houdonghui1/Trust_Shield/First_rot_sw/cm3_soc_sw/project/fpga_syn/fpga_ku6_mcu_full_vivado/mcu_top.runs/impl_1/.init_design.begin.rst

<?xml version="1.0"?>
<ProcessHandle Version="1" Minor="0">
    <Process Command=".planAhead." Owner="houdonghui" Host="" Pid="3104318">
    </Process>
</ProcessHandle>
