houdonghui1/Trust_Shield/Third_rot_sw/三级远程证明源代码解析.md

# 三级远程证明源代码解析

## 一、三级可信根

### `attestation_smoketest.c`

#### 主流程

- **1157**：熵源初始化
- **1159～1196**：生成 EK 公私钥
- **1198～1210**：生成 EK 证书

- **1212～1268**：对 EK TBS 证书进行 ECDSA-p256 签名
  - **1242～1253**：签名分为 r、s
  - **1255～1268**：生成完整 EK 证书

- **1271**：打印 EK 证书，等同于通过 UART0 将其发送至可信第三方
- **1273～1297**：生成 AK 公私钥
- **1299**：打印 AK 公钥，等同于通过 UART0 将其发送至可信第三方
- **1301～1307**：生成 MLDSA 公私钥
- **1309**：打印 MLDSA 公钥，等同于通过 UART0 将其发送至可信第三方
- **1311～1314**：接收可信第三方生成的 AK 证书
- **1326～1328**：等待进行远程证明测试

#### 辅助函数

**二进制转十六进制打印**
- **215～219**：初始化十六进制字符映射表，计算转换后字符串长度，分配并清空内存缓冲区
- **221～226**：遍历二进制数据，逐字节转换为十六进制字符串，并添加结束符
- **229～236**：将长字符串按固定长度分段，逐段打印

**UART0 初始化与 AK 证书接收**
- **460～464**：初始化 UART0
- **468～483**：接收 AK 证书，RX FIFO 大小为 32 bits

**AK 证书解密**
- **492**：等待来自终端的输入，随便输入一个字符
- **503～519**：打印 AK 证书密文
- **521**：使用 AES 解密
- **524～540**：打印 AK 证书明文

**UART1 初始化与远程证明**
- **1026**：初始化 UART1
- **1033～1048**：接收来自验证者的 Nonce
- **1057～1060**：使用 MLDSA 对 PCR + Nonce 进行签名
- **1062**：组 Quote 包
- **1067**：通过 UART1 发送 Quote 包

**MLDSA 签名**
- **766～769**：按 PCR + Nonce 的顺序进行 SHA256 计算
- **778～784**：使用 MLDSA 对 PCR + Nonce 的 SHA256 计算结果数据进行签名
- **795～801**：进行自验证

**Quote 包组包**
- **887～889**：添加 Quote 包头
- **892～900**：AK 证书长度转 HEX 字符串
- **903～910**：AK 证书转 HEX 字符串
- **913～917**：PCR 转 HEX 字符串
- **920～924**：Nonce 转 HEX 字符串
- **927～933**：MLDSA 签名转 HEX 字符串
- **936～937**：添加 Quote 包尾

---

## 二、可信第三方

### `start.sh`

- **3**：获取并解析来自三级可信根的 EK 证书、AK 公钥、MLDSA 公钥
- **5**：创建 CA 证书
- **7**：由 CA 证书签发 AK 证书，扩展字段部署 MLDSA 公钥
- **11**：发送 AK 证书到三级可信根

### `serial_capture_ak_ek.py`

- **87～102**：检查串口并初始化
- **105～111**：持续读取串口输出的日志
- **114～121**：获取 EK 证书
- **124～131**：获取 AK 公钥
- **134～155**：获取 MLDSA 公钥
- **169**：生成 PEM 文件

### `create_ca_root.sh`

- **70**：检查是否已存在 CA
- **71**：初始化目录
- **72**：生成 CA 密钥
- **73**：生成签名请求
- **74**：自签发 CA 证书
- **75**：校验 CA 证书

### `sign_ak_cert_by_ca.sh`

- **181**：检查所有必需文件是否存在、格式是否合法
- **182**：校验 CA 密钥/证书、AK 公钥的有效性
- **183**：清理临时文件，初始化证书序列号
- **184**：生成 MLDSA 公钥扩展配置文件
- **185**：生成证书签名请求文件
- **186**：校验 EK 公钥是否在白名单内
- **187**：用 CA 证书签发 AK 证书
- **188**：验证签发的 AK 证书有效性、MLDSA 公钥一致性
- **189**：清理所有临时文件

### `serial_send_ak_cert.py`

- **180**：检查 AK 证书文件是否存在
- **181**：PEM 证书转 HEX 格式并保存
- **182**：读取 HEX 文件，使用 AES 加密后通过串口发送到三级可信根

---

## 三、验证者

### `verifier.py`

#### 主流程

- **422**：检查 CA 证书是否存在
- **425**：生成 32 字节随机数 Nonce
- **427**：串口发送 Nonce，接收三级可信根返回的 Quote 包
- **429**：解析 Quote 数据，执行验证

#### 串口通信

- **283～301**：初始化串口通信
- **303～310**：清空串口残留数据
- **312～320**：向三级可信根发送 Nonce，等待三级可信根返回 Quote 包

#### 数据接收与提取

- **328～351**：循环读取串口数据，直到检测到 `#END#` 结束标记，完整接收三级可信根返回的所有数据
- **356～358**：将二进制数据转为字符串，清除无关字符，保留纯有效数据
- **360～366**：提取 Quote 包的十六进制数据，并返回给上层函数

#### Quote 包解析与验证

- **372～378**：解析 AK 证书的长度
- **380～385**：计算完整数据所需总长度，校验数据是否完整
- **387～398**：按偏移量依次解析出 AK 证书、PCR、Nonce、MLDSA 签名
- **407**：验证 AK 证书，是否由合法 CA 证书签发
- **408**：从 AK 证书扩展字段中，提取 MLDSA 公钥
- **410～411**：验证 PCR，三级可信根状态是否被篡改
- **413**：验证 Nonce，三级可信根返回的 Nonce 与验证者发送的是否一致
- **415**：用 ML-DSA 公钥验签，证明 Quote 包数据未被篡改
