houdonghui1/Trust_Shield/First_rot_sw/cm3_soc_sw/project/fpga_syn/fpga_ku6_mcu_full_vivado/mcu_top.runs/impl_1/.vivado.begin.rst

<?xml version="1.0"?>
<ProcessHandle Version="1" Minor="0">
    <Process Command="vivado" Owner="houdonghui" Host="secure-Precision-3660" Pid="3104272" HostCore="32" HostMemory="65520816">
    </Process>
</ProcessHandle>
