houdonghui1/Trust_Shield/Third_rot/optt_doc/opentitan软件编写测试.pdf

# opentitan device软件编写测试

### 掌握运行自写测试的流程

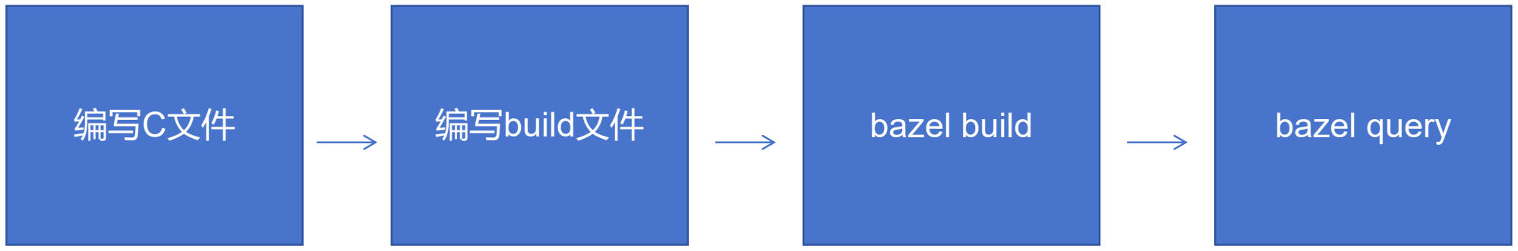
[picture p7: figure]
编写C文件; 编写build文件; bazel build; bazel query
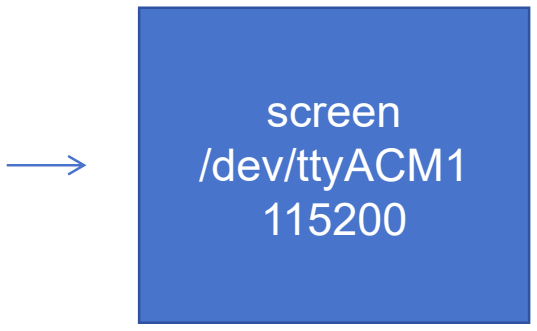
[picture p8: figure]
screen /dev/ttyACM1 115200
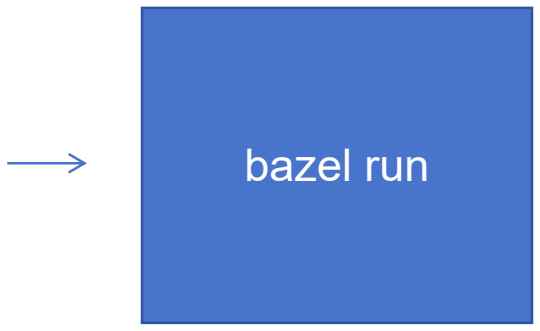
[picture p9: figure]
bazel run

测试.c的基本内容

#include "sw/device/my_tests/sm4/sm4_reg.h" #include "sw/device/lib/runtime/log.h" #include "sw/device/lib/testing/test_framework/ottf_main.h" #include "hw/top_earlgrey/sw/autogen/top_earlgrey.h" OTTF_DEFINE_TEST_CONFIG();

bool test_main(void) {
LOG_INFO(kSendData);

return true;
}

包含的.h
依赖的其他库

默认结构

BUILD文件的编写

load("//rules:opentitan.bzl", "OPENTITAN_CPU") load( "//rules:opentitan_test.bzl", "OPENTITANTOOL_OPENOCD_DATA_DEPS", "OPENTITANTOOL_OPENOCD_TEST_CMDS", "ROM_BOOT_FAILURE_MSG", "cw310_params",// "dv_params", "opentitan_functest", "verilator_params", )

load("//rules/opentitan:defs.bzl", "EARLGREY_TEST_ENVS", "opentitan_test") load("//rules:splice.bzl", "bitstream_splice")
load("//rules:otp.bzl", "STD_OTP_OVERLAYS", "otp_image", "otp_json", "otp_partition") package(default_visibility = ["//visibility:public"])
exports_files(glob([ "*.c", "*.h",

]))

在测试.c的同层写一个名为BUILD的文
件

这是通用部分

opentitan_functest(
name = "puf_smoketest", srcs = ["puf_smoketest.c"], targets =["cw310_test_rom", "verilator"], deps = [":puf_lib",

], )
cc_library(
name = "puf_lib", srcs = ["puf.c"], hdrs = ["puf.h"],

target_compatible_with = [OPENTITAN_CPU], deps = [ "//hw/top_earlgrey/sw/autogen:top_earlgrey", "//sw/device/lib/runtime:log", "//sw/device/lib/testing/test_framework:ottf_main", "//sw/device/my_tests/base:base_lib", "//sw/device/my_tests/rs_encode:rs_encode_lib", "//sw/device/my_tests/rs_decode:rs_decode_lib",

], 测试名为pu | )
f_smoketest,同名.c文件
依赖一个自己的库，下面定义自己的库，自己的库函数写
在puf.c中，.h中定义常量、宏、声明函数。需要用其他的 库函数，要先包含.h进来。xxx_smoketest.c和xxx.c中 include xxx.h bazel query 'attr(tags, cw310, tests(//sw/device/tests/...))'

查看有哪些测试可以用，目的是为了找到bin文件

bazel build //sw/device/examples/hello_world:my_hello_world

### 构建测试，编译

用verilator测试并看波形
bazel test //sw/device/my_tests/sm4:sm4_smoketest_sim_verilator \ --test_output=streamed \ --test_timeout=2000 \ --test_arg=--verilator-args=--trace=/tmp/sim.fst

gtkwave /tmp/sim.fst

在选好信号之后在file 中write save file as ，可以将波形另存为一个gtkw文件。重新仿真生成.fst后， 打开fst文件，在file中打开保存的gtkw文件，就会自动将选好的信号拉出来。

只仿真不记录波形速度会快很多

终端上打印log

若无法build，提示gcc的问题，则升级
gcc到11

将终端log打印到文本：script log.txt 将会在当前路径下生成一个txt文件记录产生的log。exit终止 可在bazel query 'filter(".*_fpga_cw310", kind(".", //sw/device/tests/...))' 的log中查找哪些可用测试文件

bazel query 'filter(".*_fpga_cw310", kind(".", //sw/device/my_tests/...))'

查看有哪些测试文件

screen /dev/ttyACM1 230400,cs8,-ixon,-ixoff 开串口
注意：波特率取决于soc根时钟

bazel run //sw/host/opentitantool bootstrap $(ci/scripts/target-location.sh //sw/device/examples/hello_world:my_hello_world_fpga_cw310_bin)

ctrl+A+D 分离screen
screen -ls 查看有哪些后台screen
screen -r 后台ID 恢复后台的screen
screen -XS ID quit 关闭后台运行的screen（多个可选） screen -X quit 关闭单个

上板测试

加载测试软件到SOC的flash

# 一些编程的tips

1、opentitan里边用abs_mmio_write32写入数据 src/sw/device/lib/base/abs_mmio.h

关于编译后总线未能按次序去读写寄存器（如何防止自动优化掉一些步骤）

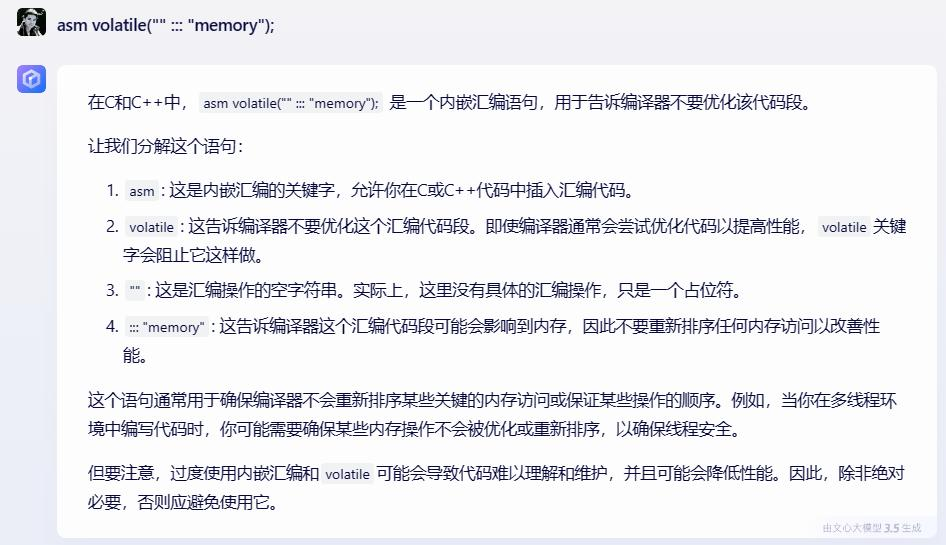
[picture p10: figure]

https://blog.csdn.net/qq_36412526/article/details/84640924

https://blog.csdn.net/sxudong2010/article/details/118616418

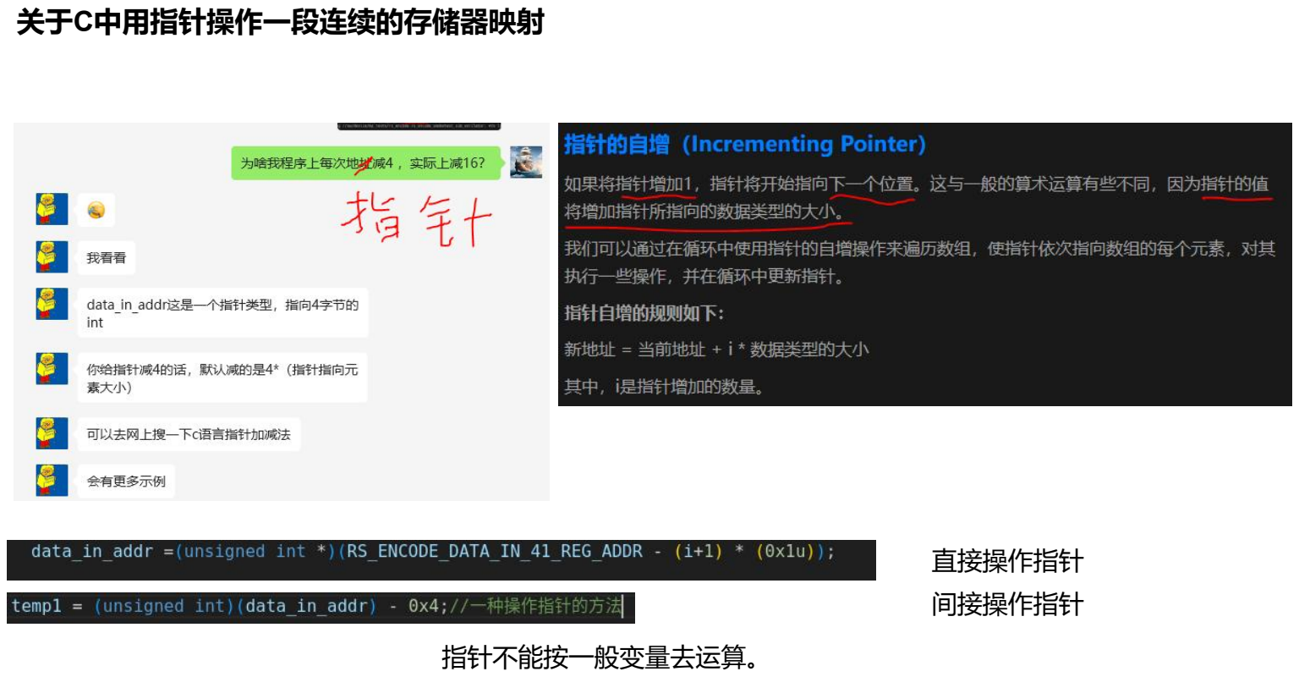
[picture p11: page 9]

指针不能按一般变量去运算。

关于C中用指针操作一段连续的存储器映射

直接操作指针
间接操作指针

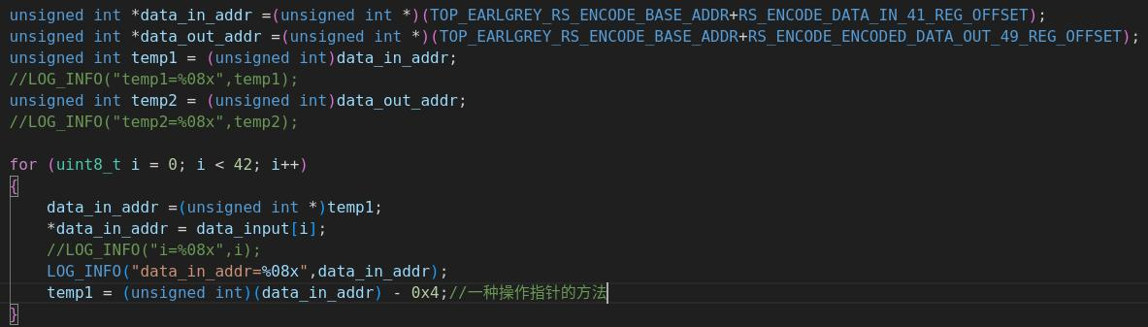
[picture p12: figure]

一种操作指针写入存储器（广义）的方法

# opentitan 安全启动

目标：
1、在opentitan device (sim or FPGA)上运行安全启动流程：ROM——ROM_EXT——BL0 2、总结opentitan脱机运行模式(上电直接安全启动、直到用户代码)的开发流程

安全启动相关资料

https://opentitan.org/book/sw/device/silicon_creator/index.html | rom和rom_ext软件介绍

https://opentitan.org/book/doc/security/specs/secure_boot/index.html 安全启动具体内容

sw/device/silicon_creator/rom_ext/data/rom_ext_e2e_testplan.hjson | ROM_EXT testplan
sw/device/silicon_creator/rom/data/rom_e2e_testplan.hjson | ROM testplan
https://lowrisc.zulipchat.com/#narrow/stream/213499-OpenTitan/topic/secure.20boot | 问题讨论
https://opentitan.org/book/rules/opentitan/index.html#execution-environments | 测试的执行环境

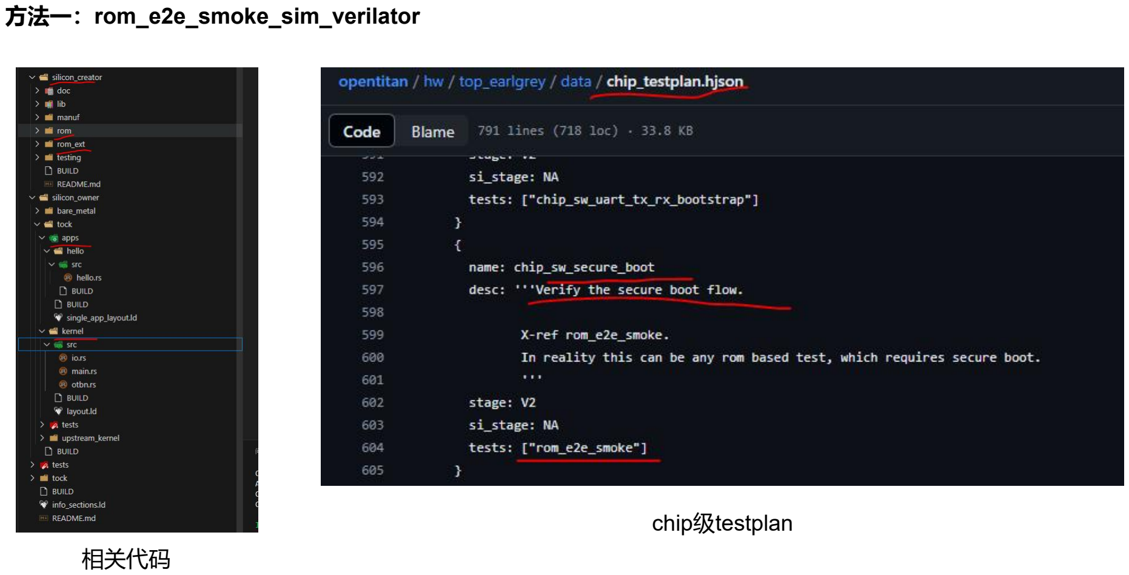
[picture p13: page 13]

相关代码

方法一：rom_e2e_smoke_sim_verilator

chip级testplan

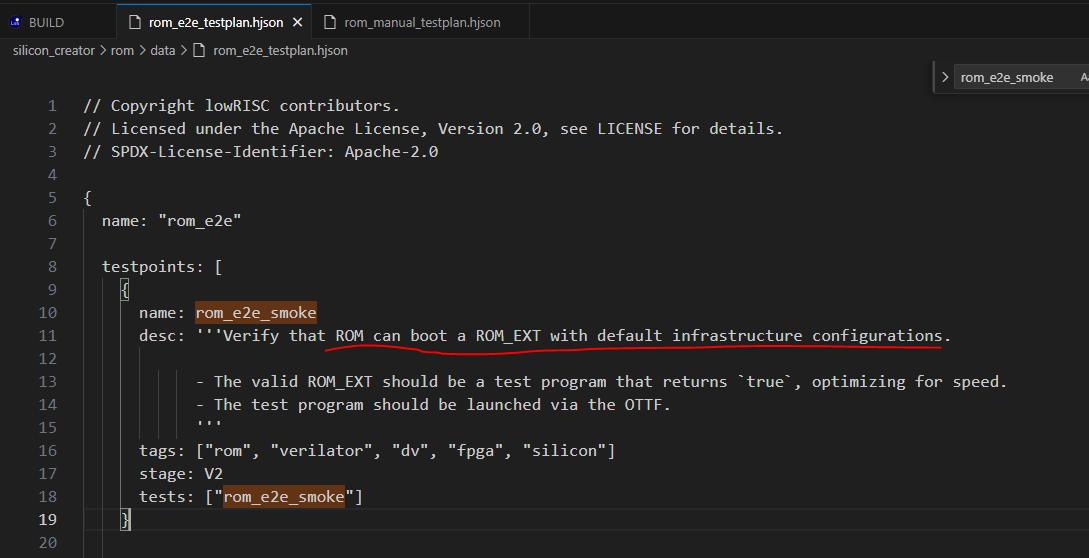
[picture p14: figure]

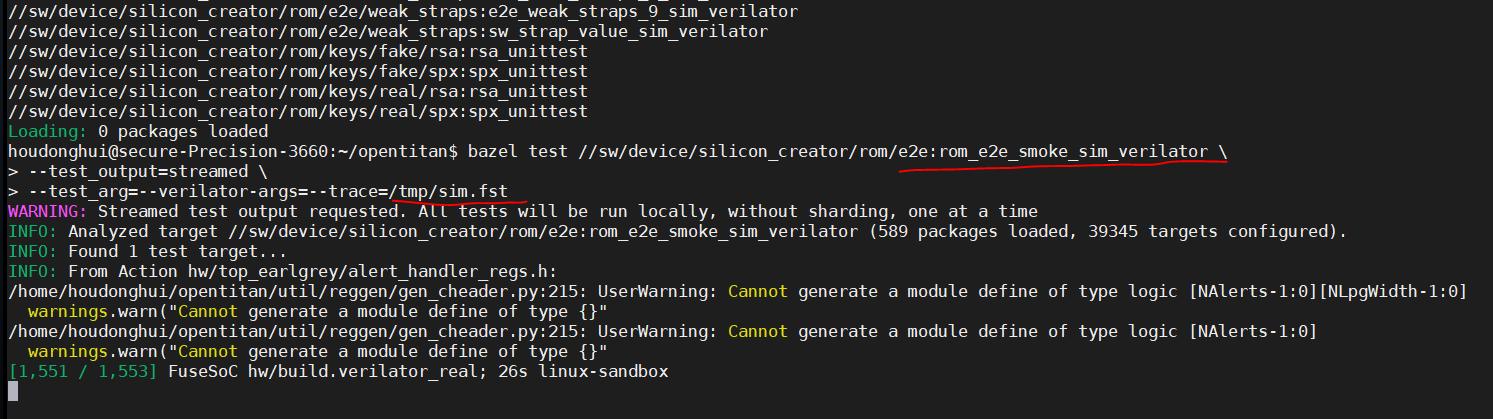
[picture p15: figure]

在verilator上执行ROM测试，时间很久.......

方法二：在ROM_EXT阶段执行某个测试【带安全启动】

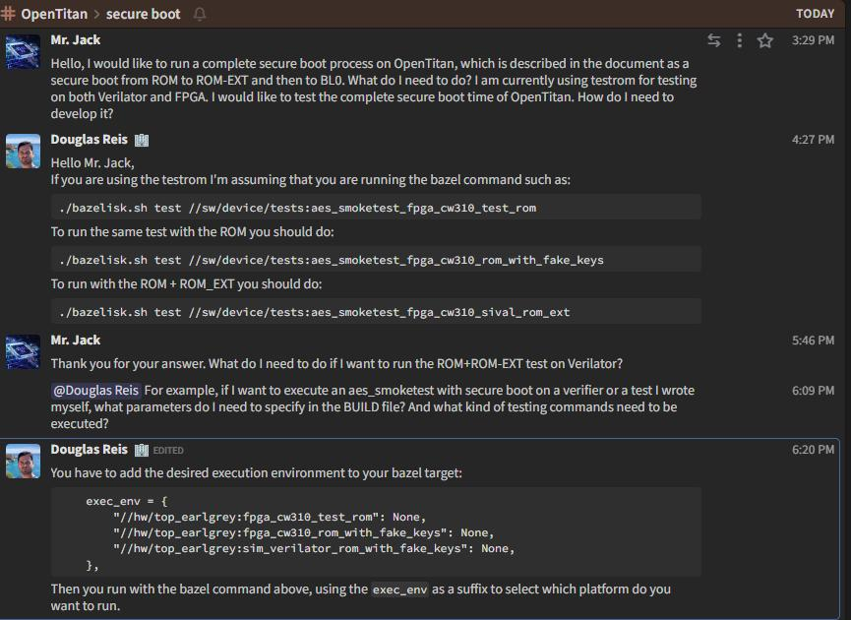
[picture p16: figure]

关于软件执行环境的概念

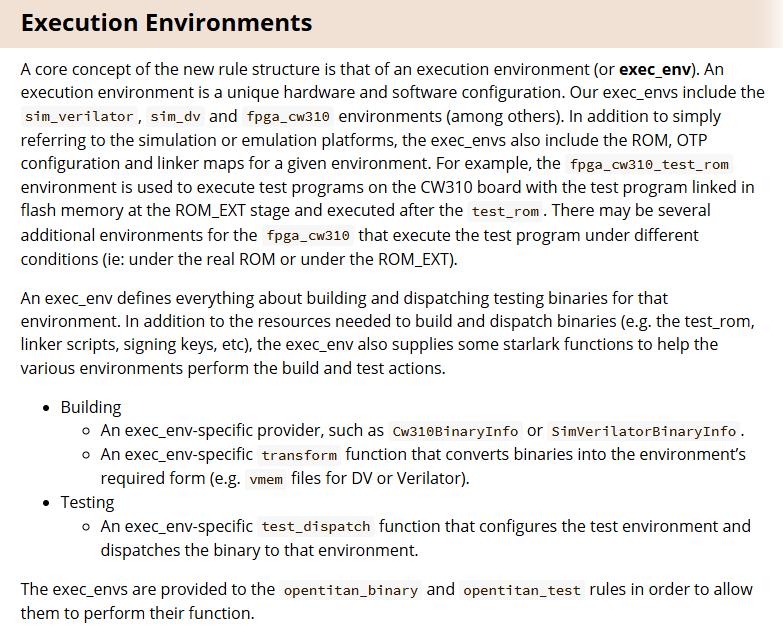
[picture p17: figure]

https://opentitan.org/book/rules/opentitan/index.htm l#execution-environments

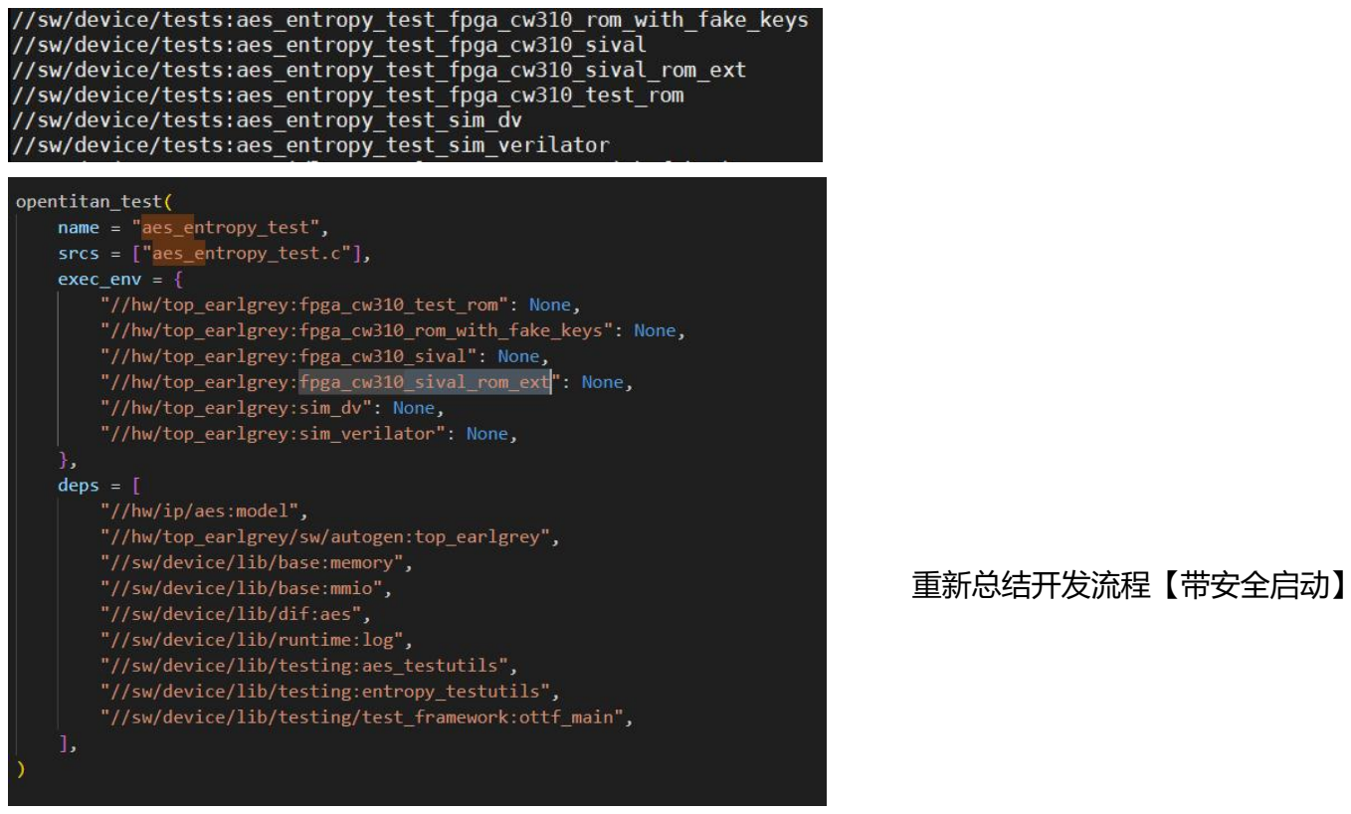
[picture p18: page 18]

重新总结开发流程【带安全启动】
