houdonghui1/Trust_Shield/First_rot/design_doc/环境配置.md

# **环境配置** #
_*Last Update: 2025/09/13*_

## **安装工具** ##

OS:
 - Build instructions assume a Linux environment

Lint:
 - Synopsys Spyglass
   - `Version S-2021.09-1`

Simulation:
 - Synopsys VCS with Verdi
   - `Version R-2020.12-SP2-7_Full64`
 - Verilator
   - `Version 5.012`
 - Mentor Graphics QVIP
   - `Version 2021.2.1` of AHB models
 - Avery AXI VIP
   - `Version 2025.1` of axixactor
 - UVM installation
   - `Version 1.1d`
 - Mentor Graphics UVM-Frameworks
   - `2022.3`

GCC:
 - RISCV Toolchain for generating memory initialization files
   - `Version 2023.04.29`
   - `riscv64-unknown-elf-gcc (g) 12.2.0`
 - G++ Used to compile Verilator objects and test firmware
   - `g++ (GCC) 11.2.0`
 - ARM Toolchain for soc memory initialization files and firmwave
   - `gcc-arm-none-eabi v10.3-2021.10`

Vivado：
 - use vivado 2021.1 to start FPGA flow 

Debug:
 - SW J_Link commander v7.92f 
 - HW J_Link debuger v12 support RISC_V and ARM
 
### **RISCV Toolchain installation** ###
There is significant configurability when installing the RISCV toolchain.
These instructions may be used to create a RISCV installation that will be compatible
with the provided Makefile for compiling test C programs.

1. Install from this repository:
    - https://github.com/riscv-collab/riscv-gnu-toolchain
    - Follow the included README in that repository for installation instructions
2. The most recently tested toolchain build that was confirmed to work was 2023-04-29
    - https://github.com/riscv-collab/riscv-gnu-toolchain/releases/tag/2023.04.29
3. A compatible tool installation requires newlib cross-compiler, multilib support, and the zicsr/zifencei extensions. Use this configure command:
    - `./configure --enable-multilib --prefix=/path/to/tools/riscv-gnu/2023.04.29 --with-multilib-generator="rv32imc-ilp32--a*zicsr*zifencei"`
4. Use `make` instead of `make linux` to install the tool (using newlib option)

### **Vivado installation** ###
Visit the AMD official website (formerly Xilinx) and download the Linux version of Vivado WebInstaller
- https://www.amd.com/en/products/software/adaptive-socs-and-fpgas/vivado.html

## **环境变量** ##
在工具配置完成后需要验证工具安装是否成功,然后进入工程目录，要运行脚本配置环境变量。

`source setenv.sh`

- `PRJ_DIR` 工程目录的绝对路径，需要替换为实际路径。
 
## **Repository Overview** ##
```
Trust_arm_soc_rot/
├── design_doc              设计文档
│   └── image               文档图片
├── doc                     设计相关记录
│   ├── arch                
│   ├── fpga
│   ├── reglist
│   ├── standard
│   └── testcase
├── library                 相关RTL库
│   ├── altera_ip           altera ip库
│   ├── altera_sim          altera 仿真库
│   ├── cm3                 cortex-m3 RTL
│   ├── cmsdk               arm-cmsdk代码
│   ├── cmsis               arm基础软件
│   ├── drivers             soc外设驱动BSP
│   ├── flm                 
│   ├── gen_apb             apb设计资料
│   ├── models              验证库
│   ├── rtl_logic           简单RTL模块
│   ├── xilinx_ip           xilinx FPGA ip
│   └── xilinx_sim          xilinx 仿真库
├── project
│   ├── firmware_sdk        软件编译结果
│   └── fpga_syn            FPGA构建文件夹
├── script                  自动化脚本库
│   └── verdiLog            
├── sim
│   ├── spyglass_prj        spyglass工程
│   └── verilog_sim         RTL仿真验证工程
└── user
    ├── firmware            user软件源码
    ├── fpga_verilog        FPGA移植RTL
    └── verilog             主RTL库，包含安全协处理器RTL
```

### **Verilog File Lists** ###
Verilog file lists are generated via VCS and included in the config directory for each unit. New files added to the design must be included in the vf list. They can be included manually or by using VCS to regenerate the vf file. File lists define the compilation sources (including all dependencies) required to build and simulate a given module or testbench, and should be used by integrators for simulation, lint, and synthesis.
