houdonghui1/Trust_Shield/First_rot/design_doc/自动化脚本说明.md

# 自动化脚本说明

**脚本位置：**
[脚本文件夹](../script/)中保存了许多makefile脚本，组织起VCS仿真、FPGA构建等过程，加速了开发验证等流程。详情请查看[TOP_MAKEFILE](../script/makefile)
