houdonghui1/Trust_Shield/system/NVIDIA最新集群.md

NVIDIA Vera Rubin平台的硬件架构，其核心是**“极限协同设计”（Extreme Co-design）**理念。它将整个数据中心视为一个完整的计算单元，通过七颗各司其职的专用芯片紧密协作，实现了从单颗芯片到机架，再到超级集群（POD）的无缝扩展。

其硬件架构可以从以下四个层面来理解：

### 🧠 核心计算层：三颗芯片，各司其职

这一层是算力的源泉，由三颗专为AI工作流不同阶段优化的芯片构成。

*   **Rubin GPU（图形处理器）**：这是平台的**算力核心**，专为大规模并行计算设计。基于**台积电3nm**工艺，采用**双芯（Dual-die）设计**，集成了惊人的**3360亿**个晶体管。
    *   **性能**：在NVFP4精度下，单颗GPU可提供**50 PetaFLOPS**的推理算力和**35 PetaFLOPS**的训练算力，分别是上一代Blackwell的**5倍**和**3.5倍**。
    *   **内存**：配备**288GB**的**HBM4**高带宽内存，带宽高达**22 TB/s**。
    *   **关键特性**：搭载了第三代Transformer引擎，支持硬件加速的自适应压缩，能在保持精度的同时最大化NVFP4性能。

*   **Vera CPU（中央处理器）**：这是平台的**“指挥官”**，负责数据移动、系统控制和代理式AI的复杂任务调度。它拥有**88个**自研的**Olympus**核心，兼容**Armv9.2**架构。
    *   **性能**：内存带宽高达**1.2 TB/s**（LPDDR5X）。
    *   **关键特性**：通过**NVLink-C2C**（芯片到芯片）接口与Rubin GPU实现高速、一致的**统一内存访问**。

*   **Groq 3 LPX（低延迟推理加速器）**：这是一个专用的**“推理加速器”**。单个机架配备**256个LPU**和**128GB**的**SRAM**，能提供**40 PB/s**的内存带宽。它专门负责推理任务中**低延迟的解码阶段**，与擅长高吞吐量训练的GPU形成完美互补。

### 🔗 互连与网络层：四颗芯片，编织高速网络

计算单元需要高速网络连接，这由剩余四颗芯片完成：

*   **NVLink 6 交换机**：这是机架内的**“数据高速公路”**。第六代NVLink为每颗GPU提供**3.6 TB/s**的双向带宽，能将NVL72机架内的**72颗Rubin GPU**整合成一个统一的性能域，总带宽高达**260 TB/s**。
*   **ConnectX-9 SuperNIC**：这是节点间**“横向扩展”**的桥梁，提供**800 Gb/s**的超高速RDMA网络连接。
*   **Spectrum-6 以太网交换机**：这是构建大规模POD的**“骨干网络”**，基于**硅光（CPO）** 技术，交换容量高达**102.4 Tb/s**。
*   **BlueField-4 DPU（数据处理器）**：这是**“基础设施卸载引擎”**。它内置**64核**Grace CPU，能卸载并加速存储、网络和安全等基础设施任务，是AI原生存储架构的关键。

### 🏭 系统级集成：从芯片到超级计算机

*   **超级芯片（Superchip）**：最基本的单元，由一颗**Vera CPU**通过**NVLink-C2C**与两颗**Rubin GPU**紧密集成，形成计算核心。
*   **NVL72机架**：平台的**核心交付单元**。一个机架集成了**72颗Rubin GPU**、**36颗Vera CPU**、以及相应的NVLink交换机等，总计约**220万亿**个晶体管。采用**100%液冷**和**无缆化（Cableless）模块化托盘设计**，组装和维护速度是上一代的**18倍**。
*   **DGX SuperPOD**：由**40个**NVL72机架构成，总算力高达**60 ExaFLOPS**。整个POD在软件层面被视为一个统一的、可编程的超级计算机。

### 🛡️ 安全与可靠性架构

*   **第三代机密计算**：安全边界扩展至**整个NVL72机架**，在全部CPU、GPU和NVLink结构上创建了一个统一的**可信执行环境（TEE）**。
*   **第二代RAS引擎**：Rubin GPU配备了专用的RAS引擎，支持**主动维护**和**实时健康检查**而无需停机。

### 💎 总结

总而言之，Vera Rubin的硬件架构是一次从“芯片”到“系统”的思维飞跃。它不再依赖单一芯片的性能提升，而是通过**七颗专用芯片的深度协同**、**极限的互联带宽**和**系统级的优化设计**，将整个机架甚至POD打造成一台专为代理式AI时代设计的超级计算机。
