houdonghui1/Trust_Shield/Third_rot/optt_doc/opentitan硬件HW开发.pdf

# opentitan硬件HW开发【步骤】

https://opentitan.org/book/doc/getting_started/index.html#step-8-additional-resources 关键文档导引

https://opentitan.org/book/doc/contributing/github_notes.html#github-notes
github 相关

https://opentitan.org/book/doc/contributing/bazel_notes.html
bazel命令相关

一、创建文件夹 mkdir hw/ip/sm4 再建data和rtl data下建sm4.hjson(参考SM4)

写IP的hjson文件，在里面定义寄存器和其他各种信号

二、util/regtool.py -r \-t hw/ip/sm4/rtl/ hw/ip/sm4/data/sm4.hjson 生成寄存器文件到IP的RTL文件夹 util/regtool.py -D -o hw/ip/sm4.h hw/ip/sm4/data/sm4.hjson 生成寄存器c头文件

三、更改顶层/top_earlgrey/data/top_earlgrey.hjson 文件，将IP连到顶层模块（参考SM4）

四、添加IP到hw/Makefile文件

五、添加到总线，改hw/top_earlgrey/data/xbar_main.hjson（参考SM4） 注意两处要改

## 添加新IP到SOC

八、make -C $REPO_TOP/hw top make update顶层 make -C $REPO_TOP/hw all

六、编写 hw/ip/sm4/sm4.core （参考SM4） （给fusesoc构建SOC用）
sv中包含的文件后面要跟 {is_include_file: true}
七、将IP添加到hw/top_earlgrey/top_earlgrey.core

（十）、fusesoc --cores-root . run --flag=fileset_top --target=synth --setup lowrisc:systems:chip_earlgrey_${BOARD}

构建FPGA工程（复制源代码文件到暂存区）

source lowrisc_systems_chip_earlgrey_cw310_0.1.tcl 从TCL 打开工程。

九、构建verilator测试
bazel test //sw/device/my_tests/sm4:sm4_smoketest_sim_verilator

### 在定义寄存器和HW连接时的一些注意事项：

1、关于硬件写寄存器

在hw2reg中d和de是对hw端的。在reg2hw中，硬件写的寄存器的q是对总线（软件端）的。

hw若想更新寄存器的数据，就要把数据放到d上，同时de拉高，下个时钟相应的q就会更新。

如果hw的有效输出数据无法长期保持，de就要采用脉冲的方式（用有效标志驱动de），这样就只 会在数据有效时更新reg，软件读到的是有效数据。

2、关于IP寄存器基地址

IP间基地址要相隔2000 https://opentitan.org/book/util/reggen/index.html#register-definitions-per-type

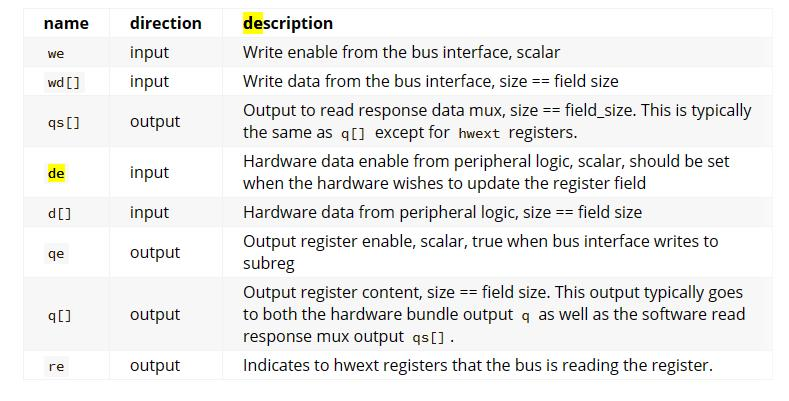
[picture p142: figure]

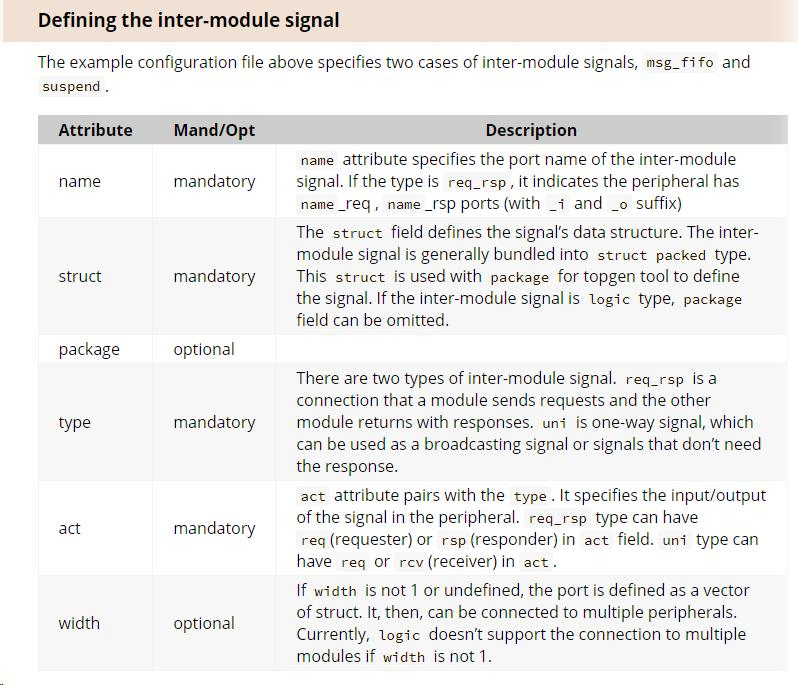
[picture p143: figure]

### 关于IP间信号的创建

1、IP hjson
2、top hjson

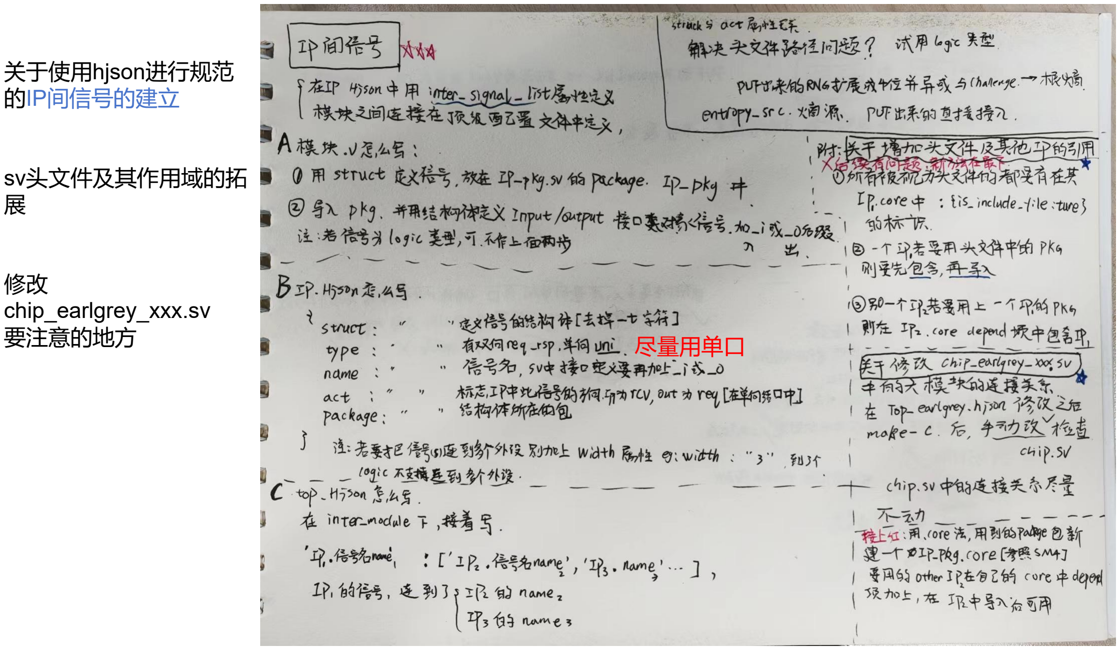
[picture p144: page 7]

关于使用hjson进行规范 的IP间信号的建立 sv头文件及其作用域的拓 展修改chip_earlgrey_xxx.sv 要注意的地方 | 尽量用单口

## 关于chip_earlgrey层sv文件的编辑

完成top_earlgrey层的编辑后，手动修改芯片层。

https://opentitan.org/book/hw/top_earlgrey/doc/design/index.html?highlight=top_ea#rtl-implementation-notes
