houdonghui1/Trust_Shield/First_rot_risc_v/risc_v_image/6.png

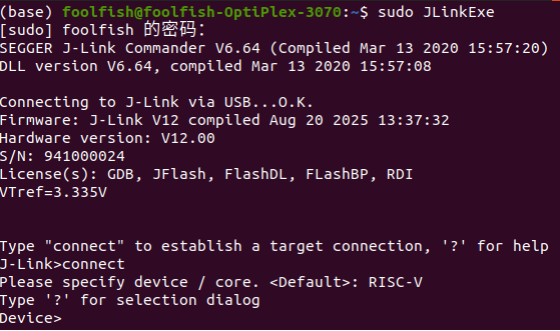
First_rot_risc_v/risc_v_image/6.png
