houdonghui1/Trust_Shield/system/system_image/muti_uart.png

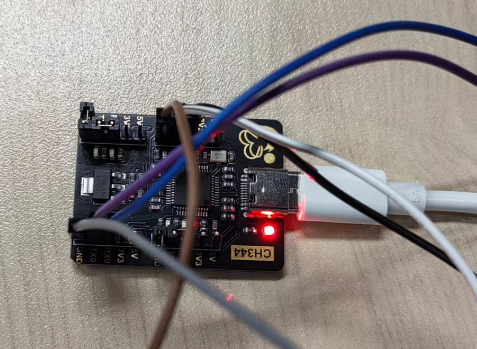
system/system_image/muti_uart.png
