houdonghui1/Trust_Shield/system/system_image/pins.png

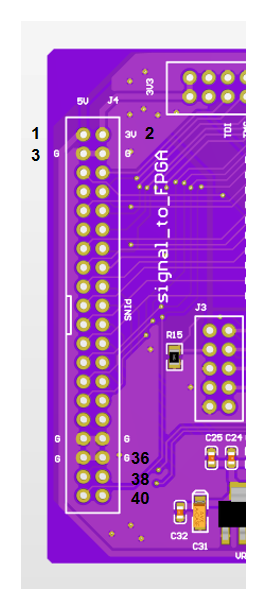
system/system_image/pins.png
