houdonghui1/Trust_Shield/system/system_image/system.png

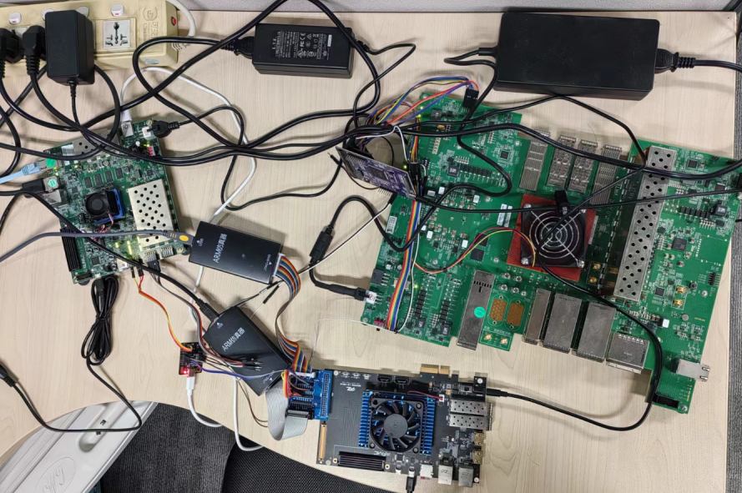
system/system_image/system.png
