houdonghui1/Trust_Shield/Third_rot/optt_doc/notice/strategy_1.png

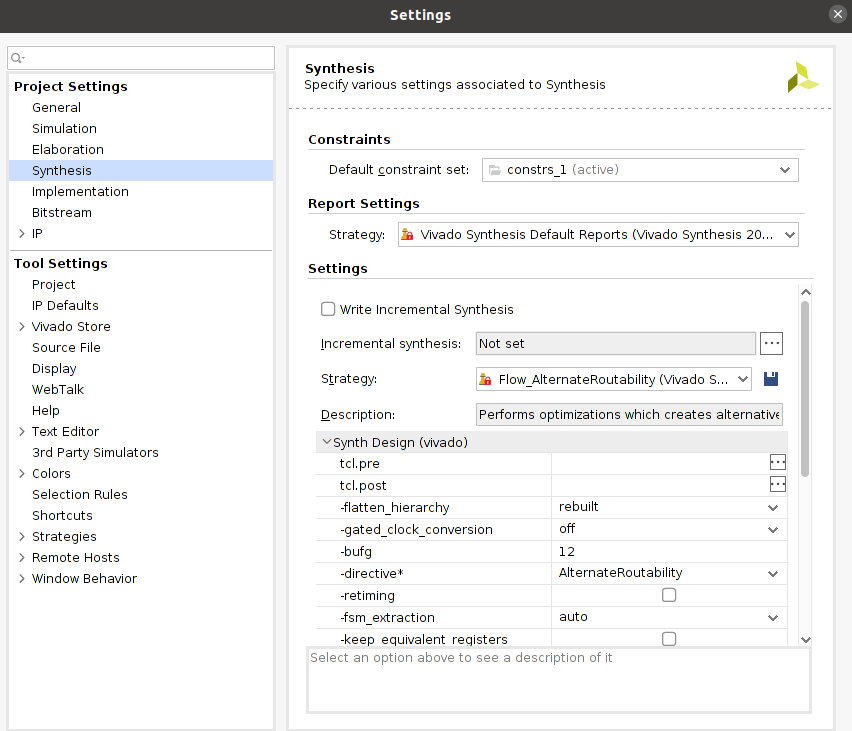
Third_rot/optt_doc/notice/strategy_1.png
