houdonghui1/Trust_Shield/Third_rot/optt_doc/notice/strategy_2.png

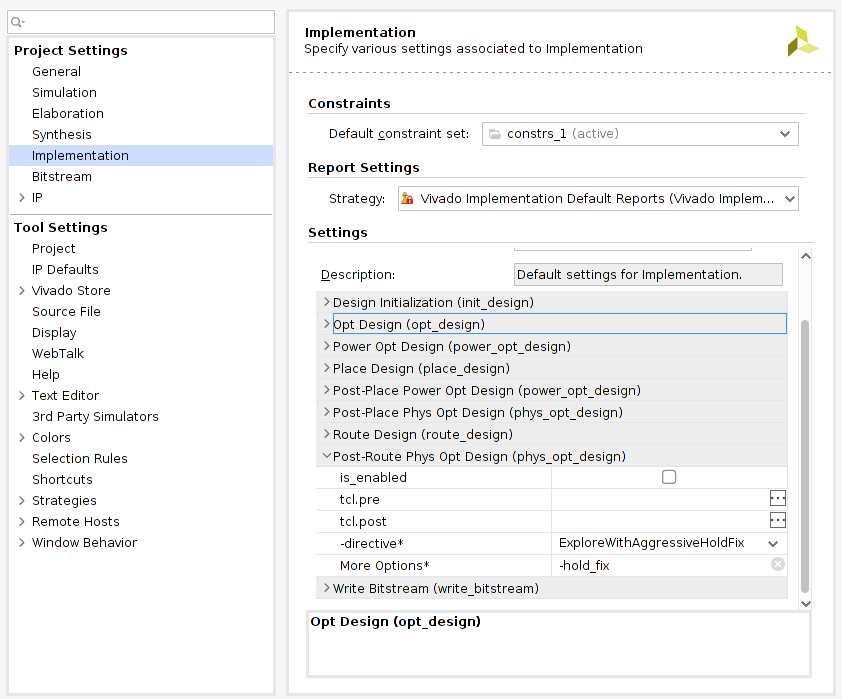
Third_rot/optt_doc/notice/strategy_2.png
