houdonghui1/Trust_Shield/Third_rot/optt_doc/notice/strategy_3.png

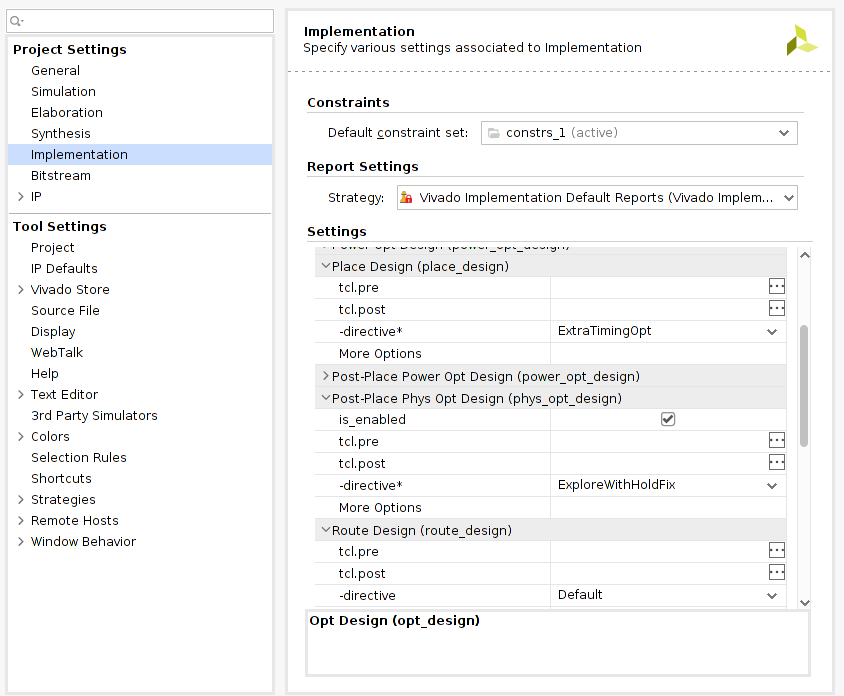
Third_rot/optt_doc/notice/strategy_3.png
