houdonghui1/Trust_Shield/First_rot/doc/testcase/eth_mac_testcase.xls

Sheet: rtl_spec
ChapterNo. | CaseNo. | Chapter | Case | Descriptions | TestCase | TP_0 | TP_1
1 | 1 | Dma | AHB burst read | read tx data from sram through dma with ahb master burst transfer |  | √
 | 2 |  | AHB single read | read tx data from sram through dma with ahb master single transfer |  | √
 | 3 |  | AHB burst write | write rx data to sram through dma with ahb master burst transfer |  | √
 | 4 |  | AHB single write | write rx data to sram through dma with ahb master single transfer |  | √
 | 5 |  | AHB arbiter | weight mode arbiter between tx and rx
 | 6 |  | AHB arbiter | fixed mode arbiter between tx and rx
2 | 1 | Datalink | TX Descriptor Content | tx descriptor content handle |  | √
 | 2 |  | TX Descriptor Number | tx descriptor number handle
 | 3 |  | TX Data Buffer | tx data buffer pingpong operation handle |  | √
3 | 1 | Protocol | TX Frame | transmit different data |  | √
 | 2 |  | TX Interval | transmit different interval bit
 | 3 |  | TX Preamble | transmit different preamble bit
 | 4 |  | TX Macaddress | tx frame with hardware mac address
 | 5 |  | TX Padding | tx frame with hardware padding
 | 6 |  | TX CRC | tx frame with hardware crc
 | 7 |  | TX Checksum in IP | tx ip frame with hardware checksum
 | 8 |  | TX Checksum in TCP | tx tcp frame with hardware checksum
 | 9 |  | TX Checksum in UDP | tx udp frame with hardware checksum
 | 10 |  | TX Checksum in ICMP | tx icmp frame with hardware checksum
4 | 1 | TX Int | Int0 | int for tx frame done |  | √
 | 2 |  | Interrupt Line | int to cpu |  | √
5 | 1 | DMA Int | Int2 | int for dma ahb master bus error
 | 2 |  | Int1 | int for dma ahb master timeout for hready low
 | 3 |  | Int0 | int for dma process done |  | √
 | 4 |  | Interrupt Line | int to cpu |  | √
3 | 1 | Function | TX FIFO Clear | tx fifo can be cleared by clear bit |  | √
 | 2 |  | RX FIFO Clear | rx fifo can be cleared by clear bit |  |  | √
 | 3 |  | TX Logic Clear | tx fsm can be cleared by clear bit |  | √
 | 4 |  | RX Logic Clear | rx fsm can be cleared by clear bit |  |  | √
 |  |  |  |  |  | √ | √
 |  |  |  |  |  | √ | √
 |  |  |  |  |  | √ | √
 |  |  |  |  |  | √ | √
 |  |  |  |  |  | √ | √
 |  |  |  |  |  | √ | √
 |  |  |  |  |  | √ | √
 |  |  |  |  |  | √ | √
 |  |  |  |  |  | √ | √

Sheet: rtl_testcase
TestCase | Description
TP_0 | This case will tx 8, 16, 32, 64, 100, 200 words data frame with rx idle. All of 4 tx decriptor are using. The pe core is not involved in content.
TP_1 | This case will tx and rx frames alternatively with interval bits. The configs are set by swd after master frame done int status asserted and then clear all fifos and logics between each config.
