houdonghui1/Trust_Shield/Third_rot/opentitan/hw/ip/rstmgr/doc/programmers_guide.md

# Programmer's Guide

## Device Interface Functions (DIFs)

- [Device Interface Functions](../../../../sw/device/lib/dif/dif_rstmgr.h)
