houdonghui1/Trust_Shield/Third_rot/opentitan/hw/ip/rv_core_ibex/doc/programmers_guide.md

# Programmer's Guide

## Device Interface Functions (DIFs)

- [Device Interface Functions](../../../../sw/device/lib/dif/dif_rv_core_ibex.h)
