houdonghui1/Trust_Shield/First_rot/project/firmware_sdk/keil_fw_test/Objects/baremental.htm

# Static Call Graph for image .\Objects\baremental.axf

#<CALLGRAPH># ARM Linker, 5060750: Last Updated: Fri Nov 06 20:49:05 2020

### Maximum Stack Usage = 324 bytes + Unknown(Cycles, Untraceable Function Pointers)

### Call chain for Maximum Stack Depth:

_printf_f ⇒ _printf_fp_dec ⇒ _printf_fp_dec_real ⇒ _fp_digits ⇒ _btod_etento ⇒ _btod_emul ⇒ _e2e

### Mutually Recursive functions

- Bastim_Ch0_Handler ⇒ Bastim_Ch0_Handler

### Function Pointers

- Bastim_Ch0_Handler from startup_cm3ds.o(.text) referenced from startup_cm3ds.o(RESET)
- Bastim_Ch1_Handler from startup_cm3ds.o(.text) referenced from startup_cm3ds.o(RESET)
- Bastim_Ch2_Handler from startup_cm3ds.o(.text) referenced from startup_cm3ds.o(RESET)
- Bastim_Ch3_Handler from startup_cm3ds.o(.text) referenced from startup_cm3ds.o(RESET)
- BusFault_Handler from interrupt.o(i.BusFault_Handler) referenced from startup_cm3ds.o(RESET)
- DebugMon_Handler from interrupt.o(i.DebugMon_Handler) referenced from startup_cm3ds.o(RESET)
- EthSma_Handler from startup_cm3ds.o(.text) referenced from startup_cm3ds.o(RESET)
- Gpioa_Handler from startup_cm3ds.o(.text) referenced from startup_cm3ds.o(RESET)
- HardFault_Handler from interrupt.o(i.HardFault_Handler) referenced from startup_cm3ds.o(RESET)
- MemManage_Handler from interrupt.o(i.MemManage_Handler) referenced from startup_cm3ds.o(RESET)
- NMI_Handler from interrupt.o(i.NMI_Handler) referenced from startup_cm3ds.o(RESET)
- PendSV_Handler from interrupt.o(i.PendSV_Handler) referenced from startup_cm3ds.o(RESET)
- Reset_Handler from startup_cm3ds.o(.text) referenced from startup_cm3ds.o(RESET)
- Resv2_Handler from startup_cm3ds.o(.text) referenced from startup_cm3ds.o(RESET)
- Resv3_Handler from startup_cm3ds.o(.text) referenced from startup_cm3ds.o(RESET)
- Resv4_Handler from startup_cm3ds.o(.text) referenced from startup_cm3ds.o(RESET)
- Resv6_Handler from startup_cm3ds.o(.text) referenced from startup_cm3ds.o(RESET)
- Resv7_Handler from startup_cm3ds.o(.text) referenced from startup_cm3ds.o(RESET)
- SVC_Handler from interrupt.o(i.SVC_Handler) referenced from startup_cm3ds.o(RESET)
- SysTick_Handler from interrupt.o(i.SysTick_Handler) referenced from startup_cm3ds.o(RESET)
- Uart0_Handler from interrupt.o(i.Uart0_Handler) referenced from startup_cm3ds.o(RESET)
- Uart1_Handler from startup_cm3ds.o(.text) referenced from startup_cm3ds.o(RESET)
- UsageFault_Handler from interrupt.o(i.UsageFault_Handler) referenced from startup_cm3ds.o(RESET)
- __main from __main.o(!!!main) referenced from startup_cm3ds.o(.text)
- _get_lc_ctype from lc_ctype_c.o(locale$$code) referenced from rt_ctype_table.o(.text)
- _printf_input_char from _printf_char_common.o(.text) referenced from _printf_char_common.o(.text)
- _sputc from _sputc.o(.text) referenced from vsprintf.o(.text)
- b50610_get_reglist_test from eth_test.o(i.b50610_get_reglist_test) referenced 2 times from eth_test.o(.data)
- b50610_get_status from eth_bsp.o(i.b50610_get_status) referenced 2 times from eth_test.o(.data)
- b50610_init_test from eth_test.o(i.b50610_init_test) referenced 2 times from eth_test.o(.data)
- b50610_set_config from eth_bsp.o(i.b50610_set_config) referenced 2 times from eth_test.o(.data)
- b50610_set_swrst from eth_bsp.o(i.b50610_set_swrst) referenced 2 times from eth_test.o(.data)
- eth_testmenu from eth_test.o(i.eth_testmenu) referenced 2 times from main.o(.data)
- mcu_testmenu from main.o(i.mcu_testmenu) referenced 2 times from main.o(.data)

### Global Symbols

__main (Thumb, 8 bytes, Stack size 0 bytes, __main.o(!!!main))

[Calls]

- >> __rt_entry
- >> __scatterload

__scatterload (Thumb, 0 bytes, Stack size unknown bytes, __scatter.o(!!!scatter))

[Called By]

- >> __main

__scatterload_rt2 (Thumb, 44 bytes, Stack size unknown bytes, __scatter.o(!!!scatter), UNUSED)

[Calls]

- >> __rt_entry

__scatterload_rt2_thumb_only (Thumb, 0 bytes, Stack size unknown bytes, __scatter.o(!!!scatter), UNUSED)

__scatterload_null (Thumb, 0 bytes, Stack size unknown bytes, __scatter.o(!!!scatter), UNUSED)

__decompress (Thumb, 90 bytes, Stack size unknown bytes, __dczerorl2.o(!!dczerorl2), UNUSED)

__decompress1 (Thumb, 0 bytes, Stack size unknown bytes, __dczerorl2.o(!!dczerorl2), UNUSED)

__scatterload_zeroinit (Thumb, 28 bytes, Stack size unknown bytes, __scatter_zi.o(!!handler_zi), UNUSED)

_printf_n (Thumb, 0 bytes, Stack size unknown bytes, _printf_n.o(.ARM.Collect$$_printf_percent$$00000001))

[Calls]

- >> _printf_charcount

_printf_percent (Thumb, 0 bytes, Stack size unknown bytes, _printf_percent.o(.ARM.Collect$$_printf_percent$$00000000))

[Called By]

- >> __printf

_printf_p (Thumb, 0 bytes, Stack size unknown bytes, _printf_p.o(.ARM.Collect$$_printf_percent$$00000002))

[Stack]

- Max Depth = 64 + Unknown Stack Size
- Call Chain = _printf_p ⇒ _printf_hex_ptr ⇒ _printf_longlong_hex ⇒ _printf_int_common ⇒ _printf_post_padding

[Calls]

- >> _printf_hex_ptr

_printf_f (Thumb, 0 bytes, Stack size unknown bytes, _printf_f.o(.ARM.Collect$$_printf_percent$$00000003))

[Stack]

- Max Depth = 324 + Unknown Stack Size
- Call Chain = _printf_f ⇒ _printf_fp_dec ⇒ _printf_fp_dec_real ⇒ _fp_digits ⇒ _btod_etento ⇒ _btod_emul ⇒ _e2e

[Calls]

- >> _printf_fp_dec

_printf_e (Thumb, 0 bytes, Stack size unknown bytes, _printf_e.o(.ARM.Collect$$_printf_percent$$00000004))

[Stack]

- Max Depth = 324 + Unknown Stack Size
- Call Chain = _printf_e ⇒ _printf_fp_dec ⇒ _printf_fp_dec_real ⇒ _fp_digits ⇒ _btod_etento ⇒ _btod_emul ⇒ _e2e

[Calls]

- >> _printf_fp_dec

_printf_g (Thumb, 0 bytes, Stack size unknown bytes, _printf_g.o(.ARM.Collect$$_printf_percent$$00000005))

[Stack]

- Max Depth = 324 + Unknown Stack Size
- Call Chain = _printf_g ⇒ _printf_fp_dec ⇒ _printf_fp_dec_real ⇒ _fp_digits ⇒ _btod_etento ⇒ _btod_emul ⇒ _e2e

[Calls]

- >> _printf_fp_dec

_printf_a (Thumb, 0 bytes, Stack size unknown bytes, _printf_a.o(.ARM.Collect$$_printf_percent$$00000006))

[Stack]

- Max Depth = 112 + Unknown Stack Size
- Call Chain = _printf_a ⇒ _printf_fp_hex ⇒ _printf_fp_hex_real ⇒ _printf_fp_infnan ⇒ _printf_post_padding

[Calls]

- >> _printf_fp_hex

_printf_ll (Thumb, 0 bytes, Stack size unknown bytes, _printf_ll.o(.ARM.Collect$$_printf_percent$$00000007))

_printf_i (Thumb, 0 bytes, Stack size unknown bytes, _printf_i.o(.ARM.Collect$$_printf_percent$$00000008))

[Stack]

- Max Depth = 72 + Unknown Stack Size
- Call Chain = _printf_i ⇒ _printf_int_dec ⇒ _printf_int_common ⇒ _printf_post_padding

[Calls]

- >> _printf_int_dec

_printf_d (Thumb, 0 bytes, Stack size unknown bytes, _printf_d.o(.ARM.Collect$$_printf_percent$$00000009))

[Stack]

- Max Depth = 72 + Unknown Stack Size
- Call Chain = _printf_d ⇒ _printf_int_dec ⇒ _printf_int_common ⇒ _printf_post_padding

[Calls]

- >> _printf_int_dec

_printf_u (Thumb, 0 bytes, Stack size unknown bytes, _printf_u.o(.ARM.Collect$$_printf_percent$$0000000A))

[Stack]

- Max Depth = 72 + Unknown Stack Size
- Call Chain = _printf_u ⇒ _printf_int_dec ⇒ _printf_int_common ⇒ _printf_post_padding

[Calls]

- >> _printf_int_dec

_printf_o (Thumb, 0 bytes, Stack size unknown bytes, _printf_o.o(.ARM.Collect$$_printf_percent$$0000000B))

[Stack]

- Max Depth = 64 + Unknown Stack Size
- Call Chain = _printf_o ⇒ _printf_int_oct ⇒ _printf_longlong_oct ⇒ _printf_int_common ⇒ _printf_post_padding

[Calls]

- >> _printf_int_oct

_printf_x (Thumb, 0 bytes, Stack size unknown bytes, _printf_x.o(.ARM.Collect$$_printf_percent$$0000000C))

[Stack]

- Max Depth = 80 + Unknown Stack Size
- Call Chain = _printf_x ⇒ _printf_int_hex ⇒ _printf_longlong_hex ⇒ _printf_int_common ⇒ _printf_post_padding

[Calls]

- >> _printf_int_hex

_printf_lli (Thumb, 0 bytes, Stack size unknown bytes, _printf_lli.o(.ARM.Collect$$_printf_percent$$0000000D))

[Stack]

- Max Depth = 72 + Unknown Stack Size
- Call Chain = _printf_lli ⇒ _printf_longlong_dec ⇒ _printf_int_common ⇒ _printf_post_padding

[Calls]

- >> _printf_longlong_dec

_printf_lld (Thumb, 0 bytes, Stack size unknown bytes, _printf_lld.o(.ARM.Collect$$_printf_percent$$0000000E))

[Stack]

- Max Depth = 72 + Unknown Stack Size
- Call Chain = _printf_lld ⇒ _printf_longlong_dec ⇒ _printf_int_common ⇒ _printf_post_padding

[Calls]

- >> _printf_longlong_dec

_printf_llu (Thumb, 0 bytes, Stack size unknown bytes, _printf_llu.o(.ARM.Collect$$_printf_percent$$0000000F))

[Stack]

- Max Depth = 72 + Unknown Stack Size
- Call Chain = _printf_llu ⇒ _printf_longlong_dec ⇒ _printf_int_common ⇒ _printf_post_padding

[Calls]

- >> _printf_longlong_dec

_printf_llo (Thumb, 0 bytes, Stack size unknown bytes, _printf_llo.o(.ARM.Collect$$_printf_percent$$00000010))

[Stack]

- Max Depth = 56 + Unknown Stack Size
- Call Chain = _printf_llo ⇒ _printf_ll_oct ⇒ _printf_longlong_oct ⇒ _printf_int_common ⇒ _printf_post_padding

[Calls]

- >> _printf_ll_oct

_printf_llx (Thumb, 0 bytes, Stack size unknown bytes, _printf_llx.o(.ARM.Collect$$_printf_percent$$00000011))

[Stack]

- Max Depth = 64 + Unknown Stack Size
- Call Chain = _printf_llx ⇒ _printf_ll_hex ⇒ _printf_longlong_hex ⇒ _printf_int_common ⇒ _printf_post_padding

[Calls]

- >> _printf_ll_hex

_printf_l (Thumb, 0 bytes, Stack size unknown bytes, _printf_l.o(.ARM.Collect$$_printf_percent$$00000012))

_printf_c (Thumb, 0 bytes, Stack size unknown bytes, _printf_c.o(.ARM.Collect$$_printf_percent$$00000013))

[Stack]

- Max Depth = 40 + Unknown Stack Size
- Call Chain = _printf_c ⇒ _printf_char ⇒ _printf_cs_common ⇒ _printf_str ⇒ _printf_post_padding

[Calls]

- >> _printf_char

_printf_s (Thumb, 0 bytes, Stack size unknown bytes, _printf_s.o(.ARM.Collect$$_printf_percent$$00000014))

[Stack]

- Max Depth = 40 + Unknown Stack Size
- Call Chain = _printf_s ⇒ _printf_string ⇒ _printf_cs_common ⇒ _printf_str ⇒ _printf_post_padding

[Calls]

- >> _printf_string

_printf_lc (Thumb, 0 bytes, Stack size unknown bytes, _printf_lc.o(.ARM.Collect$$_printf_percent$$00000015))

[Stack]

- Max Depth = 88 + Unknown Stack Size
- Call Chain = _printf_lc ⇒ _printf_wchar ⇒ _printf_lcs_common ⇒ _printf_wctomb ⇒ _wcrtomb ⇒ __rt_ctype_table

[Calls]

- >> _printf_wchar

_printf_ls (Thumb, 0 bytes, Stack size unknown bytes, _printf_ls.o(.ARM.Collect$$_printf_percent$$00000016))

[Stack]

- Max Depth = 88 + Unknown Stack Size
- Call Chain = _printf_ls ⇒ _printf_wstring ⇒ _printf_lcs_common ⇒ _printf_wctomb ⇒ _wcrtomb ⇒ __rt_ctype_table

[Calls]

- >> _printf_wstring

_printf_percent_end (Thumb, 0 bytes, Stack size unknown bytes, _printf_percent_end.o(.ARM.Collect$$_printf_percent$$00000017))

__rt_lib_init (Thumb, 0 bytes, Stack size unknown bytes, libinit.o(.ARM.Collect$$libinit$$00000000))

[Called By]

- >> __rt_entry_li

__rt_lib_init_fp_1 (Thumb, 0 bytes, Stack size unknown bytes, libinit2.o(.ARM.Collect$$libinit$$00000002))

__rt_lib_init_heap_1 (Thumb, 0 bytes, Stack size unknown bytes, libinit2.o(.ARM.Collect$$libinit$$0000000A))

__rt_lib_init_lc_common (Thumb, 0 bytes, Stack size unknown bytes, libinit2.o(.ARM.Collect$$libinit$$0000000F))

[Calls]

- >> __rt_locale

__rt_lib_init_preinit_1 (Thumb, 0 bytes, Stack size unknown bytes, libinit2.o(.ARM.Collect$$libinit$$00000004))

__rt_lib_init_rand_1 (Thumb, 0 bytes, Stack size unknown bytes, libinit2.o(.ARM.Collect$$libinit$$0000000E))

__rt_lib_init_user_alloc_1 (Thumb, 0 bytes, Stack size unknown bytes, libinit2.o(.ARM.Collect$$libinit$$0000000C))

__rt_lib_init_lc_collate_1 (Thumb, 0 bytes, Stack size unknown bytes, libinit2.o(.ARM.Collect$$libinit$$00000011))

__rt_lib_init_lc_ctype_2 (Thumb, 0 bytes, Stack size unknown bytes, libinit2.o(.ARM.Collect$$libinit$$00000012))

[Stack]

- Max Depth = 8 + Unknown Stack Size
- Call Chain = __rt_lib_init_lc_ctype_2 ⇒ _get_lc_ctype

[Calls]

- >> _get_lc_ctype

__rt_lib_init_lc_ctype_1 (Thumb, 0 bytes, Stack size unknown bytes, libinit2.o(.ARM.Collect$$libinit$$00000013))

__rt_lib_init_lc_monetary_1 (Thumb, 0 bytes, Stack size unknown bytes, libinit2.o(.ARM.Collect$$libinit$$00000015))

__rt_lib_init_lc_numeric_2 (Thumb, 0 bytes, Stack size unknown bytes, libinit2.o(.ARM.Collect$$libinit$$00000016))

[Stack]

- Max Depth = 8 + Unknown Stack Size
- Call Chain = __rt_lib_init_lc_numeric_2 ⇒ _get_lc_numeric

[Calls]

- >> _get_lc_numeric

__rt_lib_init_alloca_1 (Thumb, 0 bytes, Stack size unknown bytes, libinit2.o(.ARM.Collect$$libinit$$0000002E))

__rt_lib_init_argv_1 (Thumb, 0 bytes, Stack size unknown bytes, libinit2.o(.ARM.Collect$$libinit$$0000002C))

__rt_lib_init_atexit_1 (Thumb, 0 bytes, Stack size unknown bytes, libinit2.o(.ARM.Collect$$libinit$$0000001B))

__rt_lib_init_clock_1 (Thumb, 0 bytes, Stack size unknown bytes, libinit2.o(.ARM.Collect$$libinit$$00000021))

__rt_lib_init_cpp_1 (Thumb, 0 bytes, Stack size unknown bytes, libinit2.o(.ARM.Collect$$libinit$$00000032))

__rt_lib_init_exceptions_1 (Thumb, 0 bytes, Stack size unknown bytes, libinit2.o(.ARM.Collect$$libinit$$00000030))

__rt_lib_init_fp_trap_1 (Thumb, 0 bytes, Stack size unknown bytes, libinit2.o(.ARM.Collect$$libinit$$0000001F))

__rt_lib_init_getenv_1 (Thumb, 0 bytes, Stack size unknown bytes, libinit2.o(.ARM.Collect$$libinit$$00000023))

__rt_lib_init_lc_numeric_1 (Thumb, 0 bytes, Stack size unknown bytes, libinit2.o(.ARM.Collect$$libinit$$00000017))

__rt_lib_init_lc_time_1 (Thumb, 0 bytes, Stack size unknown bytes, libinit2.o(.ARM.Collect$$libinit$$00000019))

__rt_lib_init_return (Thumb, 0 bytes, Stack size unknown bytes, libinit2.o(.ARM.Collect$$libinit$$00000033))

__rt_lib_init_signal_1 (Thumb, 0 bytes, Stack size unknown bytes, libinit2.o(.ARM.Collect$$libinit$$0000001D))

__rt_lib_init_stdio_1 (Thumb, 0 bytes, Stack size unknown bytes, libinit2.o(.ARM.Collect$$libinit$$00000025))

__rt_lib_shutdown (Thumb, 0 bytes, Stack size unknown bytes, libshutdown.o(.ARM.Collect$$libshutdown$$00000000))

[Called By]

- >> __rt_exit_ls

__rt_lib_shutdown_cpp_1 (Thumb, 0 bytes, Stack size unknown bytes, libshutdown2.o(.ARM.Collect$$libshutdown$$00000002))

__rt_lib_shutdown_fp_trap_1 (Thumb, 0 bytes, Stack size unknown bytes, libshutdown2.o(.ARM.Collect$$libshutdown$$00000007))

__rt_lib_shutdown_heap_1 (Thumb, 0 bytes, Stack size unknown bytes, libshutdown2.o(.ARM.Collect$$libshutdown$$0000000F))

__rt_lib_shutdown_return (Thumb, 0 bytes, Stack size unknown bytes, libshutdown2.o(.ARM.Collect$$libshutdown$$00000010))

__rt_lib_shutdown_signal_1 (Thumb, 0 bytes, Stack size unknown bytes, libshutdown2.o(.ARM.Collect$$libshutdown$$0000000A))

__rt_lib_shutdown_stdio_1 (Thumb, 0 bytes, Stack size unknown bytes, libshutdown2.o(.ARM.Collect$$libshutdown$$00000004))

__rt_lib_shutdown_user_alloc_1 (Thumb, 0 bytes, Stack size unknown bytes, libshutdown2.o(.ARM.Collect$$libshutdown$$0000000C))

__rt_entry (Thumb, 0 bytes, Stack size unknown bytes, __rtentry.o(.ARM.Collect$$rtentry$$00000000))

[Called By]

- >> __main
- >> __scatterload_rt2

__rt_entry_presh_1 (Thumb, 0 bytes, Stack size unknown bytes, __rtentry2.o(.ARM.Collect$$rtentry$$00000002))

__rt_entry_sh (Thumb, 0 bytes, Stack size unknown bytes, __rtentry4.o(.ARM.Collect$$rtentry$$00000004))

[Stack]

- Max Depth = 8 + Unknown Stack Size
- Call Chain = __rt_entry_sh ⇒ __user_setup_stackheap

[Calls]

- >> __user_setup_stackheap

__rt_entry_li (Thumb, 0 bytes, Stack size unknown bytes, __rtentry2.o(.ARM.Collect$$rtentry$$0000000A))

[Calls]

- >> __rt_lib_init

__rt_entry_postsh_1 (Thumb, 0 bytes, Stack size unknown bytes, __rtentry2.o(.ARM.Collect$$rtentry$$00000009))

__rt_entry_main (Thumb, 0 bytes, Stack size unknown bytes, __rtentry2.o(.ARM.Collect$$rtentry$$0000000D))

[Stack]

- Max Depth = 264 + Unknown Stack Size
- Call Chain = __rt_entry_main ⇒ main ⇒ mcu_testmenu ⇒ test_execute ⇒ drv_uart_printf ⇒ vprintf ⇒ vsprintf ⇒ _printf_char_common ⇒ __printf

[Calls]

- >> main
- >> exit

__rt_entry_postli_1 (Thumb, 0 bytes, Stack size unknown bytes, __rtentry2.o(.ARM.Collect$$rtentry$$0000000C))

__rt_exit (Thumb, 0 bytes, Stack size unknown bytes, rtexit.o(.ARM.Collect$$rtexit$$00000000))

[Called By]

- >> exit

__rt_exit_ls (Thumb, 0 bytes, Stack size unknown bytes, rtexit2.o(.ARM.Collect$$rtexit$$00000003))

[Calls]

- >> __rt_lib_shutdown

__rt_exit_prels_1 (Thumb, 0 bytes, Stack size unknown bytes, rtexit2.o(.ARM.Collect$$rtexit$$00000002))

__rt_exit_exit (Thumb, 0 bytes, Stack size unknown bytes, rtexit2.o(.ARM.Collect$$rtexit$$00000004))

[Calls]

- >> _sys_exit

Reset_Handler (Thumb, 4 bytes, Stack size 0 bytes, startup_cm3ds.o(.text))
[Address Reference Count : 1]

- startup_cm3ds.o(RESET)

Bastim_Ch0_Handler (Thumb, 0 bytes, Stack size 0 bytes, startup_cm3ds.o(.text))

[Calls]

- >> Bastim_Ch0_Handler

[Called By]

- >> Bastim_Ch0_Handler

[Address Reference Count : 1]

- startup_cm3ds.o(RESET)

Bastim_Ch1_Handler (Thumb, 0 bytes, Stack size 0 bytes, startup_cm3ds.o(.text))
[Address Reference Count : 1]

- startup_cm3ds.o(RESET)

Bastim_Ch2_Handler (Thumb, 0 bytes, Stack size 0 bytes, startup_cm3ds.o(.text))
[Address Reference Count : 1]

- startup_cm3ds.o(RESET)

Bastim_Ch3_Handler (Thumb, 0 bytes, Stack size 0 bytes, startup_cm3ds.o(.text))
[Address Reference Count : 1]

- startup_cm3ds.o(RESET)

Gpioa_Handler (Thumb, 0 bytes, Stack size 0 bytes, startup_cm3ds.o(.text))
[Address Reference Count : 1]

- startup_cm3ds.o(RESET)

Resv2_Handler (Thumb, 0 bytes, Stack size 0 bytes, startup_cm3ds.o(.text))
[Address Reference Count : 1]

- startup_cm3ds.o(RESET)

Resv3_Handler (Thumb, 0 bytes, Stack size 0 bytes, startup_cm3ds.o(.text))
[Address Reference Count : 1]

- startup_cm3ds.o(RESET)

Resv4_Handler (Thumb, 0 bytes, Stack size 0 bytes, startup_cm3ds.o(.text))
[Address Reference Count : 1]

- startup_cm3ds.o(RESET)

Resv6_Handler (Thumb, 0 bytes, Stack size 0 bytes, startup_cm3ds.o(.text))
[Address Reference Count : 1]

- startup_cm3ds.o(RESET)

Resv7_Handler (Thumb, 0 bytes, Stack size 0 bytes, startup_cm3ds.o(.text))
[Address Reference Count : 1]

- startup_cm3ds.o(RESET)

Uart1_Handler (Thumb, 0 bytes, Stack size 0 bytes, startup_cm3ds.o(.text))
[Address Reference Count : 1]

- startup_cm3ds.o(RESET)

__user_initial_stackheap (Thumb, 10 bytes, Stack size 0 bytes, startup_cm3ds.o(.text))

[Called By]

- >> __user_setup_stackheap

vsprintf (Thumb, 32 bytes, Stack size 16 bytes, vsprintf.o(.text))

[Stack]

- Max Depth = 120 + Unknown Stack Size
- Call Chain = vsprintf ⇒ _printf_char_common ⇒ __printf

[Calls]

- >> _sputc
- >> _printf_char_common

[Called By]

- >> vprintf

strlen (Thumb, 62 bytes, Stack size 8 bytes, strlen.o(.text))

[Stack]

- Max Depth = 8
- Call Chain = strlen

[Called By]

- >> vprintf

__use_two_region_memory (Thumb, 2 bytes, Stack size 0 bytes, heapauxi.o(.text), UNUSED)

__rt_heap_escrow$2region (Thumb, 2 bytes, Stack size 0 bytes, heapauxi.o(.text), UNUSED)

__rt_heap_expand$2region (Thumb, 2 bytes, Stack size 0 bytes, heapauxi.o(.text), UNUSED)

_printf_pre_padding (Thumb, 44 bytes, Stack size 16 bytes, _printf_pad.o(.text))

[Stack]

- Max Depth = 16
- Call Chain = _printf_pre_padding

[Called By]

- >> _printf_fp_infnan
- >> _printf_fp_hex_real
- >> _printf_fp_dec_real
- >> _printf_int_common
- >> _printf_wctomb
- >> _printf_str

_printf_post_padding (Thumb, 34 bytes, Stack size 16 bytes, _printf_pad.o(.text))

[Stack]

- Max Depth = 16
- Call Chain = _printf_post_padding

[Called By]

- >> _printf_fp_infnan
- >> _printf_fp_hex_real
- >> _printf_fp_dec_real
- >> _printf_int_common
- >> _printf_wctomb
- >> _printf_str

_printf_truncate_signed (Thumb, 18 bytes, Stack size 0 bytes, _printf_truncate.o(.text))

[Called By]

- >> _printf_int_dec

_printf_truncate_unsigned (Thumb, 18 bytes, Stack size 0 bytes, _printf_truncate.o(.text))

[Called By]

- >> _printf_int_hex
- >> _printf_int_oct
- >> _printf_int_dec

_printf_str (Thumb, 82 bytes, Stack size 16 bytes, _printf_str.o(.text))

[Stack]

- Max Depth = 32
- Call Chain = _printf_str ⇒ _printf_post_padding

[Calls]

- >> _printf_post_padding
- >> _printf_pre_padding

[Called By]

- >> _printf_cs_common

_printf_int_dec (Thumb, 104 bytes, Stack size 24 bytes, _printf_dec.o(.text))

[Stack]

- Max Depth = 72
- Call Chain = _printf_int_dec ⇒ _printf_int_common ⇒ _printf_post_padding

[Calls]

- >> _printf_int_common
- >> _printf_truncate_unsigned
- >> _printf_truncate_signed

[Called By]

- >> _printf_u
- >> _printf_d
- >> _printf_i

_printf_charcount (Thumb, 40 bytes, Stack size 0 bytes, _printf_charcount.o(.text))

[Called By]

- >> _printf_n

_printf_char_common (Thumb, 32 bytes, Stack size 64 bytes, _printf_char_common.o(.text))

[Stack]

- Max Depth = 104 + Unknown Stack Size
- Call Chain = _printf_char_common ⇒ __printf

[Calls]

- >> __printf

[Called By]

- >> vsprintf

_sputc (Thumb, 10 bytes, Stack size 0 bytes, _sputc.o(.text))

[Called By]

- >> vsprintf

[Address Reference Count : 1]

- vsprintf.o(.text)

_printf_wctomb (Thumb, 182 bytes, Stack size 56 bytes, _printf_wctomb.o(.text))

[Stack]

- Max Depth = 80
- Call Chain = _printf_wctomb ⇒ _wcrtomb ⇒ __rt_ctype_table

[Calls]

- >> _wcrtomb
- >> _printf_post_padding
- >> _printf_pre_padding

[Called By]

- >> _printf_lcs_common

_printf_longlong_dec (Thumb, 108 bytes, Stack size 24 bytes, _printf_longlong_dec.o(.text))

[Stack]

- Max Depth = 72
- Call Chain = _printf_longlong_dec ⇒ _printf_int_common ⇒ _printf_post_padding

[Calls]

- >> _printf_int_common
- >> _ll_udiv10

[Called By]

- >> _printf_llu
- >> _printf_lld
- >> _printf_lli

_printf_longlong_oct (Thumb, 66 bytes, Stack size 8 bytes, _printf_oct_int_ll.o(.text))

[Stack]

- Max Depth = 56
- Call Chain = _printf_longlong_oct ⇒ _printf_int_common ⇒ _printf_post_padding

[Calls]

- >> _printf_int_common

[Called By]

- >> _printf_ll_oct
- >> _printf_int_oct

_printf_int_oct (Thumb, 24 bytes, Stack size 8 bytes, _printf_oct_int_ll.o(.text))

[Stack]

- Max Depth = 64
- Call Chain = _printf_int_oct ⇒ _printf_longlong_oct ⇒ _printf_int_common ⇒ _printf_post_padding

[Calls]

- >> _printf_longlong_oct
- >> _printf_truncate_unsigned

[Called By]

- >> _printf_o

_printf_ll_oct (Thumb, 12 bytes, Stack size 0 bytes, _printf_oct_int_ll.o(.text))

[Stack]

- Max Depth = 56
- Call Chain = _printf_ll_oct ⇒ _printf_longlong_oct ⇒ _printf_int_common ⇒ _printf_post_padding

[Calls]

- >> _printf_longlong_oct

[Called By]

- >> _printf_llo

_printf_longlong_hex (Thumb, 86 bytes, Stack size 16 bytes, _printf_hex_int_ll_ptr.o(.text))

[Stack]

- Max Depth = 64
- Call Chain = _printf_longlong_hex ⇒ _printf_int_common ⇒ _printf_post_padding

[Calls]

- >> _printf_int_common

[Called By]

- >> _printf_hex_ptr
- >> _printf_ll_hex
- >> _printf_int_hex

_printf_int_hex (Thumb, 28 bytes, Stack size 16 bytes, _printf_hex_int_ll_ptr.o(.text))

[Stack]

- Max Depth = 80
- Call Chain = _printf_int_hex ⇒ _printf_longlong_hex ⇒ _printf_int_common ⇒ _printf_post_padding

[Calls]

- >> _printf_longlong_hex
- >> _printf_truncate_unsigned

[Called By]

- >> _printf_x

_printf_ll_hex (Thumb, 12 bytes, Stack size 0 bytes, _printf_hex_int_ll_ptr.o(.text))

[Stack]

- Max Depth = 64
- Call Chain = _printf_ll_hex ⇒ _printf_longlong_hex ⇒ _printf_int_common ⇒ _printf_post_padding

[Calls]

- >> _printf_longlong_hex

[Called By]

- >> _printf_llx

_printf_hex_ptr (Thumb, 18 bytes, Stack size 0 bytes, _printf_hex_int_ll_ptr.o(.text))

[Stack]

- Max Depth = 64
- Call Chain = _printf_hex_ptr ⇒ _printf_longlong_hex ⇒ _printf_int_common ⇒ _printf_post_padding

[Calls]

- >> _printf_longlong_hex

[Called By]

- >> _printf_p

__printf (Thumb, 388 bytes, Stack size 40 bytes, __printf_flags_ss_wp.o(.text))

[Stack]

- Max Depth = 40 + Unknown Stack Size
- Call Chain = __printf

[Calls]

- >> _printf_percent
- >> _is_digit

[Called By]

- >> _printf_char_common

_ll_udiv10 (Thumb, 138 bytes, Stack size 12 bytes, lludiv10.o(.text))

[Stack]

- Max Depth = 12
- Call Chain = _ll_udiv10

[Called By]

- >> _fp_digits
- >> _printf_longlong_dec

_printf_int_common (Thumb, 178 bytes, Stack size 32 bytes, _printf_intcommon.o(.text))

[Stack]

- Max Depth = 48
- Call Chain = _printf_int_common ⇒ _printf_post_padding

[Calls]

- >> _printf_post_padding
- >> _printf_pre_padding

[Called By]

- >> _printf_longlong_hex
- >> _printf_longlong_oct
- >> _printf_longlong_dec
- >> _printf_int_dec

__lib_sel_fp_printf (Thumb, 2 bytes, Stack size 0 bytes, _printf_fp_dec.o(.text), UNUSED)

_printf_fp_dec_real (Thumb, 620 bytes, Stack size 104 bytes, _printf_fp_dec.o(.text))

[Stack]

- Max Depth = 324
- Call Chain = _printf_fp_dec_real ⇒ _fp_digits ⇒ _btod_etento ⇒ _btod_emul ⇒ _e2e

[Calls]

- >> _printf_fp_infnan
- >> __rt_locale
- >> _fp_digits
- >> _printf_post_padding
- >> _printf_pre_padding
- >> __ARM_fpclassify

[Called By]

- >> _printf_fp_dec

_printf_fp_hex_real (Thumb, 756 bytes, Stack size 72 bytes, _printf_fp_hex.o(.text))

[Stack]

- Max Depth = 112
- Call Chain = _printf_fp_hex_real ⇒ _printf_fp_infnan ⇒ _printf_post_padding

[Calls]

- >> _printf_fp_infnan
- >> _printf_post_padding
- >> _printf_pre_padding
- >> __ARM_fpclassify

[Called By]

- >> _printf_fp_hex

_printf_cs_common (Thumb, 20 bytes, Stack size 8 bytes, _printf_char.o(.text))

[Stack]

- Max Depth = 40
- Call Chain = _printf_cs_common ⇒ _printf_str ⇒ _printf_post_padding

[Calls]

- >> _printf_str

[Called By]

- >> _printf_string
- >> _printf_char

_printf_char (Thumb, 16 bytes, Stack size 0 bytes, _printf_char.o(.text))

[Stack]

- Max Depth = 40
- Call Chain = _printf_char ⇒ _printf_cs_common ⇒ _printf_str ⇒ _printf_post_padding

[Calls]

- >> _printf_cs_common

[Called By]

- >> _printf_c

_printf_string (Thumb, 8 bytes, Stack size 0 bytes, _printf_char.o(.text))

[Stack]

- Max Depth = 40
- Call Chain = _printf_string ⇒ _printf_cs_common ⇒ _printf_str ⇒ _printf_post_padding

[Calls]

- >> _printf_cs_common

[Called By]

- >> _printf_s

_printf_lcs_common (Thumb, 20 bytes, Stack size 8 bytes, _printf_wchar.o(.text))

[Stack]

- Max Depth = 88
- Call Chain = _printf_lcs_common ⇒ _printf_wctomb ⇒ _wcrtomb ⇒ __rt_ctype_table

[Calls]

- >> _printf_wctomb

[Called By]

- >> _printf_wstring
- >> _printf_wchar

_printf_wchar (Thumb, 16 bytes, Stack size 0 bytes, _printf_wchar.o(.text))

[Stack]

- Max Depth = 88
- Call Chain = _printf_wchar ⇒ _printf_lcs_common ⇒ _printf_wctomb ⇒ _wcrtomb ⇒ __rt_ctype_table

[Calls]

- >> _printf_lcs_common

[Called By]

- >> _printf_lc

_printf_wstring (Thumb, 8 bytes, Stack size 0 bytes, _printf_wchar.o(.text))

[Stack]

- Max Depth = 88
- Call Chain = _printf_wstring ⇒ _printf_lcs_common ⇒ _printf_wctomb ⇒ _wcrtomb ⇒ __rt_ctype_table

[Calls]

- >> _printf_lcs_common

[Called By]

- >> _printf_ls

_wcrtomb (Thumb, 64 bytes, Stack size 16 bytes, _wcrtomb.o(.text))

[Stack]

- Max Depth = 24
- Call Chain = _wcrtomb ⇒ __rt_ctype_table

[Calls]

- >> __rt_ctype_table

[Called By]

- >> _printf_wctomb

__user_setup_stackheap (Thumb, 74 bytes, Stack size 8 bytes, sys_stackheap_outer.o(.text))

[Stack]

- Max Depth = 8
- Call Chain = __user_setup_stackheap

[Calls]

- >> __user_initial_stackheap
- >> __user_perproc_libspace

[Called By]

- >> __rt_entry_sh

__rt_ctype_table (Thumb, 16 bytes, Stack size 8 bytes, rt_ctype_table.o(.text))

[Stack]

- Max Depth = 8
- Call Chain = __rt_ctype_table

[Calls]

- >> __rt_locale

[Called By]

- >> _wcrtomb

__rt_locale (Thumb, 8 bytes, Stack size 0 bytes, rt_locale_intlibspace.o(.text))

[Called By]

- >> __rt_ctype_table
- >> _printf_fp_dec_real
- >> __rt_lib_init_lc_common

_printf_fp_infnan (Thumb, 112 bytes, Stack size 24 bytes, _printf_fp_infnan.o(.text))

[Stack]

- Max Depth = 40
- Call Chain = _printf_fp_infnan ⇒ _printf_post_padding

[Calls]

- >> _printf_post_padding
- >> _printf_pre_padding

[Called By]

- >> _printf_fp_hex_real
- >> _printf_fp_dec_real

_btod_etento (Thumb, 224 bytes, Stack size 72 bytes, bigflt0.o(.text))

[Stack]

- Max Depth = 124
- Call Chain = _btod_etento ⇒ _btod_emul ⇒ _e2e

[Calls]

- >> _btod_emul
- >> _btod_ediv

[Called By]

- >> _fp_digits

exit (Thumb, 18 bytes, Stack size 8 bytes, exit.o(.text))

[Stack]

- Max Depth = 8 + Unknown Stack Size
- Call Chain = exit

[Calls]

- >> __rt_exit

[Called By]

- >> __rt_entry_main

__user_libspace (Thumb, 8 bytes, Stack size 0 bytes, libspace.o(.text), UNUSED)

__user_perproc_libspace (Thumb, 0 bytes, Stack size 0 bytes, libspace.o(.text))

[Called By]

- >> __user_setup_stackheap

__user_perthread_libspace (Thumb, 0 bytes, Stack size 0 bytes, libspace.o(.text), UNUSED)

strcmp (Thumb, 128 bytes, Stack size 0 bytes, strcmpv7m.o(.text))

[Called By]

- >> _get_lc_numeric
- >> _get_lc_ctype

_sys_exit (Thumb, 8 bytes, Stack size 0 bytes, sys_exit.o(.text))

[Called By]

- >> __rt_exit_exit

__I$use$semihosting (Thumb, 0 bytes, Stack size 0 bytes, use_no_semi.o(.text), UNUSED)

__use_no_semihosting_swi (Thumb, 2 bytes, Stack size 0 bytes, use_no_semi.o(.text), UNUSED)

__semihosting_library_function (Thumb, 0 bytes, Stack size 0 bytes, indicate_semi.o(.text), UNUSED)

_btod_d2e (Thumb, 62 bytes, Stack size 0 bytes, btod.o(CL$$btod_d2e))

[Calls]

- >> _d2e_norm_op1

[Called By]

- >> _fp_digits

_d2e_denorm_low (Thumb, 70 bytes, Stack size 0 bytes, btod.o(CL$$btod_d2e_denorm_low))

[Called By]

- >> _d2e_norm_op1

_d2e_norm_op1 (Thumb, 96 bytes, Stack size 0 bytes, btod.o(CL$$btod_d2e_norm_op1))

[Calls]

- >> _d2e_denorm_low

[Called By]

- >> _btod_d2e

__btod_div_common (Thumb, 696 bytes, Stack size 24 bytes, btod.o(CL$$btod_div_common))

[Stack]

- Max Depth = 24
- Call Chain = __btod_div_common

[Called By]

- >> _btod_ediv

_e2e (Thumb, 220 bytes, Stack size 24 bytes, btod.o(CL$$btod_e2e))

[Stack]

- Max Depth = 24
- Call Chain = _e2e

[Called By]

- >> _btod_emul
- >> _btod_ediv

_btod_ediv (Thumb, 42 bytes, Stack size 28 bytes, btod.o(CL$$btod_ediv))

[Stack]

- Max Depth = 52
- Call Chain = _btod_ediv ⇒ _e2e

[Calls]

- >> _e2e
- >> __btod_div_common

[Called By]

- >> _btod_etento
- >> _fp_digits

_btod_emul (Thumb, 42 bytes, Stack size 28 bytes, btod.o(CL$$btod_emul))

[Stack]

- Max Depth = 52
- Call Chain = _btod_emul ⇒ _e2e

[Calls]

- >> __btod_mult_common
- >> _e2e

[Called By]

- >> _btod_etento
- >> _fp_digits

__btod_mult_common (Thumb, 580 bytes, Stack size 16 bytes, btod.o(CL$$btod_mult_common))

[Stack]

- Max Depth = 16
- Call Chain = __btod_mult_common

[Called By]

- >> _btod_emul

BusFault_Handler (Thumb, 4 bytes, Stack size 0 bytes, interrupt.o(i.BusFault_Handler))
[Address Reference Count : 1]

- startup_cm3ds.o(RESET)

DebugMon_Handler (Thumb, 2 bytes, Stack size 0 bytes, interrupt.o(i.DebugMon_Handler))
[Address Reference Count : 1]

- startup_cm3ds.o(RESET)

HardFault_Handler (Thumb, 4 bytes, Stack size 0 bytes, interrupt.o(i.HardFault_Handler))
[Address Reference Count : 1]

- startup_cm3ds.o(RESET)

MemManage_Handler (Thumb, 4 bytes, Stack size 0 bytes, interrupt.o(i.MemManage_Handler))
[Address Reference Count : 1]

- startup_cm3ds.o(RESET)

NMI_Handler (Thumb, 2 bytes, Stack size 0 bytes, interrupt.o(i.NMI_Handler))
[Address Reference Count : 1]

- startup_cm3ds.o(RESET)

PendSV_Handler (Thumb, 2 bytes, Stack size 0 bytes, interrupt.o(i.PendSV_Handler))
[Address Reference Count : 1]

- startup_cm3ds.o(RESET)

SVC_Handler (Thumb, 2 bytes, Stack size 0 bytes, interrupt.o(i.SVC_Handler))
[Address Reference Count : 1]

- startup_cm3ds.o(RESET)

SysTick_Handler (Thumb, 2 bytes, Stack size 0 bytes, interrupt.o(i.SysTick_Handler))
[Address Reference Count : 1]

- startup_cm3ds.o(RESET)

Uart0_Handler (Thumb, 16 bytes, Stack size 8 bytes, interrupt.o(i.Uart0_Handler))

[Stack]

- Max Depth = 24
- Call Chain = Uart0_Handler ⇒ drv_uart_interrupt_handler

[Calls]

- >> __NVIC_ClearPendingIRQ
- >> drv_uart_interrupt_handler

[Address Reference Count : 1]

- startup_cm3ds.o(RESET)

UsageFault_Handler (Thumb, 4 bytes, Stack size 0 bytes, interrupt.o(i.UsageFault_Handler))
[Address Reference Count : 1]

- startup_cm3ds.o(RESET)

__ARM_fpclassify (Thumb, 40 bytes, Stack size 0 bytes, fpclassify.o(i.__ARM_fpclassify))

[Called By]

- >> _printf_fp_hex_real
- >> _printf_fp_dec_real

_is_digit (Thumb, 14 bytes, Stack size 0 bytes, __printf_wp.o(i._is_digit))

[Called By]

- >> __printf

b50610_get_reglist_test (Thumb, 86 bytes, Stack size 16 bytes, eth_test.o(i.b50610_get_reglist_test))

[Stack]

- Max Depth = 264 + Unknown Stack Size
- Call Chain = b50610_get_reglist_test ⇒ test_printf_ch ⇒ drv_uart_printf ⇒ vprintf ⇒ vsprintf ⇒ _printf_char_common ⇒ __printf

[Calls]

- >> drv_eth_sma_master_read_reglist
- >> test_printf_s
- >> test_printf_ch

[Address Reference Count : 1]

- eth_test.o(.data)

b50610_get_status (Thumb, 58 bytes, Stack size 16 bytes, eth_bsp.o(i.b50610_get_status))

[Stack]

- Max Depth = 264 + Unknown Stack Size
- Call Chain = b50610_get_status ⇒ test_printf_ch ⇒ drv_uart_printf ⇒ vprintf ⇒ vsprintf ⇒ _printf_char_common ⇒ __printf

[Calls]

- >> drv_eth_sma_master_read_reg
- >> test_printf_s
- >> test_printf_ch

[Address Reference Count : 1]

- eth_test.o(.data)

b50610_init (Thumb, 62 bytes, Stack size 8 bytes, eth_bsp.o(i.b50610_init))

[Stack]

- Max Depth = 32
- Call Chain = b50610_init ⇒ drv_eth_sma_set_config ⇒ drv_check_rw_data

[Calls]

- >> drv_eth_sma_set_config
- >> drv_eth_sma_master_write_reglist

[Called By]

- >> b50610_init_test

b50610_init_test (Thumb, 12 bytes, Stack size 8 bytes, eth_test.o(i.b50610_init_test))

[Stack]

- Max Depth = 56
- Call Chain = b50610_init_test ⇒ eth_sma_init ⇒ drv_eth_sma_init ⇒ drv_eth_sma_set_config ⇒ drv_check_rw_data

[Calls]

- >> eth_sma_init
- >> b50610_init

[Address Reference Count : 1]

- eth_test.o(.data)

b50610_set_config (Thumb, 16 bytes, Stack size 8 bytes, eth_bsp.o(i.b50610_set_config))

[Stack]

- Max Depth = 24
- Call Chain = b50610_set_config ⇒ drv_eth_sma_master_write_reg

[Calls]

- >> drv_eth_sma_master_write_reg

[Address Reference Count : 1]

- eth_test.o(.data)

b50610_set_swrst (Thumb, 16 bytes, Stack size 8 bytes, eth_bsp.o(i.b50610_set_swrst))

[Stack]

- Max Depth = 24
- Call Chain = b50610_set_swrst ⇒ drv_eth_sma_master_write_reg

[Calls]

- >> drv_eth_sma_master_write_reg

[Address Reference Count : 1]

- eth_test.o(.data)

drv_check_rw_data (Thumb, 40 bytes, Stack size 8 bytes, drv_common.o(i.drv_check_rw_data))

[Stack]

- Max Depth = 8
- Call Chain = drv_check_rw_data

[Called By]

- >> drv_eth_sma_set_config
- >> drv_uart_set_config

drv_eth_sma_default_config (Thumb, 10 bytes, Stack size 0 bytes, drv_eth.o(i.drv_eth_sma_default_config))

[Called By]

- >> eth_sma_init

drv_eth_sma_init (Thumb, 64 bytes, Stack size 16 bytes, drv_eth.o(i.drv_eth_sma_init))

[Stack]

- Max Depth = 40
- Call Chain = drv_eth_sma_init ⇒ drv_eth_sma_set_config ⇒ drv_check_rw_data

[Calls]

- >> drv_eth_sma_set_config
- >> drv_eth_sma_logic_reset
- >> drv_eth_sma_int_allclear

[Called By]

- >> eth_sma_init

drv_eth_sma_master_read_reg (Thumb, 108 bytes, Stack size 16 bytes, drv_eth.o(i.drv_eth_sma_master_read_reg))

[Stack]

- Max Depth = 16
- Call Chain = drv_eth_sma_master_read_reg

[Calls]

- >> drv_eth_sma_logic_reset
- >> drv_eth_sma_int_get
- >> drv_eth_sma_int_clear

[Called By]

- >> b50610_get_status

drv_eth_sma_master_read_reglist (Thumb, 152 bytes, Stack size 16 bytes, drv_eth.o(i.drv_eth_sma_master_read_reglist))

[Stack]

- Max Depth = 16
- Call Chain = drv_eth_sma_master_read_reglist

[Calls]

- >> drv_eth_sma_logic_reset
- >> drv_eth_sma_int_get
- >> drv_eth_sma_int_clear

[Called By]

- >> b50610_get_reglist_test

drv_eth_sma_master_write_reg (Thumb, 64 bytes, Stack size 16 bytes, drv_eth.o(i.drv_eth_sma_master_write_reg))

[Stack]

- Max Depth = 16
- Call Chain = drv_eth_sma_master_write_reg

[Calls]

- >> drv_eth_sma_int_get
- >> drv_eth_sma_int_clear

[Called By]

- >> b50610_set_swrst
- >> b50610_set_config

drv_eth_sma_master_write_reglist (Thumb, 76 bytes, Stack size 16 bytes, drv_eth.o(i.drv_eth_sma_master_write_reglist))

[Stack]

- Max Depth = 16
- Call Chain = drv_eth_sma_master_write_reglist

[Calls]

- >> drv_eth_sma_int_get
- >> drv_eth_sma_int_clear

[Called By]

- >> b50610_init

drv_eth_sma_set_config (Thumb, 38 bytes, Stack size 16 bytes, drv_eth.o(i.drv_eth_sma_set_config))

[Stack]

- Max Depth = 24
- Call Chain = drv_eth_sma_set_config ⇒ drv_check_rw_data

[Calls]

- >> drv_check_rw_data

[Called By]

- >> drv_eth_sma_init
- >> b50610_init

drv_uart_default_config (Thumb, 28 bytes, Stack size 0 bytes, drv_uart.o(i.drv_uart_default_config))

[Called By]

- >> uart0_init

drv_uart_getchar_timeout (Thumb, 108 bytes, Stack size 24 bytes, drv_uart.o(i.drv_uart_getchar_timeout))

[Stack]

- Max Depth = 24
- Call Chain = drv_uart_getchar_timeout

[Calls]

- >> drv_uart_logic_reset
- >> drv_uart_int_get
- >> drv_uart_int_clear

[Called By]

- >> test_execute

drv_uart_init (Thumb, 82 bytes, Stack size 16 bytes, drv_uart.o(i.drv_uart_init))

[Stack]

- Max Depth = 40
- Call Chain = drv_uart_init ⇒ drv_uart_set_config ⇒ drv_check_rw_data

[Calls]

- >> drv_uart_set_config
- >> drv_uart_logic_reset
- >> drv_uart_int_allclear

[Called By]

- >> uart0_init

drv_uart_interrupt_handler (Thumb, 350 bytes, Stack size 16 bytes, drv_uart.o(i.drv_uart_interrupt_handler))

[Stack]

- Max Depth = 16
- Call Chain = drv_uart_interrupt_handler

[Calls]

- >> uart_int_tx_fifo_thres_callback
- >> uart_int_tx_fifo_empty_callback
- >> uart_int_tx_done_callback
- >> uart_int_rx_stop_detect_callback
- >> uart_int_rx_stop_callback
- >> uart_int_rx_parity_error_callback
- >> uart_int_rx_noise_detect_callback
- >> uart_int_rx_fifo_thres_callback
- >> uart_int_rx_fifo_noempty_callback
- >> drv_uart_logic_reset
- >> drv_uart_int_get
- >> drv_uart_int_disable
- >> drv_uart_int_clear

[Called By]

- >> Uart0_Handler

drv_uart_printf (Thumb, 26 bytes, Stack size 24 bytes, drv_uart_ex.o(i.drv_uart_printf))

[Stack]

- Max Depth = 232 + Unknown Stack Size
- Call Chain = drv_uart_printf ⇒ vprintf ⇒ vsprintf ⇒ _printf_char_common ⇒ __printf

[Calls]

- >> vprintf

[Called By]

- >> test_execute
- >> show_testmenu
- >> test_printf_s
- >> test_printf_ch

drv_uart_putchars (Thumb, 72 bytes, Stack size 16 bytes, drv_uart.o(i.drv_uart_putchars))

[Stack]

- Max Depth = 16
- Call Chain = drv_uart_putchars

[Calls]

- >> drv_uart_int_get
- >> drv_uart_int_clear

[Called By]

- >> vprintf

drv_uart_set_config (Thumb, 76 bytes, Stack size 16 bytes, drv_uart.o(i.drv_uart_set_config))

[Stack]

- Max Depth = 24
- Call Chain = drv_uart_set_config ⇒ drv_check_rw_data

[Calls]

- >> drv_check_rw_data

[Called By]

- >> drv_uart_init

eth_sma_init (Thumb, 22 bytes, Stack size 8 bytes, eth_bsp.o(i.eth_sma_init))

[Stack]

- Max Depth = 48
- Call Chain = eth_sma_init ⇒ drv_eth_sma_init ⇒ drv_eth_sma_set_config ⇒ drv_check_rw_data

[Calls]

- >> drv_eth_sma_init
- >> drv_eth_sma_default_config

[Called By]

- >> b50610_init_test

eth_testmenu (Thumb, 22 bytes, Stack size 8 bytes, eth_test.o(i.eth_testmenu))

[Stack]

- Max Depth = 264 + Unknown Stack Size
- Call Chain = eth_testmenu ⇒ test_execute ⇒ drv_uart_printf ⇒ vprintf ⇒ vsprintf ⇒ _printf_char_common ⇒ __printf

[Calls]

- >> test_execute
- >> show_testmenu

[Address Reference Count : 1]

- main.o(.data)

main (Thumb, 12 bytes, Stack size 0 bytes, main.o(i.main))

[Stack]

- Max Depth = 264 + Unknown Stack Size
- Call Chain = main ⇒ mcu_testmenu ⇒ test_execute ⇒ drv_uart_printf ⇒ vprintf ⇒ vsprintf ⇒ _printf_char_common ⇒ __printf

[Calls]

- >> uart0_init
- >> mcu_testmenu

[Called By]

- >> __rt_entry_main

mcu_testmenu (Thumb, 22 bytes, Stack size 8 bytes, main.o(i.mcu_testmenu))

[Stack]

- Max Depth = 264 + Unknown Stack Size
- Call Chain = mcu_testmenu ⇒ test_execute ⇒ drv_uart_printf ⇒ vprintf ⇒ vsprintf ⇒ _printf_char_common ⇒ __printf

[Calls]

- >> test_execute
- >> show_testmenu

[Called By]

- >> main

[Address Reference Count : 1]

- main.o(.data)

show_testmenu (Thumb, 58 bytes, Stack size 16 bytes, main.o(i.show_testmenu))

[Stack]

- Max Depth = 248 + Unknown Stack Size
- Call Chain = show_testmenu ⇒ drv_uart_printf ⇒ vprintf ⇒ vsprintf ⇒ _printf_char_common ⇒ __printf

[Calls]

- >> drv_uart_printf

[Called By]

- >> eth_testmenu
- >> mcu_testmenu

test_execute (Thumb, 142 bytes, Stack size 24 bytes, main.o(i.test_execute))

[Stack]

- Max Depth = 256 + Unknown Stack Size
- Call Chain = test_execute ⇒ drv_uart_printf ⇒ vprintf ⇒ vsprintf ⇒ _printf_char_common ⇒ __printf

[Calls]

- >> drv_uart_printf
- >> drv_uart_getchar_timeout

[Called By]

- >> eth_testmenu
- >> mcu_testmenu

test_printf_ch (Thumb, 16 bytes, Stack size 16 bytes, uart_bsp.o(i.test_printf_ch))

[Stack]

- Max Depth = 248 + Unknown Stack Size
- Call Chain = test_printf_ch ⇒ drv_uart_printf ⇒ vprintf ⇒ vsprintf ⇒ _printf_char_common ⇒ __printf

[Calls]

- >> drv_uart_printf

[Called By]

- >> b50610_get_reglist_test
- >> b50610_get_status

test_printf_s (Thumb, 12 bytes, Stack size 8 bytes, uart_bsp.o(i.test_printf_s))

[Stack]

- Max Depth = 240 + Unknown Stack Size
- Call Chain = test_printf_s ⇒ drv_uart_printf ⇒ vprintf ⇒ vsprintf ⇒ _printf_char_common ⇒ __printf

[Calls]

- >> drv_uart_printf

[Called By]

- >> b50610_get_reglist_test
- >> b50610_get_status

uart0_init (Thumb, 22 bytes, Stack size 8 bytes, uart_bsp.o(i.uart0_init))

[Stack]

- Max Depth = 48
- Call Chain = uart0_init ⇒ drv_uart_init ⇒ drv_uart_set_config ⇒ drv_check_rw_data

[Calls]

- >> drv_uart_init
- >> drv_uart_default_config

[Called By]

- >> main

uart_int_rx_fifo_noempty_callback (Thumb, 2 bytes, Stack size 0 bytes, drv_uart.o(i.uart_int_rx_fifo_noempty_callback))

[Called By]

- >> drv_uart_interrupt_handler

uart_int_rx_fifo_thres_callback (Thumb, 2 bytes, Stack size 0 bytes, drv_uart.o(i.uart_int_rx_fifo_thres_callback))

[Called By]

- >> drv_uart_interrupt_handler

uart_int_rx_noise_detect_callback (Thumb, 2 bytes, Stack size 0 bytes, drv_uart.o(i.uart_int_rx_noise_detect_callback))

[Called By]

- >> drv_uart_interrupt_handler

uart_int_rx_parity_error_callback (Thumb, 2 bytes, Stack size 0 bytes, drv_uart.o(i.uart_int_rx_parity_error_callback))

[Called By]

- >> drv_uart_interrupt_handler

uart_int_rx_stop_callback (Thumb, 2 bytes, Stack size 0 bytes, drv_uart.o(i.uart_int_rx_stop_callback))

[Called By]

- >> drv_uart_interrupt_handler

uart_int_rx_stop_detect_callback (Thumb, 2 bytes, Stack size 0 bytes, drv_uart.o(i.uart_int_rx_stop_detect_callback))

[Called By]

- >> drv_uart_interrupt_handler

uart_int_tx_done_callback (Thumb, 2 bytes, Stack size 0 bytes, drv_uart.o(i.uart_int_tx_done_callback))

[Called By]

- >> drv_uart_interrupt_handler

uart_int_tx_fifo_empty_callback (Thumb, 2 bytes, Stack size 0 bytes, drv_uart.o(i.uart_int_tx_fifo_empty_callback))

[Called By]

- >> drv_uart_interrupt_handler

uart_int_tx_fifo_thres_callback (Thumb, 2 bytes, Stack size 0 bytes, drv_uart.o(i.uart_int_tx_fifo_thres_callback))

[Called By]

- >> drv_uart_interrupt_handler

vprintf (Thumb, 48 bytes, Stack size 88 bytes, drv_uart_ex.o(i.vprintf))

[Stack]

- Max Depth = 208 + Unknown Stack Size
- Call Chain = vprintf ⇒ vsprintf ⇒ _printf_char_common ⇒ __printf

[Calls]

- >> drv_uart_putchars
- >> strlen
- >> vsprintf

[Called By]

- >> drv_uart_printf

_get_lc_numeric (Thumb, 44 bytes, Stack size 8 bytes, lc_numeric_c.o(locale$$code))

[Stack]

- Max Depth = 8
- Call Chain = _get_lc_numeric

[Calls]

- >> strcmp

[Called By]

- >> __rt_lib_init_lc_numeric_2

_get_lc_ctype (Thumb, 44 bytes, Stack size 8 bytes, lc_ctype_c.o(locale$$code))

[Stack]

- Max Depth = 8
- Call Chain = _get_lc_ctype

[Calls]

- >> strcmp

[Called By]

- >> __rt_lib_init_lc_ctype_2

[Address Reference Count : 1]

- rt_ctype_table.o(.text)

_printf_fp_dec (Thumb, 4 bytes, Stack size 0 bytes, printf1.o(x$fpl$printf1))

[Stack]

- Max Depth = 324
- Call Chain = _printf_fp_dec ⇒ _printf_fp_dec_real ⇒ _fp_digits ⇒ _btod_etento ⇒ _btod_emul ⇒ _e2e

[Calls]

- >> _printf_fp_dec_real

[Called By]

- >> _printf_g
- >> _printf_e
- >> _printf_f

_printf_fp_hex (Thumb, 4 bytes, Stack size 0 bytes, printf2.o(x$fpl$printf2))

[Stack]

- Max Depth = 112
- Call Chain = _printf_fp_hex ⇒ _printf_fp_hex_real ⇒ _printf_fp_infnan ⇒ _printf_post_padding

[Calls]

- >> _printf_fp_hex_real

[Called By]

- >> _printf_a

### Local Symbols

drv_uart_int_allclear (Thumb, 16 bytes, Stack size 0 bytes, drv_uart.o(i.drv_uart_int_allclear))

[Called By]

- >> drv_uart_init

drv_uart_int_clear (Thumb, 18 bytes, Stack size 0 bytes, drv_uart.o(i.drv_uart_int_clear))

[Called By]

- >> drv_uart_putchars
- >> drv_uart_interrupt_handler
- >> drv_uart_getchar_timeout

drv_uart_int_disable (Thumb, 12 bytes, Stack size 0 bytes, drv_uart.o(i.drv_uart_int_disable))

[Called By]

- >> drv_uart_interrupt_handler

drv_uart_int_get (Thumb, 8 bytes, Stack size 0 bytes, drv_uart.o(i.drv_uart_int_get))

[Called By]

- >> drv_uart_putchars
- >> drv_uart_interrupt_handler
- >> drv_uart_getchar_timeout

drv_uart_logic_reset (Thumb, 106 bytes, Stack size 0 bytes, drv_uart.o(i.drv_uart_logic_reset))

[Called By]

- >> drv_uart_interrupt_handler
- >> drv_uart_init
- >> drv_uart_getchar_timeout

drv_eth_sma_int_allclear (Thumb, 14 bytes, Stack size 0 bytes, drv_eth.o(i.drv_eth_sma_int_allclear))

[Called By]

- >> drv_eth_sma_init

drv_eth_sma_int_clear (Thumb, 18 bytes, Stack size 0 bytes, drv_eth.o(i.drv_eth_sma_int_clear))

[Called By]

- >> drv_eth_sma_master_write_reglist
- >> drv_eth_sma_master_write_reg
- >> drv_eth_sma_master_read_reglist
- >> drv_eth_sma_master_read_reg

drv_eth_sma_int_get (Thumb, 8 bytes, Stack size 0 bytes, drv_eth.o(i.drv_eth_sma_int_get))

[Called By]

- >> drv_eth_sma_master_write_reglist
- >> drv_eth_sma_master_write_reg
- >> drv_eth_sma_master_read_reglist
- >> drv_eth_sma_master_read_reg

drv_eth_sma_logic_reset (Thumb, 82 bytes, Stack size 0 bytes, drv_eth.o(i.drv_eth_sma_logic_reset))

[Called By]

- >> drv_eth_sma_master_read_reglist
- >> drv_eth_sma_master_read_reg
- >> drv_eth_sma_init

EthSma_Handler (Thumb, 0 bytes, Stack size 0 bytes, startup_cm3ds.o(.text))
[Address Reference Count : 1]

- startup_cm3ds.o(RESET)

__NVIC_ClearPendingIRQ (Thumb, 22 bytes, Stack size 0 bytes, interrupt.o(i.__NVIC_ClearPendingIRQ))

[Called By]

- >> Uart0_Handler

_printf_input_char (Thumb, 10 bytes, Stack size 0 bytes, _printf_char_common.o(.text))
[Address Reference Count : 1]

- _printf_char_common.o(.text)

_fp_digits (Thumb, 432 bytes, Stack size 96 bytes, _printf_fp_dec.o(.text))

[Stack]

- Max Depth = 220
- Call Chain = _fp_digits ⇒ _btod_etento ⇒ _btod_emul ⇒ _e2e

[Calls]

- >> _btod_emul
- >> _btod_ediv
- >> _btod_d2e
- >> _btod_etento
- >> _ll_udiv10

[Called By]

- >> _printf_fp_dec_real

### Undefined Global Symbols
