houdonghui1/Trust_Shield/First_rot/doc/testcase/bastim_testcase.xls

Sheet: rtl_spec
ChapterNo. | CaseNo. | Chapter | Case | Descriptions | TestCase | TP_0 | TP_1 | TP_2
1 | 1 | Reload | Autoreload | different configurations in different channels with autoreload enable |  | √
 | 2 |  | No autoreload | different configurations in different channels with autoreload disable |  |  | √
 | 3 |  | Reload manually | different configurations in different channels with autoreload disable and manual reload |  |  |  | √
2 | 1 | Int | Int | int for input |  | √ | √ | √
 | 10 |  | Interrupt Line | int to cpu |  | √ | √ | √

Sheet: rtl_testcase
TestCase | Description
TP_0 | This case will traverse each channel with auto reload mode enable. Different channels have different configurations including asc, prr and startcnt. The configs are set by swd.
TP_1 | This case will traverse each channel with auto reload mode disable. Different channels have different configurations including asc, prr and startcnt. The configs are set by swd.
TP_2 | This case will traverse each channel with auto reload mode disable. Then, enabling each channel again with same configurations. Different channels have different configurations including asc, prr and startcnt. The configs are set by swd.
