houdonghui1/Trust_Shield/First_rot/doc/testcase/eth_sma_testcase.xls

Sheet: rtl_spec
ChapterNo. | CaseNo. | Chapter | Case | Descriptions | TestCase | TP_0 | TP_1
1 | 1 | Protocol | TX Frame | transmit different address and data |  | √
 | 2 |  | TX Interval | transmit interval bit 0~7 |  |  | √
 | 3 |  | RX Frame | receive different address and data |  | √
 | 4 |  | RX Interval | receive interval bit 0~7 |  |  | √
2 | 1 | Int | Int4 | int for master frame done |  | √ | √
 | 2 |  | Int3 | int for rx fifo empty |  | √ | √
 | 3 |  | Int2 | int for rx fifo warning |  | √ | √
 | 4 |  | Int1 | int for tx fifo empty |  | √ | √
 | 5 |  | Int0 | int for tx fifo warning |  | √ | √
 | 6 |  | Interrupt Line | int to cpu
3 | 1 | Function | TX FIFO Clear | tx fifo can be cleared by clear bit |  | √ | √
 | 2 |  | RX FIFO Clear | rx fifo can be cleared by clear bit |  | √ | √
 | 3 |  | TX Logic Clear | tx fsm can be cleared by clear bit |  | √ | √
 | 4 |  | RX Logic Clear | rx fsm can be cleared by clear bit |  | √ | √

Sheet: rtl_testcase
TestCase | Description
TP_0 | This case will tx and rx frames alternatively without interval bits. The configs are set by swd after master frame done int status asserted and then clear all fifos and logics between each config.
TP_1 | This case will tx and rx frames alternatively with interval bits. The configs are set by swd after master frame done int status asserted and then clear all fifos and logics between each config.
