houdonghui1/Trust_Shield/First_rot/doc/testcase/gpio_testcase.xls

Sheet: rtl_spec
ChapterNo. | CaseNo. | Chapter | Case | Descriptions | TestCase | TP_0 | TP_1 | TP_2
1 | 1 | PP in/out | Output | output by r_odx in pp |  | √
 | 2 |  | Toggle | output by r_togglex in pp |  |  | √
 | 3 |  | Input | input by r_idx in pp |  |  |  | √
 | 4 | OD in/out | Output | output by r_odx in od
 | 5 |  | Toggle | output by r_togglex in od
 | 6 |  | Input | input by r_idx in od
2 | 1 | Int | Int | int for input |  |  |  | √
 | 10 |  | Interrupt Line | int to cpu |  |  |  | √
3 | 1 | Function | Digital AF | digital alternate function in/out
 | 2

Sheet: rtl_testcase
TestCase | Description
TP_0 | This case will traverse gpio with output by r_odx. The configs are set by swd.
TP_1 | This case will traverse gpio with toggle by r_togglex. The configs are set by swd.
TP_2 | This case will traverse gpio with input. The configs are set by swd.
