houdonghui1/Trust_Shield/First_rot/doc/testcase/uart_testcase.xls

Sheet: rtl_spec
ChapterNo. | CaseNo. | Chapter | Case | Descriptions | TestCase | TP_0 | TP_1 | TP_2 | TP_3 | TP_4 | TP_5
1 | 1 | Protocol | TX Databit | transmit data bit 7~10 |  | √ | √
 | 2 |  | TX Stopbit | transmit stop bit 1~2 |  | √ | √
 | 3 |  | TX Paritybit | transmit parity bit odd, even, 0 ,1 |  |  | √
 | 4 |  | TX Interval | transmit interval bit 0~7 |  | √
 | 5 |  | RX Databit | receive data bit 7~10 |  |  |  | √ | √ |  | √
 | 6 |  | RX Stopbit | receive stop bit 1~2 |  |  |  | √ | √ |  | √
 | 7 |  | RX Paritybit | receive parity bit odd, even, 0 ,1 |  |  |  |  | √ |  | √
 | 8 |  | RX Interval | receive interval bit 0~7 |  |  |  | √
 | 9 |  | Ignore RX Error | ignore parity and stop error |  |  |  |  |  |  | √
 | 10 |  | RX Noise | noise filter |  |  |  |  |  | √
2 | 1 | Int | Int8 | int for tx done |  | √ | √
 | 2 |  | Int7 | int for rx data parity error |  |  |  |  |  |  | √
 | 3 |  | Int6 | int for rx data stop error |  |  |  |  |  |  | √
 | 4 |  | Int5 | int for rx data noise detect |  |  |  |  |  | √
 | 5 |  | Int4 | int for rx data stop detect |  |  |  | √ | √ |  | √
 | 6 |  | Int3 | int for rx fifo empty |  |  |  | √ | √ |  | √
 | 7 |  | Int2 | int for rx fifo warning
 | 8 |  | Int1 | int for tx fifo empty |  | √ | √
 | 9 |  | Int0 | int for tx fifo warning
 | 10 |  | Interrupt Line | int to cpu |  |  |  |  |  | √ | √
3 | 1 | Function | TX FIFO Clear | tx fifo can be cleared by clear bit |  | √ | √
 | 2 |  | RX FIFO Clear | rx fifo can be cleared by clear bit |  |  |  | √ | √ |  | √
 | 3 |  | TX Logic Clear | tx fsm can be cleared by clear bit |  | √ | √
 | 4 |  | RX Logic Clear | rx fsm can be cleared by clear bit |  |  |  | √ | √ |  | √

Sheet: rtl_testcase
TestCase | Description
TP_0 | This case will traverse tx with the config of the number of data bit, stop bit and interval bit. The configs are set by swd after tx done int status asserted and then clear all fifos and logics between each config.
TP_1 | This case will traverse tx with the config of the number of data bit, stop bit and different parity bits. The configs are set by swd after tx done int status asserted and then clear all fifos and logics between each config.
TP_2 | This case will traverse rx with the config of the number of data bit, stop bit and interval bit. The configs are set by swd after a group of data transmitted by uart model and then clear all fifos and logics between each config.
TP_3 | This case will traverse rx with the config of the number of data bit, stop bit and different parity bits. The configs are set by swd after a group of data transmitted by uart model and then clear all fifos and logics between each config.
TP_4 | This case will transmit noise by uart model with the length range of 0 to half length of a bit. The configs are set by swd before test.
TP_5 | This case will traverse rx with the config of the number of data bit, stop bit and different parity bits. Each bit of stop bit or parity bit is error. The configs are set by swd after a group of data transmitted by uart model and then clear all fifos and logics between each config.
