houdonghui1/Trust_Shield/Second_rot/latest/rtl/docs/Caliptra_TestPlan.xlsx

Sheet: Caliptra TestPlan - L1
Major Feature | Minor Feature | Description | Tests & Checkers | Functional Coverage % | Comments
HMAC384
 | single and multi-block messages | HMAC receives 384-bit key and input message of variable length (single and multi-block messages) to generate 384-bit tag. The HMAC_random_test also exercises reset case | 1oo%
 | Reset test | Assert reset while doing HMAC operation, and make sure that everything is cleared. | 1oo%
 | Re-init between hmac operations | Verify HMAC of a message completed successfully before re-init for the next message | 1oo%
 | Interface | AHB-lite interface access validation | 1oo%
 | Zeroize | Assert zeroize | 1oo%
 | Registers I/O | Register rd/wr from crypto side and ahb-lite side | 1oo%
 | Other registers that get decoded to HMAC | As Col.B says | 1oo%
 | Performance test | As Col.B says | 1oo%
 | Nightly regression with mbedlts checker enabled | Continual regression | 1oo%
 | Error conditions triggers and status | Validate crypto defined error conditions if any
ECC
 | Key Gen | ECC receives seed, nonce, and IV inputs and generates privkey and pubkey. | 1oo%
 | Key Sign | ECC receives the hashed message, privkey, and IV, and generates the signature R and S. | 1oo%
 | Key Verify | ECC receives the hashed message, pubkey, and signature R and S, and validate the signature. | 1oo%
 | Reset Test | Assert reset while doing ECC operations | 1oo%
 | Zeroize | Assert zeroize | 1oo%
 | Interface | AHB-lite interface access validation | 1oo%
 | Registers I/O | Register rd/wr from crypto side and ahb-lite side | 1oo%
 | Other registers that get decoded to ECC | As Col.B says | 1oo%
 | Performance test | As Col.B says | 1oo%
 | Nightly regression with mbedlts checker enabled | Continual regression | 1oo%
 | Error conditions triggers and status | Validate crypto defined error conditions if any
HMAC DRBG
 | Reset Test | As Col.B says | 1oo%
 | Zeroize | Assert zeroize | 1oo%
 | Interface | AHB-lite interface access validation | 1oo%
 | Registers I/O | Register rd/wr from crypto side and ahb-lite side | 1oo%
 | Other registers that get decoded to ECC | As Col.B says | 1oo%
 | Performance test | As Col.B says | 1oo%
 | Nightly regression with mbedlts checker enabled | Continual regression | 1oo%
 | Error conditions triggers and status | Validate crypto defined error conditions if any
SHA384/512/256
 | Reset Test | As Col.B says | 1oo%
 | Zeroize | Assert zeroize | 1oo%
 | Interface | AHB-lite interface access validation | 1oo%
 | Registers I/O | Register rd/wr from crypto side and ahb-lite side | 1oo%
 | Other registers that get decoded to SHA384 | As Col.B says | 1oo%
 | Performance test | As Col.B says | 1oo%
 | Nightly regression with SHA checker enabled | Continual regression | 1oo%
 | Error conditions triggers and status | Validate crypto defined error conditions if any
KeyVault Flows |  |  |  |  | To be included in top level
 | UDS Flow (Cold boot UDS deobf runs, but on warm boot, even if the register bits are written, the flow itself should not be executed) | Also verifies obfuscation key behavior on latching only on powergood | 1oo%
 | FE Flow (Cold boot FE deobf runs, but on warm boot, even if the register bits are written, the flow itself should not be executed) | Same as above | 1oo%
 | HMAC | Crypto's usage of KV as a client and server | 1oo%
 | SHA | Crypto's usage of KV as a client and server | 1oo%
 | ECC Read/Write from KV | Crypto's usage of KV as a client and server | 1oo%
 | Lock, clear dest mask operation | KV function testing | 1oo%
 | Reset Test | As Col.B says | 1oo%
 | Interface | AHB-lite interface access validation | 1oo%
 | Registers I/O | Register rd/wr from crypto side and ahb-lite side | 1oo%
 | Error conditions triggers and status | Validate KV defined error conditions if any | 1oo%
PCR Vault Flows
 | PCR Extend | PCR extension functionality per PCR entry | 100%
 | PCR signing | PCR signing flow with KV7 key | 100%
 | PCR register properties & reset | Ensure lock attributes and reset attribute per PCR entry work correctly | 1oo%
Data Vault
 | Register access val (RW & lock aspects) |  | 100%
 | Register reset val (stickiness) |  | 100%
SoC Interface
 | Register access | Read/write tests to registers to ensure accesses aligns with read/write permissions defined in the spec. Validate CPTRA_RESET_REASON to ensure the WARM and FW_UPD_RESET bits are being appropriately set on the warm & fw_upd reset conditions | 100%
 | SoC to uC basic protocol | Verifies SoC to uC communication via mailbox | 1oo%
 | uC to SoC basic protocol | Verifies uC to SoC communication via mailbox | 100%
 | Arbitration Conflicts with both requests arising at the same time | uC and SOC access to mailbox happening concurrently, while one is using it. Mailbox is atomic | 1oo%
 | PAUSER based filtering | User A has a lock but user B targetting the registers User A has the lock and populating the data; User B is interleaving the data write requests; User A has the lock & poulated the data; User B tries to access the output User A does all the flow; User B tries to set execute User A does all the flow; User B tries to unlock If uC force unlock is implemented, test that out while SOC User has locked the mailbox and the flow is at various stages of the mailbox protocol | 1oo%
 | Mailbox being used by a different entity than the 'locking' entity | One of the cases above | 100%
 | Mailbox force-unlock in the middle of multiple commands | Needs more thought - this will almost certainly hang the test | 100%
 | Unaligned register writes | Register access are aligned to 32-bit boundary - unaligned access get force aligned by HW and return the data
 | Mailbox interrupt to UC flows | Mailbox lock req indication when uC has it locked Mailbox exec indication thru interrupt | 100%
 | Mailbox flows crossed with warm reset | Mailbox is at various stages of execution (lock, ready, data-in, exec, data-out, wait for unlock) and warm reset happens | 1oo%
 | Mailbox flows crossed with cold reset | Same as above with cold reset | 1oo%
 | Mailbox unperturbed under FW update reset | Same as above but mailbox & all registers should remain the same | 1oo%
 | Mailbox DLEN violation - DLEN larger than Mailbox |  | 100%
 | Mailbox DLEN violation - Sender writes more data than DLEN |  | 100%
 | Mailbox DLEN violation - Sender writes more data than Mailbox size |  | 100%
 | Mailbox DLEN violation - Receiver reads more data than DLEN |  | 100%
 | Mailbox DLEN violation - Receiver reads more data than Mailbox size |  | 100%
 | Mailbox DLEN violation - Receiver writes more response data than DLEN | --- need to include other variants of violating response data length requirement --- How is the response data length qualified? | 100%
 | Mailbox delay handling - Sender/Receiver injects random delays throughout mailbox procedure |  | 100%
 | Mailbox - sender tries to read dataout |  | 100%
 | Mailbox - receiver tries to write datain |  | 100%
 | Mailbox - Check data received by uC matches data sent by SoC |  | 100%
 | Mailbox - Check response data received by SoC matches data sent by uC |  | 100%
 | Mailbox - Check data received by SoC matches request data sent by uC |  | 100%
 | Mailbox - VERY small commands to test boundary conditions (2-8 bytes) |  | 100%
 | Mailbox - Contention accesses concurrent with ECC Error Injection on Mailbox SRAM | Excercises correctable error write-back cases when there is contention | 100%
 | Fuse register writes | Fuses are being written correctly, locked (example: UDS, FE) correctly post write for certain fuses; Warm reset can rewrite the fuses but no change should happen to fuses are locked. FUSE_WR_DONE should block the write of the fuses once that bit is set to '1. To reupdate the fuses, Caliptra FW should reset that bit to zero and then SOC can update Any update to In-field programmable (IFP) fuses inside caliptra fuse registers will require cold boot. Meaning all fuses except this are sticky. Note: At SOC & system level IFP fuses inside the physical fuse bank can be updated without a cold reset (that is outside of Caliptra RTL's implementation context). All fuses MUST be “LOCKED” on FUSE_WR_DONE and even IFPs after fuses are updated CANNOT be downloaded/written back into RTL. Implying they are write ONCE. FUSE_WR_DONE can be reset only on cold reset. All Caliptra fuses must be RO for Caliptra FW. uController should not be able to access certain fuse registers as defined in the register rdl and others are non-accessible | 1oo%
 | Fuse register unauthorized updates being dropped to WO fuses | See above line | 100%
 | Read of fuse registers must be blocked for unauthorized fuses (eg. UDS, FE etc.); Follow the arch spec | As decribed in col.B | 1oo%
 | Fuse register writes protected by CPTRA_FUSE_VALID_PAUSER | Programming CPTRA_FUSE_VALID_PAUSER register and locking it will prevent reads/writes to fuse block unless accessed by the authorized PAUSER.
 | Fuse register writes protected by CPTRA_FUSE_VALID_PAUSER integration param | Setting the integration parameter overrides programmability of CPTRA_FUSE_VALID_PAUSER register and prevents reads/writes to the fuse block unless accessed by the CPTRA_FUSE_VALID_PAUSER integration parameter.
 | FW Update flow with associated reset | Middle of FW update flow happening and a surpise warm reset happens; Expectation is we re-request the FW | 1oo%
 | FW Update flow and Key vault behavior | Locked keys must remain intact. No keys must be reset by HW. Must validate clear functionality as a part of KV val itself | 1oo%
 | FW Update flow and PCR vault behavior | Same as PCRs in terms of registers behavior | 80%
 | FW Update flow loads image to ICCM/DCCM without corruption | Check to confirm that contents loaded to ICCM/DCCM match input FW image | 1oo%
 | Security access controls change, key/asset flushing | Security state changes from non-debug to debug mode and security assets should be cleared; should be able REINIT the cryptos (using FW) before JTAG open is set; JTAG open by uController itself falls into JTAG functionality validation | 1oo%
 | Warm & Cold Reset and Key vault behavior | Warm reset: Locked keys must remain intact on warm reset. No keys must be reset by HW. Must validate clear functionality as a part of KV val itself Cold reset: Everything is cleared | 1oo%
 | Warm & Cold Reset and PCR vault behavior | Warm reset: Locked PCRs must remain intact on warm reset. No PCRs must be reset by HW (?). Unlocked PCRs clear behavior part of PCR val itself or thru ucontroller tests Cold reset: Everything is cleared | 1oo%
 | Security access controls change, key/asset flushing across warm & Cold resets | Warm Reset: See above but should try to change the security state while under warm reset and then deassert the reset and then check behavior | 1oo%
 | idle clock gating entry & exit | Generic wires causing clock ungating; Global clock disable; Enable only on the SOC register write; uController doing idle entry and exit autonomously; Entry is ALWAYS uC controlled if the SOC allows clk gating | 5o%
 | Boot flow | Boot flow as documetated in the arch spec | 1oo%
 | Warm reset flow | Basic assertion & deassertion while various flows are in progress | 1oo%
 | Crypto logic flush on security state transition | REINIT capability of the cryptos from HW POV (FW is expected to do this when security state transitioning happens) | 100% |  | Smoke test coverage for zeroize SV assertions to catch wrong behavior
 | TOP Interface input wires to interrupt trigger | GENERIC input wires being able to trigger interrupt on toggling | 100%
 | Arch & Fuse registers should be accessible even when the mailbox is in progress | Arch, Fuse register path thru APB should be independent of mailbox (Same with TRNG)
 | Test SHA acceleration HW API - cross it with mailbox flows from internal facing & SOC facing locks as well as access other registers during this process to ensure they progress appropriately with the right data/flow while SHA acceleration results match as expected | see Col.B - cross with FW update reset too
 | FW Update reset should ensure that SHA block is atomic to internal FW - or wait for the SHA operation to complete and give the round robin to FW if it has requested or about to request as a part of FW update reset | See col.B
 | SOC write to locked fuses get silently dropped | See col.B | 1oo%
 | Fuse rewrite on ready_for_fuse being written by the FW and bootFSM although transitions to BOOT_DONE again, none of the uController or others signals should be effected - No fuses should be updateable | See col.B | 50%
 | Mailbox data available read happening at the same time as a SOC register access | See col.B | 100%
 | TRNG REQ API Verification | TRNG REQ API should still be the same on FW update reset
 | Caliptra TOP level JTAG Validation | JTAG path for uController debug (able to inject any uController instruction; ability to read any of the AHB-lite registers that uC FW has permission to access) Unlock of JTAG from secured to debug should be ONLY on a FW write once uC is brought out of reset JTAG access to mailbox protocol and mailbox registers BootFSM break functionality to stop the BootFSM before uC is brought up on a warm or cold reset; In this condition, TAP debug, manuf as well as prod register should be writeable....FW will honor the register based on the security state. TAP GO command allows progress to bring uC out of reset after BootFSM break. | 50%
 | SOC-IFC interrupt register validation
RiscV Core (uC)
 | Exceptions | Esp. for AHB error return status
 | Interrupts |  | 1oo%
 | Timers | Being able to set and unset the timers; WD timer functionality to trigger FATAL
 | ICCM lock flow | Lock ICCM and unlock on a FW update reset, Warm reset, Cold reset Access ICCM just after ICCM lock reset but before reset assertion (cannot happen due to how code is, but still stress check) | 1oo%
 | ROM basic execution flow | uC out of reset -> exec ROM -> mailbox to ICCM and DCCM -> Execute -> again copy to ICCM and again execute | 1oo%
 | ICCM instruction execution with data population to DCCM | uC out of reset -> exec ROM -> mailbox to ICCM and DCCM -> Execute -> again copy to ICCM and again execute | 1oo%
 | Mailbox to ICCM Copy and Execute | uC out of reset -> exec ROM -> mailbox to ICCM and DCCM -> Execute -> again copy to ICCM and again execute | 1oo%
 | Mailbox to ICCM copy in two separate chunks (like FMC, RT) | uC out of reset -> exec ROM -> mailbox to ICCM and DCCM -> Execute -> again copy to ICCM and again execute | 1oo%
 | Mailbox to DCCM copy of data blob | uC out of reset -> exec ROM -> mailbox to ICCM and DCCM -> Execute -> again copy to ICCM and again execute | 1oo%
 | Mailbox to ICCM and DCCM copy; Execute ICCM; Lock ICCM; DMA Access ICCM and Cause NMI | As Col B says | 1oo%
 | Mailbox to ICCM and DCCM copy; Execute ICCM and write to DCCM; Lock ICCM; Execute ICCM and write to DCCM | As Col B says | 1oo%
 | Writing to error registers when ICCM/DCCM copy has a failure (exceptions?) | As Col B says
 | ICCM lock should be write once until a FW update reset happens | As Col B says
 | uC access to ROM on LSU/datapath | Basic val to access for ROM for data in addition to IFU path Conflicts b/w IFU B2B and LSU B2B access and stalling each other; LSU B2B access along with peripheral access | 1oo% |  | We need to check if there is any stress val to be additionally done here post 0p8
Internal Global
 | Internal register validation & coverage |  | 100%
 | per periphiral interrupt validation (interrupt enables/disables, status clearing, triggers) | NOTE: Some error interrupts unimplemented | 80%
 | reset domain validation |  | 50%
 | Output register/wire control validation
 | FW faulty interference on cryptos while key vault triggered flows are happening
 | NMI validation |  | 1oo%
 | Configuration validation w/ Negative testing | Accesses outside of peripheral space; accesses to ICCM/DCCM outside of the allocated space; access to mailbox SRAM outside of allocation space; accessing cryptos with wrong configuration/protocol
 | Fuse download |  | 1oo%
 | Subtractive decoding path testing |  | 1oo%
Error validation
 | SRAM ECC
 | uController has parity?
 | Crypto errors?
 | APB protocol errors?
 | AHB-lite errors?
 | Any FW triggered writes to signal fatal errors
 | WD (that needs petting) triggered error
AHB Decoder
 | Address decoding - global | As col.B says | 1oo%
 | Address decoding - peripherals internal | As col.B says | 1oo%
 | Non accessible decoding |  | 1oo% |  | Same as subtractive decoding path
UART (instrumentation) |  |  |  |  | Not production, primarily for debug
Verilator |  |  | 1oo%

Sheet: Stress Val
 |  | Take ownership ETA | Completion Requirement
Cross Product Val | Concurrent SOC reg accesses (APB), FW/AHB-facing reg access, Mailbox flows (APB), SHA (APB), GENERIC INPUT WIRES and TRNG (APB) all happening at the same time | 2023-05-30 | 2023-06-24 | Caleb
 | Security State and Scan state transitions at random times and causing KV/secrets to flush but JTAG is left locked | 2023-05-30 | 2023-06-24 | Kiran
 | Access Crypto registers from FW while signing/keygen are in progress with priv-keys | 2023-05-30 | 2023-06-24 | Mojtaba
 | Fatal error injection - warm reset - Caliptra back to normal operating state | 2023-05-30 | 2023-06-24 | Caleb | DONE smoke_test_ras
 | ICCM ECC/DCCM ECC - warm reset - Caliptra will NOT be back to normal operating state | 2023-05-30 | 2023-06-24 | Caleb
 | Mailbox ECC - warm reset - Caliptra will be back to normal operating state | 2023-05-30 | 2023-06-24 | Caleb
 | Non-DW aligned & Small DW mailbox input or output (0-3 bytes of length) | 2023-05-30 | 2023-06-24 | Caleb
 | Any Flows X warm reset | 2023-05-30 | 2023-06-24 | Mike or Caleb or Kiran
 | Hitless update X warm reset | 2023-05-30 | 2023-06-24 | Mike or Caleb or Kiran
 | B2B mailbox request flows b/w SOC entities (as in mailbox unlocked and the next cycle mailbox locked) | 2023-05-30 | 2023-06-24 | Caleb
 | B2B mailbox request flows b/w SOC entity & Caliptra FW (as in mailbox unlocked and the next cycle mailbox locked) | 2023-05-30 | 2023-06-24 | Caleb
 | Core in sleep X Fatal error injection (directly on the logic) -> warm reset -> should go back to normal state | 2023-05-30 | 2023-06-24 | Kiran | DONE
 | Core in sleep X FW-waking flows (SOC->FW mailbox or Generic input wires->FW or SOC->Timer mailbox) | 2023-05-30 | 2023-06-24 | Kiran | DONE
 | Core in sleep and WDT is incrementing and firing | 2023-05-30 | 2023-06-24 | Kiran | DONE
 | Open item: Should HW clear KV on FATAL ERROR? | 2023-05-30 | 2023-06-24 | Mojtaba
 | Security State/Scan switches in run-time while in sleep state - this should still flush the KV - need to check | 2023-05-30 | 2023-06-24 | Kiran | DONE
 | FW Update reset X warm reset - if FW Update is in the middle, then post warm reset we will hang when a given service is requested. Ideally, ROM should know that the FW update reset was not completed in their "RAS" implementation | 2023-05-30 | 2023-06-24 | Mike or Caleb or Kiran
 | FW_UPD_RESET resets some register bits - we need to ensure we have coverage on this to see that they are resetting to their reset values | 2023-05-30 | 2023-06-24 | Mike or Caleb or Kiran
ECC | Assert cold/warm reset, and lock while doing ECC | 2023-05-30 | 2023-06-24 | Kiran or Mojtaba
 | Assert PCR cmd while doing ECC | 2023-05-30 | 2023-06-24 | Kiran or Mojtaba
 | Assert lock during ECC-KV interface | 2023-05-30 | 2023-06-24 | Kiran or Mojtaba
 | Asserting zeroize when ECC is writing to KV to inject known key value 0 to KV | 2023-05-30 | 2023-06-24 | Kiran or Mojtaba
 | KV 7 should be used ONLY for PCR signing and cannot be used for any arbitratry message; if KV7 is locked for PCR signing only, then any other usage causes read error | 2023-05-30 | 2023-06-24 | Kiran or Mojtaba
AHB Decoder
 | Address decoding - global | 2023-05-30 | 2023-06-24 | Mike
 | Address decoding - peripherals internal | 2023-05-30 | 2023-06-24 | Mike
 | Non accessible decoding | 2023-05-30 | 2023-06-24 | Mike
 | AHB 2:1 mux stall cases | 2023-05-30 | 2023-06-24 | Mike
SOC IFC Registers | Capture differences in fuse registers for life-cycle and security states | 2023-05-30 | 2023-06-24 | Mahmud
 | Ensure every RO field(that is controlled only by non-bus wires) reflect values correctly | 2023-05-30 | 2023-06-24 | Mahmud
 | Ensure all control fields made to wiggle and cross-register values checked (eg, PAUSER states) | 2023-05-30 | 2023-06-24 | Mahmud
 | Establish how many cycles after an AHB write is a read over APB visible and vice versa (upper bound) | 2023-05-30 | 2023-06-24 | Mahmud
 | Ensure that all races between AHB and APB writes to the same register or related register that can be cross triggered are tested | 2023-05-30 | 2023-06-24 | Mahmud
 | Ensure self-clearing registers do clear within stated windows (eg single cycle pulses) | 2023-05-30 | 2023-06-24 | Mahmud

Sheet: KV Coverage
IO Coverage | Description | Coverage type | Status | Tested?
rst_b |  | coverpoint | DONE | Y
core_only_rst_b |  | coverpoint | DONE | Y
cptra_pwrgood |  | coverpoint | DONE | Y
debugUnlock_or_scan_mode_switch |  | coverpoint | DONE | Y
debugUnlock_or_scan_mode_switch | Regs flushed while JTAG is locked | Assertion
AHB IOs | Covered through Mike's ahb_slv_if covergroup | coverpoint | DONE | Y
kv_write (incl dest_valid) | all entries, all offsets, 0/1 on all write_data bits, 0/1 on all dest_valids | coverpoint | DONE | Y
kv_read | all entries, all offsets | coverpoint | DONE | Y
kv_wr_resp | 0/1 on error | coverpoint | DONE | Y
kv_rd_resp | 0/1 on all read_data bits, 0/1 on last and error bits | coverpoint | DONE | Y
pcr_signing_key | Can be any entry, but its corresponding KEY_ENTRY dest_valid must be 0 | Assertion |  |  | Wait on this
Register Coverage | Description | Coverage type | Status | Tested?
lock_wr |  | coverpoint | DONE | Y
lock_use |  | coverpoint | DONE | Y
clear |  | coverpoint | DONE | Y
dest_valid hwclr | Toggles when clear is set and locks are 0 Covered through locks and clear | coverpoint | DONE | Y
last_dword | 0-11 values | coverpoint | DONE | Y
last_dword hwclr | Toggles when clear is set and locks are 0 Covered through locks and clear | coverpoint | DONE | Y
clear_secrets | Values: 0, 1, 2, 3 | coverpoint | DONE | Y
Cross coverage | Description | Coverage type | Status | Tested?
AHB X kv_write | AHB read & write while a crypto is writing to KV | coverpoint | DONE |  | Might give UVM errors since registers might be accessed at the same time with this test
AHB X kv_read | AHB read & write while a crypto is reading from KV Reads are asynchronous so it might not be useful/interesting to have this coverpoint | coverpoint
AHB X debug | AHB read & write while debug mode is unlocked | coverpoint | DONE
debug X warm rst | Debug mode unlocked during warm rst | coverpoint | DONE | Y
debug X cold rst | Debug mode unlocked during cold rst | coverpoint | DONE | Y
debug X core rst | Debug mode unlocked during core rst | coverpoint | DONE | Y
debug X lock_wr | Effect of debug mode unlock on locked regs | coverpoint | DONE | Y
debug X lock_use | Effect of debug mode unlock on locked regs | coverpoint | DONE | Y
debug X clear | Effect of debug mode unlock on cleared regs | coverpoint | DONE | Y
debug X clear_secrets |  | coverpoint | DONE
locks X warm rst |  | coverpoint | DONE | Y
locks X cold rst |  | coverpoint | DONE | Y
locks X core only rst |  | coverpoint | DONE | Y
locks X clear_secrets |  | coverpoint | DONE | Y
clear X warm rst |  | coverpoint | DONE | Y
clear X cold rst |  | coverpoint | DONE | Y
clear X core only rst |  | coverpoint | DONE | Y
clear X clear_secrets |  | coverpoint | DONE
clear_secrets => warm rst | Regs are flushed since at the time of clear_secrets, there's no rst | coverproperty | DONE | Y
locks => clear_secrets => warm rst | Locks get reset but flush would not go through (since at the time of flush, locks were still in place and rstb = 1) | coverproperty | DONE | Y
locks X kv_write/kv_read | Reads are asynchronous so it might not be useful/interesting to have coverpoint for locks X kv_read | coverpoint | DONE | Y
clear X kv_write/rd | Reads are asynchronous so it might not be useful/interesting to have coverpoint for locks X kv_read | coverpoint | DONE | Y
clear_secrets X kv_write/rd | Reads are asynchronous so it might not be useful/interesting to have coverpoint for locks X kv_read | coverpoint | DONE | Y
dest_valid X kv_read | Reads are asynchronous so it might not be useful/interesting to have coverpoint for locks X kv_read dest_valid is covered in register cov | coverpoint | DONE | Y
last X offset | Make sure last triggers for offsets other than 11 | coverpoint | DONE
lock_wr X lock_use X clear |  | coverpoint | DONE

Sheet: PV Coverage
IO Coverage | Description | Coverage type | Status | Tested?
rst_b |  | coverpoint | DONE | Y | Modify covergroup to look for transition instead of values
cptra_pwrgood |  | coverpoint | DONE | Y
AHB IOs |  | coverpoint |  | Y
pv_write | all entries, all offsets, 0/1 on all write_data bits | coverpoint | DONE | Y
pv_read | all entries, all offsets | coverpoint | DONE | Y
pv_wr_resp | 0 on error | coverpoint | DONE | Y
pv_rd_resp | 0/1 on all read_data bits, 0/1 on last and 0 on error bit | coverpoint | DONE | Y
Register Coverage | Description | Coverage type | Status | Tested?
lock |  | coverpoint | DONE | Y
clear |  | coverpoint | DONE | Y
Cross coverage | Description | Coverage type | Status | Tested?
AHB X pv_write | AHB read & write while a crypto is writing to KV | coverpoint | DONE
AHB X pv_read | AHB read & write while a crypto is reading from KV Reads are asynchronous so it might not be useful to have this coverpoint | coverpoint
clear => warm rst | Regs cleared before rst assertion | coverproperty | DONE | Y
lock => clear => warm rst | Regs should not change | coverproperty | DONE | Y
lock => clear => cold rst | Regs reset to 0, lock/clear reset to 0 | coverproperty | DONE
lock X warm rst |  | coverpoint | DONE
lock X cold rst |  | coverpoint | DONE
clear X warm rst |  | coverpoint | DONE
clear X cold rst |  | coverpoint | DONE
lock X clear |  | coverpoint | DONE
last X offset | Make sure last triggers for offsets other than 11 | coverpoint | DONE
lock X pv write |  | coverpoint | DONE
clear X pv write |  | coverpoint | DONE

Sheet: SOC IFC Coverage
IO Coverage | Description | Coverage type | Status | Tested?
cptra_pwrgood |  | coverpoint | DONE
cptra_rst_b |  | coverpoint | DONE
cptra_noncore_rst_b |  | coverpoint | DONE
cptra_uc_rst_b |  | coverpoint | DONE
fw_update_rst_window |  | coverpoint | NOT DONE | no
clk_gating_en |  | coverpoint | DONE
security_state |  | coverpoint | DONE
scan_mode_f |  | coverpoint | DONE
ready_for_fuses |  | coverpoint | DONE
ready_for_fw_push |  | coverpoint | DONE
ready_for_runtime |  | coverpoint | DONE
mailbox_data_avail |  | coverpoint | DONE
mailbox_flow_done |  | coverpoint | DONE
cptra_error_fatal |  | coverpoint | DONE
cptra_error_non_fatal |  | coverpoint | DONE
trng_req |  | coverpoint | DONE
BootFSM_BrkPoint |  | coverpoint | DONE
generic_input_wires |  | coverpoint | DONE
generic_output_wires |  | coverpoint | DONE
nmi_vector |  | coverpoint | DONE
nmi_intr |  | coverpoint | DONE
soc_ifc_error_intr |  | coverpoint | DONE
soc_ifc_notif_intr |  | coverpoint | DONE
sha_error_intr |  | coverpoint | DONE
sha_notif_intr |  | coverpoint | DONE
timer_intr | no signal? |  | NOT DONE
mbox_sram_req |  | coverpoint | DONE
mbox_sram_resp |  | coverpoint | DONE
rv_ecc_sts |  |  | NOT DONE
clear_obf_secrets |  | coverpoint | DONE
cptra_obf_key |  | coverpoint | DONE
cptra_obf_key_reg |  | coverpoint | DONE
obf_field_entropy |  | coverpoint | DONE
obf_uds_seed |  | coverpoint | DONE
iccm_lock |  | coverpoint | DONE
iccm_axs_blocked |  | coverpoint | DONE
APB I/F
AHB I/F
JTAG I/F
Register Coverage | Description | Coverage type | Status | Tested?
MBOX_CSR.MBOX_LOCK.LOCK |  | coverpoint
MBOX_CSR.MBOX_USER |  | coverpoint
MBOX_CSR.MBOX_CMD |  | coverpoint
MBOX_CSR.MBOX_DLEN |  | coverpoint
MBOX_CSR.MBOX_DATAIN |  | coverpoint
MBOX_CSR.MBOX_DATAOUT |  | coverpoint
MBOX_CSR.MBOX_EXECUTE.EXECUTE |  | coverpoint
MBOX_CSR.MBOX_STATUS.STATUS
MBOX_CSR.MBOX_STATUS.ECC_SINGLE_ERROR
MBOX_CSR.MBOX_STATUS.ECC_DOUBLE_ERROR
MBOX_CSR.MBOX_STATUS.MBOX_FSM_PS
MBOX_CSR.MBOX_STATUS.SOC_HAS_LOCK
MBOX_CSR.MBOX_UNLOCK.UNLOCK
SHA512_ACC_CSR.LOCK.LOCK
SHA512_ACC_CSR.USER
SHA512_ACC_CSR.MODE.MODE
SHA512_ACC_CSR.MODE.ENDIAN_TOGGLE
SHA512_ACC_CSR.START_ADDRESS
SHA512_ACC_CSR.DLEN
SHA512_ACC_CSR.EXECUTE.EXECUTE
SHA512_ACC_CSR.STATUS.VALID
SHA512_ACC_CSR.DIGEST_0_15
SHA512_ACC_CSR.CONTROL.ZEROIZE
SHA512_ACC_CSR.INTR_BLOCK_RF.GLOBAL_INTR_EN_R.ERROR_EN
SHA512_ACC_CSR.INTR_BLOCK_RF.GLOBAL_INTR_EN_R.NOTIF_EN
SHA512_ACC_CSR.INTR_BLOCK_RF.ERROR_INTR_EN_R.ERROR0_EN
SHA512_ACC_CSR.INTR_BLOCK_RF.ERROR_INTR_EN_R.ERROR1_EN
SHA512_ACC_CSR.INTR_BLOCK_RF.ERROR_INTR_EN_R.ERROR2_EN
SHA512_ACC_CSR.INTR_BLOCK_RF.ERROR_INTR_EN_R.ERROR3_EN
SHA512_ACC_CSR.INTR_BLOCK_RF.NOTIF_INTR_EN_R.NOTIF_CMD_DONE_EN
SHA512_ACC_CSR.INTR_BLOCK_RF.ERROR_GLOBAL_INTR_R.AGG_STS
SHA512_ACC_CSR.INTR_BLOCK_RF.NOTIF_GLOBAL_INTR_R.AGG_STS
SHA512_ACC_CSR.INTR_BLOCK_RF.ERROR_INTERNAL_INTR_R.ERROR0_STS
SHA512_ACC_CSR.INTR_BLOCK_RF.ERROR_INTERNAL_INTR_R.ERROR1_STS
SHA512_ACC_CSR.INTR_BLOCK_RF.ERROR_INTERNAL_INTR_R.ERROR2_STS
SHA512_ACC_CSR.INTR_BLOCK_RF.ERROR_INTERNAL_INTR_R.ERROR3_STS
SHA512_ACC_CSR.INTR_BLOCK_RF.NOTIF_INTERNAL_INTR_R.NOTIF_CMD_DONE_STS
SHA512_ACC_CSR.INTR_BLOCK_RF.ERROR_INTR_TRIG_R.ERROR0_TRIG
SHA512_ACC_CSR.INTR_BLOCK_RF.ERROR_INTR_TRIG_R.ERROR1_TRIG
SHA512_ACC_CSR.INTR_BLOCK_RF.ERROR_INTR_TRIG_R.ERROR2_TRIG
SHA512_ACC_CSR.INTR_BLOCK_RF.ERROR_INTR_TRIG_R.ERROR3_TRIG
SHA512_ACC_CSR.INTR_BLOCK_RF.NOTIF_INTR_TRIG_R.NOTIF_CMD_DONE_TRIG
SHA512_ACC_CSR.INTR_BLOCK_RF.ERROR0_INTR_COUNT_R
SHA512_ACC_CSR.INTR_BLOCK_RF.ERROR1_INTR_COUNT_R
SHA512_ACC_CSR.INTR_BLOCK_RF.ERROR2_INTR_COUNT_R
SHA512_ACC_CSR.INTR_BLOCK_RF.ERROR3_INTR_COUNT_R
SHA512_ACC_CSR.INTR_BLOCK_RF.NOTIF_CMD_DONE_INTR_COUNT_R
SHA512_ACC_CSR.INTR_BLOCK_RF.ERROR0_INTR_COUNT_INCR_R.PULSE
SHA512_ACC_CSR.INTR_BLOCK_RF.ERROR1_INTR_COUNT_INCR_R.PULSE
SHA512_ACC_CSR.INTR_BLOCK_RF.ERROR2_INTR_COUNT_INCR_R.PULSE
SHA512_ACC_CSR.INTR_BLOCK_RF.ERROR3_INTR_COUNT_INCR_R.PULSE
SHA512_ACC_CSR.INTR_BLOCK_RF.NOTIF_CMD_DONE_INTR_COUNT_INCR_R.PULSE
SOC_IFC_REG.CPTRA_HW_ERROR_FATAL |  |  |  | Y
SOC_IFC_REG.CPTRA_HW_ERROR_NON_FATAL |  |  |  | Y
SOC_IFC_REG.CPTRA_FW_ERROR_FATAL |  |  |  | Y
SOC_IFC_REG.CPTRA_FW_ERROR_NON_FATAL |  |  |  | Y
SOC_IFC_REG.CPTRA_HW_ERROR_ENC |  |  |  | Y
SOC_IFC_REG.CPTRA_FW_ERROR_ENC |  |  |  | Y
SOC_IFC_REG.CPTRA_FW_EXTENDED_ERROR_INFO_0_7 |  |  |  | Y
SOC_IFC_REG.CPTRA_BOOT_STATUS |  |  |  | Y
SOC_IFC_REG.CPTRA_FLOW_STATUS.STATUS |  |  |  | Y
SOC_IFC_REG.CPTRA_FLOW_STATUS.READY_FOR_FW |  |  |  | Y
SOC_IFC_REG.CPTRA_FLOW_STATUS.READY_FOR_RUNTIME |  |  |  | Y
SOC_IFC_REG.CPTRA_FLOW_STATUS.READY_FOR_FUSES |  |  |  | Y
SOC_IFC_REG.CPTRA_FLOW_STATUS.MAILBOX_FLOW_DONE |  |  |  | Y
SOC_IFC_REG.CPTRA_RESET_REASON.FW_UPD_RESET |  |  |  | Y
SOC_IFC_REG.CPTRA_RESET_REASON.WARM_RESET |  |  |  | Y
SOC_IFC_REG.CPTRA_SECURITY_STATE.DEVICE_LIFECYCLE |  |  |  | Y
SOC_IFC_REG.CPTRA_SECURITY_STATE.DEBUG_LOCKED |  |  |  | Y
SOC_IFC_REG.CPTRA_SECURITY_STATE.SCAN_MODE |  |  |  | Y
SOC_IFC_REG.CPTRA_MBOX_VALID_PAUSER_0_4 |  |  |  | Y
SOC_IFC_REG.CPTRA_MBOX_PAUSER_LOCK_0_4.LOCK |  |  |  | Y
SOC_IFC_REG.CPTRA_TRNG_VALID_PAUSER
SOC_IFC_REG.CPTRA_TRNG_PAUSER_LOCK.LOCK |  |  |  | Y
SOC_IFC_REG.CPTRA_TRNG_DATA_0_11
SOC_IFC_REG.CPTRA_TRNG_STATUS.DATA_REQ |  |  |  | Y
SOC_IFC_REG.CPTRA_TRNG_STATUS.DATA_WR_DONE |  |  |  | Y
SOC_IFC_REG.CPTRA_FUSE_WR_DONE.DONE |  |  |  | Y
SOC_IFC_REG.CPTRA_TIMER_CONFIG |  |  |  | Y
SOC_IFC_REG.CPTRA_BOOTFSM_GO.GO |  |  |  | Y
SOC_IFC_REG.CPTRA_DBG_MANUF_SERVICE_REG |  |  |  | Y
SOC_IFC_REG.CPTRA_CLK_GATING_EN.CLK_GATING_EN |  |  |  | Y
SOC_IFC_REG.CPTRA_GENERIC_INPUT_WIRES_0_1 |  |  |  | Y
SOC_IFC_REG.CPTRA_GENERIC_OUTPUT_WIRES_0_1 |  |  |  | Y
SOC_IFC_REG.CPTRA_HW_REV_ID |  |  |  | Y
SOC_IFC_REG.CPTRA_FW_REV_ID_0_1 |  |  |  | Y
SOC_IFC_REG.CPTRA_HW_CONFIG.ITRNG_EN |  |  |  | Y
SOC_IFC_REG.CPTRA_HW_CONFIG.QSPI_EN |  |  |  | Y
SOC_IFC_REG.CPTRA_HW_CONFIG.I3C_EN |  |  |  | Y
SOC_IFC_REG.CPTRA_WDT_TIMER1_EN.TIMER1_EN |  |  |  | Y
SOC_IFC_REG.CPTRA_WDT_TIMER1_CTRL.TIMER1_RESTART |  |  |  | Y
SOC_IFC_REG.CPTRA_WDT_TIMER1_TIMEOUT_PERIOD_0_1 |  |  |  | Y
SOC_IFC_REG.CPTRA_WDT_TIMER2_EN.TIMER2_EN |  |  |  | Y
SOC_IFC_REG.CPTRA_WDT_TIMER2_CTRL.TIMER2_RESTART |  |  |  | Y
SOC_IFC_REG.CPTRA_WDT_TIMER2_TIMEOUT_PERIOD_0_1 |  |  |  | Y
SOC_IFC_REG.CPTRA_WDT_STATUS.T1_TIMEOUT |  |  |  | Y
SOC_IFC_REG.CPTRA_WDT_STATUS.T2_TIMEOUT |  |  |  | Y
SOC_IFC_REG.FUSE_UDS_SEED_0_11 |  |  |  | Y
SOC_IFC_REG.FUSE_FIELD_ENTROPY_0_7 |  |  |  | Y
SOC_IFC_REG.FUSE_KEY_MANIFEST_PK_HASH_0_11 |  |  |  | Y
SOC_IFC_REG.FUSE_KEY_MANIFEST_PK_HASH_MASK.MASK |  |  |  | Y
SOC_IFC_REG.FUSE_OWNER_PK_HASH_0_11 |  |  |  | Y
SOC_IFC_REG.FUSE_FMC_KEY_MANIFEST_SVN |  |  |  | Y
SOC_IFC_REG.FUSE_RUNTIME_SVN_0_3 |  |  |  | Y
SOC_IFC_REG.FUSE_ANTI_ROLLBACK_DISABLE.DIS |  |  |  | Y
SOC_IFC_REG.FUSE_IDEVID_CERT_ATTR_0_23 |  |  |  | Y
SOC_IFC_REG.FUSE_IDEVID_MANUF_HSM_ID_0_3 |  |  |  | Y
SOC_IFC_REG.FUSE_LIFE_CYCLE.LIFE_CYCLE |  |  |  | Y
SOC_IFC_REG.INTERNAL_OBF_KEY_0_7 |  |  |  | Y
SOC_IFC_REG.INTERNAL_ICCM_LOCK.LOCK |  |  |  | Y
SOC_IFC_REG.INTERNAL_FW_UPDATE_RESET.CORE_RST |  |  |  | Y
SOC_IFC_REG.INTERNAL_FW_UPDATE_RESET_WAIT_CYCLES.WAIT_CYCLES |  |  |  | Y
SOC_IFC_REG.INTERNAL_NMI_VECTOR |  |  |  | Y
TBD: mask
TBD: mask
TBD: mask
TBD: mask
TBD: mtime
TBD: mtime
TBD: mtime
TBD: mtime
SOC_IFC_REG.INTR_BLOCK_RF.GLOBAL_INTR_EN_R.ERROR_EN
SOC_IFC_REG.INTR_BLOCK_RF.GLOBAL_INTR_EN_R.NOTIF_EN
SOC_IFC_REG.INTR_BLOCK_RF.ERROR_INTR_EN_R.ERROR_INTERNAL_EN
SOC_IFC_REG.INTR_BLOCK_RF.ERROR_INTR_EN_R.ERROR_INV_DEV_EN
SOC_IFC_REG.INTR_BLOCK_RF.ERROR_INTR_EN_R.ERROR_CMD_FAIL_EN
SOC_IFC_REG.INTR_BLOCK_RF.ERROR_INTR_EN_R.ERROR_BAD_FUSE_EN
SOC_IFC_REG.INTR_BLOCK_RF.ERROR_INTR_EN_R.ERROR_ICCM_BLOCKED_EN
SOC_IFC_REG.INTR_BLOCK_RF.ERROR_INTR_EN_R.ERROR_MBOX_ECC_UNC_EN
SOC_IFC_REG.INTR_BLOCK_RF.ERROR_INTR_EN_R.ERROR_WDT_TIMER1_TIMEOUT_EN
SOC_IFC_REG.INTR_BLOCK_RF.ERROR_INTR_EN_R.ERROR_WDT_TIMER2_TIMEOUT_EN
SOC_IFC_REG.INTR_BLOCK_RF.NOTIF_INTR_EN_R.NOTIF_CMD_AVAIL_EN
SOC_IFC_REG.INTR_BLOCK_RF.NOTIF_INTR_EN_R.NOTIF_MBOX_ECC_COR_EN
SOC_IFC_REG.INTR_BLOCK_RF.NOTIF_INTR_EN_R.NOTIF_DEBUG_LOCKED_EN
SOC_IFC_REG.INTR_BLOCK_RF.NOTIF_INTR_EN_R.NOTIF_SOC_REQ_LOCK_EN
SOC_IFC_REG.INTR_BLOCK_RF.ERROR_GLOBAL_INTR_R.AGG_STS
SOC_IFC_REG.INTR_BLOCK_RF.NOTIF_GLOBAL_INTR_R.AGG_STS
SOC_IFC_REG.INTR_BLOCK_RF.ERROR_INTERNAL_INTR_R.ERROR_INTERNAL_STS
SOC_IFC_REG.INTR_BLOCK_RF.ERROR_INTERNAL_INTR_R.ERROR_INV_DEV_STS
SOC_IFC_REG.INTR_BLOCK_RF.ERROR_INTERNAL_INTR_R.ERROR_CMD_FAIL_STS
SOC_IFC_REG.INTR_BLOCK_RF.ERROR_INTERNAL_INTR_R.ERROR_BAD_FUSE_STS
SOC_IFC_REG.INTR_BLOCK_RF.ERROR_INTERNAL_INTR_R.ERROR_ICCM_BLOCKED_STS
SOC_IFC_REG.INTR_BLOCK_RF.ERROR_INTERNAL_INTR_R.ERROR_MBOX_ECC_UNC_STS
SOC_IFC_REG.INTR_BLOCK_RF.ERROR_INTERNAL_INTR_R.ERROR_WDT_TIMER1_TIMEOUT_STS
SOC_IFC_REG.INTR_BLOCK_RF.ERROR_INTERNAL_INTR_R.ERROR_WDT_TIMER2_TIMEOUT_STS
SOC_IFC_REG.INTR_BLOCK_RF.NOTIF_INTERNAL_INTR_R.NOTIF_CMD_AVAIL_STS
SOC_IFC_REG.INTR_BLOCK_RF.NOTIF_INTERNAL_INTR_R.NOTIF_MBOX_ECC_COR_STS
SOC_IFC_REG.INTR_BLOCK_RF.NOTIF_INTERNAL_INTR_R.NOTIF_DEBUG_LOCKED_STS
SOC_IFC_REG.INTR_BLOCK_RF.NOTIF_INTERNAL_INTR_R.NOTIF_SOC_REQ_LOCK_STS
SOC_IFC_REG.INTR_BLOCK_RF.ERROR_INTR_TRIG_R.ERROR_INTERNAL_TRIG
SOC_IFC_REG.INTR_BLOCK_RF.ERROR_INTR_TRIG_R.ERROR_INV_DEV_TRIG
SOC_IFC_REG.INTR_BLOCK_RF.ERROR_INTR_TRIG_R.ERROR_CMD_FAIL_TRIG
SOC_IFC_REG.INTR_BLOCK_RF.ERROR_INTR_TRIG_R.ERROR_BAD_FUSE_TRIG
SOC_IFC_REG.INTR_BLOCK_RF.ERROR_INTR_TRIG_R.ERROR_ICCM_BLOCKED_TRIG
SOC_IFC_REG.INTR_BLOCK_RF.ERROR_INTR_TRIG_R.ERROR_MBOX_ECC_UNC_TRIG
SOC_IFC_REG.INTR_BLOCK_RF.ERROR_INTR_TRIG_R.ERROR_WDT_TIMER1_TIMEOUT_TRIG
SOC_IFC_REG.INTR_BLOCK_RF.ERROR_INTR_TRIG_R.ERROR_WDT_TIMER2_TIMEOUT_TRIG
SOC_IFC_REG.INTR_BLOCK_RF.NOTIF_INTR_TRIG_R.NOTIF_CMD_AVAIL_TRIG
SOC_IFC_REG.INTR_BLOCK_RF.NOTIF_INTR_TRIG_R.NOTIF_MBOX_ECC_COR_TRIG
SOC_IFC_REG.INTR_BLOCK_RF.NOTIF_INTR_TRIG_R.NOTIF_DEBUG_LOCKED_TRIG
SOC_IFC_REG.INTR_BLOCK_RF.NOTIF_INTR_TRIG_R.NOTIF_SOC_REQ_LOCK_TRIG
SOC_IFC_REG.INTR_BLOCK_RF.ERROR_INTERNAL_INTR_COUNT_R
SOC_IFC_REG.INTR_BLOCK_RF.ERROR_INV_DEV_INTR_COUNT_R
SOC_IFC_REG.INTR_BLOCK_RF.ERROR_CMD_FAIL_INTR_COUNT_R
SOC_IFC_REG.INTR_BLOCK_RF.ERROR_BAD_FUSE_INTR_COUNT_R
SOC_IFC_REG.INTR_BLOCK_RF.ERROR_ICCM_BLOCKED_INTR_COUNT_R
SOC_IFC_REG.INTR_BLOCK_RF.ERROR_MBOX_ECC_UNC_INTR_COUNT_R
SOC_IFC_REG.INTR_BLOCK_RF.ERROR_WDT_TIMER1_TIMEOUT_INTR_COUNT_R
SOC_IFC_REG.INTR_BLOCK_RF.ERROR_WDT_TIMER2_TIMEOUT_INTR_COUNT_R
SOC_IFC_REG.INTR_BLOCK_RF.NOTIF_CMD_AVAIL_INTR_COUNT_R
SOC_IFC_REG.INTR_BLOCK_RF.NOTIF_MBOX_ECC_COR_INTR_COUNT_R
SOC_IFC_REG.INTR_BLOCK_RF.NOTIF_DEBUG_LOCKED_INTR_COUNT_R
SOC_IFC_REG.INTR_BLOCK_RF.NOTIF_SOC_REQ_LOCK_INTR_COUNT_R
SOC_IFC_REG.INTR_BLOCK_RF.ERROR_INTERNAL_INTR_COUNT_INCR_R.PULSE
SOC_IFC_REG.INTR_BLOCK_RF.ERROR_INV_DEV_INTR_COUNT_INCR_R.PULSE
SOC_IFC_REG.INTR_BLOCK_RF.ERROR_CMD_FAIL_INTR_COUNT_INCR_R.PULSE
SOC_IFC_REG.INTR_BLOCK_RF.ERROR_BAD_FUSE_INTR_COUNT_INCR_R.PULSE
SOC_IFC_REG.INTR_BLOCK_RF.ERROR_ICCM_BLOCKED_INTR_COUNT_INCR_R.PULSE
SOC_IFC_REG.INTR_BLOCK_RF.ERROR_MBOX_ECC_UNC_INTR_COUNT_INCR_R.PULSE
SOC_IFC_REG.INTR_BLOCK_RF.ERROR_WDT_TIMER1_TIMEOUT_INTR_COUNT_INCR_R.PULSE
SOC_IFC_REG.INTR_BLOCK_RF.ERROR_WDT_TIMER2_TIMEOUT_INTR_COUNT_INCR_R.PULSE
SOC_IFC_REG.INTR_BLOCK_RF.NOTIF_CMD_AVAIL_INTR_COUNT_INCR_R.PULSE
SOC_IFC_REG.INTR_BLOCK_RF.NOTIF_MBOX_ECC_COR_INTR_COUNT_INCR_R.PULSE
SOC_IFC_REG.INTR_BLOCK_RF.NOTIF_DEBUG_LOCKED_INTR_COUNT_INCR_R.PULSE
SOC_IFC_REG.INTR_BLOCK_RF.NOTIF_SOC_REQ_LOCK_INTR_COUNT_INCR_R.PULSE
TBD: New LMS fuse?
Cross coverage | Description | Coverage type | Status | Tested?
Register access |  | coverpoint
SoC to uC basic protocol |  | coverpoint
uC to SoC basic protocol |  | coverpoint
Arbitration Conflicts with both requests arising at the same time |  | coverpoint
PAUSER based filtering |  | coverpoint
Mailbox being used by a different entity than the 'locking' entity |  | coverpoint
Mailbox force-unlock in the middle of multiple commands |  | coverpoint
Unaligned register writes |  | coverpoint
Mailbox interrupt to UC flows |  | coverpoint
Mailbox flows crossed with warm reset |  | coverpoint
Mailbox flows crossed with cold reset |  | coverpoint
Mailbox unperturbed under FW update reset |  | coverpoint
Mailbox DLEN violation - DLEN larger than Mailbox | dlen_gt_mbox_size_cp | coverpoint | DONE
Mailbox DLEN violation - Sender writes more data than DLEN | req_wrptr_gt_dlen_cp | coverpoint | DONE
Mailbox DLEN violation - Sender writes more data than Mailbox size | wrptr_rollover_cp - can't actually roll over, but detect when we try to | coverpoint | DONE
Mailbox DLEN violation - Receiver reads more data than DLEN | rdptr_gt_dlen_cp - can't actually read more than dlen but detect when we try to | coverpoint | DONE
Mailbox DLEN violation - Receiver reads more data than Mailbox size | rdptr_rollover_cp - can't actually roll over, but detect when we try to | coverpoint | DONE
Mailbox DLEN violation - Receiver writes more response data than DLEN | resp_wrptr_gt_dlen_cp | coverpoint | DONE
Mailbox delay handling - Sender/Receiver injects random delays throughout mailbox procedure |  | coverpoint
Mailbox - sender tries to read dataout |  | coverpoint
Mailbox - receiver tries to write datain
Mailbox - Check data received by uC matches data sent by SoC
Mailbox - Check response data received by SoC matches data sent by uC
Mailbox - Check data received by SoC matches request data sent by uC
Mailbox - VERY small commands to test boundary conditions (2-8 bytes)
Fuse register writes
Fuse register unauthorized updates being dropped to WO fuses
Read of fuse registers must be blocked for unauthorized fuses (eg. UDS, FE etc.); Follow the arch spec
FW Update flow with associated reset
FW Update flow and Key vault behavior
FW Update flow and PCR vault behavior
FW Update flow loads image to ICCM/DCCM without corruption
Security access controls change, key/asset flushing
Warm & Cold Reset and Key vault behavior
Warm & Cold Reset and PCR vault behavior
Security access controls change, key/asset flushing across warm & Cold resets
idle clock gating entry & exit
Boot flow
Warm reset flow
Crypto logic flush on security state transition
TOP Interface input wires to interrupt trigger
Arch & Fuse registers should be accessible even when the mailbox is in progress
Test SHA acceleration HW API - cross it with mailbox flows from internal facing & SOC facing locks as well as access other registers during this process to ensure they progress appropriately with the right data/flow while SHA acceleration results match as expected
FW Update reset should ensure that SHA block is atomic to internal FW - or wait for the SHA operation to complete and give the round robin to FW if it has requested or about to request as a part of FW update reset
SOC write to locked fuses get silently dropped
Fuse rewrite on ready_for_fuse being written by the FW and bootFSM although transitions to BOOT_DONE again, none of the uController or others signals should be effected - No fuses should be updateable
Mailbox data available read happening at the same time as a SOC register access
TRNG REQ API Verification
Caliptra TOP level JTAG Validation
SOC-IFC interrupt register validation
Cross coverage (UVM) | Description | Coverage type | Status | Tested?
Register access |  | coverpoint
SoC to uC basic protocol |  | coverpoint
uC to SoC basic protocol |  | coverpoint
Arbitration Conflicts with both requests arising at the same time |  | coverpoint
PAUSER based filtering |  | coverpoint
Mailbox being used by a different entity than the 'locking' entity |  | coverpoint
Mailbox force-unlock in the middle of multiple commands |  | coverpoint
Unaligned register writes |  | coverpoint
Mailbox interrupt to UC flows |  | coverpoint
Mailbox flows crossed with warm reset |  | coverpoint
Mailbox flows crossed with cold reset |  | coverpoint
Mailbox unperturbed under FW update reset |  | coverpoint
Mailbox DLEN violation - DLEN larger than Mailbox | dlen_gt_mbox_size_cp | coverpoint
Mailbox DLEN violation - Sender writes more data than DLEN | req_wrptr_gt_dlen_cp | coverpoint
Mailbox DLEN violation - Sender writes more data than Mailbox size (128KiB) | wrptr_rollover_cp - can't actually roll over, but detect when we try to | coverpoint
Mailbox DLEN violation - Receiver reads more data than DLEN | rdptr_gt_dlen_cp - can't actually read more than dlen but detect when we try to | coverpoint
Mailbox DLEN violation - Receiver reads more data than Mailbox size (128KiB) | rdptr_rollover_cp - can't actually roll over, but detect when we try to | coverpoint
Mailbox DLEN violation - Receiver writes more response data than DLEN | resp_wrptr_gt_dlen_cp | coverpoint
Mailbox delay handling - Sender/Receiver injects random delays throughout mailbox procedure |  | coverpoint
Mailbox - sender tries to read dataout |  | coverpoint
Mailbox - receiver tries to write datain
Mailbox - Check data received by uC matches data sent by SoC
Mailbox - Check response data received by SoC matches data sent by uC
Mailbox - Check data received by SoC matches request data sent by uC
Mailbox - VERY small commands to test boundary conditions (2-8 bytes)
Fuse register writes
Fuse register unauthorized updates being dropped to WO fuses
Read of fuse registers must be blocked for unauthorized fuses (eg. UDS, FE etc.); Follow the arch spec
FW Update flow with associated reset
FW Update flow and Key vault behavior
FW Update flow and PCR vault behavior
FW Update flow loads image to ICCM/DCCM without corruption
Security access controls change, key/asset flushing
Warm & Cold Reset and Key vault behavior
Warm & Cold Reset and PCR vault behavior
Security access controls change, key/asset flushing across warm & Cold resets
idle clock gating entry & exit
Boot flow
Warm reset flow
Crypto logic flush on security state transition
TOP Interface input wires to interrupt trigger
Arch & Fuse registers should be accessible even when the mailbox is in progress
Test SHA acceleration HW API - cross it with mailbox flows from internal facing & SOC facing locks as well as access other registers during this process to ensure they progress appropriately with the right data/flow while SHA acceleration results match as expected
FW Update reset should ensure that SHA block is atomic to internal FW - or wait for the SHA operation to complete and give the round robin to FW if it has requested or about to request as a part of FW update reset
SOC write to locked fuses get silently dropped
Fuse rewrite on ready_for_fuse being written by the FW and bootFSM although transitions to BOOT_DONE again, none of the uController or others signals should be effected - No fuses should be updateable
Mailbox data available read happening at the same time as a SOC register access
TRNG REQ API Verification
Caliptra TOP level JTAG Validation
SOC-IFC interrupt register validation

Sheet: AHB Coverage
Slave SIF Coverage | Description | Coverage type | Status | Tested?
Read access | Valid read access | Coverpoint | DONE
Write access | Valid write access | Coverpoint | DONE
b2b transaction | Detect back to back read/write transactions | Coverpoint
2:1 Mux Coverage | Description | Coverage type | Status | Tested?
Initiator grant | grant indication for each initiator | Coverpoint | DONE
Initiator address phase | address phase indication for each initiator | Coverpoint | DONE
Initiator data phase | data phase indication for each initiator | Coverpoint | DONE
Initiator pending addr phase | pending address phase indication for each initiator | Coverpoint | DONE
pending but not ready | pending address phase but receiver isn't ready | Coverpoint | DONE
data phase not ready | data phase but receiver isn't ready | Coverpoint | DONE
data cross with grant | cross data phase of init0 with grant of init1 and init1 with init0 | Cross | DONE
addr cross with pending | address phase cross with pending address phase for each initiator | Cross | DONE
initiator address phase cross | cross init0 and init1 address phase | Cross | DONE
initiator pend addr ph cross | cross init0 and init1 pend address phase | Cross | DONE
Decoder Coverage | Description | Coverage type | Status | Tested?
access blocked | AHB decoder access that is blocked | Coverpoint | DONE
out of bounds access | ahb access to an address that doesn't map to any peripheral | Coverpoint | DONE
error response | cover hresp for OK and error signals | Coverpoint | DONE
All register accessed | Analyze code coverage to ensure all the implemented registers are accessed in read/write paths | Code Coverage

Sheet: SHA512 Coverage
IO Coverage | Description | Coverage type | Status | Tested?
reset_n |  | coverpoint |  | Y
cptra_pwrgood |  | coverpoint
AHB IOs |  |  |  | Y
kv_write | all entries, all offsets, 0/1 on all write_data bits, 0/1 on all dest_valids | coverpoint |  | Y
kv_read | all entries, all offsets | coverpoint |  | Y
kv_wr_resp | 0/1 on error | coverpoint |  | Y
kv_rd_resp | 0/1 on all read_data bits, 0/1 on last and error bits | coverpoint |  | Y
pv_write | all entries, all offsets, 0/1 on all write_data bits, 0/1 on all dest_valids | coverpoint |  | Y
pv_read | all entries, all offsets | coverpoint |  | Y
pv_wr_resp | 0/1 on error | coverpoint |  | Y
pv_rd_resp | 0/1 on all read_data bits, 0/1 on last and error bits | coverpoint |  | Y
pcr_signing_key | Can be any entry, but its corresponding KEY_ENTRY dest_valid must be 0 | Assertion |  | Y
error_intr |  | coverpoint
notif_intr |  | coverpoint |  | Y
Register Coverage | Description | Coverage type | Status | Tested?
init_reg |  |  | DONE | Y
next_reg |  |  | DONE | Y
mode_reg |  |  | DONE | Y
zeroize_reg |  |  | DONE | Y
ready_reg |  |  | DONE | Y
valid_reg |  |  | DONE | Y
pcr_sign_we |  |  | DONE | Y
gen_hash_start |  |  | DONE | Y
gen_hash_ip |  |  | DONE | Y
dest_data_avail |  |  | DONE | Y
valid_reg | when 1, the ready must be 1 | Assertion | DONE | Y
Cross coverage | Description | Coverage type | Status | Tested?
init X ready |  |  | DONE | Y
next X ready |  |  | DONE | Y
mode X ready |  |  | DONE
zeroize X ready |  |  | DONE
pcr_sign X ready |  |  | DONE
pcr_sign X init |  |  | DONE
pcr_sign X next |  |  | DONE
pcr_sign X zeroize |  |  | DONE

Sheet: DataVault Cov
IO Coverage | Description | Coverage type | Status | Tested?
rst_b
core_only_rst_b
cptra_pwrgood
AHB IOs |  |  |  | Y
Register Coverage | Description | Coverage type | Status | Tested?
datareg_rdwr | data registers can be written then read back; follow w/control registers (fields) | coverpoint |  | Y
cold rst | power-on values and clearing w/cold reset | coverpoint |  | Y
warm rst | warm reset survival of sticky registers | coverpoint |  | Y
lock_wr_sticky_ctrl | StickyDataVaultCtrl[10] | coverpoint |  | Y
lock_use_sticky_data | STICKY_DATA_VAULT_ENTRY[10][12] | coverpoint |  | Y
lock_wr_nonsticky_ctrl | NonStickyDataVaultCtrl[10] | coverpoint |  | Y
lock_use_nonsticky_data | NONSTICKY_DATA_VAULT_ENTRY[10][12] | coverpoint |  | Y
lock_wr_nonsticky_scratch_ctrl | NonStickyLockableScratchRegCtrl[10] | coverpoint |  | Y
lock_use_nonsticky_scratch | NonStickyLockableScratchReg[10] | coverpoint |  | Y
no_lock_generic_scratch | NonStickyGenericScratchReg[8] unlockable by any of 4 lock groups | coverpoint |  | Y
lock_wr_sticky_scratch_ctrl | StickyLockableScratchRegCtrl[8] | coverpoint |  | Y
lock_use_sticky_scratch | StickyLockableScratchReg[8] | coverpoint |  | Y
Cross coverage | Description | Coverage type | Status | Tested?
 |  | -
 |  | -
 |  | -
 |  | -
 |  | -
 |  | -
 |  | -
 |  | -
 |  | -
 |  | -

Sheet: Clk gating Coverage
IO Coverage | Description | Coverage type | Status | Tested?
cptra_rst_b |  | coverpoint | Done | Y
psel | Single APB txn Back to back APB txns | coverpoint | Done | Test covers b2b Need one for single
clk_gate_en | Enable, disable (Same as #11) | coverpoint | Done | Y
cpu_halt_status | Value: 0, 1 Transition: 0 => 1, 1 => 0 | coverpoint | Done | Y
generic_input_wires[63:0] | Value: 0, 1 Transition: 0 => 1, 1 => 0 | coverpoint | Done | Y
Register Coverage | Description | Coverage type | Status | Tested?
CPTRA_CLK_GATING_EN | Enable, disable | coverpoint | Done | Y
Cross coverage | Description | Coverage type | Status | Tested? | Notes
warm reset X psel |  | coverpoint
warm reset X clk_gate_en (core asleep) |  | coverpoint | Done | Y
warm reset X cpu halt status |  | coverpoint | Done | Y | When rst is asserted, cpu_halt_status is deasserted, so coverage is not collected for (rst == 0, cpu_halt_status == 1) case
warm reset X generic input wires |  | coverpoint
cg enable, core asleep X WDT |  | coverpoint | Done | Y
cg enable, core asleep X security state transition | Check sampling of security state Check flushing of KV (should happen irrespective of clks) | coverpoint | Done | Y
cg enable, core asleep X wake-up conditions: | fatal error | coverpoint | Done | Y
 | generic input wire toggle | coverpoint | Done | Y
 | APB txn | coverpoint | Done | Y
 | NMI | coverpoint | Done
cg enable, core asleep X mailbox flows

Sheet: blank Coverage
IO Coverage | Description | Coverage type | Status | Tested?
Register Coverage | Description | Coverage type | Status | Tested?
Cross coverage | Description | Coverage type | Status | Tested?
