houdonghui1/Trust_Shield/First_rot_risc_v/Hardware/Caliptra/caliptra_rtl/src/ecc/uvmf_ecc/uvmf_template_output/verification_ip/interface_packages/ECC_in_pkg/src/ECC_in_infact_coverage_strategy.csv

Global
auto_bin_max | 64
Name | Type | Include
rand_fields | coverpoint | =rand *.**
