houdonghui1/Trust_Shield/Second_rot_sw/second_test_image/second_test (1).png

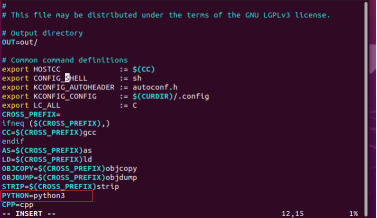
Second_rot_sw/second_test_image/second_test (1).png
