houdonghui1/Trust_Shield/doc/sam3x.pdf

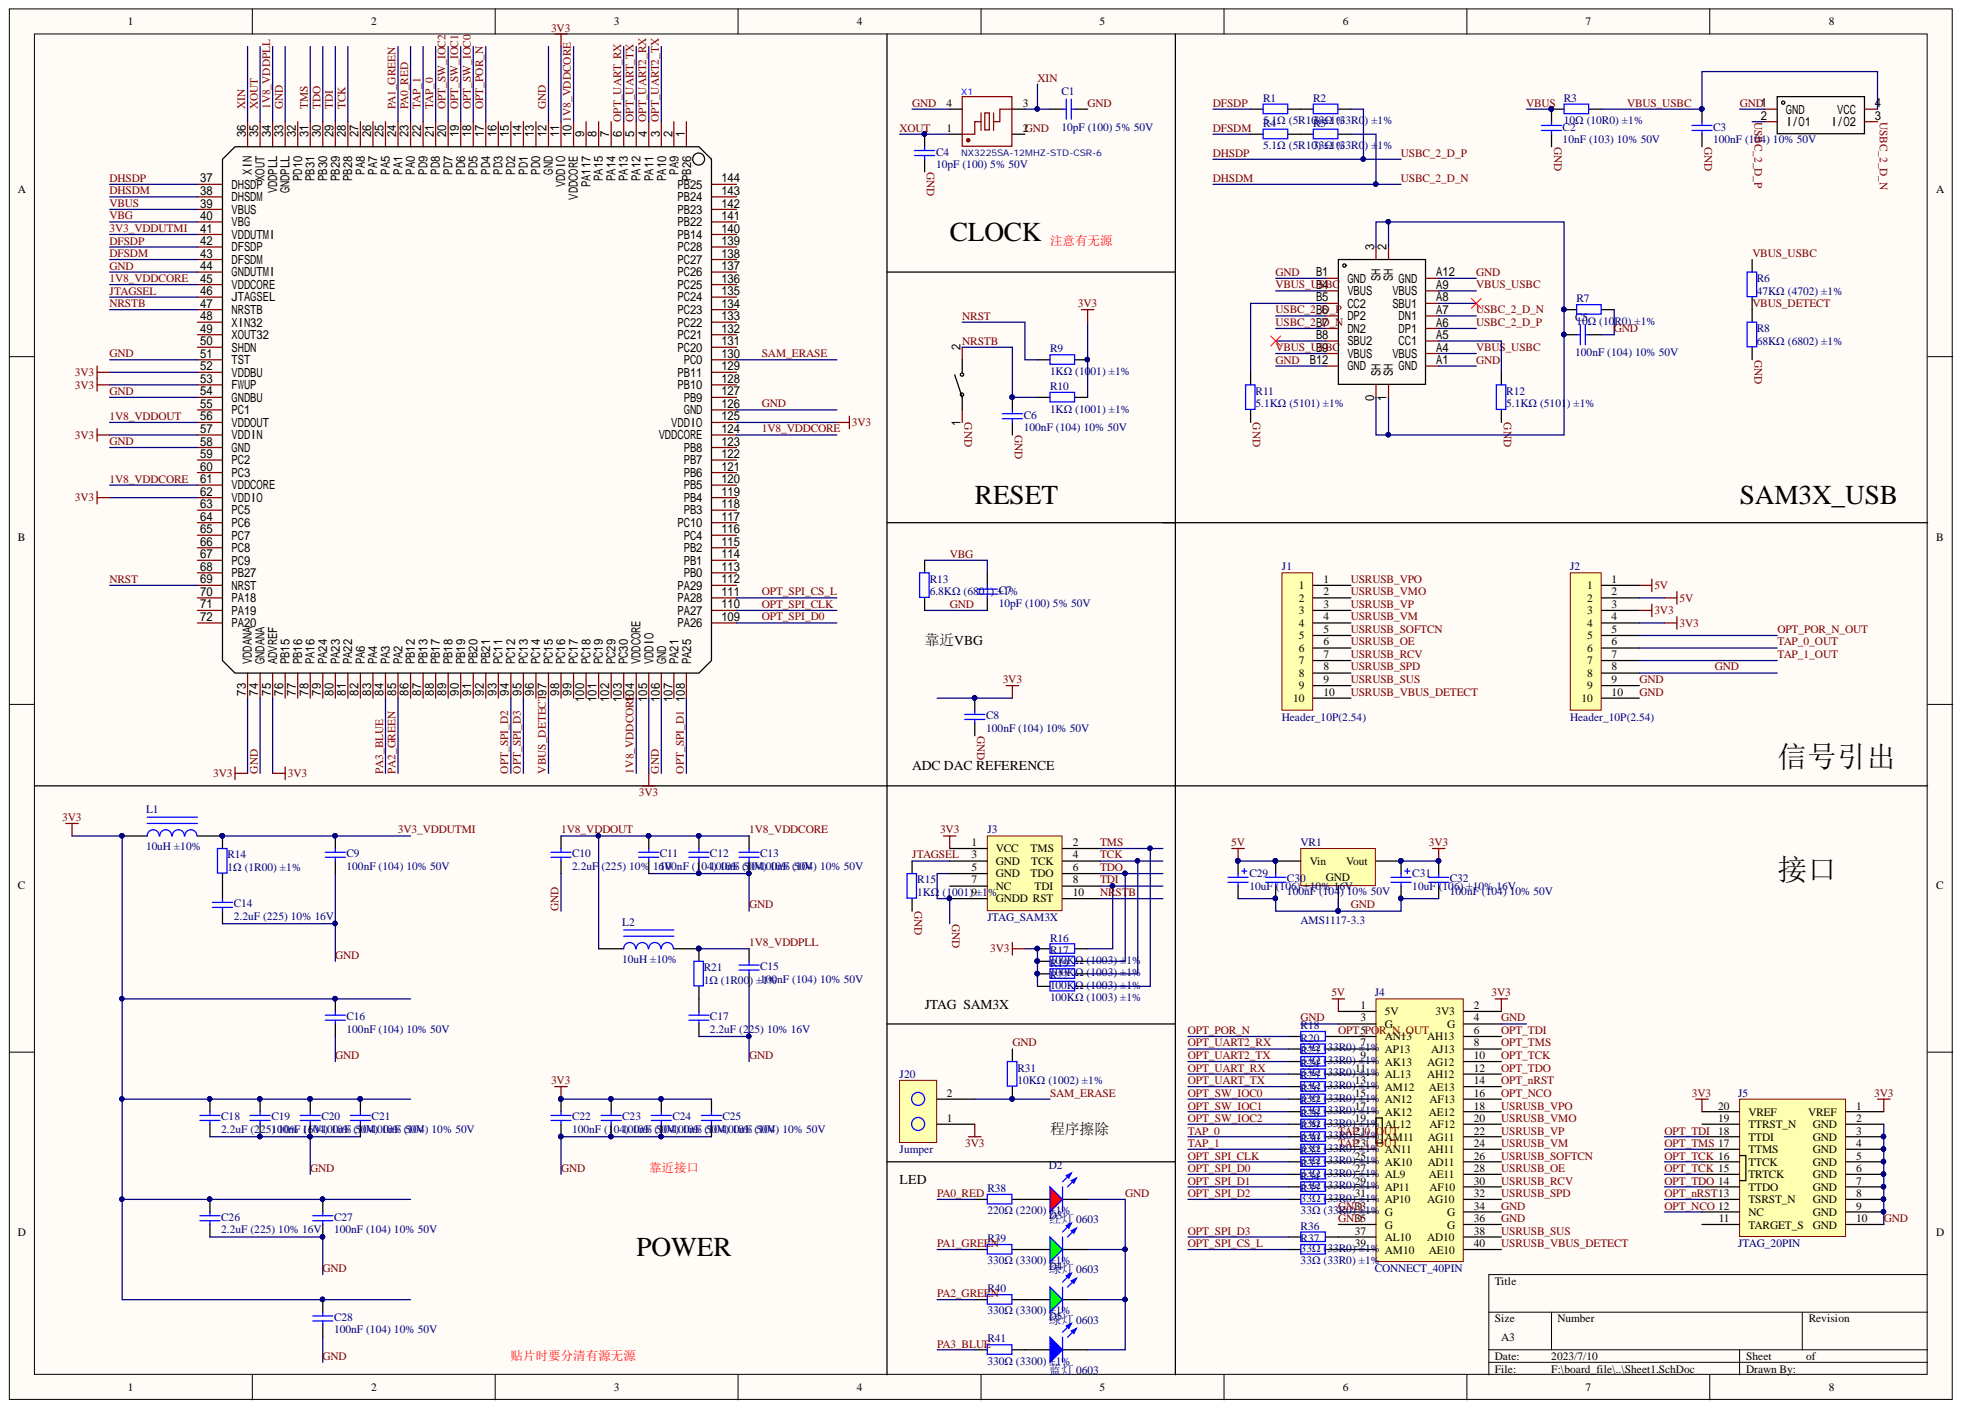
[picture p215: page 1]
