houdonghui1/Trust_Shield/Third_rot/opentitan/hw/ip/usbdev/pmod/tusb1106pmod-kicad/usbphy.kicad_pcb

## KiCad design Third_rot/opentitan/hw/ip/usbdev/pmod/tusb1106pmod-kicad/usbphy.kicad_pcb (2026-06-09)

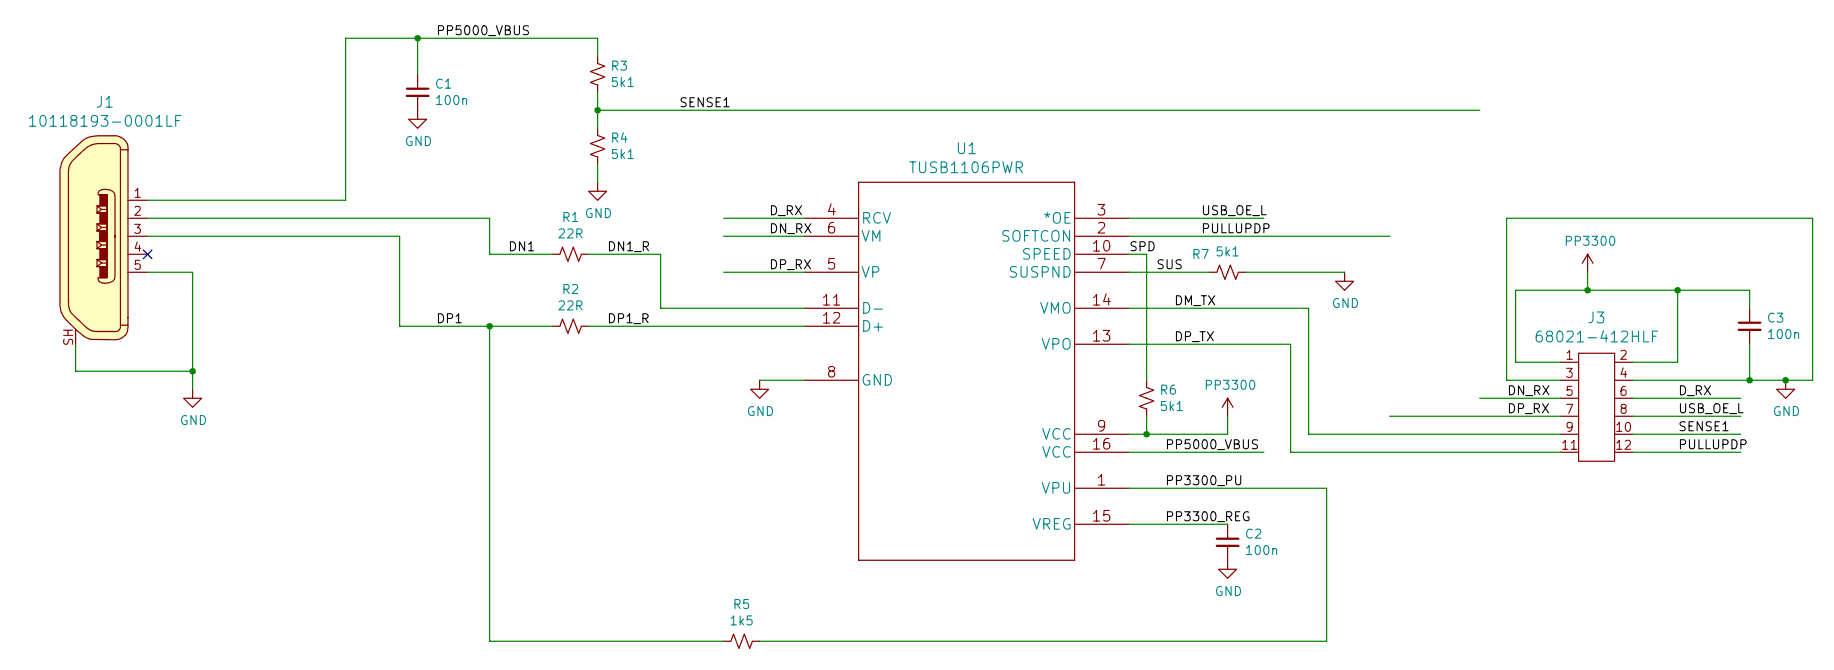
[picture p218: schematic usbphy.sch]

Parts:
C1, C2, C3: 100n; C_0805_2012Metric_Pad1.15x1.40mm_HandSolder
J1: 10118193-0001LF; USB_Micro_B_Female_10118193-0001LF; MPN 10118193-0001LF; Digi-Key_PN 609-4616-1-ND
J3: 68021-412HLF; PinHeader_6x2_P2.54mm_Horizontal; MPN 68021-412HLF; Digi-Key_PN 609-3355-ND
R1, R2: 22R; R_0805_2012Metric_Pad1.15x1.40mm_HandSolder
R3, R4, R6, R7: 5k1; R_0805_2012Metric_Pad1.15x1.40mm_HandSolder
R5: 1k5; R_0805_2012Metric_Pad1.15x1.40mm_HandSolder
U1: TUSB1106PWR

Connections:
/DM_TX: J3.9, U1.14 (VMO)
/DN1: J1.2, R1.2
/DN1_R: R1.1, U1.11 (D-)
/DN_RX: J3.5, U1.6 (VM)
/DP1: J1.3, R2.2, R5.2
/DP1_R: R2.1, U1.12 (D+)
/DP_RX: J3.7, U1.5 (VP)
/DP_TX: J3.11, U1.13 (VPO)
/D_RX: J3.6, U1.4 (RCV)
/PP3300_PU: R5.1, U1.1 (VPU)
/PP3300_REG: C2.1, U1.15 (VREG)
/PP5000_VBUS: C1.1, J1.1, R3.1, U1.16 (VCC)
/PULLUPDP: J3.12, U1.2 (SOFTCON)
/SENSE1: J3.10, R3.2, R4.1
/SPD: R6.1, U1.10 (SPEED)
/SUS: R7.2, U1.7 (SUSPND)
/USB_OE_L: J3.8, U1.3 (*OE)
GND: C1.2, C2.2, C3.2, J1.5, J1.SH, J3.3, J3.4, R4.2, R7.1, U1.8 (GND)
PP3300: C3.1, J3.1, J3.2, R6.2, U1.9 (VCC)

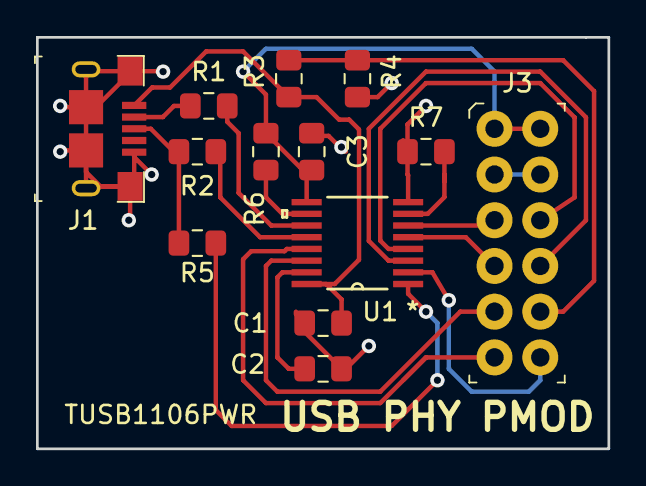
[picture p219: board usbphy.kicad_pcb from above]

Board: 2 copper layers, 31.8 x 22.9 mm, 13 parts (0 on the bottom side), 19 nets.
