houdonghui1/Trust_Shield/Third_rot/lowrisc_systems_chip_earlgrey_cw310_0.1/synth-vivado/lowrisc_systems_chip_earlgrey_cw310_0.1.eda.yml

dependencies:
  lowrisc:constants:jtag_id_pkg:0: []
  lowrisc:constants:top_pkg:0: []
  lowrisc:dv:crypto_prince_ref:0.1: []
  lowrisc:dv:dv_fcov_macros:0: []
  lowrisc:dv:dv_macros:0: []
  lowrisc:dv:pins_if:0: []
  lowrisc:dv:scramble_model:0:
  - lowrisc:dv:crypto_prince_ref:0.1
  lowrisc:dv:secded_enc:0: []
  lowrisc:dv_verilator:memutil_dpi:0:
  - lowrisc:dv:secded_enc:0
  lowrisc:dv_verilator:memutil_dpi_scrambled:0:
  - lowrisc:dv:scramble_model:0
  - lowrisc:dv_verilator:memutil_dpi:0
  lowrisc:ibex:ibex_core:0.1:
  - lowrisc:dv:dv_fcov_macros:0
  - lowrisc:ibex:ibex_icache:0.1
  - lowrisc:ibex:ibex_pkg:0.1
  - lowrisc:prim:assert:0.1
  - lowrisc:prim:clock_gating:0
  - lowrisc:prim:lfsr:0.1
  - lowrisc:tool:check_tool_requirements:0.1
  lowrisc:ibex:ibex_icache:0.1:
  - lowrisc:ibex:ibex_pkg:0.1
  - lowrisc:prim:assert:0.1
  - lowrisc:prim:secded:0.1
  lowrisc:ibex:ibex_pkg:0.1: []
  lowrisc:ibex:ibex_top:0.1:
  - lowrisc:ibex:ibex_core:0.1
  - lowrisc:ibex:ibex_pkg:0.1
  - lowrisc:prim:buf:0
  - lowrisc:prim:clock_mux2:0
  - lowrisc:prim:flop:0
  - lowrisc:prim:onehot_check:0
  - lowrisc:prim:ram_1p_scr:0.1
  - lowrisc:tool:check_tool_requirements:0.1
  lowrisc:ip:adc_ctrl:1.0:
  - lowrisc:constants:top_pkg:0
  - lowrisc:ip:tlul:0.1
  - lowrisc:prim:all:0.1
  - lowrisc:systems:ast_pkg:0
  lowrisc:ip:aes:1.0:
  - lowrisc:ip:edn_pkg:0.1
  - lowrisc:ip:keymgr_pkg:0.1
  - lowrisc:ip:lc_ctrl_pkg:0.1
  - lowrisc:ip:tlul:0.1
  - lowrisc:prim:all:0.1
  - lowrisc:prim:lc_sync:0.1
  - lowrisc:prim:lfsr:0.1
  - lowrisc:prim:sparse_fsm:0
  - lowrisc:prim:util:0.1
  lowrisc:ip:alert_handler_component:0.1:
  - lowrisc:opentitan:top_earlgrey_alert_handler_reg:0.1
  - lowrisc:ip:tlul:0.1
  - lowrisc:prim:all:0.1
  - lowrisc:prim:buf:0
  - lowrisc:prim:count:0
  - lowrisc:prim:double_lfsr:0
  - lowrisc:prim:edn_req:0.1
  - lowrisc:prim:esc:0
  - lowrisc:prim:mubi:0.1
  - lowrisc:prim:sparse_fsm:0
  lowrisc:ip:aon_timer:0.1:
  - lowrisc:ip:tlul:0.1
  - lowrisc:prim:all:0.1
  - lowrisc:prim:edge_detector:0.1
  - lowrisc:prim:lc_sync:0.1
  lowrisc:ip:clkmgr_components:0.1:
  - lowrisc:ip:lc_ctrl_pkg:0.1
  - lowrisc:prim:measure:0
  - lowrisc:prim:mubi:0.1
  - lowrisc:systems:clkmgr_pkg:0.1
  lowrisc:ip:csrng:0.1:
  - lowrisc:constants:top_pkg:0
  - lowrisc:ip:aes:1.0
  - lowrisc:ip:csrng_pkg:0.1
  - lowrisc:ip:otp_ctrl_pkg:1.0
  - lowrisc:ip:tlul:0.1
  - lowrisc:prim:all:0.1
  - lowrisc:prim:assert:0.1
  - lowrisc:prim:count:0
  - lowrisc:prim:edge_detector:0.1
  - lowrisc:prim:lc_sync:0.1
  - lowrisc:prim:sparse_fsm:0
  lowrisc:ip:csrng_pkg:0.1:
  - lowrisc:ip:entropy_src_pkg:0.1
  - lowrisc:ip:lc_ctrl_pkg:0.1
  - lowrisc:tlul:headers:0.1
  lowrisc:ip:edn:0.1:
  - lowrisc:constants:top_pkg:0
  - lowrisc:ip:edn_pkg:0.1
  - lowrisc:ip:tlul:0.1
  - lowrisc:prim:all:0.1
  - lowrisc:prim:assert:0.1
  - lowrisc:prim:count:0
  - lowrisc:prim:edge_detector:0.1
  - lowrisc:prim:sparse_fsm:0
  lowrisc:ip:edn_pkg:0.1:
  - lowrisc:ip:csrng_pkg:0.1
  - lowrisc:tlul:headers:0.1
  lowrisc:ip:entropy_src:0.1:
  - lowrisc:constants:top_pkg:0
  - lowrisc:ip:entropy_src_ack_sm_pkg:0.1
  - lowrisc:ip:entropy_src_main_sm_pkg:0.1
  - lowrisc:ip:entropy_src_pkg:0.1
  - lowrisc:ip:otp_ctrl_pkg:1.0
  - lowrisc:ip:sha3:0.1
  - lowrisc:ip:tlul:0.1
  - lowrisc:prim:all:0.1
  - lowrisc:prim:assert:0.1
  - lowrisc:prim:count:0
  - lowrisc:prim:edge_detector:0.1
  - lowrisc:prim:lfsr:0.1
  - lowrisc:prim:macros:0.1
  - lowrisc:prim:max_tree:0
  - lowrisc:prim:mubi:0.1
  - lowrisc:prim:sparse_fsm:0
  - lowrisc:prim:sum_tree:0
  lowrisc:ip:entropy_src_ack_sm_pkg:0.1: []
  lowrisc:ip:entropy_src_main_sm_pkg:0.1: []
  lowrisc:ip:entropy_src_pkg:0.1: []
  lowrisc:ip:flash_ctrl:0.1:
  - lowrisc:ip:flash_ctrl_pkg:0.1
  - lowrisc:ip:jtag_pkg:0.1
  - lowrisc:ip:otp_ctrl_pkg:1.0
  - lowrisc:ip:tlul:0.1
  - lowrisc:prim:all:0.1
  - lowrisc:prim:count:0
  - lowrisc:prim:edge_detector:0.1
  - lowrisc:prim:flash:0
  - lowrisc:prim:flop_2sync:0
  - lowrisc:prim:gf_mult:0
  - lowrisc:prim:lc_sync:0.1
  - lowrisc:prim:lfsr:0.1
  - lowrisc:prim:secded:0.1
  - lowrisc:prim:sparse_fsm:0
  - lowrisc:systems:flash_ctrl:0.1
  lowrisc:ip:flash_ctrl_pkg:0.1:
  - lowrisc:constants:top_pkg:0
  - lowrisc:ip:edn_pkg:0.1
  - lowrisc:ip:jtag_pkg:0.1
  - lowrisc:ip:lc_ctrl_pkg:0.1
  - lowrisc:ip:pwrmgr_pkg:0.1
  - lowrisc:prim:util:0.1
  - lowrisc:systems:ast_pkg:0
  - lowrisc:systems:flash_ctrl_pkg:0.1
  lowrisc:ip:flash_ctrl_prim_reg_top:1.0:
  - lowrisc:ip:flash_ctrl_pkg:0.1
  lowrisc:ip:gpio:0.1:
  - lowrisc:ip:tlul:0.1
  - lowrisc:prim:all:0.1
  lowrisc:ip:hmac:0.1:
  - lowrisc:ip:tlul:0.1
  - lowrisc:prim:all:0.1
  lowrisc:ip:i2c:0.1:
  - lowrisc:constants:top_pkg:0
  - lowrisc:ip:i2c_pkg:0.1
  - lowrisc:ip:tlul:0.1
  - lowrisc:prim:all:0.1
  lowrisc:ip:i2c_pkg:0.1: []
  lowrisc:ip:jtag_pkg:0.1: []
  lowrisc:ip:keymgr:0.1:
  - lowrisc:ip:flash_ctrl_pkg:0.1
  - lowrisc:ip:keymgr_pkg:0.1
  - lowrisc:ip:kmac_pkg:0.1
  - lowrisc:ip:otp_ctrl_pkg:1.0
  - lowrisc:ip:rom_ctrl_pkg:0.1
  - lowrisc:ip:tlul:0.1
  - lowrisc:prim:all:0.1
  - lowrisc:prim:count:0
  - lowrisc:prim:edn_req:0.1
  - lowrisc:prim:lc_sync:0.1
  - lowrisc:prim:lfsr:0.1
  - lowrisc:prim:msb_extend:0
  - lowrisc:prim:mubi:0.1
  - lowrisc:prim:sec_anchor:0.1
  - lowrisc:prim:secded:0.1
  - lowrisc:prim:sparse_fsm:0
  lowrisc:ip:keymgr_pkg:0.1:
  - lowrisc:constants:top_pkg:0
  - lowrisc:ip:edn_pkg:0.1
  lowrisc:ip:kmac:0.1:
  - lowrisc:ip:edn_pkg:0.1
  - lowrisc:ip:keymgr_pkg:0.1
  - lowrisc:ip:kmac_pkg:0.1
  - lowrisc:ip:lc_ctrl_pkg:0.1
  - lowrisc:ip:sha3:0.1
  - lowrisc:ip:tlul:0.1
  - lowrisc:prim:all:0.1
  - lowrisc:prim:arbiter:0
  - lowrisc:prim:assert:0.1
  - lowrisc:prim:count:0
  - lowrisc:prim:double_lfsr:0
  - lowrisc:prim:edn_req:0.1
  - lowrisc:prim:lc_sync:0.1
  - lowrisc:prim:mubi:0.1
  - lowrisc:prim:prim_dom_and_2share:0.1
  - lowrisc:prim:sparse_fsm:0
  lowrisc:ip:kmac_pkg:0.1:
  - lowrisc:constants:top_pkg:0
  - lowrisc:ip:sha3:0.1
  lowrisc:ip:lc_ctrl:0.1:
  - lowrisc:opentitan:top_earlgrey_alert_handler_reg:0.1
  - lowrisc:ip:kmac_pkg:0.1
  - lowrisc:ip:lc_ctrl_pkg:0.1
  - lowrisc:ip:otp_ctrl_pkg:1.0
  - lowrisc:ip:pwrmgr_pkg:0.1
  - lowrisc:ip:rv_dm:0.1
  - lowrisc:ip:tlul:0.1
  - lowrisc:prim:all:0.1
  - lowrisc:prim:clock_mux2:0
  - lowrisc:prim:esc:0
  - lowrisc:prim:lc_sender:0.1
  - lowrisc:prim:lc_sync:0.1
  - lowrisc:prim:mubi:0.1
  - lowrisc:prim:sparse_fsm:0
  lowrisc:ip:lc_ctrl_pkg:0.1:
  - lowrisc:ip:lc_ctrl_state_pkg:0.1
  - lowrisc:prim:assert:0.1
  - lowrisc:tlul:headers:0.1
  lowrisc:ip:lc_ctrl_state_pkg:0.1:
  - lowrisc:prim:util:0.1
  lowrisc:ip:otbn:0.1:
  - lowrisc:ip:edn_pkg:0.1
  - lowrisc:ip:keymgr_pkg:0.1
  - lowrisc:ip:otbn_pkg:0.1
  - lowrisc:ip:otp_ctrl_pkg:1.0
  - lowrisc:ip:tlul:0.1
  - lowrisc:prim:all:0.1
  - lowrisc:prim:assert:0.1
  - lowrisc:prim:blanker:0
  - lowrisc:prim:cipher_pkg:0.1
  - lowrisc:prim:crc32:0
  - lowrisc:prim:edn_req:0.1
  - lowrisc:prim:lc_sync:0.1
  - lowrisc:prim:lfsr:0.1
  - lowrisc:prim:mubi:0.1
  - lowrisc:prim:onehot:0
  - lowrisc:prim:onehot_check:0
  - lowrisc:prim:ram_1p_scr:0.1
  - lowrisc:prim:sparse_fsm:0
  - lowrisc:prim:util:0.1
  - lowrisc:prim:xoshiro256pp:0
  lowrisc:ip:otbn_pkg:0.1:
  - lowrisc:ip:otp_ctrl_pkg:1.0
  - lowrisc:prim:assert:0.1
  lowrisc:ip:otp_ctrl:1.0:
  - lowrisc:ip:edn_pkg:0.1
  - lowrisc:ip:otp_ctrl_pkg:1.0
  - lowrisc:ip:pwrmgr_pkg:0.1
  - lowrisc:ip:tlul:0.1
  - lowrisc:prim:all:0.1
  - lowrisc:prim:buf:0
  - lowrisc:prim:count:0
  - lowrisc:prim:double_lfsr:0
  - lowrisc:prim:edn_req:0.1
  - lowrisc:prim:flop:0
  - lowrisc:prim:lc_sender:0.1
  - lowrisc:prim:lc_sync:0.1
  - lowrisc:prim:otp:0
  - lowrisc:prim:ram_1p:0
  - lowrisc:prim:sec_anchor:0.1
  - lowrisc:prim:secded:0.1
  - lowrisc:prim:sparse_fsm:0
  - lowrisc:systems:ast_pkg:0
  lowrisc:ip:otp_ctrl_pkg:1.0:
  - lowrisc:ip:lc_ctrl_pkg:0.1
  - lowrisc:prim:mubi:0.1
  - lowrisc:tlul:headers:0.1
  lowrisc:ip:otp_ctrl_prim_reg_top:1.0:
  - lowrisc:ip:otp_ctrl_pkg:1.0
  lowrisc:ip:pattgen:0.1:
  - lowrisc:ip:tlul:0.1
  - lowrisc:prim:all:0.1
  - lowrisc:prim:assert:0.1
  lowrisc:ip:pinmux:0.1:
  - lowrisc:ip:pinmux_component:0.1
  - lowrisc:ip:pinmux_reg:0.1
  lowrisc:ip:pinmux_component:0.1:
  - lowrisc:ip:jtag_pkg:0.1
  - lowrisc:ip:tlul:0.1
  - lowrisc:ip:usbdev:0.1
  - lowrisc:prim:all:0.1
  - lowrisc:prim:buf:0
  - lowrisc:prim:clock_buf:0
  - lowrisc:prim:lc_dec:0.1
  - lowrisc:prim:lc_or_hardened:0.1
  - lowrisc:prim:lc_sender:0.1
  - lowrisc:prim:lc_sync:0.1
  - lowrisc:prim:pad_attr:0
  - lowrisc:prim:pad_wrapper_pkg:0
  lowrisc:ip:pinmux_reg:0.1:
  - lowrisc:systems:pinmux_reg:0.1
  - lowrisc:tlul:headers:0.1
  lowrisc:ip:puf:1.0:
  - lowrisc:ip:edn_pkg:0.1
  - lowrisc:ip:keymgr_pkg:0.1
  - lowrisc:ip:lc_ctrl_pkg:0.1
  - lowrisc:ip:sm4_pkg:0.1
  - lowrisc:ip:tlul:0.1
  - lowrisc:prim:all:0.1
  - lowrisc:prim:lc_sync:0.1
  - lowrisc:prim:lfsr:0.1
  - lowrisc:prim:sparse_fsm:0
  - lowrisc:prim:util:0.1
  lowrisc:ip:pwm:0.1:
  - lowrisc:ip:tlul:0.1
  - lowrisc:prim:all:0.1
  - lowrisc:prim:assert:0.1
  lowrisc:ip:pwrmgr:0.1:
  - lowrisc:opentitan:top_earlgrey_alert_handler_reg:0.1
  - lowrisc:ip:lc_ctrl_pkg:0.1
  - lowrisc:ip:pwrmgr_pkg:0.1
  - lowrisc:ip:pwrmgr_reg:0.1
  - lowrisc:ip:rom_ctrl_pkg:0.1
  - lowrisc:ip:tlul:0.1
  - lowrisc:prim:all:0.1
  - lowrisc:prim:clock_buf:0
  - lowrisc:prim:esc:0
  - lowrisc:prim:lc_sender:0.1
  - lowrisc:prim:lc_sync:0.1
  - lowrisc:prim:measure:0
  - lowrisc:prim:mubi:0.1
  - lowrisc:prim:sparse_fsm:0
  lowrisc:ip:pwrmgr_pkg:0.1:
  - lowrisc:ip:pwrmgr_reg:0.1
  lowrisc:ip:pwrmgr_reg:0.1:
  - lowrisc:ip:tlul:0.1
  - lowrisc:prim:subreg:0
  - lowrisc:tlul:headers:0.1
  lowrisc:ip:rom_ctrl:0.1:
  - lowrisc:ip:kmac_pkg:0.1
  - lowrisc:ip:rom_ctrl_pkg:0.1
  - lowrisc:ip:tlul:0.1
  - lowrisc:prim:alert:0
  - lowrisc:prim:assert:0.1
  - lowrisc:prim:buf:0
  - lowrisc:prim:cipher:0
  - lowrisc:prim:count:0
  - lowrisc:prim:rom_adv:0.1
  - lowrisc:prim:sec_anchor:0.1
  - lowrisc:prim:sparse_fsm:0
  - lowrisc:prim:subreg:0
  - lowrisc:prim:util:0.1
  lowrisc:ip:rom_ctrl_pkg:0.1:
  - lowrisc:prim:assert:0.1
  - lowrisc:prim:mubi:0.1
  lowrisc:ip:rs_decode:1.0:
  - lowrisc:ip:edn_pkg:0.1
  - lowrisc:ip:keymgr_pkg:0.1
  - lowrisc:ip:lc_ctrl_pkg:0.1
  - lowrisc:ip:tlul:0.1
  - lowrisc:prim:all:0.1
  - lowrisc:prim:lc_sync:0.1
  - lowrisc:prim:lfsr:0.1
  - lowrisc:prim:sparse_fsm:0
  - lowrisc:prim:util:0.1
  lowrisc:ip:rs_encode:1.0:
  - lowrisc:ip:edn_pkg:0.1
  - lowrisc:ip:keymgr_pkg:0.1
  - lowrisc:ip:lc_ctrl_pkg:0.1
  - lowrisc:ip:tlul:0.1
  - lowrisc:prim:all:0.1
  - lowrisc:prim:lc_sync:0.1
  - lowrisc:prim:lfsr:0.1
  - lowrisc:prim:sparse_fsm:0
  - lowrisc:prim:util:0.1
  lowrisc:ip:rstmgr:0.1:
  - lowrisc:ip:alert_handler_component:0.1
  - lowrisc:ip:rstmgr_cnsty_chk:0
  - lowrisc:ip:rv_core_ibex_pkg:0.1
  - lowrisc:ip:tlul:0.1
  - lowrisc:prim:clock_buf:0
  - lowrisc:prim:clock_mux2:0
  - lowrisc:prim:esc:0
  - lowrisc:prim:lc_sync:0.1
  - lowrisc:prim:mubi:0.1
  - lowrisc:prim:sparse_fsm:0
  - lowrisc:systems:rstmgr:0.1
  - lowrisc:systems:rstmgr_pkg:0.1
  lowrisc:ip:rstmgr_cnsty_chk:0:
  - lowrisc:ip:rv_core_ibex_pkg:0.1
  - lowrisc:prim:assert:0.1
  - lowrisc:prim:sparse_fsm:0
  - lowrisc:systems:rstmgr:0.1
  - lowrisc:systems:rstmgr_pkg:0.1
  lowrisc:ip:rstmgr_pkg:0.1:
  - lowrisc:ip:alert_handler_component:0.1
  - lowrisc:opentitan:top_earlgrey_alert_handler_reg:0.1
  - lowrisc:ip:pwrmgr_pkg:0.1
  - lowrisc:ip:rstmgr_reg:0.1
  - lowrisc:systems:rstmgr_pkg:0.1
  lowrisc:ip:rstmgr_reg:0.1:
  - lowrisc:systems:rstmgr_reg:0.1
  - lowrisc:tlul:headers:0.1
  lowrisc:ip:rv_core_ibex:0.1:
  - lowrisc:ibex:ibex_top:0.1
  - lowrisc:opentitan:top_earlgrey_alert_handler_reg:0.1
  - lowrisc:ip:lc_ctrl_pkg:0.1
  - lowrisc:ip:otp_ctrl_pkg:1.0
  - lowrisc:ip:pwrmgr_pkg:0.1
  - lowrisc:ip:rv_core_ibex_pkg:0.1
  - lowrisc:ip:tlul:0.1
  - lowrisc:prim:all:0.1
  - lowrisc:prim:clock_gating:0
  - lowrisc:prim:edn_req:0.1
  - lowrisc:prim:esc:0
  - lowrisc:prim:lc_sender:0.1
  - lowrisc:prim:lc_sync:0.1
  - lowrisc:prim:mubi:0.1
  - lowrisc:tlul:adapter_host:0.1
  lowrisc:ip:rv_core_ibex_pkg:0.1:
  - lowrisc:ibex:ibex_pkg:0.1
  lowrisc:ip:rv_dm:0.1:
  - lowrisc:ip:jtag_pkg:0.1
  - lowrisc:ip:tlul:0.1
  - lowrisc:prim:all:0.1
  - lowrisc:prim:clock_mux2:0
  - lowrisc:prim:lc_sync:0.1
  - lowrisc:prim:mubi:0.1
  - lowrisc:tlul:adapter_host:0.1
  - pulp-platform:riscv-dbg:0.1:0
  lowrisc:ip:rv_plic_component:0.1:
  - lowrisc:prim:alert:0
  - lowrisc:prim:assert:0.1
  - lowrisc:prim:flop_2sync:0
  - lowrisc:prim:max_tree:0
  - lowrisc:prim:reg_we_check:0
  lowrisc:ip:rv_timer:0.1:
  - lowrisc:ip:tlul:0.1
  - lowrisc:prim:all:0.1
  lowrisc:ip:sha3:0.1:
  - lowrisc:ip:tlul:0.1
  - lowrisc:prim:all:0.1
  - lowrisc:prim:assert:0.1
  - lowrisc:prim:mubi:0.1
  - lowrisc:prim:prim_dom_and_2share:0.1
  lowrisc:ip:sm3:1.0:
  - lowrisc:ip:edn_pkg:0.1
  - lowrisc:ip:keymgr_pkg:0.1
  - lowrisc:ip:lc_ctrl_pkg:0.1
  - lowrisc:ip:tlul:0.1
  - lowrisc:prim:all:0.1
  - lowrisc:prim:lc_sync:0.1
  - lowrisc:prim:lfsr:0.1
  - lowrisc:prim:sparse_fsm:0
  - lowrisc:prim:util:0.1
  lowrisc:ip:sm4:1.0:
  - lowrisc:ip:edn_pkg:0.1
  - lowrisc:ip:keymgr_pkg:0.1
  - lowrisc:ip:lc_ctrl_pkg:0.1
  - lowrisc:ip:sm4_pkg:0.1
  - lowrisc:ip:tlul:0.1
  - lowrisc:prim:all:0.1
  - lowrisc:prim:lc_sync:0.1
  - lowrisc:prim:lfsr:0.1
  - lowrisc:prim:sparse_fsm:0
  - lowrisc:prim:util:0.1
  lowrisc:ip:sm4_pkg:0.1: []
  lowrisc:ip:spi_device:0.1:
  - lowrisc:ip:lc_ctrl_pkg:0.1
  - lowrisc:ip:spi_device_pkg:0.1
  - lowrisc:ip:tlul:0.1
  - lowrisc:prim:all:0.1
  - lowrisc:prim:clock_buf:0
  - lowrisc:prim:clock_gating:0
  - lowrisc:prim:clock_inv:0
  - lowrisc:prim:edge_detector:0.1
  - lowrisc:prim:lc_sync:0.1
  - lowrisc:prim:mubi:0.1
  - lowrisc:prim:ram_2p_adv:0.1
  - lowrisc:prim:rst_sync:0
  lowrisc:ip:spi_device_pkg:0.1: []
  lowrisc:ip:spi_host:1.0:
  - lowrisc:constants:top_pkg:0
  - lowrisc:ip:spi_device_pkg:0.1
  - lowrisc:ip:tlul:0.1
  - lowrisc:prim:all:0.1
  - lowrisc:prim:flop_en:0
  lowrisc:ip:sram_ctrl:0.1:
  - lowrisc:ip:lc_ctrl_pkg:0.1
  - lowrisc:ip:otp_ctrl_pkg:1.0
  - lowrisc:ip:sram_ctrl_pkg:0.1
  - lowrisc:ip:tlul:0.1
  - lowrisc:prim:all:0.1
  - lowrisc:prim:count:0
  - lowrisc:prim:lc_sync:0.1
  - lowrisc:prim:ram_1p_scr:0.1
  - lowrisc:prim:util:0.1
  - lowrisc:tlul:adapter_sram:0.1
  lowrisc:ip:sram_ctrl_pkg:0.1:
  - lowrisc:ip:otp_ctrl_pkg:1.0
  - lowrisc:tlul:headers:0.1
  lowrisc:ip:sysrst_ctrl:1.0:
  - lowrisc:constants:top_pkg:0
  - lowrisc:ip:tlul:0.1
  - lowrisc:prim:all:0.1
  lowrisc:ip:tlul:0.1:
  - lowrisc:tlul:adapter_reg:0.1
  - lowrisc:tlul:adapter_sram:0.1
  - lowrisc:tlul:lc_gate:0.1
  - lowrisc:tlul:socket_1n:0.1
  - lowrisc:tlul:socket_m1:0.1
  - lowrisc:tlul:sram2tlul:0.1
  lowrisc:ip:uart:0.1:
  - lowrisc:constants:top_pkg:0
  - lowrisc:ip:tlul:0.1
  - lowrisc:prim:all:0.1
  lowrisc:ip:usb_fs_nb_pe:0.1:
  - lowrisc:prim:all:0.1
  - lowrisc:prim:flop:0
  lowrisc:ip:usbdev:0.1:
  - lowrisc:ip:tlul:0.1
  - lowrisc:ip:usb_fs_nb_pe:0.1
  - lowrisc:ip:usbdev_pkg:0.1
  - lowrisc:prim:all:0.1
  - lowrisc:prim:edge_detector:0.1
  - lowrisc:prim:ram_2p_adv:0.1
  - lowrisc:tlul:socket_1n:0.1
  lowrisc:ip:usbdev_pkg:0.1: []
  lowrisc:opentitan:top_earlgrey_alert_handler:0.1:
  - lowrisc:ip:alert_handler_component:0.1
  - lowrisc:opentitan:top_earlgrey_alert_handler_reg:0.1
  lowrisc:opentitan:top_earlgrey_alert_handler_reg:0.1:
  - lowrisc:ip:tlul:0.1
  - lowrisc:prim:subreg:0
  - lowrisc:tlul:headers:0.1
  lowrisc:opentitan:top_earlgrey_rv_plic:0:
  - lowrisc:ip:rv_plic_component:0.1
  - lowrisc:ip:tlul:0.1
  - lowrisc:prim:subreg:0
  lowrisc:prim:alert:0:
  - lowrisc:ip:lc_ctrl_pkg:0.1
  - lowrisc:prim:assert:0.1
  - lowrisc:prim:buf:0
  - lowrisc:prim:diff_decode:0
  - lowrisc:prim:flop:0
  - lowrisc:prim:mubi:0.1
  - lowrisc:prim:sec_anchor:0.1
  lowrisc:prim:all:0.1:
  - lowrisc:prim:alert:0
  - lowrisc:prim:and2:0
  - lowrisc:prim:arbiter:0
  - lowrisc:prim:assert:0.1
  - lowrisc:prim:buf:0
  - lowrisc:prim:cipher:0
  - lowrisc:prim:clock_inv:0
  - lowrisc:prim:clock_mux2:0
  - lowrisc:prim:diff_decode:0
  - lowrisc:prim:esc:0
  - lowrisc:prim:fifo:0
  - lowrisc:prim:flop:0
  - lowrisc:prim:flop_2sync:0
  - lowrisc:prim:flop_en:0
  - lowrisc:prim:pad_wrapper:0
  - lowrisc:prim:prim_pkg:0.1
  - lowrisc:prim:reg_we_check:0
  - lowrisc:prim:rst_sync:0
  - lowrisc:prim:subreg:0
  - lowrisc:prim:util:0.1
  - lowrisc:prim:xnor2:0
  - lowrisc:prim:xor2:0
  lowrisc:prim:and2:0:
  - lowrisc:prim_abstract:and2:0
  - lowrisc:prim:assert:0.1
  - lowrisc:prim:prim_pkg:0.1
  - lowrisc:prim:primgen:0.1
  lowrisc:prim:arbiter:0:
  - lowrisc:prim:assert:0.1
  lowrisc:prim:assert:0.1: []
  lowrisc:prim:blanker:0:
  - lowrisc:prim:and2:0
  lowrisc:prim:buf:0:
  - lowrisc:prim_abstract:buf:0
  - lowrisc:prim:assert:0.1
  - lowrisc:prim:prim_pkg:0.1
  - lowrisc:prim:primgen:0.1
  lowrisc:prim:cdc_rand_delay:0:
  - lowrisc:dv:dv_macros:0
  - lowrisc:prim:assert:0.1
  lowrisc:prim:cipher:0:
  - lowrisc:prim:assert:0.1
  - lowrisc:prim:cipher_pkg:0.1
  lowrisc:prim:cipher_pkg:0.1: []
  lowrisc:prim:clock_buf:0:
  - lowrisc:prim_abstract:clock_buf:0
  - lowrisc:prim:assert:0.1
  - lowrisc:prim:prim_pkg:0.1
  - lowrisc:prim:primgen:0.1
  lowrisc:prim:clock_div:0:
  - lowrisc:prim_abstract:clock_div:0
  - lowrisc:prim:prim_pkg:0.1
  - lowrisc:prim:primgen:0.1
  lowrisc:prim:clock_gating:0:
  - lowrisc:prim_abstract:clock_gating:0
  - lowrisc:prim:prim_pkg:0.1
  - lowrisc:prim:primgen:0.1
  lowrisc:prim:clock_inv:0:
  - lowrisc:prim_abstract:clock_inv:0
  - lowrisc:prim:prim_pkg:0.1
  - lowrisc:prim:primgen:0.1
  lowrisc:prim:clock_mux2:0:
  - lowrisc:prim_abstract:clock_mux2:0
  - lowrisc:prim:prim_pkg:0.1
  - lowrisc:prim:primgen:0.1
  lowrisc:prim:count:0:
  - lowrisc:prim:assert:0.1
  lowrisc:prim:crc32:0: []
  lowrisc:prim:diff_decode:0:
  - lowrisc:prim:assert:0.1
  - lowrisc:prim:flop_2sync:0
  lowrisc:prim:double_lfsr:0:
  - lowrisc:prim:assert:0.1
  - lowrisc:prim:buf:0
  - lowrisc:prim:lfsr:0.1
  lowrisc:prim:edge_detector:0.1:
  - lowrisc:prim:assert:0.1
  - lowrisc:prim:flop_2sync:0
  lowrisc:prim:edn_req:0.1:
  - lowrisc:ip:edn_pkg:0.1
  - lowrisc:prim:all:0.1
  - lowrisc:prim:assert:0.1
  lowrisc:prim:esc:0:
  - lowrisc:prim:assert:0.1
  - lowrisc:prim:buf:0
  - lowrisc:prim:count:0
  - lowrisc:prim:diff_decode:0
  - lowrisc:prim:flop:0
  - lowrisc:prim:sec_anchor:0.1
  lowrisc:prim:fifo:0:
  - lowrisc:prim:assert:0.1
  - lowrisc:prim:flop_2sync:0
  - lowrisc:prim:util:0.1
  lowrisc:prim:flash:0:
  - lowrisc:prim_abstract:flash:0
  - lowrisc:prim:clock_gating:0
  - lowrisc:prim:clock_inv:0
  - lowrisc:prim:prim_pkg:0.1
  - lowrisc:prim:primgen:0.1
  - lowrisc:prim:ram_1p:0
  lowrisc:prim:flop:0:
  - lowrisc:prim_abstract:flop:0
  - lowrisc:prim:assert:0.1
  - lowrisc:prim:prim_pkg:0.1
  - lowrisc:prim:primgen:0.1
  lowrisc:prim:flop_2sync:0:
  - lowrisc:prim:cdc_rand_delay:0
  - lowrisc:prim:flop:0
  - lowrisc:prim:prim_pkg:0.1
  lowrisc:prim:flop_en:0:
  - lowrisc:prim_abstract:flop_en:0
  - lowrisc:prim:prim_pkg:0.1
  - lowrisc:prim:primgen:0.1
  lowrisc:prim:gf_mult:0:
  - lowrisc:prim:assert:0.1
  lowrisc:prim:lc_dec:0.1:
  - lowrisc:ip:lc_ctrl_pkg:0.1
  - lowrisc:prim:buf:0
  lowrisc:prim:lc_or_hardened:0.1:
  - lowrisc:ip:lc_ctrl_pkg:0.1
  - lowrisc:prim:assert:0.1
  - lowrisc:prim:lc_sync:0.1
  lowrisc:prim:lc_sender:0.1:
  - lowrisc:ip:lc_ctrl_pkg:0.1
  - lowrisc:prim:assert:0.1
  - lowrisc:prim:flop:0
  lowrisc:prim:lc_sync:0.1:
  - lowrisc:ip:lc_ctrl_pkg:0.1
  - lowrisc:prim:assert:0.1
  - lowrisc:prim:buf:0
  - lowrisc:prim:flop_2sync:0
  lowrisc:prim:lfsr:0.1:
  - lowrisc:prim:assert:0.1
  - lowrisc:prim:cipher_pkg:0.1
  lowrisc:prim:macros:0.1: []
  lowrisc:prim:max_tree:0:
  - lowrisc:prim:assert:0.1
  lowrisc:prim:measure:0:
  - lowrisc:prim:all:0.1
  - lowrisc:prim:assert:0.1
  - lowrisc:prim:flop_2sync:0
  lowrisc:prim:msb_extend:0:
  - lowrisc:prim:assert:0.1
  lowrisc:prim:mubi:0.1:
  - lowrisc:prim:assert:0.1
  - lowrisc:prim:buf:0
  - lowrisc:prim:flop:0
  lowrisc:prim:multibit_sync:0.1:
  - lowrisc:prim:assert:0.1
  - lowrisc:prim:flop_2sync:0
  lowrisc:prim:onehot:0:
  - lowrisc:prim:util:0.1
  lowrisc:prim:onehot_check:0:
  - lowrisc:prim:assert:0.1
  - lowrisc:prim:prim_pkg:0.1
  - lowrisc:prim:util:0.1
  lowrisc:prim:otp:0:
  - lowrisc:prim_abstract:otp:0
  - lowrisc:prim:clock_gating:0
  - lowrisc:prim:clock_inv:0
  - lowrisc:prim:prim_pkg:0.1
  - lowrisc:prim:primgen:0.1
  lowrisc:prim:otp_pkg:0.1: []
  lowrisc:prim:pad_attr:0:
  - lowrisc:prim_abstract:pad_attr:0
  - lowrisc:prim:pad_wrapper_pkg:0
  - lowrisc:prim:prim_pkg:0.1
  - lowrisc:prim:primgen:0.1
  lowrisc:prim:pad_wrapper:0:
  - lowrisc:prim_abstract:pad_wrapper:0
  - lowrisc:prim:pad_wrapper_pkg:0
  - lowrisc:prim:prim_pkg:0.1
  - lowrisc:prim:primgen:0.1
  lowrisc:prim:pad_wrapper_pkg:0: []
  lowrisc:prim:prim_dom_and_2share:0.1:
  - lowrisc:prim:assert:0.1
  lowrisc:prim:prim_pkg:0.1:
  - lowrisc:prim_abstract:prim_pkg:0.1
  - lowrisc:prim:primgen:0.1
  lowrisc:prim:primgen:0.1: []
  lowrisc:prim:ram_1p:0:
  - lowrisc:prim_abstract:ram_1p:0
  - lowrisc:prim:prim_pkg:0.1
  - lowrisc:prim:primgen:0.1
  - lowrisc:prim:ram_1p_pkg:0
  lowrisc:prim:ram_1p_adv:0.1:
  - lowrisc:prim:assert:0.1
  - lowrisc:prim:ram_1p:0
  - lowrisc:prim:secded:0.1
  - lowrisc:prim:util:0.1
  lowrisc:prim:ram_1p_pkg:0: []
  lowrisc:prim:ram_1p_scr:0.1:
  - lowrisc:dv_verilator:memutil_dpi_scrambled:0
  - lowrisc:prim:assert:0.1
  - lowrisc:prim:buf:0
  - lowrisc:prim:cipher:0
  - lowrisc:prim:lfsr:0.1
  - lowrisc:prim:ram_1p_adv:0.1
  - lowrisc:prim:util:0.1
  - lowrisc:prim:util_get_scramble_params:0
  lowrisc:prim:ram_2p:0:
  - lowrisc:prim_abstract:ram_2p:0
  - lowrisc:prim:prim_pkg:0.1
  - lowrisc:prim:primgen:0.1
  - lowrisc:prim:ram_2p_pkg:0
  lowrisc:prim:ram_2p_adv:0.1:
  - lowrisc:prim:ram_2p_async_adv:0.1
  lowrisc:prim:ram_2p_async_adv:0.1:
  - lowrisc:prim:assert:0.1
  - lowrisc:prim:ram_2p:0
  - lowrisc:prim:secded:0.1
  - lowrisc:prim:util:0.1
  lowrisc:prim:ram_2p_pkg:0: []
  lowrisc:prim:reg_we_check:0:
  - lowrisc:prim:buf:0
  - lowrisc:prim:onehot_check:0
  - lowrisc:prim:util:0.1
  lowrisc:prim:rom:0:
  - lowrisc:prim_abstract:rom:0
  - lowrisc:prim:prim_pkg:0.1
  - lowrisc:prim:primgen:0.1
  - lowrisc:prim:rom_pkg:0
  lowrisc:prim:rom_adv:0.1:
  - lowrisc:prim:assert:0.1
  - lowrisc:prim:rom:0
  lowrisc:prim:rom_pkg:0: []
  lowrisc:prim:rst_sync:0:
  - lowrisc:prim:cdc_rand_delay:0
  - lowrisc:prim:flop_2sync:0
  - lowrisc:prim:mubi:0.1
  - lowrisc:prim:prim_pkg:0.1
  lowrisc:prim:sec_anchor:0.1:
  - lowrisc:prim:assert:0.1
  lowrisc:prim:secded:0.1: []
  lowrisc:prim:sparse_fsm:0:
  - lowrisc:prim:assert:0.1
  lowrisc:prim:subreg:0:
  - lowrisc:prim:assert:0.1
  - lowrisc:prim:mubi:0.1
  lowrisc:prim:sum_tree:0:
  - lowrisc:prim:assert:0.1
  lowrisc:prim:usb_diff_rx:0:
  - lowrisc:prim_abstract:usb_diff_rx:0
  - lowrisc:prim:assert:0.1
  - lowrisc:prim:prim_pkg:0.1
  - lowrisc:prim:primgen:0.1
  lowrisc:prim:util:0.1:
  - lowrisc:prim:assert:0.1
  lowrisc:prim:util_get_scramble_params:0: []
  lowrisc:prim:util_memload:0: []
  lowrisc:prim:xnor2:0:
  - lowrisc:prim_abstract:xnor2:0
  - lowrisc:prim:assert:0.1
  - lowrisc:prim:prim_pkg:0.1
  - lowrisc:prim:primgen:0.1
  lowrisc:prim:xor2:0:
  - lowrisc:prim_abstract:xor2:0
  - lowrisc:prim:assert:0.1
  - lowrisc:prim:prim_pkg:0.1
  - lowrisc:prim:primgen:0.1
  lowrisc:prim:xoshiro256pp:0:
  - lowrisc:prim:assert:0.1
  lowrisc:prim_abstract:and2:0:
  - lowrisc:prim_generic:and2:0
  - lowrisc:prim:prim_pkg:0.1
  - lowrisc:prim_xilinx:and2:0
  - lowrisc:prim_xilinx_ultrascale:and2:0
  lowrisc:prim_abstract:buf:0:
  - lowrisc:prim_generic:buf:0
  - lowrisc:prim:prim_pkg:0.1
  - lowrisc:prim_xilinx:buf:0
  - lowrisc:prim_xilinx_ultrascale:buf:0
  lowrisc:prim_abstract:clock_buf:0:
  - lowrisc:prim_generic:clock_buf:0
  - lowrisc:prim:prim_pkg:0.1
  - lowrisc:prim_xilinx:clock_buf:0
  - lowrisc:prim_xilinx_ultrascale:clock_buf:0
  lowrisc:prim_abstract:clock_div:0:
  - lowrisc:prim_generic:clock_div:0
  - lowrisc:prim:prim_pkg:0.1
  - lowrisc:prim_xilinx_ultrascale:clock_div:0
  lowrisc:prim_abstract:clock_gating:0:
  - lowrisc:prim_generic:clock_gating:0
  - lowrisc:prim:prim_pkg:0.1
  - lowrisc:prim_xilinx:clock_gating:0
  - lowrisc:prim_xilinx_ultrascale:clock_gating:0
  lowrisc:prim_abstract:clock_inv:0:
  - lowrisc:prim_generic:clock_inv:0
  - lowrisc:prim:prim_pkg:0.1
  - lowrisc:prim_xilinx_ultrascale:clock_inv:0
  lowrisc:prim_abstract:clock_mux2:0:
  - lowrisc:prim_generic:clock_mux2:0
  - lowrisc:prim:prim_pkg:0.1
  - lowrisc:prim_xilinx:clock_mux2:0
  - lowrisc:prim_xilinx_ultrascale:clock_mux2:0
  lowrisc:prim_abstract:flash:0:
  - lowrisc:prim_generic:flash:0
  - lowrisc:prim:prim_pkg:0.1
  lowrisc:prim_abstract:flop:0:
  - lowrisc:prim_generic:flop:0
  - lowrisc:prim:prim_pkg:0.1
  - lowrisc:prim_xilinx:flop:0
  - lowrisc:prim_xilinx_ultrascale:flop:0
  lowrisc:prim_abstract:flop_en:0:
  - lowrisc:prim_generic:flop_en:0
  - lowrisc:prim:prim_pkg:0.1
  - lowrisc:prim_xilinx:flop_en:0
  - lowrisc:prim_xilinx_ultrascale:flop_en:0
  lowrisc:prim_abstract:otp:0:
  - lowrisc:prim_generic:otp:0
  - lowrisc:prim:prim_pkg:0.1
  lowrisc:prim_abstract:pad_attr:0:
  - lowrisc:prim_generic:pad_attr:0
  - lowrisc:prim:prim_pkg:0.1
  - lowrisc:prim_xilinx:pad_attr:0
  - lowrisc:prim_xilinx_ultrascale:pad_attr:0
  lowrisc:prim_abstract:pad_wrapper:0:
  - lowrisc:prim_generic:pad_wrapper:0
  - lowrisc:prim:prim_pkg:0.1
  - lowrisc:prim_xilinx:pad_wrapper:0
  - lowrisc:prim_xilinx_ultrascale:pad_wrapper:0
  lowrisc:prim_abstract:prim_pkg:0.1: []
  lowrisc:prim_abstract:ram_1p:0:
  - lowrisc:prim_badbit:ram_1p:0
  - lowrisc:prim_generic:ram_1p:0
  - lowrisc:prim:prim_pkg:0.1
  lowrisc:prim_abstract:ram_2p:0:
  - lowrisc:prim_generic:ram_2p:0
  - lowrisc:prim:prim_pkg:0.1
  lowrisc:prim_abstract:rom:0:
  - lowrisc:prim_generic:rom:0
  - lowrisc:prim:prim_pkg:0.1
  lowrisc:prim_abstract:usb_diff_rx:0:
  - lowrisc:prim_generic:usb_diff_rx:0
  - lowrisc:prim:prim_pkg:0.1
  lowrisc:prim_abstract:xnor2:0:
  - lowrisc:prim_generic:xnor2:0
  - lowrisc:prim:prim_pkg:0.1
  lowrisc:prim_abstract:xor2:0:
  - lowrisc:prim_generic:xor2:0
  - lowrisc:prim:prim_pkg:0.1
  - lowrisc:prim_xilinx_ultrascale:xor2:0
  - lowrisc:prim_xilinx:xor2:0
  lowrisc:prim_badbit:ram_1p:0:
  - lowrisc:prim:assert:0.1
  - lowrisc:prim_generic:ram_1p:0
  lowrisc:prim_generic:and2:0: []
  lowrisc:prim_generic:buf:0: []
  lowrisc:prim_generic:clock_buf:0: []
  lowrisc:prim_generic:clock_div:0:
  - lowrisc:prim:clock_buf:0
  - lowrisc:prim:clock_inv:0
  - lowrisc:prim:flop:0
  - lowrisc:prim:prim_pkg:0.1
  lowrisc:prim_generic:clock_gating:0: []
  lowrisc:prim_generic:clock_inv:0:
  - lowrisc:prim:assert:0.1
  - lowrisc:prim:clock_mux2:0
  lowrisc:prim_generic:clock_mux2:0:
  - lowrisc:prim:assert:0.1
  lowrisc:prim_generic:flash:0:
  - lowrisc:ip:flash_ctrl_pkg:0.1
  - lowrisc:ip:flash_ctrl_prim_reg_top:1.0
  - lowrisc:ip:tlul:0.1
  - lowrisc:prim:ram_1p:0
  - lowrisc:systems:ast_pkg:0
  lowrisc:prim_generic:flop:0: []
  lowrisc:prim_generic:flop_en:0:
  - lowrisc:prim:sec_anchor:0.1
  lowrisc:prim_generic:otp:0:
  - lowrisc:ip:otp_ctrl_prim_reg_top:1.0
  - lowrisc:prim:all:0.1
  - lowrisc:prim:otp_pkg:0.1
  - lowrisc:prim:ram_1p_adv:0.1
  - lowrisc:prim:util:0.1
  - lowrisc:systems:ast_pkg:0
  lowrisc:prim_generic:pad_attr:0:
  - lowrisc:prim:assert:0.1
  - lowrisc:prim:pad_wrapper_pkg:0
  lowrisc:prim_generic:pad_wrapper:0:
  - lowrisc:prim:assert:0.1
  - lowrisc:prim:pad_wrapper_pkg:0
  lowrisc:prim_generic:ram_1p:0:
  - lowrisc:prim:assert:0.1
  - lowrisc:prim:ram_1p_pkg:0
  - lowrisc:prim:util_memload:0
  lowrisc:prim_generic:ram_2p:0:
  - lowrisc:prim:assert:0.1
  - lowrisc:prim:ram_2p_pkg:0
  - lowrisc:prim:util_memload:0
  lowrisc:prim_generic:rom:0:
  - lowrisc:prim:assert:0.1
  - lowrisc:prim:rom_pkg:0
  - lowrisc:prim:util_memload:0
  lowrisc:prim_generic:usb_diff_rx:0: []
  lowrisc:prim_generic:xnor2:0: []
  lowrisc:prim_generic:xor2:0: []
  lowrisc:prim_xilinx:and2:0: []
  lowrisc:prim_xilinx:buf:0: []
  lowrisc:prim_xilinx:clock_buf:0: []
  lowrisc:prim_xilinx:clock_gating:0: []
  lowrisc:prim_xilinx:clock_mux2:0: []
  lowrisc:prim_xilinx:flop:0: []
  lowrisc:prim_xilinx:flop_en:0: []
  lowrisc:prim_xilinx:pad_attr:0:
  - lowrisc:prim:assert:0.1
  - lowrisc:prim:pad_wrapper_pkg:0
  lowrisc:prim_xilinx:pad_wrapper:0:
  - lowrisc:prim:assert:0.1
  - lowrisc:prim:pad_wrapper_pkg:0
  lowrisc:prim_xilinx:xor2:0: []
  lowrisc:prim_xilinx_ultrascale:and2:0: []
  lowrisc:prim_xilinx_ultrascale:buf:0: []
  lowrisc:prim_xilinx_ultrascale:clock_buf:0: []
  lowrisc:prim_xilinx_ultrascale:clock_div:0:
  - lowrisc:prim:clock_buf:0
  - lowrisc:prim:clock_inv:0
  - lowrisc:prim:flop:0
  - lowrisc:prim:prim_pkg:0.1
  lowrisc:prim_xilinx_ultrascale:clock_gating:0: []
  lowrisc:prim_xilinx_ultrascale:clock_inv:0: []
  lowrisc:prim_xilinx_ultrascale:clock_mux2:0: []
  lowrisc:prim_xilinx_ultrascale:flop:0: []
  lowrisc:prim_xilinx_ultrascale:flop_en:0: []
  lowrisc:prim_xilinx_ultrascale:pad_attr:0:
  - lowrisc:prim:assert:0.1
  - lowrisc:prim:pad_wrapper_pkg:0
  lowrisc:prim_xilinx_ultrascale:pad_wrapper:0:
  - lowrisc:prim:assert:0.1
  - lowrisc:prim:pad_wrapper_pkg:0
  lowrisc:prim_xilinx_ultrascale:xor2:0: []
  lowrisc:systems:ast:0.1:
  - lowrisc:ip:edn_pkg:0.1
  - lowrisc:opentitan:top_earlgrey_alert_handler_reg:0.1
  - lowrisc:ip:lc_ctrl_pkg:0.1
  - lowrisc:ip:pinmux_component:0.1
  - lowrisc:ip:pinmux_reg:0.1
  - lowrisc:ip:rstmgr_pkg:0.1
  - lowrisc:ip:tlul:0.1
  - lowrisc:prim:all:0.1
  - lowrisc:prim:assert:0.1
  - lowrisc:prim:clock_buf:0
  - lowrisc:prim:clock_div:0
  - lowrisc:prim:clock_gating:0
  - lowrisc:prim:clock_inv:0
  - lowrisc:prim:lc_dec:0.1
  - lowrisc:prim:lfsr:0.1
  - lowrisc:prim:mubi:0.1
  - lowrisc:prim:multibit_sync:0.1
  - lowrisc:prim:prim_pkg:0.1
  - lowrisc:systems:clkmgr_pkg:0.1
  lowrisc:systems:ast_pkg:0:
  - lowrisc:constants:top_pkg:0
  - lowrisc:ip:lc_ctrl_pkg:0.1
  lowrisc:systems:chip_earlgrey_cw310:0.1:
  - lowrisc:systems:ast:0.1
  - lowrisc:systems:padring:0.1
  - lowrisc:systems:top_earlgrey:0.1
  - lowrisc:systems:top_earlgrey_pkg:0.1
  lowrisc:systems:clkmgr:0.1:
  - lowrisc:ip:clkmgr_components:0.1
  - lowrisc:ip:lc_ctrl_pkg:0.1
  - lowrisc:ip:pwrmgr_pkg:0.1
  - lowrisc:ip:tlul:0.1
  - lowrisc:prim:all:0.1
  - lowrisc:prim:buf:0
  - lowrisc:prim:clock_buf:0
  - lowrisc:prim:clock_div:0
  - lowrisc:prim:clock_gating:0
  - lowrisc:prim:edge_detector:0.1
  - lowrisc:prim:lc_sender:0.1
  - lowrisc:prim:lc_sync:0.1
  - lowrisc:systems:clkmgr_pkg:0.1
  lowrisc:systems:clkmgr_pkg:0.1:
  - lowrisc:constants:top_pkg:0
  - lowrisc:ip:pwrmgr_pkg:0.1
  lowrisc:systems:flash_ctrl:0.1:
  - lowrisc:ip:flash_ctrl_pkg:0.1
  lowrisc:systems:flash_ctrl_pkg:0.1:
  - lowrisc:constants:top_pkg:0
  - lowrisc:ip:edn_pkg:0.1
  - lowrisc:prim:util:0.1
  lowrisc:systems:padring:0.1:
  - lowrisc:ip:pinmux_component:0.1
  - lowrisc:systems:physical_pads:0.1
  lowrisc:systems:physical_pads:0.1:
  - lowrisc:prim:assert:0.1
  lowrisc:systems:pinmux_reg:0.1:
  - lowrisc:tlul:headers:0.1
  lowrisc:systems:rstmgr:0.1:
  - lowrisc:ip:rstmgr_pkg:0.1
  - lowrisc:prim:mubi:0.1
  lowrisc:systems:rstmgr_pkg:0.1:
  - lowrisc:ip:alert_handler_component:0.1
  - lowrisc:opentitan:top_earlgrey_alert_handler_reg:0.1
  - lowrisc:ip:pwrmgr_pkg:0.1
  - lowrisc:ip:rstmgr_reg:0.1
  lowrisc:systems:rstmgr_reg:0.1:
  - lowrisc:tlul:headers:0.1
  lowrisc:systems:sensor_ctrl:0.1:
  - lowrisc:prim:assert:0.1
  - lowrisc:prim:edge_detector:0.1
  - lowrisc:prim:mubi:0.1
  - lowrisc:systems:sensor_ctrl_pkg:0.1
  lowrisc:systems:sensor_ctrl_pkg:0.1:
  - lowrisc:constants:top_pkg:0
  - lowrisc:systems:ast_pkg:0
  - lowrisc:systems:sensor_ctrl_reg:0.1
  lowrisc:systems:sensor_ctrl_reg:0.1:
  - lowrisc:constants:top_pkg:0
  - lowrisc:ip:tlul:0.1
  - lowrisc:prim:all:0.1
  lowrisc:systems:top_earlgrey:0.1:
  - lowrisc:constants:jtag_id_pkg:0
  - lowrisc:constants:top_pkg:0
  - lowrisc:ip:adc_ctrl:1.0
  - lowrisc:ip:aes:1.0
  - lowrisc:ip:aon_timer:0.1
  - lowrisc:ip:csrng:0.1
  - lowrisc:ip:edn:0.1
  - lowrisc:ip:entropy_src:0.1
  - lowrisc:ip:flash_ctrl:0.1
  - lowrisc:ip:gpio:0.1
  - lowrisc:ip:hmac:0.1
  - lowrisc:ip:i2c:0.1
  - lowrisc:ip:keymgr:0.1
  - lowrisc:ip:kmac:0.1
  - lowrisc:ip:lc_ctrl:0.1
  - lowrisc:ip:otbn:0.1
  - lowrisc:ip:otp_ctrl:1.0
  - lowrisc:ip:pattgen:0.1
  - lowrisc:ip:pinmux:0.1
  - lowrisc:ip:puf:1.0
  - lowrisc:ip:pwm:0.1
  - lowrisc:ip:pwrmgr:0.1
  - lowrisc:ip:rom_ctrl:0.1
  - lowrisc:ip:rs_decode:1.0
  - lowrisc:ip:rs_encode:1.0
  - lowrisc:ip:rstmgr:0.1
  - lowrisc:ip:rv_core_ibex:0.1
  - lowrisc:ip:rv_dm:0.1
  - lowrisc:ip:rv_timer:0.1
  - lowrisc:ip:sm3:1.0
  - lowrisc:ip:sm4:1.0
  - lowrisc:ip:spi_device:0.1
  - lowrisc:ip:spi_host:1.0
  - lowrisc:ip:sram_ctrl:0.1
  - lowrisc:ip:sysrst_ctrl:1.0
  - lowrisc:ip:tlul:0.1
  - lowrisc:ip:uart:0.1
  - lowrisc:ip:usbdev:0.1
  - lowrisc:opentitan:top_earlgrey_alert_handler:0.1
  - lowrisc:opentitan:top_earlgrey_rv_plic:0
  - lowrisc:prim:all:0.1
  - lowrisc:prim:flash:0
  - lowrisc:prim:mubi:0.1
  - lowrisc:prim:ram_1p_scr:0.1
  - lowrisc:prim:usb_diff_rx:0
  - lowrisc:systems:ast_pkg:0
  - lowrisc:systems:clkmgr:0.1
  - lowrisc:systems:sensor_ctrl:0.1
  - lowrisc:systems:top_earlgrey_pkg:0.1
  - lowrisc:tlul:headers:0.1
  - lowrisc:top_earlgrey:xbar_main:0.1
  - lowrisc:top_earlgrey:xbar_peri:0.1
  lowrisc:systems:top_earlgrey_pkg:0.1: []
  lowrisc:tlul:adapter_host:0.1:
  - lowrisc:constants:top_pkg:0
  - lowrisc:prim:all:0.1
  - lowrisc:tlul:common:0.1
  - lowrisc:tlul:trans_intg:0.1
  lowrisc:tlul:adapter_reg:0.1:
  - lowrisc:prim:assert:0.1
  - lowrisc:prim:secded:0.1
  - lowrisc:tlul:common:0.1
  - lowrisc:tlul:trans_intg:0.1
  lowrisc:tlul:adapter_sram:0.1:
  - lowrisc:prim:assert:0.1
  - lowrisc:prim:util:0.1
  - lowrisc:tlul:common:0.1
  lowrisc:tlul:common:0.1:
  - lowrisc:dv:pins_if:0
  - lowrisc:prim:assert:0.1
  - lowrisc:prim:fifo:0
  - lowrisc:tlul:headers:0.1
  - lowrisc:tlul:trans_intg:0.1
  lowrisc:tlul:headers:0.1:
  - lowrisc:constants:top_pkg:0
  - lowrisc:prim:mubi:0.1
  - lowrisc:prim:secded:0.1
  lowrisc:tlul:lc_gate:0.1:
  - lowrisc:ip:lc_ctrl_pkg:0.1
  - lowrisc:prim:assert:0.1
  - lowrisc:prim:blanker:0
  - lowrisc:prim:sparse_fsm:0
  - lowrisc:tlul:common:0.1
  lowrisc:tlul:socket_1n:0.1:
  - lowrisc:prim:assert:0.1
  - lowrisc:tlul:common:0.1
  - lowrisc:tlul:headers:0.1
  lowrisc:tlul:socket_m1:0.1:
  - lowrisc:prim:arbiter:0
  - lowrisc:prim:assert:0.1
  - lowrisc:tlul:common:0.1
  - lowrisc:tlul:headers:0.1
  lowrisc:tlul:sram2tlul:0.1:
  - lowrisc:prim:assert:0.1
  - lowrisc:tlul:common:0.1
  lowrisc:tlul:trans_intg:0.1:
  - lowrisc:prim:assert:0.1
  - lowrisc:prim:secded:0.1
  - lowrisc:tlul:headers:0.1
  lowrisc:tool:check_tool_requirements:0.1: []
  lowrisc:top_earlgrey:xbar_main:0.1:
  - lowrisc:ip:lc_ctrl_pkg:0.1
  - lowrisc:ip:tlul:0.1
  lowrisc:top_earlgrey:xbar_peri:0.1:
  - lowrisc:ip:lc_ctrl_pkg:0.1
  - lowrisc:ip:tlul:0.1
  pulp-platform:riscv-dbg:0.1:0:
  - lowrisc:prim:all:0.1
  - lowrisc:prim:clock_inv:0
files:
- core: lowrisc:constants:jtag_id_pkg:0
  file_type: systemVerilogSource
  name: ../src/lowrisc_constants_jtag_id_pkg_0/rtl/jtag_id_pkg.sv
- core: lowrisc:constants:top_pkg:0
  file_type: systemVerilogSource
  name: ../src/lowrisc_constants_top_pkg_0/rtl/top_pkg.sv
- core: lowrisc:dv:crypto_prince_ref:0.1
  file_type: cSource
  is_include_file: true
  name: ../src/lowrisc_dv_crypto_prince_ref_0.1/prince_ref.h
- core: lowrisc:dv:dv_fcov_macros:0
  file_type: systemVerilogSource
  is_include_file: true
  name: ../src/lowrisc_dv_dv_fcov_macros_0/dv_fcov_macros.svh
- core: lowrisc:dv:dv_macros:0
  file_type: systemVerilogSource
  is_include_file: true
  name: ../src/lowrisc_dv_dv_macros_0/dv_macros.svh
- core: lowrisc:dv:pins_if:0
  file_type: systemVerilogSource
  name: ../src/lowrisc_dv_pins_if_0/pins_if.sv
- core: lowrisc:dv:secded_enc:0
  file_type: cSource
  is_include_file: true
  name: ../src/lowrisc_dv_secded_enc_0/secded_enc.h
- core: lowrisc:dv:secded_enc:0
  file_type: cSource
  name: ../src/lowrisc_dv_secded_enc_0/secded_enc.c
- core: lowrisc:ibex:ibex_pkg:0.1
  file_type: systemVerilogSource
  name: ../src/lowrisc_ibex_ibex_pkg_0.1/rtl/ibex_pkg.sv
- core: lowrisc:ip:entropy_src_ack_sm_pkg:0.1
  file_type: systemVerilogSource
  name: ../src/lowrisc_ip_entropy_src_ack_sm_pkg_0.1/entropy_src_ack_sm_pkg.sv
- core: lowrisc:ip:entropy_src_main_sm_pkg:0.1
  file_type: systemVerilogSource
  name: ../src/lowrisc_ip_entropy_src_main_sm_pkg_0.1/entropy_src_main_sm_pkg.sv
- core: lowrisc:ip:entropy_src_pkg:0.1
  file_type: systemVerilogSource
  name: ../src/lowrisc_ip_entropy_src_pkg_0.1/rtl/entropy_src_pkg.sv
- core: lowrisc:ip:i2c_pkg:0.1
  file_type: systemVerilogSource
  name: ../src/lowrisc_ip_i2c_pkg_0.1/rtl/i2c_pkg.sv
- core: lowrisc:ip:jtag_pkg:0.1
  file_type: systemVerilogSource
  name: ../src/lowrisc_ip_jtag_pkg_0.1/rtl/jtag_pkg.sv
- core: lowrisc:ip:sm4_pkg:0.1
  file_type: systemVerilogSource
  name: ../src/lowrisc_ip_sm4_pkg_0.1/rtl/sm4_pkg.sv
- core: lowrisc:ip:spi_device_pkg:0.1
  file_type: systemVerilogSource
  name: ../src/lowrisc_ip_spi_device_pkg_0.1/rtl/spi_device_reg_pkg.sv
- core: lowrisc:ip:spi_device_pkg:0.1
  file_type: systemVerilogSource
  name: ../src/lowrisc_ip_spi_device_pkg_0.1/rtl/spi_device_pkg.sv
- core: lowrisc:ip:usbdev_pkg:0.1
  file_type: systemVerilogSource
  name: ../src/lowrisc_ip_usbdev_pkg_0.1/rtl/usbdev_pkg.sv
- core: lowrisc:prim_abstract:prim_pkg:0.1
  file_type: systemVerilogSource
  name: ../src/lowrisc_prim_abstract_prim_pkg_0.1/prim_pkg.sv
- core: lowrisc:prim:assert:0.1
  file_type: systemVerilogSource
  is_include_file: true
  name: ../src/lowrisc_prim_assert_0.1/rtl/prim_assert.sv
- core: lowrisc:prim:assert:0.1
  file_type: systemVerilogSource
  is_include_file: true
  name: ../src/lowrisc_prim_assert_0.1/rtl/prim_assert_dummy_macros.svh
- core: lowrisc:prim:assert:0.1
  file_type: systemVerilogSource
  is_include_file: true
  name: ../src/lowrisc_prim_assert_0.1/rtl/prim_assert_yosys_macros.svh
- core: lowrisc:prim:assert:0.1
  file_type: systemVerilogSource
  is_include_file: true
  name: ../src/lowrisc_prim_assert_0.1/rtl/prim_assert_standard_macros.svh
- core: lowrisc:prim:assert:0.1
  file_type: systemVerilogSource
  is_include_file: true
  name: ../src/lowrisc_prim_assert_0.1/rtl/prim_assert_sec_cm.svh
- core: lowrisc:prim:assert:0.1
  file_type: systemVerilogSource
  is_include_file: true
  name: ../src/lowrisc_prim_assert_0.1/rtl/prim_flop_macros.sv
- core: lowrisc:prim:cipher_pkg:0.1
  file_type: systemVerilogSource
  name: ../src/lowrisc_prim_cipher_pkg_0.1/rtl/prim_cipher_pkg.sv
- core: lowrisc:prim:crc32:0
  file_type: systemVerilogSource
  name: ../src/lowrisc_prim_crc32_0/rtl/prim_crc32.sv
- core: lowrisc:prim_generic:and2:0
  file_type: systemVerilogSource
  name: ../src/lowrisc_prim_generic_and2_0/rtl/prim_generic_and2.sv
- core: lowrisc:prim_generic:buf:0
  file_type: systemVerilogSource
  name: ../src/lowrisc_prim_generic_buf_0/rtl/prim_generic_buf.sv
- core: lowrisc:prim_generic:clock_buf:0
  file_type: systemVerilogSource
  name: ../src/lowrisc_prim_generic_clock_buf_0/rtl/prim_generic_clock_buf.sv
- core: lowrisc:prim_generic:clock_gating:0
  file_type: systemVerilogSource
  name: ../src/lowrisc_prim_generic_clock_gating_0/rtl/prim_generic_clock_gating.sv
- core: lowrisc:prim_generic:flop:0
  file_type: systemVerilogSource
  name: ../src/lowrisc_prim_generic_flop_0/rtl/prim_generic_flop.sv
- core: lowrisc:prim_generic:usb_diff_rx:0
  file_type: systemVerilogSource
  name: ../src/lowrisc_prim_generic_usb_diff_rx_0/rtl/prim_generic_usb_diff_rx.sv
- core: lowrisc:prim_generic:xnor2:0
  file_type: systemVerilogSource
  name: ../src/lowrisc_prim_generic_xnor2_0/rtl/prim_generic_xnor2.sv
- core: lowrisc:prim_generic:xor2:0
  file_type: systemVerilogSource
  name: ../src/lowrisc_prim_generic_xor2_0/rtl/prim_generic_xor2.sv
- core: lowrisc:prim:macros:0.1
  file_type: systemVerilogSource
  is_include_file: true
  name: ../src/lowrisc_prim_macros_0.1/rtl/prim_macros.svh
- core: lowrisc:prim:otp_pkg:0.1
  file_type: systemVerilogSource
  name: ../src/lowrisc_prim_otp_pkg_0.1/rtl/prim_otp_pkg.sv
- core: lowrisc:prim:pad_wrapper_pkg:0
  file_type: systemVerilogSource
  name: ../src/lowrisc_prim_pad_wrapper_pkg_0/rtl/prim_pad_wrapper_pkg.sv
- core: lowrisc:prim:ram_1p_pkg:0
  file_type: systemVerilogSource
  name: ../src/lowrisc_prim_ram_1p_pkg_0/rtl/prim_ram_1p_pkg.sv
- core: lowrisc:prim:ram_2p_pkg:0
  file_type: systemVerilogSource
  name: ../src/lowrisc_prim_ram_2p_pkg_0/rtl/prim_ram_2p_pkg.sv
- core: lowrisc:prim:rom_pkg:0
  file_type: systemVerilogSource
  name: ../src/lowrisc_prim_rom_pkg_0/rtl/prim_rom_pkg.sv
- core: lowrisc:prim:secded:0.1
  file_type: systemVerilogSource
  name: ../src/lowrisc_prim_secded_0.1/rtl/prim_secded_pkg.sv
- core: lowrisc:prim:secded:0.1
  file_type: systemVerilogSource
  name: ../src/lowrisc_prim_secded_0.1/rtl/prim_secded_22_16_dec.sv
- core: lowrisc:prim:secded:0.1
  file_type: systemVerilogSource
  name: ../src/lowrisc_prim_secded_0.1/rtl/prim_secded_22_16_enc.sv
- core: lowrisc:prim:secded:0.1
  file_type: systemVerilogSource
  name: ../src/lowrisc_prim_secded_0.1/rtl/prim_secded_28_22_dec.sv
- core: lowrisc:prim:secded:0.1
  file_type: systemVerilogSource
  name: ../src/lowrisc_prim_secded_0.1/rtl/prim_secded_28_22_enc.sv
- core: lowrisc:prim:secded:0.1
  file_type: systemVerilogSource
  name: ../src/lowrisc_prim_secded_0.1/rtl/prim_secded_39_32_dec.sv
- core: lowrisc:prim:secded:0.1
  file_type: systemVerilogSource
  name: ../src/lowrisc_prim_secded_0.1/rtl/prim_secded_39_32_enc.sv
- core: lowrisc:prim:secded:0.1
  file_type: systemVerilogSource
  name: ../src/lowrisc_prim_secded_0.1/rtl/prim_secded_64_57_dec.sv
- core: lowrisc:prim:secded:0.1
  file_type: systemVerilogSource
  name: ../src/lowrisc_prim_secded_0.1/rtl/prim_secded_64_57_enc.sv
- core: lowrisc:prim:secded:0.1
  file_type: systemVerilogSource
  name: ../src/lowrisc_prim_secded_0.1/rtl/prim_secded_72_64_dec.sv
- core: lowrisc:prim:secded:0.1
  file_type: systemVerilogSource
  name: ../src/lowrisc_prim_secded_0.1/rtl/prim_secded_72_64_enc.sv
- core: lowrisc:prim:secded:0.1
  file_type: systemVerilogSource
  name: ../src/lowrisc_prim_secded_0.1/rtl/prim_secded_hamming_22_16_dec.sv
- core: lowrisc:prim:secded:0.1
  file_type: systemVerilogSource
  name: ../src/lowrisc_prim_secded_0.1/rtl/prim_secded_hamming_22_16_enc.sv
- core: lowrisc:prim:secded:0.1
  file_type: systemVerilogSource
  name: ../src/lowrisc_prim_secded_0.1/rtl/prim_secded_hamming_39_32_dec.sv
- core: lowrisc:prim:secded:0.1
  file_type: systemVerilogSource
  name: ../src/lowrisc_prim_secded_0.1/rtl/prim_secded_hamming_39_32_enc.sv
- core: lowrisc:prim:secded:0.1
  file_type: systemVerilogSource
  name: ../src/lowrisc_prim_secded_0.1/rtl/prim_secded_hamming_72_64_dec.sv
- core: lowrisc:prim:secded:0.1
  file_type: systemVerilogSource
  name: ../src/lowrisc_prim_secded_0.1/rtl/prim_secded_hamming_72_64_enc.sv
- core: lowrisc:prim:secded:0.1
  file_type: systemVerilogSource
  name: ../src/lowrisc_prim_secded_0.1/rtl/prim_secded_hamming_76_68_dec.sv
- core: lowrisc:prim:secded:0.1
  file_type: systemVerilogSource
  name: ../src/lowrisc_prim_secded_0.1/rtl/prim_secded_hamming_76_68_enc.sv
- core: lowrisc:prim:secded:0.1
  file_type: systemVerilogSource
  name: ../src/lowrisc_prim_secded_0.1/rtl/prim_secded_inv_22_16_dec.sv
- core: lowrisc:prim:secded:0.1
  file_type: systemVerilogSource
  name: ../src/lowrisc_prim_secded_0.1/rtl/prim_secded_inv_22_16_enc.sv
- core: lowrisc:prim:secded:0.1
  file_type: systemVerilogSource
  name: ../src/lowrisc_prim_secded_0.1/rtl/prim_secded_inv_28_22_dec.sv
- core: lowrisc:prim:secded:0.1
  file_type: systemVerilogSource
  name: ../src/lowrisc_prim_secded_0.1/rtl/prim_secded_inv_28_22_enc.sv
- core: lowrisc:prim:secded:0.1
  file_type: systemVerilogSource
  name: ../src/lowrisc_prim_secded_0.1/rtl/prim_secded_inv_39_32_dec.sv
- core: lowrisc:prim:secded:0.1
  file_type: systemVerilogSource
  name: ../src/lowrisc_prim_secded_0.1/rtl/prim_secded_inv_39_32_enc.sv
- core: lowrisc:prim:secded:0.1
  file_type: systemVerilogSource
  name: ../src/lowrisc_prim_secded_0.1/rtl/prim_secded_inv_64_57_dec.sv
- core: lowrisc:prim:secded:0.1
  file_type: systemVerilogSource
  name: ../src/lowrisc_prim_secded_0.1/rtl/prim_secded_inv_64_57_enc.sv
- core: lowrisc:prim:secded:0.1
  file_type: systemVerilogSource
  name: ../src/lowrisc_prim_secded_0.1/rtl/prim_secded_inv_72_64_dec.sv
- core: lowrisc:prim:secded:0.1
  file_type: systemVerilogSource
  name: ../src/lowrisc_prim_secded_0.1/rtl/prim_secded_inv_72_64_enc.sv
- core: lowrisc:prim:secded:0.1
  file_type: systemVerilogSource
  name: ../src/lowrisc_prim_secded_0.1/rtl/prim_secded_inv_hamming_22_16_dec.sv
- core: lowrisc:prim:secded:0.1
  file_type: systemVerilogSource
  name: ../src/lowrisc_prim_secded_0.1/rtl/prim_secded_inv_hamming_22_16_enc.sv
- core: lowrisc:prim:secded:0.1
  file_type: systemVerilogSource
  name: ../src/lowrisc_prim_secded_0.1/rtl/prim_secded_inv_hamming_39_32_dec.sv
- core: lowrisc:prim:secded:0.1
  file_type: systemVerilogSource
  name: ../src/lowrisc_prim_secded_0.1/rtl/prim_secded_inv_hamming_39_32_enc.sv
- core: lowrisc:prim:secded:0.1
  file_type: systemVerilogSource
  name: ../src/lowrisc_prim_secded_0.1/rtl/prim_secded_inv_hamming_72_64_dec.sv
- core: lowrisc:prim:secded:0.1
  file_type: systemVerilogSource
  name: ../src/lowrisc_prim_secded_0.1/rtl/prim_secded_inv_hamming_72_64_enc.sv
- core: lowrisc:prim:secded:0.1
  file_type: systemVerilogSource
  name: ../src/lowrisc_prim_secded_0.1/rtl/prim_secded_inv_hamming_76_68_dec.sv
- core: lowrisc:prim:secded:0.1
  file_type: systemVerilogSource
  name: ../src/lowrisc_prim_secded_0.1/rtl/prim_secded_inv_hamming_76_68_enc.sv
- core: lowrisc:prim:util_get_scramble_params:0
  file_type: systemVerilogSource
  is_include_file: true
  name: ../src/lowrisc_prim_util_get_scramble_params_0/rtl/prim_util_get_scramble_params.svh
- core: lowrisc:prim:util_memload:0
  file_type: systemVerilogSource
  is_include_file: true
  name: ../src/lowrisc_prim_util_memload_0/rtl/prim_util_memload.svh
- core: lowrisc:prim_xilinx:and2:0
  file_type: systemVerilogSource
  name: ../src/lowrisc_prim_xilinx_and2_0/rtl/prim_xilinx_and2.sv
- core: lowrisc:prim_xilinx:buf:0
  file_type: systemVerilogSource
  name: ../src/lowrisc_prim_xilinx_buf_0/rtl/prim_xilinx_buf.sv
- core: lowrisc:prim_xilinx:clock_buf:0
  file_type: systemVerilogSource
  name: ../src/lowrisc_prim_xilinx_clock_buf_0/rtl/prim_xilinx_clock_buf.sv
- core: lowrisc:prim_xilinx:clock_gating:0
  file_type: systemVerilogSource
  name: ../src/lowrisc_prim_xilinx_clock_gating_0/rtl/prim_xilinx_clock_gating.sv
- core: lowrisc:prim_xilinx:clock_mux2:0
  file_type: systemVerilogSource
  name: ../src/lowrisc_prim_xilinx_clock_mux2_0/rtl/prim_xilinx_clock_mux2.sv
- core: lowrisc:prim_xilinx:flop:0
  file_type: systemVerilogSource
  name: ../src/lowrisc_prim_xilinx_flop_0/rtl/prim_xilinx_flop.sv
- core: lowrisc:prim_xilinx:flop_en:0
  file_type: systemVerilogSource
  name: ../src/lowrisc_prim_xilinx_flop_en_0/rtl/prim_xilinx_flop_en.sv
- core: lowrisc:prim_xilinx_ultrascale:and2:0
  file_type: systemVerilogSource
  name: ../src/lowrisc_prim_xilinx_ultrascale_and2_0/rtl/prim_xilinx_ultrascale_and2.sv
- core: lowrisc:prim_xilinx_ultrascale:buf:0
  file_type: systemVerilogSource
  name: ../src/lowrisc_prim_xilinx_ultrascale_buf_0/rtl/prim_xilinx_ultrascale_buf.sv
- core: lowrisc:prim_xilinx_ultrascale:clock_buf:0
  file_type: systemVerilogSource
  name: ../src/lowrisc_prim_xilinx_ultrascale_clock_buf_0/rtl/prim_xilinx_ultrascale_clock_buf.sv
- core: lowrisc:prim_xilinx_ultrascale:clock_gating:0
  file_type: systemVerilogSource
  name: ../src/lowrisc_prim_xilinx_ultrascale_clock_gating_0/rtl/prim_xilinx_ultrascale_clock_gating.sv
- core: lowrisc:prim_xilinx_ultrascale:clock_inv:0
  file_type: systemVerilogSource
  name: ../src/lowrisc_prim_xilinx_ultrascale_clock_inv_0/rtl/prim_xilinx_ultrascale_clock_inv.sv
- core: lowrisc:prim_xilinx_ultrascale:clock_mux2:0
  file_type: systemVerilogSource
  name: ../src/lowrisc_prim_xilinx_ultrascale_clock_mux2_0/rtl/prim_xilinx_ultrascale_clock_mux2.sv
- core: lowrisc:prim_xilinx_ultrascale:flop:0
  file_type: systemVerilogSource
  name: ../src/lowrisc_prim_xilinx_ultrascale_flop_0/rtl/prim_xilinx_ultrascale_flop.sv
- core: lowrisc:prim_xilinx_ultrascale:flop_en:0
  file_type: systemVerilogSource
  name: ../src/lowrisc_prim_xilinx_ultrascale_flop_en_0/rtl/prim_xilinx_ultrascale_flop_en.sv
- core: lowrisc:prim_xilinx_ultrascale:xor2:0
  file_type: systemVerilogSource
  name: ../src/lowrisc_prim_xilinx_ultrascale_xor2_0/rtl/prim_xilinx_ultrascale_xor2.sv
- core: lowrisc:prim_xilinx:xor2:0
  file_type: systemVerilogSource
  name: ../src/lowrisc_prim_xilinx_xor2_0/rtl/prim_xilinx_xor2.sv
- core: lowrisc:systems:top_earlgrey_pkg:0.1
  file_type: systemVerilogSource
  name: ../src/lowrisc_systems_top_earlgrey_pkg_0.1/rtl/autogen/top_earlgrey_pkg.sv
- core: lowrisc:tool:check_tool_requirements:0.1
  name: util/check_tool_requirements.py
- core: lowrisc:tool:check_tool_requirements:0.1
  name: tool_requirements.py
- core: lowrisc:dv:scramble_model:0
  file_type: cppSource
  name: ../src/lowrisc_dv_scramble_model_0/scramble_model.cc
- core: lowrisc:dv:scramble_model:0
  file_type: cppSource
  is_include_file: true
  name: ../src/lowrisc_dv_scramble_model_0/scramble_model.h
- core: lowrisc:dv_verilator:memutil_dpi:0
  file_type: cppSource
  name: ../src/lowrisc_dv_verilator_memutil_dpi_0/cpp/dpi_memutil.cc
- core: lowrisc:dv_verilator:memutil_dpi:0
  file_type: cppSource
  is_include_file: true
  name: ../src/lowrisc_dv_verilator_memutil_dpi_0/cpp/dpi_memutil.h
- core: lowrisc:dv_verilator:memutil_dpi:0
  file_type: cppSource
  name: ../src/lowrisc_dv_verilator_memutil_dpi_0/cpp/ecc32_mem_area.cc
- core: lowrisc:dv_verilator:memutil_dpi:0
  file_type: cppSource
  is_include_file: true
  name: ../src/lowrisc_dv_verilator_memutil_dpi_0/cpp/ecc32_mem_area.h
- core: lowrisc:dv_verilator:memutil_dpi:0
  file_type: cppSource
  name: ../src/lowrisc_dv_verilator_memutil_dpi_0/cpp/mem_area.cc
- core: lowrisc:dv_verilator:memutil_dpi:0
  file_type: cppSource
  is_include_file: true
  name: ../src/lowrisc_dv_verilator_memutil_dpi_0/cpp/mem_area.h
- core: lowrisc:dv_verilator:memutil_dpi:0
  file_type: cppSource
  is_include_file: true
  name: ../src/lowrisc_dv_verilator_memutil_dpi_0/cpp/ranged_map.h
- core: lowrisc:dv_verilator:memutil_dpi:0
  file_type: cppSource
  name: ../src/lowrisc_dv_verilator_memutil_dpi_0/cpp/sv_scoped.cc
- core: lowrisc:dv_verilator:memutil_dpi:0
  file_type: cppSource
  is_include_file: true
  name: ../src/lowrisc_dv_verilator_memutil_dpi_0/cpp/sv_scoped.h
- core: lowrisc:ibex:ibex_icache:0.1
  file_type: systemVerilogSource
  name: ../src/lowrisc_ibex_ibex_icache_0.1/rtl/ibex_icache.sv
- core: lowrisc:ip:rv_core_ibex_pkg:0.1
  file_type: systemVerilogSource
  name: ../src/lowrisc_ip_rv_core_ibex_pkg_0.1/rtl/rv_core_ibex_pkg.sv
- core: lowrisc:prim:arbiter:0
  file_type: systemVerilogSource
  name: ../src/lowrisc_prim_arbiter_0/rtl/prim_arbiter_fixed.sv
- core: lowrisc:prim:arbiter:0
  file_type: systemVerilogSource
  name: ../src/lowrisc_prim_arbiter_0/rtl/prim_arbiter_ppc.sv
- core: lowrisc:prim:arbiter:0
  file_type: systemVerilogSource
  name: ../src/lowrisc_prim_arbiter_0/rtl/prim_arbiter_tree.sv
- core: lowrisc:prim:arbiter:0
  file_type: systemVerilogSource
  name: ../src/lowrisc_prim_arbiter_0/rtl/prim_arbiter_tree_dup.sv
- core: lowrisc:prim:cdc_rand_delay:0
  file_type: systemVerilogSource
  name: ../src/lowrisc_prim_cdc_rand_delay_0/rtl/prim_cdc_rand_delay.sv
- core: lowrisc:prim:cipher:0
  file_type: systemVerilogSource
  name: ../src/lowrisc_prim_cipher_0/rtl/prim_subst_perm.sv
- core: lowrisc:prim:cipher:0
  file_type: systemVerilogSource
  name: ../src/lowrisc_prim_cipher_0/rtl/prim_present.sv
- core: lowrisc:prim:cipher:0
  file_type: systemVerilogSource
  name: ../src/lowrisc_prim_cipher_0/rtl/prim_prince.sv
- core: lowrisc:prim:count:0
  file_type: systemVerilogSource
  name: ../src/lowrisc_prim_count_0/rtl/prim_count.sv
- core: lowrisc:prim_generic:clock_mux2:0
  file_type: systemVerilogSource
  name: ../src/lowrisc_prim_generic_clock_mux2_0/rtl/prim_generic_clock_mux2.sv
- core: lowrisc:prim_generic:pad_attr:0
  file_type: systemVerilogSource
  name: ../src/lowrisc_prim_generic_pad_attr_0/rtl/prim_generic_pad_attr.sv
- core: lowrisc:prim_generic:pad_wrapper:0
  file_type: systemVerilogSource
  name: ../src/lowrisc_prim_generic_pad_wrapper_0/rtl/prim_generic_pad_wrapper.sv
- core: lowrisc:prim_generic:ram_1p:0
  file_type: systemVerilogSource
  name: ../src/lowrisc_prim_generic_ram_1p_0/rtl/prim_generic_ram_1p.sv
- core: lowrisc:prim_generic:ram_2p:0
  file_type: systemVerilogSource
  name: ../src/lowrisc_prim_generic_ram_2p_0/rtl/prim_generic_ram_2p.sv
- core: lowrisc:prim_generic:rom:0
  file_type: systemVerilogSource
  name: ../src/lowrisc_prim_generic_rom_0/rtl/prim_generic_rom.sv
- core: lowrisc:prim:gf_mult:0
  file_type: systemVerilogSource
  name: ../src/lowrisc_prim_gf_mult_0/rtl/prim_gf_mult.sv
- core: lowrisc:prim:lfsr:0.1
  file_type: systemVerilogSource
  name: ../src/lowrisc_prim_lfsr_0.1/rtl/prim_lfsr.sv
- core: lowrisc:prim:max_tree:0
  file_type: systemVerilogSource
  name: ../src/lowrisc_prim_max_tree_0/rtl/prim_max_tree.sv
- core: lowrisc:prim:msb_extend:0
  file_type: systemVerilogSource
  name: ../src/lowrisc_prim_msb_extend_0/rtl/prim_msb_extend.sv
- core: lowrisc:prim:prim_dom_and_2share:0.1
  file_type: systemVerilogSource
  name: ../src/lowrisc_prim_prim_dom_and_2share_0.1/rtl/prim_dom_and_2share.sv
- core: lowrisc:prim:sec_anchor:0.1
  file_type: systemVerilogSource
  name: ../src/lowrisc_prim_sec_anchor_0.1/rtl/prim_sec_anchor_buf.sv
- core: lowrisc:prim:sec_anchor:0.1
  file_type: systemVerilogSource
  name: ../src/lowrisc_prim_sec_anchor_0.1/rtl/prim_sec_anchor_flop.sv
- core: lowrisc:prim:sparse_fsm:0
  file_type: systemVerilogSource
  name: ../src/lowrisc_prim_sparse_fsm_0/rtl/prim_sparse_fsm_flop.sv
- core: lowrisc:prim:sum_tree:0
  file_type: systemVerilogSource
  name: ../src/lowrisc_prim_sum_tree_0/rtl/prim_sum_tree.sv
- core: lowrisc:prim:util:0.1
  file_type: systemVerilogSource
  name: ../src/lowrisc_prim_util_0.1/rtl/prim_util_pkg.sv
- core: lowrisc:prim_xilinx:pad_attr:0
  file_type: systemVerilogSource
  name: ../src/lowrisc_prim_xilinx_pad_attr_0/rtl/prim_xilinx_pad_attr.sv
- core: lowrisc:prim_xilinx:pad_wrapper:0
  file_type: systemVerilogSource
  name: ../src/lowrisc_prim_xilinx_pad_wrapper_0/rtl/prim_xilinx_pad_wrapper.sv
- core: lowrisc:prim_xilinx_ultrascale:pad_attr:0
  file_type: systemVerilogSource
  name: ../src/lowrisc_prim_xilinx_ultrascale_pad_attr_0/rtl/prim_xilinx_ultrascale_pad_attr.sv
- core: lowrisc:prim_xilinx_ultrascale:pad_wrapper:0
  file_type: systemVerilogSource
  name: ../src/lowrisc_prim_xilinx_ultrascale_pad_wrapper_0/rtl/prim_xilinx_ultrascale_pad_wrapper.sv
- core: lowrisc:prim:xoshiro256pp:0
  file_type: systemVerilogSource
  name: ../src/lowrisc_prim_xoshiro256pp_0/rtl/prim_xoshiro256pp.sv
- core: lowrisc:systems:physical_pads:0.1
  file_type: systemVerilogSource
  name: ../src/lowrisc_systems_physical_pads_0.1/rtl/physical_pads.sv
- core: lowrisc:dv_verilator:memutil_dpi_scrambled:0
  file_type: cppSource
  name: ../src/lowrisc_dv_verilator_memutil_dpi_scrambled_0/cpp/scrambled_ecc32_mem_area.cc
- core: lowrisc:dv_verilator:memutil_dpi_scrambled:0
  file_type: cppSource
  is_include_file: true
  name: ../src/lowrisc_dv_verilator_memutil_dpi_scrambled_0/cpp/scrambled_ecc32_mem_area.h
- core: lowrisc:ip:lc_ctrl_state_pkg:0.1
  file_type: systemVerilogSource
  name: ../src/lowrisc_ip_lc_ctrl_state_pkg_0.1/rtl/lc_ctrl_state_pkg.sv
- core: lowrisc:prim_abstract:and2:0
  file_type: systemVerilogSource
  name: ../src/lowrisc_prim_abstract_and2_0/prim_and2.sv
- core: lowrisc:prim_abstract:buf:0
  file_type: systemVerilogSource
  name: ../src/lowrisc_prim_abstract_buf_0/prim_buf.sv
- core: lowrisc:prim_abstract:clock_buf:0
  file_type: systemVerilogSource
  name: ../src/lowrisc_prim_abstract_clock_buf_0/prim_clock_buf.sv
- core: lowrisc:prim_abstract:clock_gating:0
  file_type: systemVerilogSource
  name: ../src/lowrisc_prim_abstract_clock_gating_0/prim_clock_gating.sv
- core: lowrisc:prim_abstract:clock_mux2:0
  file_type: systemVerilogSource
  name: ../src/lowrisc_prim_abstract_clock_mux2_0/prim_clock_mux2.sv
- core: lowrisc:prim_abstract:flop:0
  file_type: systemVerilogSource
  name: ../src/lowrisc_prim_abstract_flop_0/prim_flop.sv
- core: lowrisc:prim_abstract:pad_attr:0
  file_type: systemVerilogSource
  name: ../src/lowrisc_prim_abstract_pad_attr_0/prim_pad_attr.sv
- core: lowrisc:prim_abstract:pad_wrapper:0
  file_type: systemVerilogSource
  name: ../src/lowrisc_prim_abstract_pad_wrapper_0/prim_pad_wrapper.sv
- core: lowrisc:prim_abstract:ram_2p:0
  file_type: systemVerilogSource
  name: ../src/lowrisc_prim_abstract_ram_2p_0/prim_ram_2p.sv
- core: lowrisc:prim_abstract:rom:0
  file_type: systemVerilogSource
  name: ../src/lowrisc_prim_abstract_rom_0/prim_rom.sv
- core: lowrisc:prim_abstract:usb_diff_rx:0
  file_type: systemVerilogSource
  name: ../src/lowrisc_prim_abstract_usb_diff_rx_0/prim_usb_diff_rx.sv
- core: lowrisc:prim_abstract:xnor2:0
  file_type: systemVerilogSource
  name: ../src/lowrisc_prim_abstract_xnor2_0/prim_xnor2.sv
- core: lowrisc:prim_abstract:xor2:0
  file_type: systemVerilogSource
  name: ../src/lowrisc_prim_abstract_xor2_0/prim_xor2.sv
- core: lowrisc:prim_badbit:ram_1p:0
  file_type: systemVerilogSource
  name: ../src/lowrisc_prim_badbit_ram_1p_0/prim_badbit_ram_1p.sv
- core: lowrisc:prim_generic:flop_en:0
  file_type: systemVerilogSource
  name: ../src/lowrisc_prim_generic_flop_en_0/rtl/prim_generic_flop_en.sv
- core: lowrisc:prim:onehot:0
  file_type: systemVerilogSource
  name: ../src/lowrisc_prim_onehot_0/rtl/prim_onehot_enc.sv
- core: lowrisc:prim:onehot:0
  file_type: systemVerilogSource
  name: ../src/lowrisc_prim_onehot_0/rtl/prim_onehot_mux.sv
- core: lowrisc:prim:onehot_check:0
  file_type: systemVerilogSource
  name: ../src/lowrisc_prim_onehot_check_0/rtl/prim_onehot_check.sv
- core: lowrisc:prim_abstract:flop_en:0
  file_type: systemVerilogSource
  name: ../src/lowrisc_prim_abstract_flop_en_0/prim_flop_en.sv
- core: lowrisc:prim_abstract:ram_1p:0
  file_type: systemVerilogSource
  name: ../src/lowrisc_prim_abstract_ram_1p_0/prim_ram_1p.sv
- core: lowrisc:ibex:ibex_core:0.1
  file_type: systemVerilogSource
  name: ../src/lowrisc_ibex_ibex_core_0.1/rtl/ibex_alu.sv
- core: lowrisc:ibex:ibex_core:0.1
  file_type: systemVerilogSource
  name: ../src/lowrisc_ibex_ibex_core_0.1/rtl/ibex_branch_predict.sv
- core: lowrisc:ibex:ibex_core:0.1
  file_type: systemVerilogSource
  name: ../src/lowrisc_ibex_ibex_core_0.1/rtl/ibex_compressed_decoder.sv
- core: lowrisc:ibex:ibex_core:0.1
  file_type: systemVerilogSource
  name: ../src/lowrisc_ibex_ibex_core_0.1/rtl/ibex_controller.sv
- core: lowrisc:ibex:ibex_core:0.1
  file_type: systemVerilogSource
  name: ../src/lowrisc_ibex_ibex_core_0.1/rtl/ibex_cs_registers.sv
- core: lowrisc:ibex:ibex_core:0.1
  file_type: systemVerilogSource
  name: ../src/lowrisc_ibex_ibex_core_0.1/rtl/ibex_csr.sv
- core: lowrisc:ibex:ibex_core:0.1
  file_type: systemVerilogSource
  name: ../src/lowrisc_ibex_ibex_core_0.1/rtl/ibex_counter.sv
- core: lowrisc:ibex:ibex_core:0.1
  file_type: systemVerilogSource
  name: ../src/lowrisc_ibex_ibex_core_0.1/rtl/ibex_decoder.sv
- core: lowrisc:ibex:ibex_core:0.1
  file_type: systemVerilogSource
  name: ../src/lowrisc_ibex_ibex_core_0.1/rtl/ibex_ex_block.sv
- core: lowrisc:ibex:ibex_core:0.1
  file_type: systemVerilogSource
  name: ../src/lowrisc_ibex_ibex_core_0.1/rtl/ibex_fetch_fifo.sv
- core: lowrisc:ibex:ibex_core:0.1
  file_type: systemVerilogSource
  name: ../src/lowrisc_ibex_ibex_core_0.1/rtl/ibex_id_stage.sv
- core: lowrisc:ibex:ibex_core:0.1
  file_type: systemVerilogSource
  name: ../src/lowrisc_ibex_ibex_core_0.1/rtl/ibex_if_stage.sv
- core: lowrisc:ibex:ibex_core:0.1
  file_type: systemVerilogSource
  name: ../src/lowrisc_ibex_ibex_core_0.1/rtl/ibex_load_store_unit.sv
- core: lowrisc:ibex:ibex_core:0.1
  file_type: systemVerilogSource
  name: ../src/lowrisc_ibex_ibex_core_0.1/rtl/ibex_multdiv_fast.sv
- core: lowrisc:ibex:ibex_core:0.1
  file_type: systemVerilogSource
  name: ../src/lowrisc_ibex_ibex_core_0.1/rtl/ibex_multdiv_slow.sv
- core: lowrisc:ibex:ibex_core:0.1
  file_type: systemVerilogSource
  name: ../src/lowrisc_ibex_ibex_core_0.1/rtl/ibex_prefetch_buffer.sv
- core: lowrisc:ibex:ibex_core:0.1
  file_type: systemVerilogSource
  name: ../src/lowrisc_ibex_ibex_core_0.1/rtl/ibex_pmp.sv
- core: lowrisc:ibex:ibex_core:0.1
  file_type: systemVerilogSource
  name: ../src/lowrisc_ibex_ibex_core_0.1/rtl/ibex_wb_stage.sv
- core: lowrisc:ibex:ibex_core:0.1
  file_type: systemVerilogSource
  name: ../src/lowrisc_ibex_ibex_core_0.1/rtl/ibex_dummy_instr.sv
- core: lowrisc:ibex:ibex_core:0.1
  file_type: systemVerilogSource
  name: ../src/lowrisc_ibex_ibex_core_0.1/rtl/ibex_core.sv
- core: lowrisc:ibex:ibex_core:0.1
  file_type: systemVerilogSource
  is_include_file: true
  name: ../src/lowrisc_ibex_ibex_core_0.1/rtl/ibex_pmp_reset_default.svh
- core: lowrisc:prim:blanker:0
  file_type: systemVerilogSource
  name: ../src/lowrisc_prim_blanker_0/rtl/prim_blanker.sv
- core: lowrisc:prim:double_lfsr:0
  file_type: systemVerilogSource
  name: ../src/lowrisc_prim_double_lfsr_0/rtl/prim_double_lfsr.sv
- core: lowrisc:prim:flop_2sync:0
  file_type: systemVerilogSource
  name: ../src/lowrisc_prim_flop_2sync_0/rtl/prim_flop_2sync.sv
- core: lowrisc:prim_generic:clock_inv:0
  file_type: systemVerilogSource
  name: ../src/lowrisc_prim_generic_clock_inv_0/rtl/prim_generic_clock_inv.sv
- core: lowrisc:prim:mubi:0.1
  file_type: systemVerilogSource
  name: ../src/lowrisc_prim_mubi_0.1/rtl/prim_mubi_pkg.sv
- core: lowrisc:prim:mubi:0.1
  file_type: systemVerilogSource
  name: ../src/lowrisc_prim_mubi_0.1/rtl/prim_mubi4_sender.sv
- core: lowrisc:prim:mubi:0.1
  file_type: systemVerilogSource
  name: ../src/lowrisc_prim_mubi_0.1/rtl/prim_mubi4_sync.sv
- core: lowrisc:prim:mubi:0.1
  file_type: systemVerilogSource
  name: ../src/lowrisc_prim_mubi_0.1/rtl/prim_mubi4_dec.sv
- core: lowrisc:prim:mubi:0.1
  file_type: systemVerilogSource
  name: ../src/lowrisc_prim_mubi_0.1/rtl/prim_mubi8_sender.sv
- core: lowrisc:prim:mubi:0.1
  file_type: systemVerilogSource
  name: ../src/lowrisc_prim_mubi_0.1/rtl/prim_mubi8_sync.sv
- core: lowrisc:prim:mubi:0.1
  file_type: systemVerilogSource
  name: ../src/lowrisc_prim_mubi_0.1/rtl/prim_mubi8_dec.sv
- core: lowrisc:prim:mubi:0.1
  file_type: systemVerilogSource
  name: ../src/lowrisc_prim_mubi_0.1/rtl/prim_mubi12_sender.sv
- core: lowrisc:prim:mubi:0.1
  file_type: systemVerilogSource
  name: ../src/lowrisc_prim_mubi_0.1/rtl/prim_mubi12_sync.sv
- core: lowrisc:prim:mubi:0.1
  file_type: systemVerilogSource
  name: ../src/lowrisc_prim_mubi_0.1/rtl/prim_mubi12_dec.sv
- core: lowrisc:prim:mubi:0.1
  file_type: systemVerilogSource
  name: ../src/lowrisc_prim_mubi_0.1/rtl/prim_mubi16_sender.sv
- core: lowrisc:prim:mubi:0.1
  file_type: systemVerilogSource
  name: ../src/lowrisc_prim_mubi_0.1/rtl/prim_mubi16_sync.sv
- core: lowrisc:prim:mubi:0.1
  file_type: systemVerilogSource
  name: ../src/lowrisc_prim_mubi_0.1/rtl/prim_mubi16_dec.sv
- core: lowrisc:prim:ram_2p_async_adv:0.1
  file_type: systemVerilogSource
  name: ../src/lowrisc_prim_ram_2p_async_adv_0.1/rtl/prim_ram_2p_async_adv.sv
- core: lowrisc:prim:reg_we_check:0
  file_type: systemVerilogSource
  name: ../src/lowrisc_prim_reg_we_check_0/rtl/prim_reg_we_check.sv
- core: lowrisc:prim:rom_adv:0.1
  file_type: systemVerilogSource
  name: ../src/lowrisc_prim_rom_adv_0.1/rtl/prim_rom_adv.sv
- core: lowrisc:ip:rom_ctrl_pkg:0.1
  file_type: systemVerilogSource
  name: ../src/lowrisc_ip_rom_ctrl_pkg_0.1/rtl/rom_ctrl_pkg.sv
- core: lowrisc:ip:rom_ctrl_pkg:0.1
  file_type: systemVerilogSource
  name: ../src/lowrisc_ip_rom_ctrl_pkg_0.1/rtl/rom_ctrl_reg_pkg.sv
- core: lowrisc:prim_abstract:clock_inv:0
  file_type: systemVerilogSource
  name: ../src/lowrisc_prim_abstract_clock_inv_0/prim_clock_inv.sv
- core: lowrisc:prim:diff_decode:0
  file_type: systemVerilogSource
  name: ../src/lowrisc_prim_diff_decode_0/rtl/prim_diff_decode.sv
- core: lowrisc:prim:edge_detector:0.1
  file_type: systemVerilogSource
  name: ../src/lowrisc_prim_edge_detector_0.1/rtl/prim_edge_detector.sv
- core: lowrisc:prim:fifo:0
  file_type: systemVerilogSource
  name: ../src/lowrisc_prim_fifo_0/rtl/prim_fifo_async_sram_adapter.sv
- core: lowrisc:prim:fifo:0
  file_type: systemVerilogSource
  name: ../src/lowrisc_prim_fifo_0/rtl/prim_fifo_async_simple.sv
- core: lowrisc:prim:fifo:0
  file_type: systemVerilogSource
  name: ../src/lowrisc_prim_fifo_0/rtl/prim_fifo_async.sv
- core: lowrisc:prim:fifo:0
  file_type: systemVerilogSource
  name: ../src/lowrisc_prim_fifo_0/rtl/prim_fifo_sync.sv
- core: lowrisc:prim:fifo:0
  file_type: systemVerilogSource
  name: ../src/lowrisc_prim_fifo_0/rtl/prim_fifo_sync_cnt.sv
- core: lowrisc:prim:multibit_sync:0.1
  file_type: systemVerilogSource
  name: ../src/lowrisc_prim_multibit_sync_0.1/rtl/prim_multibit_sync.sv
- core: lowrisc:prim:ram_1p_adv:0.1
  file_type: systemVerilogSource
  name: ../src/lowrisc_prim_ram_1p_adv_0.1/rtl/prim_ram_1p_adv.sv
- core: lowrisc:prim:ram_2p_adv:0.1
  file_type: systemVerilogSource
  name: ../src/lowrisc_prim_ram_2p_adv_0.1/rtl/prim_ram_2p_adv.sv
- core: lowrisc:prim:rst_sync:0
  file_type: systemVerilogSource
  name: ../src/lowrisc_prim_rst_sync_0/rtl/prim_rst_sync.sv
- core: lowrisc:prim:subreg:0
  file_type: systemVerilogSource
  name: ../src/lowrisc_prim_subreg_0/rtl/prim_subreg_pkg.sv
- core: lowrisc:prim:subreg:0
  file_type: systemVerilogSource
  name: ../src/lowrisc_prim_subreg_0/rtl/prim_reg_cdc.sv
- core: lowrisc:prim:subreg:0
  file_type: systemVerilogSource
  name: ../src/lowrisc_prim_subreg_0/rtl/prim_reg_cdc_arb.sv
- core: lowrisc:prim:subreg:0
  file_type: systemVerilogSource
  name: ../src/lowrisc_prim_subreg_0/rtl/prim_subreg.sv
- core: lowrisc:prim:subreg:0
  file_type: systemVerilogSource
  name: ../src/lowrisc_prim_subreg_0/rtl/prim_subreg_arb.sv
- core: lowrisc:prim:subreg:0
  file_type: systemVerilogSource
  name: ../src/lowrisc_prim_subreg_0/rtl/prim_subreg_ext.sv
- core: lowrisc:prim:subreg:0
  file_type: systemVerilogSource
  name: ../src/lowrisc_prim_subreg_0/rtl/prim_subreg_shadow.sv
- core: lowrisc:tlul:headers:0.1
  file_type: systemVerilogSource
  name: ../src/lowrisc_tlul_headers_0.1/rtl/tlul_pkg.sv
- core: lowrisc:ip:lc_ctrl_pkg:0.1
  file_type: systemVerilogSource
  name: ../src/lowrisc_ip_lc_ctrl_pkg_0.1/rtl/lc_ctrl_reg_pkg.sv
- core: lowrisc:ip:lc_ctrl_pkg:0.1
  file_type: systemVerilogSource
  name: ../src/lowrisc_ip_lc_ctrl_pkg_0.1/rtl/lc_ctrl_pkg.sv
- core: lowrisc:prim:esc:0
  file_type: systemVerilogSource
  name: ../src/lowrisc_prim_esc_0/rtl/prim_esc_pkg.sv
- core: lowrisc:prim:esc:0
  file_type: systemVerilogSource
  name: ../src/lowrisc_prim_esc_0/rtl/prim_esc_receiver.sv
- core: lowrisc:prim:esc:0
  file_type: systemVerilogSource
  name: ../src/lowrisc_prim_esc_0/rtl/prim_esc_sender.sv
- core: lowrisc:prim:ram_1p_scr:0.1
  file_type: systemVerilogSource
  name: ../src/lowrisc_prim_ram_1p_scr_0.1/rtl/prim_ram_1p_scr.sv
- core: lowrisc:systems:pinmux_reg:0.1
  file_type: systemVerilogSource
  name: ../src/lowrisc_systems_pinmux_reg_0.1/rtl/autogen/pinmux_reg_pkg.sv
- core: lowrisc:systems:pinmux_reg:0.1
  file_type: systemVerilogSource
  name: ../src/lowrisc_systems_pinmux_reg_0.1/rtl/autogen/pinmux_reg_top.sv
- core: lowrisc:systems:rstmgr_reg:0.1
  file_type: systemVerilogSource
  name: ../src/lowrisc_systems_rstmgr_reg_0.1/rtl/autogen/rstmgr_reg_pkg.sv
- core: lowrisc:systems:rstmgr_reg:0.1
  file_type: systemVerilogSource
  name: ../src/lowrisc_systems_rstmgr_reg_0.1/rtl/autogen/rstmgr_reg_top.sv
- core: lowrisc:tlul:trans_intg:0.1
  file_type: systemVerilogSource
  name: ../src/lowrisc_tlul_trans_intg_0.1/rtl/tlul_data_integ_enc.sv
- core: lowrisc:tlul:trans_intg:0.1
  file_type: systemVerilogSource
  name: ../src/lowrisc_tlul_trans_intg_0.1/rtl/tlul_data_integ_dec.sv
- core: lowrisc:tlul:trans_intg:0.1
  file_type: systemVerilogSource
  name: ../src/lowrisc_tlul_trans_intg_0.1/rtl/tlul_cmd_intg_gen.sv
- core: lowrisc:tlul:trans_intg:0.1
  file_type: systemVerilogSource
  name: ../src/lowrisc_tlul_trans_intg_0.1/rtl/tlul_cmd_intg_chk.sv
- core: lowrisc:tlul:trans_intg:0.1
  file_type: systemVerilogSource
  name: ../src/lowrisc_tlul_trans_intg_0.1/rtl/tlul_rsp_intg_gen.sv
- core: lowrisc:tlul:trans_intg:0.1
  file_type: systemVerilogSource
  name: ../src/lowrisc_tlul_trans_intg_0.1/rtl/tlul_rsp_intg_chk.sv
- core: lowrisc:ibex:ibex_top:0.1
  file_type: systemVerilogSource
  name: ../src/lowrisc_ibex_ibex_top_0.1/rtl/ibex_register_file_ff.sv
- core: lowrisc:ibex:ibex_top:0.1
  file_type: systemVerilogSource
  name: ../src/lowrisc_ibex_ibex_top_0.1/rtl/ibex_register_file_fpga.sv
- core: lowrisc:ibex:ibex_top:0.1
  file_type: systemVerilogSource
  name: ../src/lowrisc_ibex_ibex_top_0.1/rtl/ibex_register_file_latch.sv
- core: lowrisc:ibex:ibex_top:0.1
  file_type: systemVerilogSource
  name: ../src/lowrisc_ibex_ibex_top_0.1/rtl/ibex_lockstep.sv
- core: lowrisc:ibex:ibex_top:0.1
  file_type: systemVerilogSource
  name: ../src/lowrisc_ibex_ibex_top_0.1/rtl/ibex_top.sv
- core: lowrisc:ip:csrng_pkg:0.1
  file_type: systemVerilogSource
  name: ../src/lowrisc_ip_csrng_pkg_0.1/rtl/csrng_reg_pkg.sv
- core: lowrisc:ip:csrng_pkg:0.1
  file_type: systemVerilogSource
  name: ../src/lowrisc_ip_csrng_pkg_0.1/rtl/csrng_pkg.sv
- core: lowrisc:ip:otp_ctrl_pkg:1.0
  file_type: systemVerilogSource
  name: ../src/lowrisc_ip_otp_ctrl_pkg_1.0/rtl/otp_ctrl_reg_pkg.sv
- core: lowrisc:ip:otp_ctrl_pkg:1.0
  file_type: systemVerilogSource
  name: ../src/lowrisc_ip_otp_ctrl_pkg_1.0/rtl/otp_ctrl_pkg.sv
- core: lowrisc:ip:otp_ctrl_pkg:1.0
  file_type: systemVerilogSource
  name: ../src/lowrisc_ip_otp_ctrl_pkg_1.0/rtl/otp_ctrl_part_pkg.sv
- core: lowrisc:prim:alert:0
  file_type: systemVerilogSource
  name: ../src/lowrisc_prim_alert_0/rtl/prim_alert_pkg.sv
- core: lowrisc:prim:alert:0
  file_type: systemVerilogSource
  name: ../src/lowrisc_prim_alert_0/rtl/prim_alert_receiver.sv
- core: lowrisc:prim:alert:0
  file_type: systemVerilogSource
  name: ../src/lowrisc_prim_alert_0/rtl/prim_alert_sender.sv
- core: lowrisc:prim_generic:clock_div:0
  file_type: systemVerilogSource
  name: ../src/lowrisc_prim_generic_clock_div_0/rtl/prim_generic_clock_div.sv
- core: lowrisc:prim:lc_dec:0.1
  file_type: systemVerilogSource
  name: ../src/lowrisc_prim_lc_dec_0.1/rtl/prim_lc_dec.sv
- core: lowrisc:prim:lc_sender:0.1
  file_type: systemVerilogSource
  name: ../src/lowrisc_prim_lc_sender_0.1/rtl/prim_lc_sender.sv
- core: lowrisc:prim:lc_sync:0.1
  file_type: systemVerilogSource
  name: ../src/lowrisc_prim_lc_sync_0.1/rtl/prim_lc_sync.sv
- core: lowrisc:prim_xilinx_ultrascale:clock_div:0
  file_type: systemVerilogSource
  name: ../src/lowrisc_prim_xilinx_ultrascale_clock_div_0/rtl/prim_xilinx_ultrascale_clock_div.sv
- core: lowrisc:systems:ast_pkg:0
  file_type: systemVerilogSource
  name: ../src/lowrisc_systems_ast_pkg_0/rtl/ast_pkg.sv
- core: lowrisc:tlul:common:0.1
  file_type: systemVerilogSource
  name: ../src/lowrisc_tlul_common_0.1/rtl/tlul_fifo_sync.sv
- core: lowrisc:tlul:common:0.1
  file_type: systemVerilogSource
  name: ../src/lowrisc_tlul_common_0.1/rtl/tlul_fifo_async.sv
- core: lowrisc:tlul:common:0.1
  file_type: systemVerilogSource
  name: ../src/lowrisc_tlul_common_0.1/rtl/tlul_assert.sv
- core: lowrisc:tlul:common:0.1
  file_type: systemVerilogSource
  name: ../src/lowrisc_tlul_common_0.1/rtl/tlul_err.sv
- core: lowrisc:tlul:common:0.1
  file_type: systemVerilogSource
  name: ../src/lowrisc_tlul_common_0.1/rtl/tlul_assert_multiple.sv
- core: lowrisc:ip:edn_pkg:0.1
  file_type: systemVerilogSource
  name: ../src/lowrisc_ip_edn_pkg_0.1/rtl/edn_reg_pkg.sv
- core: lowrisc:ip:edn_pkg:0.1
  file_type: systemVerilogSource
  name: ../src/lowrisc_ip_edn_pkg_0.1/rtl/edn_pkg.sv
- core: lowrisc:ip:otbn_pkg:0.1
  file_type: systemVerilogSource
  name: ../src/lowrisc_ip_otbn_pkg_0.1/rtl/otbn_pkg.sv
- core: lowrisc:ip:otp_ctrl_prim_reg_top:1.0
  file_type: systemVerilogSource
  name: ../src/lowrisc_ip_otp_ctrl_prim_reg_top_1.0/rtl/otp_ctrl_prim_reg_top.sv
- core: lowrisc:ip:rv_plic_component:0.1
  file_type: systemVerilogSource
  name: ../src/lowrisc_ip_rv_plic_component_0.1/rtl/rv_plic_gateway.sv
- core: lowrisc:ip:rv_plic_component:0.1
  file_type: systemVerilogSource
  name: ../src/lowrisc_ip_rv_plic_component_0.1/rtl/rv_plic_target.sv
- core: lowrisc:ip:sram_ctrl_pkg:0.1
  file_type: systemVerilogSource
  name: ../src/lowrisc_ip_sram_ctrl_pkg_0.1/rtl/sram_ctrl_reg_pkg.sv
- core: lowrisc:ip:sram_ctrl_pkg:0.1
  file_type: systemVerilogSource
  name: ../src/lowrisc_ip_sram_ctrl_pkg_0.1/rtl/sram_ctrl_pkg.sv
- core: lowrisc:prim_abstract:clock_div:0
  file_type: systemVerilogSource
  name: ../src/lowrisc_prim_abstract_clock_div_0/prim_clock_div.sv
- core: lowrisc:prim:all:0.1
  file_type: systemVerilogSource
  name: ../src/lowrisc_prim_all_0.1/rtl/prim_clock_gating_sync.sv
- core: lowrisc:prim:all:0.1
  file_type: systemVerilogSource
  name: ../src/lowrisc_prim_all_0.1/rtl/prim_sram_arbiter.sv
- core: lowrisc:prim:all:0.1
  file_type: systemVerilogSource
  name: ../src/lowrisc_prim_all_0.1/rtl/prim_slicer.sv
- core: lowrisc:prim:all:0.1
  file_type: systemVerilogSource
  name: ../src/lowrisc_prim_all_0.1/rtl/prim_sync_reqack.sv
- core: lowrisc:prim:all:0.1
  file_type: systemVerilogSource
  name: ../src/lowrisc_prim_all_0.1/rtl/prim_sync_reqack_data.sv
- core: lowrisc:prim:all:0.1
  file_type: systemVerilogSource
  name: ../src/lowrisc_prim_all_0.1/rtl/prim_sync_slow_fast.sv
- core: lowrisc:prim:all:0.1
  file_type: systemVerilogSource
  name: ../src/lowrisc_prim_all_0.1/rtl/prim_keccak.sv
- core: lowrisc:prim:all:0.1
  file_type: systemVerilogSource
  name: ../src/lowrisc_prim_all_0.1/rtl/prim_packer.sv
- core: lowrisc:prim:all:0.1
  file_type: systemVerilogSource
  name: ../src/lowrisc_prim_all_0.1/rtl/prim_packer_fifo.sv
- core: lowrisc:prim:all:0.1
  file_type: systemVerilogSource
  name: ../src/lowrisc_prim_all_0.1/rtl/prim_gate_gen.sv
- core: lowrisc:prim:all:0.1
  file_type: systemVerilogSource
  name: ../src/lowrisc_prim_all_0.1/rtl/prim_pulse_sync.sv
- core: lowrisc:prim:all:0.1
  file_type: systemVerilogSource
  name: ../src/lowrisc_prim_all_0.1/rtl/prim_filter.sv
- core: lowrisc:prim:all:0.1
  file_type: systemVerilogSource
  name: ../src/lowrisc_prim_all_0.1/rtl/prim_filter_ctr.sv
- core: lowrisc:prim:all:0.1
  file_type: systemVerilogSource
  name: ../src/lowrisc_prim_all_0.1/rtl/prim_intr_hw.sv
- core: lowrisc:prim:lc_or_hardened:0.1
  file_type: systemVerilogSource
  name: ../src/lowrisc_prim_lc_or_hardened_0.1/rtl/prim_lc_or_hardened.sv
- core: lowrisc:tlul:adapter_reg:0.1
  file_type: systemVerilogSource
  name: ../src/lowrisc_tlul_adapter_reg_0.1/rtl/tlul_adapter_reg.sv
- core: lowrisc:tlul:adapter_sram:0.1
  file_type: systemVerilogSource
  name: ../src/lowrisc_tlul_adapter_sram_0.1/rtl/tlul_sram_byte.sv
- core: lowrisc:tlul:adapter_sram:0.1
  file_type: systemVerilogSource
  name: ../src/lowrisc_tlul_adapter_sram_0.1/rtl/tlul_adapter_sram.sv
- core: lowrisc:tlul:lc_gate:0.1
  file_type: systemVerilogSource
  name: ../src/lowrisc_tlul_lc_gate_0.1/rtl/tlul_lc_gate.sv
- core: lowrisc:tlul:socket_1n:0.1
  file_type: systemVerilogSource
  name: ../src/lowrisc_tlul_socket_1n_0.1/rtl/tlul_err_resp.sv
- core: lowrisc:tlul:socket_1n:0.1
  file_type: systemVerilogSource
  name: ../src/lowrisc_tlul_socket_1n_0.1/rtl/tlul_socket_1n.sv
- core: lowrisc:tlul:socket_m1:0.1
  file_type: systemVerilogSource
  name: ../src/lowrisc_tlul_socket_m1_0.1/rtl/tlul_socket_m1.sv
- core: lowrisc:tlul:sram2tlul:0.1
  file_type: systemVerilogSource
  name: ../src/lowrisc_tlul_sram2tlul_0.1/rtl/sram2tlul.sv
- core: lowrisc:ip:keymgr_pkg:0.1
  file_type: systemVerilogSource
  name: ../src/lowrisc_ip_keymgr_pkg_0.1/rtl/keymgr_reg_pkg.sv
- core: lowrisc:ip:keymgr_pkg:0.1
  file_type: systemVerilogSource
  name: ../src/lowrisc_ip_keymgr_pkg_0.1/rtl/keymgr_pkg.sv
- core: lowrisc:ip:usb_fs_nb_pe:0.1
  file_type: systemVerilogSource
  name: ../src/lowrisc_ip_usb_fs_nb_pe_0.1/rtl/usb_consts_pkg.sv
- core: lowrisc:ip:usb_fs_nb_pe:0.1
  file_type: systemVerilogSource
  name: ../src/lowrisc_ip_usb_fs_nb_pe_0.1/rtl/usb_fs_nb_in_pe.sv
- core: lowrisc:ip:usb_fs_nb_pe:0.1
  file_type: systemVerilogSource
  name: ../src/lowrisc_ip_usb_fs_nb_pe_0.1/rtl/usb_fs_nb_out_pe.sv
- core: lowrisc:ip:usb_fs_nb_pe:0.1
  file_type: systemVerilogSource
  name: ../src/lowrisc_ip_usb_fs_nb_pe_0.1/rtl/usb_fs_nb_pe.sv
- core: lowrisc:ip:usb_fs_nb_pe:0.1
  file_type: systemVerilogSource
  name: ../src/lowrisc_ip_usb_fs_nb_pe_0.1/rtl/usb_fs_rx.sv
- core: lowrisc:ip:usb_fs_nb_pe:0.1
  file_type: systemVerilogSource
  name: ../src/lowrisc_ip_usb_fs_nb_pe_0.1/rtl/usb_fs_tx.sv
- core: lowrisc:ip:usb_fs_nb_pe:0.1
  file_type: systemVerilogSource
  name: ../src/lowrisc_ip_usb_fs_nb_pe_0.1/rtl/usb_fs_tx_mux.sv
- core: lowrisc:prim:edn_req:0.1
  file_type: systemVerilogSource
  name: ../src/lowrisc_prim_edn_req_0.1/rtl/prim_edn_req.sv
- core: lowrisc:prim_generic:otp:0
  file_type: systemVerilogSource
  name: ../src/lowrisc_prim_generic_otp_0/rtl/prim_generic_otp.sv
- core: lowrisc:prim:measure:0
  file_type: systemVerilogSource
  name: ../src/lowrisc_prim_measure_0/rtl/prim_clock_meas.sv
- core: lowrisc:prim:measure:0
  file_type: systemVerilogSource
  name: ../src/lowrisc_prim_measure_0/rtl/prim_clock_timeout.sv
- core: lowrisc:systems:flash_ctrl_pkg:0.1
  file_type: systemVerilogSource
  name: ../src/lowrisc_systems_flash_ctrl_pkg_0.1/rtl/autogen/flash_ctrl_reg_pkg.sv
- core: lowrisc:systems:flash_ctrl_pkg:0.1
  file_type: systemVerilogSource
  name: ../src/lowrisc_systems_flash_ctrl_pkg_0.1/rtl/autogen/flash_ctrl_pkg.sv
- core: lowrisc:tlul:adapter_host:0.1
  file_type: systemVerilogSource
  name: ../src/lowrisc_tlul_adapter_host_0.1/rtl/tlul_adapter_host.sv
- core: pulp-platform:riscv-dbg:0.1:0
  file_type: systemVerilogSource
  name: ../src/pulp-platform_riscv-dbg_0.1_0/pulp_riscv_dbg/debug_rom/debug_rom.sv
- core: pulp-platform:riscv-dbg:0.1:0
  file_type: systemVerilogSource
  name: ../src/pulp-platform_riscv-dbg_0.1_0/pulp_riscv_dbg/debug_rom/debug_rom_one_scratch.sv
- core: pulp-platform:riscv-dbg:0.1:0
  file_type: systemVerilogSource
  name: ../src/pulp-platform_riscv-dbg_0.1_0/pulp_riscv_dbg/src/dm_pkg.sv
- core: pulp-platform:riscv-dbg:0.1:0
  file_type: systemVerilogSource
  name: ../src/pulp-platform_riscv-dbg_0.1_0/pulp_riscv_dbg/src/dm_sba.sv
- core: pulp-platform:riscv-dbg:0.1:0
  file_type: systemVerilogSource
  name: ../src/pulp-platform_riscv-dbg_0.1_0/pulp_riscv_dbg/src/dm_csrs.sv
- core: pulp-platform:riscv-dbg:0.1:0
  file_type: systemVerilogSource
  name: ../src/pulp-platform_riscv-dbg_0.1_0/pulp_riscv_dbg/src/dm_mem.sv
- core: pulp-platform:riscv-dbg:0.1:0
  file_type: systemVerilogSource
  name: ../src/pulp-platform_riscv-dbg_0.1_0/pulp_riscv_dbg/src/dmi_cdc.sv
- core: pulp-platform:riscv-dbg:0.1:0
  file_type: systemVerilogSource
  name: ../src/pulp-platform_riscv-dbg_0.1_0/pulp_riscv_dbg/src/dmi_jtag.sv
- core: pulp-platform:riscv-dbg:0.1:0
  file_type: systemVerilogSource
  name: ../src/pulp-platform_riscv-dbg_0.1_0/pulp_riscv_dbg/src/dmi_jtag_tap.sv
- core: pulp-platform:riscv-dbg:0.1:0
  file_type: systemVerilogSource
  name: ../src/pulp-platform_riscv-dbg_0.1_0/pulp_riscv_dbg/src/dm_top.sv
- core: lowrisc:ip:adc_ctrl:1.0
  file_type: systemVerilogSource
  name: ../src/lowrisc_ip_adc_ctrl_1.0/rtl/adc_ctrl_pkg.sv
- core: lowrisc:ip:adc_ctrl:1.0
  file_type: systemVerilogSource
  name: ../src/lowrisc_ip_adc_ctrl_1.0/rtl/adc_ctrl_reg_pkg.sv
- core: lowrisc:ip:adc_ctrl:1.0
  file_type: systemVerilogSource
  name: ../src/lowrisc_ip_adc_ctrl_1.0/rtl/adc_ctrl_reg_top.sv
- core: lowrisc:ip:adc_ctrl:1.0
  file_type: systemVerilogSource
  name: ../src/lowrisc_ip_adc_ctrl_1.0/rtl/adc_ctrl_fsm.sv
- core: lowrisc:ip:adc_ctrl:1.0
  file_type: systemVerilogSource
  name: ../src/lowrisc_ip_adc_ctrl_1.0/rtl/adc_ctrl_intr.sv
- core: lowrisc:ip:adc_ctrl:1.0
  file_type: systemVerilogSource
  name: ../src/lowrisc_ip_adc_ctrl_1.0/rtl/adc_ctrl_core.sv
- core: lowrisc:ip:adc_ctrl:1.0
  file_type: systemVerilogSource
  name: ../src/lowrisc_ip_adc_ctrl_1.0/rtl/adc_ctrl.sv
- core: lowrisc:ip:aes:1.0
  file_type: systemVerilogSource
  name: ../src/lowrisc_ip_aes_1.0/rtl/aes_reg_pkg.sv
- core: lowrisc:ip:aes:1.0
  file_type: systemVerilogSource
  name: ../src/lowrisc_ip_aes_1.0/rtl/aes_pkg.sv
- core: lowrisc:ip:aes:1.0
  file_type: systemVerilogSource
  name: ../src/lowrisc_ip_aes_1.0/rtl/aes_reg_top.sv
- core: lowrisc:ip:aes:1.0
  file_type: systemVerilogSource
  name: ../src/lowrisc_ip_aes_1.0/rtl/aes_ctrl_reg_shadowed.sv
- core: lowrisc:ip:aes:1.0
  file_type: systemVerilogSource
  name: ../src/lowrisc_ip_aes_1.0/rtl/aes_core.sv
- core: lowrisc:ip:aes:1.0
  file_type: systemVerilogSource
  name: ../src/lowrisc_ip_aes_1.0/rtl/aes_ctr.sv
- core: lowrisc:ip:aes:1.0
  file_type: systemVerilogSource
  name: ../src/lowrisc_ip_aes_1.0/rtl/aes_ctr_fsm.sv
- core: lowrisc:ip:aes:1.0
  file_type: systemVerilogSource
  name: ../src/lowrisc_ip_aes_1.0/rtl/aes_ctr_fsm_p.sv
- core: lowrisc:ip:aes:1.0
  file_type: systemVerilogSource
  name: ../src/lowrisc_ip_aes_1.0/rtl/aes_ctr_fsm_n.sv
- core: lowrisc:ip:aes:1.0
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
- core: lowrisc:ip:uart:0.1
  file_type: systemVerilogSource
  name: ../src/lowrisc_ip_uart_0.1/rtl/uart_reg_pkg.sv
- core: lowrisc:ip:uart:0.1
  file_type: systemVerilogSource
  name: ../src/lowrisc_ip_uart_0.1/rtl/uart_reg_top.sv
- core: lowrisc:ip:uart:0.1
  file_type: systemVerilogSource
  name: ../src/lowrisc_ip_uart_0.1/rtl/uart_rx.sv
- core: lowrisc:ip:uart:0.1
  file_type: systemVerilogSource
  name: ../src/lowrisc_ip_uart_0.1/rtl/uart_tx.sv
- core: lowrisc:ip:uart:0.1
  file_type: systemVerilogSource
  name: ../src/lowrisc_ip_uart_0.1/rtl/uart_core.sv
- core: lowrisc:ip:uart:0.1
  file_type: systemVerilogSource
  name: ../src/lowrisc_ip_uart_0.1/rtl/uart.sv
- core: lowrisc:ip:usbdev:0.1
  file_type: systemVerilogSource
  name: ../src/lowrisc_ip_usbdev_0.1/rtl/usbdev_reg_pkg.sv
- core: lowrisc:ip:usbdev:0.1
  file_type: systemVerilogSource
  name: ../src/lowrisc_ip_usbdev_0.1/rtl/usbdev_reg_top.sv
- core: lowrisc:ip:usbdev:0.1
  file_type: systemVerilogSource
  name: ../src/lowrisc_ip_usbdev_0.1/rtl/usbdev_usbif.sv
- core: lowrisc:ip:usbdev:0.1
  file_type: systemVerilogSource
  name: ../src/lowrisc_ip_usbdev_0.1/rtl/usbdev_linkstate.sv
- core: lowrisc:ip:usbdev:0.1
  file_type: systemVerilogSource
  name: ../src/lowrisc_ip_usbdev_0.1/rtl/usbdev_iomux.sv
- core: lowrisc:ip:usbdev:0.1
  file_type: systemVerilogSource
  name: ../src/lowrisc_ip_usbdev_0.1/rtl/usbdev_aon_wake.sv
- core: lowrisc:ip:usbdev:0.1
  file_type: systemVerilogSource
  name: ../src/lowrisc_ip_usbdev_0.1/rtl/usbdev.sv
- core: lowrisc:opentitan:top_earlgrey_alert_handler_reg:0.1
  file_type: systemVerilogSource
  name: ../src/lowrisc_opentitan_top_earlgrey_alert_handler_reg_0.1/rtl/alert_handler_reg_pkg.sv
- core: lowrisc:opentitan:top_earlgrey_alert_handler_reg:0.1
  file_type: systemVerilogSource
  name: ../src/lowrisc_opentitan_top_earlgrey_alert_handler_reg_0.1/rtl/alert_handler_reg_top.sv
- core: lowrisc:opentitan:top_earlgrey_rv_plic:0
  file_type: systemVerilogSource
  name: ../src/lowrisc_opentitan_top_earlgrey_rv_plic_0/rtl/rv_plic_reg_pkg.sv
- core: lowrisc:opentitan:top_earlgrey_rv_plic:0
  file_type: systemVerilogSource
  name: ../src/lowrisc_opentitan_top_earlgrey_rv_plic_0/rtl/rv_plic_reg_top.sv
- core: lowrisc:opentitan:top_earlgrey_rv_plic:0
  file_type: systemVerilogSource
  name: ../src/lowrisc_opentitan_top_earlgrey_rv_plic_0/rtl/rv_plic.sv
- core: lowrisc:prim_abstract:otp:0
  file_type: systemVerilogSource
  name: ../src/lowrisc_prim_abstract_otp_0/prim_otp.sv
- core: lowrisc:systems:sensor_ctrl_reg:0.1
  file_type: systemVerilogSource
  name: ../src/lowrisc_systems_sensor_ctrl_reg_0.1/rtl/sensor_ctrl_reg_pkg.sv
- core: lowrisc:systems:sensor_ctrl_reg:0.1
  file_type: systemVerilogSource
  name: ../src/lowrisc_systems_sensor_ctrl_reg_0.1/rtl/sensor_ctrl_reg_top.sv
- core: lowrisc:top_earlgrey:xbar_main:0.1
  file_type: systemVerilogSource
  name: ../src/lowrisc_top_earlgrey_xbar_main_0.1/rtl/autogen/tl_main_pkg.sv
- core: lowrisc:top_earlgrey:xbar_main:0.1
  file_type: systemVerilogSource
  name: ../src/lowrisc_top_earlgrey_xbar_main_0.1/rtl/autogen/xbar_main.sv
- core: lowrisc:top_earlgrey:xbar_peri:0.1
  file_type: systemVerilogSource
  name: ../src/lowrisc_top_earlgrey_xbar_peri_0.1/rtl/autogen/tl_peri_pkg.sv
- core: lowrisc:top_earlgrey:xbar_peri:0.1
  file_type: systemVerilogSource
  name: ../src/lowrisc_top_earlgrey_xbar_peri_0.1/rtl/autogen/xbar_peri.sv
- core: lowrisc:ip:alert_handler_component:0.1
  file_type: systemVerilogSource
  name: ../src/lowrisc_ip_alert_handler_component_0.1/rtl/alert_pkg.sv
- core: lowrisc:ip:alert_handler_component:0.1
  file_type: systemVerilogSource
  name: ../src/lowrisc_ip_alert_handler_component_0.1/rtl/alert_handler_reg_wrap.sv
- core: lowrisc:ip:alert_handler_component:0.1
  file_type: systemVerilogSource
  name: ../src/lowrisc_ip_alert_handler_component_0.1/rtl/alert_handler_lpg_ctrl.sv
- core: lowrisc:ip:alert_handler_component:0.1
  file_type: systemVerilogSource
  name: ../src/lowrisc_ip_alert_handler_component_0.1/rtl/alert_handler_class.sv
- core: lowrisc:ip:alert_handler_component:0.1
  file_type: systemVerilogSource
  name: ../src/lowrisc_ip_alert_handler_component_0.1/rtl/alert_handler_ping_timer.sv
- core: lowrisc:ip:alert_handler_component:0.1
  file_type: systemVerilogSource
  name: ../src/lowrisc_ip_alert_handler_component_0.1/rtl/alert_handler_esc_timer.sv
- core: lowrisc:ip:alert_handler_component:0.1
  file_type: systemVerilogSource
  name: ../src/lowrisc_ip_alert_handler_component_0.1/rtl/alert_handler_accu.sv
- core: lowrisc:ip:alert_handler_component:0.1
  file_type: systemVerilogSource
  name: ../src/lowrisc_ip_alert_handler_component_0.1/rtl/alert_handler.sv
- core: lowrisc:ip:csrng:0.1
  file_type: systemVerilogSource
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
- core: lowrisc:ip:otp_ctrl:1.0
  file_type: systemVerilogSource
  name: ../src/lowrisc_ip_otp_ctrl_1.0/rtl/otp_ctrl_part_buf.sv
- core: lowrisc:ip:otp_ctrl:1.0
  file_type: systemVerilogSource
  name: ../src/lowrisc_ip_otp_ctrl_1.0/rtl/otp_ctrl_dai.sv
- core: lowrisc:ip:otp_ctrl:1.0
  file_type: systemVerilogSource
  name: ../src/lowrisc_ip_otp_ctrl_1.0/rtl/otp_ctrl_kdi.sv
- core: lowrisc:ip:otp_ctrl:1.0
  file_type: systemVerilogSource
  name: ../src/lowrisc_ip_otp_ctrl_1.0/rtl/otp_ctrl_lci.sv
- core: lowrisc:ip:otp_ctrl:1.0
  file_type: systemVerilogSource
  name: ../src/lowrisc_ip_otp_ctrl_1.0/rtl/otp_ctrl.sv
- core: lowrisc:ip:pwrmgr:0.1
  file_type: systemVerilogSource
  name: ../src/lowrisc_ip_pwrmgr_0.1/rtl/pwrmgr_cdc.sv
- core: lowrisc:ip:pwrmgr:0.1
  file_type: systemVerilogSource
  name: ../src/lowrisc_ip_pwrmgr_0.1/rtl/pwrmgr_slow_fsm.sv
- core: lowrisc:ip:pwrmgr:0.1
  file_type: systemVerilogSource
  name: ../src/lowrisc_ip_pwrmgr_0.1/rtl/pwrmgr_fsm.sv
- core: lowrisc:ip:pwrmgr:0.1
  file_type: systemVerilogSource
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
