houdonghui1/Trust_Shield/First_rot_sw/cm3_soc_sw/project/fpga_syn/fpga_ku6_mcu_full_vivado/.Xil/mcu_top_propImpl.xdc

set_property SRC_FILE_INFO {cfile:/home/houdonghui/cm3_ahbmtx_mcu/project/fpga_syn/fpga_ku6_mcu_full_vivado/fpga_ku6_mcu_full_pin_assignments.xdc rfile:../fpga_ku6_mcu_full_pin_assignments.xdc id:1} [current_design]
set_property SRC_FILE_INFO {cfile:/home/houdonghui/cm3_ahbmtx_mcu/project/fpga_syn/fpga_ku6_mcu_full_vivado/fpga_ku6_mcu_full_timing_constrain.xdc rfile:../fpga_ku6_mcu_full_timing_constrain.xdc id:2} [current_design]
set_property src_info {type:XDC file:1 line:22 export:INPUT save:INPUT read:READ} [current_design]
set_property -dict {PACKAGE_PIN D24 IOSTANDARD LVCMOS18} [get_ports CLK]
set_property src_info {type:XDC file:1 line:23 export:INPUT save:INPUT read:READ} [current_design]
set_property -dict {PACKAGE_PIN AN9 IOSTANDARD LVCMOS33} [get_ports RSTN]
set_property src_info {type:XDC file:1 line:25 export:INPUT save:INPUT read:READ} [current_design]
set_property -dict {PACKAGE_PIN AE12 IOSTANDARD LVCMOS33} [get_ports TXD1]
set_property src_info {type:XDC file:1 line:26 export:INPUT save:INPUT read:READ} [current_design]
set_property -dict {PACKAGE_PIN AF12 IOSTANDARD LVCMOS33} [get_ports RXD1]
set_property src_info {type:XDC file:1 line:27 export:INPUT save:INPUT read:READ} [current_design]
set_property -dict {PACKAGE_PIN AG11 IOSTANDARD LVCMOS33} [get_ports MDC]
set_property src_info {type:XDC file:1 line:28 export:INPUT save:INPUT read:READ} [current_design]
set_property -dict {PACKAGE_PIN AH11 IOSTANDARD LVCMOS33} [get_ports MDIO]
set_property src_info {type:XDC file:1 line:30 export:INPUT save:INPUT read:READ} [current_design]
set_property -dict {PACKAGE_PIN AD11 IOSTANDARD LVCMOS33} [get_ports ETH_RST]
set_property src_info {type:XDC file:1 line:31 export:INPUT save:INPUT read:READ} [current_design]
set_property -dict {PACKAGE_PIN AE11 IOSTANDARD LVCMOS33} [get_ports ETH_TXC]
set_property src_info {type:XDC file:1 line:32 export:INPUT save:INPUT read:READ} [current_design]
set_property -dict {PACKAGE_PIN AF10 IOSTANDARD LVCMOS33} [get_ports ETH_TXEN]
set_property src_info {type:XDC file:1 line:33 export:INPUT save:INPUT read:READ} [current_design]
set_property -dict {PACKAGE_PIN AG10 IOSTANDARD LVCMOS33} [get_ports ETH_TXD[0]]
set_property src_info {type:XDC file:1 line:34 export:INPUT save:INPUT read:READ} [current_design]
set_property -dict {PACKAGE_PIN AD10 IOSTANDARD LVCMOS33} [get_ports ETH_TXD[1]]
set_property src_info {type:XDC file:1 line:35 export:INPUT save:INPUT read:READ} [current_design]
set_property -dict {PACKAGE_PIN AE10 IOSTANDARD LVCMOS33} [get_ports ETH_TXD[2]]
set_property src_info {type:XDC file:1 line:36 export:INPUT save:INPUT read:READ} [current_design]
set_property -dict {PACKAGE_PIN AN11 IOSTANDARD LVCMOS33} [get_ports ETH_TXD[3]]
set_property src_info {type:XDC file:1 line:38 export:INPUT save:INPUT read:READ} [current_design]
set_property -dict {PACKAGE_PIN AJ13 IOSTANDARD LVCMOS33} [get_ports TDI]
set_property src_info {type:XDC file:1 line:39 export:INPUT save:INPUT read:READ} [current_design]
set_property -dict {PACKAGE_PIN AH12 IOSTANDARD LVCMOS33} [get_ports TCK]
set_property src_info {type:XDC file:1 line:40 export:INPUT save:INPUT read:READ} [current_design]
set_property -dict {PACKAGE_PIN AG12 IOSTANDARD LVCMOS33} [get_ports TMS]
set_property src_info {type:XDC file:1 line:41 export:INPUT save:INPUT read:READ} [current_design]
set_property -dict {PACKAGE_PIN AE13 IOSTANDARD LVCMOS33} [get_ports TDO]
set_property src_info {type:XDC file:1 line:42 export:INPUT save:INPUT read:READ} [current_design]
set_property -dict {PACKAGE_PIN AF13 IOSTANDARD LVCMOS33} [get_ports TRST]
set_property src_info {type:XDC file:1 line:44 export:INPUT save:INPUT read:READ} [current_design]
set_property -dict {PACKAGE_PIN K20 IOSTANDARD LVCMOS33} [get_ports TXD]
set_property src_info {type:XDC file:1 line:45 export:INPUT save:INPUT read:READ} [current_design]
set_property -dict {PACKAGE_PIN N23 IOSTANDARD LVCMOS33} [get_ports RXD]
set_property src_info {type:XDC file:2 line:17 export:INPUT save:INPUT read:READ} [current_design]
derive_pll_clocks
set_property src_info {type:XDC file:2 line:19 export:INPUT save:INPUT read:READ} [current_design]
set_clock_groups -async -group [get_clocks {clk_out1_pll_50m}]
set_property src_info {type:XDC file:2 line:20 export:INPUT save:INPUT read:READ} [current_design]
set_clock_groups -async -group [get_clocks {clk_out2_pll_50m}]
set_property src_info {type:XDC file:2 line:21 export:INPUT save:INPUT read:READ} [current_design]
set_clock_groups -async -group [get_clocks {clk_out3_pll_50m}]
set_property src_info {type:XDC file:2 line:27 export:INPUT save:INPUT read:READ} [current_design]
set_property CLOCK_DEDICATED_ROUTE FALSE [get_nets TCK_IBUF]
