houdonghui1/Trust_Shield/First_rot_risc_v/Hardware/Rocketchip/rocketchip_rtl/src/chipyard.fpga.ku060.KU060FPGATestHarness.CaliptraAPB32RocketKU060Config.top.mems.v

module cc_dir_ext(
  input  [9:0]   RW0_addr,
  input          RW0_clk,
  input  [159:0] RW0_wdata,
  output [159:0] RW0_rdata,
  input          RW0_en,
  input          RW0_wmode,
  input  [7:0]   RW0_wmask
);
  wire [9:0] mem_0_0_RW0_addr;
  wire  mem_0_0_RW0_clk;
  wire [19:0] mem_0_0_RW0_wdata;
  wire [19:0] mem_0_0_RW0_rdata;
  wire  mem_0_0_RW0_en;
  wire  mem_0_0_RW0_wmode;
  wire  mem_0_0_RW0_wmask;
  wire [9:0] mem_0_1_RW0_addr;
  wire  mem_0_1_RW0_clk;
  wire [19:0] mem_0_1_RW0_wdata;
  wire [19:0] mem_0_1_RW0_rdata;
  wire  mem_0_1_RW0_en;
  wire  mem_0_1_RW0_wmode;
  wire  mem_0_1_RW0_wmask;
  wire [9:0] mem_0_2_RW0_addr;
  wire  mem_0_2_RW0_clk;
  wire [19:0] mem_0_2_RW0_wdata;
  wire [19:0] mem_0_2_RW0_rdata;
  wire  mem_0_2_RW0_en;
  wire  mem_0_2_RW0_wmode;
  wire  mem_0_2_RW0_wmask;
  wire [9:0] mem_0_3_RW0_addr;
  wire  mem_0_3_RW0_clk;
  wire [19:0] mem_0_3_RW0_wdata;
  wire [19:0] mem_0_3_RW0_rdata;
  wire  mem_0_3_RW0_en;
  wire  mem_0_3_RW0_wmode;
  wire  mem_0_3_RW0_wmask;
  wire [9:0] mem_0_4_RW0_addr;
  wire  mem_0_4_RW0_clk;
  wire [19:0] mem_0_4_RW0_wdata;
  wire [19:0] mem_0_4_RW0_rdata;
  wire  mem_0_4_RW0_en;
  wire  mem_0_4_RW0_wmode;
  wire  mem_0_4_RW0_wmask;
  wire [9:0] mem_0_5_RW0_addr;
  wire  mem_0_5_RW0_clk;
  wire [19:0] mem_0_5_RW0_wdata;
  wire [19:0] mem_0_5_RW0_rdata;
  wire  mem_0_5_RW0_en;
  wire  mem_0_5_RW0_wmode;
  wire  mem_0_5_RW0_wmask;
  wire [9:0] mem_0_6_RW0_addr;
  wire  mem_0_6_RW0_clk;
  wire [19:0] mem_0_6_RW0_wdata;
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
  assign mem_0_5_RW0_addr = RW0_addr;
  assign mem_0_5_RW0_clk = RW0_clk;
  assign mem_0_5_RW0_wdata = RW0_wdata[119:100];
  assign mem_0_5_RW0_en = RW0_en;
  assign mem_0_5_RW0_wmode = RW0_wmode;
  assign mem_0_5_RW0_wmask = RW0_wmask[5];
  assign mem_0_6_RW0_addr = RW0_addr;
  assign mem_0_6_RW0_clk = RW0_clk;
  assign mem_0_6_RW0_wdata = RW0_wdata[139:120];
  assign mem_0_6_RW0_en = RW0_en;
  assign mem_0_6_RW0_wmode = RW0_wmode;
  assign mem_0_6_RW0_wmask = RW0_wmask[6];
  assign mem_0_7_RW0_addr = RW0_addr;
  assign mem_0_7_RW0_clk = RW0_clk;
  assign mem_0_7_RW0_wdata = RW0_wdata[159:140];
  assign mem_0_7_RW0_en = RW0_en;
  assign mem_0_7_RW0_wmode = RW0_wmode;
  assign mem_0_7_RW0_wmask = RW0_wmask[7];
endmodule

module cc_banks_0_ext(
  input  [13:0] RW0_addr,
  input         RW0_clk,
  input  [63:0] RW0_wdata,
  output [63:0] RW0_rdata,
  input         RW0_en,
  input         RW0_wmode
);
  wire [13:0] mem_0_0_RW0_addr;
  wire  mem_0_0_RW0_clk;
  wire [63:0] mem_0_0_RW0_wdata;
  wire [63:0] mem_0_0_RW0_rdata;
  wire  mem_0_0_RW0_en;
  wire  mem_0_0_RW0_wmode;
  split_cc_banks_0_ext mem_0_0 (
    .RW0_addr(mem_0_0_RW0_addr),
    .RW0_clk(mem_0_0_RW0_clk),
    .RW0_wdata(mem_0_0_RW0_wdata),
    .RW0_rdata(mem_0_0_RW0_rdata),
    .RW0_en(mem_0_0_RW0_en),
    .RW0_wmode(mem_0_0_RW0_wmode)
  );
  assign RW0_rdata = mem_0_0_RW0_rdata;
  assign mem_0_0_RW0_addr = RW0_addr;
  assign mem_0_0_RW0_clk = RW0_clk;
  assign mem_0_0_RW0_wdata = RW0_wdata;
  assign mem_0_0_RW0_en = RW0_en;
  assign mem_0_0_RW0_wmode = RW0_wmode;
endmodule

module rockettile_dcache_data_arrays_0_ext(
  input  [8:0]   RW0_addr,
  input          RW0_clk,
  input  [255:0] RW0_wdata,
  output [255:0] RW0_rdata,
  input          RW0_en,
  input          RW0_wmode,
  input  [31:0]  RW0_wmask
);
  wire [8:0] mem_0_0_RW0_addr;
  wire  mem_0_0_RW0_clk;
  wire [7:0] mem_0_0_RW0_wdata;
  wire [7:0] mem_0_0_RW0_rdata;
  wire  mem_0_0_RW0_en;
  wire  mem_0_0_RW0_wmode;
  wire  mem_0_0_RW0_wmask;
  wire [8:0] mem_0_1_RW0_addr;
  wire  mem_0_1_RW0_clk;
  wire [7:0] mem_0_1_RW0_wdata;
  wire [7:0] mem_0_1_RW0_rdata;
  wire  mem_0_1_RW0_en;
  wire  mem_0_1_RW0_wmode;
  wire  mem_0_1_RW0_wmask;
  wire [8:0] mem_0_2_RW0_addr;
  wire  mem_0_2_RW0_clk;
  wire [7:0] mem_0_2_RW0_wdata;
  wire [7:0] mem_0_2_RW0_rdata;
  wire  mem_0_2_RW0_en;
  wire  mem_0_2_RW0_wmode;
  wire  mem_0_2_RW0_wmask;
  wire [8:0] mem_0_3_RW0_addr;
  wire  mem_0_3_RW0_clk;
  wire [7:0] mem_0_3_RW0_wdata;
  wire [7:0] mem_0_3_RW0_rdata;
  wire  mem_0_3_RW0_en;
  wire  mem_0_3_RW0_wmode;
  wire  mem_0_3_RW0_wmask;
  wire [8:0] mem_0_4_RW0_addr;
  wire  mem_0_4_RW0_clk;
  wire [7:0] mem_0_4_RW0_wdata;
  wire [7:0] mem_0_4_RW0_rdata;
  wire  mem_0_4_RW0_en;
  wire  mem_0_4_RW0_wmode;
  wire  mem_0_4_RW0_wmask;
  wire [8:0] mem_0_5_RW0_addr;
  wire  mem_0_5_RW0_clk;
  wire [7:0] mem_0_5_RW0_wdata;
  wire [7:0] mem_0_5_RW0_rdata;
  wire  mem_0_5_RW0_en;
  wire  mem_0_5_RW0_wmode;
  wire  mem_0_5_RW0_wmask;
  wire [8:0] mem_0_6_RW0_addr;
  wire  mem_0_6_RW0_clk;
  wire [7:0] mem_0_6_RW0_wdata;
  wire [7:0] mem_0_6_RW0_rdata;
  wire  mem_0_6_RW0_en;
  wire  mem_0_6_RW0_wmode;
  wire  mem_0_6_RW0_wmask;
  wire [8:0] mem_0_7_RW0_addr;
  wire  mem_0_7_RW0_clk;
  wire [7:0] mem_0_7_RW0_wdata;
  wire [7:0] mem_0_7_RW0_rdata;
  wire  mem_0_7_RW0_en;
  wire  mem_0_7_RW0_wmode;
  wire  mem_0_7_RW0_wmask;
  wire [8:0] mem_0_8_RW0_addr;
  wire  mem_0_8_RW0_clk;
  wire [7:0] mem_0_8_RW0_wdata;
  wire [7:0] mem_0_8_RW0_rdata;
  wire  mem_0_8_RW0_en;
  wire  mem_0_8_RW0_wmode;
  wire  mem_0_8_RW0_wmask;
  wire [8:0] mem_0_9_RW0_addr;
  wire  mem_0_9_RW0_clk;
  wire [7:0] mem_0_9_RW0_wdata;
  wire [7:0] mem_0_9_RW0_rdata;
  wire  mem_0_9_RW0_en;
  wire  mem_0_9_RW0_wmode;
  wire  mem_0_9_RW0_wmask;
  wire [8:0] mem_0_10_RW0_addr;
  wire  mem_0_10_RW0_clk;
  wire [7:0] mem_0_10_RW0_wdata;
  wire [7:0] mem_0_10_RW0_rdata;
  wire  mem_0_10_RW0_en;
  wire  mem_0_10_RW0_wmode;
  wire  mem_0_10_RW0_wmask;
  wire [8:0] mem_0_11_RW0_addr;
  wire  mem_0_11_RW0_clk;
  wire [7:0] mem_0_11_RW0_wdata;
  wire [7:0] mem_0_11_RW0_rdata;
  wire  mem_0_11_RW0_en;
  wire  mem_0_11_RW0_wmode;
  wire  mem_0_11_RW0_wmask;
  wire [8:0] mem_0_12_RW0_addr;
  wire  mem_0_12_RW0_clk;
  wire [7:0] mem_0_12_RW0_wdata;
  wire [7:0] mem_0_12_RW0_rdata;
  wire  mem_0_12_RW0_en;
  wire  mem_0_12_RW0_wmode;
  wire  mem_0_12_RW0_wmask;
  wire [8:0] mem_0_13_RW0_addr;
  wire  mem_0_13_RW0_clk;
  wire [7:0] mem_0_13_RW0_wdata;
  wire [7:0] mem_0_13_RW0_rdata;
  wire  mem_0_13_RW0_en;
  wire  mem_0_13_RW0_wmode;
  wire  mem_0_13_RW0_wmask;
  wire [8:0] mem_0_14_RW0_addr;
  wire  mem_0_14_RW0_clk;
  wire [7:0] mem_0_14_RW0_wdata;
  wire [7:0] mem_0_14_RW0_rdata;
  wire  mem_0_14_RW0_en;
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
  assign mem_0_28_RW0_addr = RW0_addr;
  assign mem_0_28_RW0_clk = RW0_clk;
  assign mem_0_28_RW0_wdata = RW0_wdata[231:224];
  assign mem_0_28_RW0_en = RW0_en;
  assign mem_0_28_RW0_wmode = RW0_wmode;
  assign mem_0_28_RW0_wmask = RW0_wmask[28];
  assign mem_0_29_RW0_addr = RW0_addr;
  assign mem_0_29_RW0_clk = RW0_clk;
  assign mem_0_29_RW0_wdata = RW0_wdata[239:232];
  assign mem_0_29_RW0_en = RW0_en;
  assign mem_0_29_RW0_wmode = RW0_wmode;
  assign mem_0_29_RW0_wmask = RW0_wmask[29];
  assign mem_0_30_RW0_addr = RW0_addr;
  assign mem_0_30_RW0_clk = RW0_clk;
  assign mem_0_30_RW0_wdata = RW0_wdata[247:240];
  assign mem_0_30_RW0_en = RW0_en;
  assign mem_0_30_RW0_wmode = RW0_wmode;
  assign mem_0_30_RW0_wmask = RW0_wmask[30];
  assign mem_0_31_RW0_addr = RW0_addr;
  assign mem_0_31_RW0_clk = RW0_clk;
  assign mem_0_31_RW0_wdata = RW0_wdata[255:248];
  assign mem_0_31_RW0_en = RW0_en;
  assign mem_0_31_RW0_wmode = RW0_wmode;
  assign mem_0_31_RW0_wmask = RW0_wmask[31];
endmodule

module rockettile_dcache_tag_array_ext(
  input  [5:0]  RW0_addr,
  input         RW0_clk,
  input  [87:0] RW0_wdata,
  output [87:0] RW0_rdata,
  input         RW0_en,
  input         RW0_wmode,
  input  [3:0]  RW0_wmask
);
  wire [5:0] mem_0_0_RW0_addr;
  wire  mem_0_0_RW0_clk;
  wire [21:0] mem_0_0_RW0_wdata;
  wire [21:0] mem_0_0_RW0_rdata;
  wire  mem_0_0_RW0_en;
  wire  mem_0_0_RW0_wmode;
  wire  mem_0_0_RW0_wmask;
  wire [5:0] mem_0_1_RW0_addr;
  wire  mem_0_1_RW0_clk;
  wire [21:0] mem_0_1_RW0_wdata;
  wire [21:0] mem_0_1_RW0_rdata;
  wire  mem_0_1_RW0_en;
  wire  mem_0_1_RW0_wmode;
  wire  mem_0_1_RW0_wmask;
  wire [5:0] mem_0_2_RW0_addr;
  wire  mem_0_2_RW0_clk;
  wire [21:0] mem_0_2_RW0_wdata;
  wire [21:0] mem_0_2_RW0_rdata;
  wire  mem_0_2_RW0_en;
  wire  mem_0_2_RW0_wmode;
  wire  mem_0_2_RW0_wmask;
  wire [5:0] mem_0_3_RW0_addr;
  wire  mem_0_3_RW0_clk;
  wire [21:0] mem_0_3_RW0_wdata;
  wire [21:0] mem_0_3_RW0_rdata;
  wire  mem_0_3_RW0_en;
  wire  mem_0_3_RW0_wmode;
  wire  mem_0_3_RW0_wmask;
  wire [21:0] RW0_rdata_0_0 = mem_0_0_RW0_rdata;
  wire [21:0] RW0_rdata_0_1 = mem_0_1_RW0_rdata;
  wire [21:0] RW0_rdata_0_2 = mem_0_2_RW0_rdata;
  wire [21:0] RW0_rdata_0_3 = mem_0_3_RW0_rdata;
  wire [65:0] _GEN_1 = {RW0_rdata_0_2,RW0_rdata_0_1,RW0_rdata_0_0};
  split_rockettile_dcache_tag_array_ext mem_0_0 (
    .RW0_addr(mem_0_0_RW0_addr),
    .RW0_clk(mem_0_0_RW0_clk),
    .RW0_wdata(mem_0_0_RW0_wdata),
    .RW0_rdata(mem_0_0_RW0_rdata),
    .RW0_en(mem_0_0_RW0_en),
    .RW0_wmode(mem_0_0_RW0_wmode),
    .RW0_wmask(mem_0_0_RW0_wmask)
  );
  split_rockettile_dcache_tag_array_ext mem_0_1 (
    .RW0_addr(mem_0_1_RW0_addr),
    .RW0_clk(mem_0_1_RW0_clk),
    .RW0_wdata(mem_0_1_RW0_wdata),
    .RW0_rdata(mem_0_1_RW0_rdata),
    .RW0_en(mem_0_1_RW0_en),
    .RW0_wmode(mem_0_1_RW0_wmode),
    .RW0_wmask(mem_0_1_RW0_wmask)
  );
  split_rockettile_dcache_tag_array_ext mem_0_2 (
    .RW0_addr(mem_0_2_RW0_addr),
    .RW0_clk(mem_0_2_RW0_clk),
    .RW0_wdata(mem_0_2_RW0_wdata),
    .RW0_rdata(mem_0_2_RW0_rdata),
    .RW0_en(mem_0_2_RW0_en),
    .RW0_wmode(mem_0_2_RW0_wmode),
    .RW0_wmask(mem_0_2_RW0_wmask)
  );
  split_rockettile_dcache_tag_array_ext mem_0_3 (
    .RW0_addr(mem_0_3_RW0_addr),
    .RW0_clk(mem_0_3_RW0_clk),
    .RW0_wdata(mem_0_3_RW0_wdata),
    .RW0_rdata(mem_0_3_RW0_rdata),
    .RW0_en(mem_0_3_RW0_en),
    .RW0_wmode(mem_0_3_RW0_wmode),
    .RW0_wmask(mem_0_3_RW0_wmask)
  );
  assign RW0_rdata = {RW0_rdata_0_3,_GEN_1};
  assign mem_0_0_RW0_addr = RW0_addr;
  assign mem_0_0_RW0_clk = RW0_clk;
  assign mem_0_0_RW0_wdata = RW0_wdata[21:0];
  assign mem_0_0_RW0_en = RW0_en;
  assign mem_0_0_RW0_wmode = RW0_wmode;
  assign mem_0_0_RW0_wmask = RW0_wmask[0];
  assign mem_0_1_RW0_addr = RW0_addr;
  assign mem_0_1_RW0_clk = RW0_clk;
  assign mem_0_1_RW0_wdata = RW0_wdata[43:22];
  assign mem_0_1_RW0_en = RW0_en;
  assign mem_0_1_RW0_wmode = RW0_wmode;
  assign mem_0_1_RW0_wmask = RW0_wmask[1];
  assign mem_0_2_RW0_addr = RW0_addr;
  assign mem_0_2_RW0_clk = RW0_clk;
  assign mem_0_2_RW0_wdata = RW0_wdata[65:44];
  assign mem_0_2_RW0_en = RW0_en;
  assign mem_0_2_RW0_wmode = RW0_wmode;
  assign mem_0_2_RW0_wmask = RW0_wmask[2];
  assign mem_0_3_RW0_addr = RW0_addr;
  assign mem_0_3_RW0_clk = RW0_clk;
  assign mem_0_3_RW0_wdata = RW0_wdata[87:66];
  assign mem_0_3_RW0_en = RW0_en;
  assign mem_0_3_RW0_wmode = RW0_wmode;
  assign mem_0_3_RW0_wmask = RW0_wmask[3];
endmodule

module rockettile_icache_tag_array_ext(
  input  [5:0]  RW0_addr,
  input         RW0_clk,
  input  [83:0] RW0_wdata,
  output [83:0] RW0_rdata,
  input         RW0_en,
  input         RW0_wmode,
  input  [3:0]  RW0_wmask
);
  wire [5:0] mem_0_0_RW0_addr;
  wire  mem_0_0_RW0_clk;
  wire [20:0] mem_0_0_RW0_wdata;
  wire [20:0] mem_0_0_RW0_rdata;
  wire  mem_0_0_RW0_en;
  wire  mem_0_0_RW0_wmode;
  wire  mem_0_0_RW0_wmask;
  wire [5:0] mem_0_1_RW0_addr;
  wire  mem_0_1_RW0_clk;
  wire [20:0] mem_0_1_RW0_wdata;
  wire [20:0] mem_0_1_RW0_rdata;
  wire  mem_0_1_RW0_en;
  wire  mem_0_1_RW0_wmode;
  wire  mem_0_1_RW0_wmask;
  wire [5:0] mem_0_2_RW0_addr;
  wire  mem_0_2_RW0_clk;
  wire [20:0] mem_0_2_RW0_wdata;
  wire [20:0] mem_0_2_RW0_rdata;
  wire  mem_0_2_RW0_en;
  wire  mem_0_2_RW0_wmode;
  wire  mem_0_2_RW0_wmask;
  wire [5:0] mem_0_3_RW0_addr;
  wire  mem_0_3_RW0_clk;
  wire [20:0] mem_0_3_RW0_wdata;
  wire [20:0] mem_0_3_RW0_rdata;
  wire  mem_0_3_RW0_en;
  wire  mem_0_3_RW0_wmode;
  wire  mem_0_3_RW0_wmask;
  wire [20:0] RW0_rdata_0_0 = mem_0_0_RW0_rdata;
  wire [20:0] RW0_rdata_0_1 = mem_0_1_RW0_rdata;
  wire [20:0] RW0_rdata_0_2 = mem_0_2_RW0_rdata;
  wire [20:0] RW0_rdata_0_3 = mem_0_3_RW0_rdata;
  wire [62:0] _GEN_1 = {RW0_rdata_0_2,RW0_rdata_0_1,RW0_rdata_0_0};
  split_rockettile_icache_tag_array_ext mem_0_0 (
    .RW0_addr(mem_0_0_RW0_addr),
    .RW0_clk(mem_0_0_RW0_clk),
    .RW0_wdata(mem_0_0_RW0_wdata),
    .RW0_rdata(mem_0_0_RW0_rdata),
    .RW0_en(mem_0_0_RW0_en),
    .RW0_wmode(mem_0_0_RW0_wmode),
    .RW0_wmask(mem_0_0_RW0_wmask)
  );
  split_rockettile_icache_tag_array_ext mem_0_1 (
    .RW0_addr(mem_0_1_RW0_addr),
    .RW0_clk(mem_0_1_RW0_clk),
    .RW0_wdata(mem_0_1_RW0_wdata),
    .RW0_rdata(mem_0_1_RW0_rdata),
    .RW0_en(mem_0_1_RW0_en),
    .RW0_wmode(mem_0_1_RW0_wmode),
    .RW0_wmask(mem_0_1_RW0_wmask)
  );
  split_rockettile_icache_tag_array_ext mem_0_2 (
    .RW0_addr(mem_0_2_RW0_addr),
    .RW0_clk(mem_0_2_RW0_clk),
    .RW0_wdata(mem_0_2_RW0_wdata),
    .RW0_rdata(mem_0_2_RW0_rdata),
    .RW0_en(mem_0_2_RW0_en),
    .RW0_wmode(mem_0_2_RW0_wmode),
    .RW0_wmask(mem_0_2_RW0_wmask)
  );
  split_rockettile_icache_tag_array_ext mem_0_3 (
    .RW0_addr(mem_0_3_RW0_addr),
    .RW0_clk(mem_0_3_RW0_clk),
    .RW0_wdata(mem_0_3_RW0_wdata),
    .RW0_rdata(mem_0_3_RW0_rdata),
    .RW0_en(mem_0_3_RW0_en),
    .RW0_wmode(mem_0_3_RW0_wmode),
    .RW0_wmask(mem_0_3_RW0_wmask)
  );
  assign RW0_rdata = {RW0_rdata_0_3,_GEN_1};
  assign mem_0_0_RW0_addr = RW0_addr;
  assign mem_0_0_RW0_clk = RW0_clk;
  assign mem_0_0_RW0_wdata = RW0_wdata[20:0];
  assign mem_0_0_RW0_en = RW0_en;
  assign mem_0_0_RW0_wmode = RW0_wmode;
  assign mem_0_0_RW0_wmask = RW0_wmask[0];
  assign mem_0_1_RW0_addr = RW0_addr;
  assign mem_0_1_RW0_clk = RW0_clk;
  assign mem_0_1_RW0_wdata = RW0_wdata[41:21];
  assign mem_0_1_RW0_en = RW0_en;
  assign mem_0_1_RW0_wmode = RW0_wmode;
  assign mem_0_1_RW0_wmask = RW0_wmask[1];
  assign mem_0_2_RW0_addr = RW0_addr;
  assign mem_0_2_RW0_clk = RW0_clk;
  assign mem_0_2_RW0_wdata = RW0_wdata[62:42];
  assign mem_0_2_RW0_en = RW0_en;
  assign mem_0_2_RW0_wmode = RW0_wmode;
  assign mem_0_2_RW0_wmask = RW0_wmask[2];
  assign mem_0_3_RW0_addr = RW0_addr;
  assign mem_0_3_RW0_clk = RW0_clk;
  assign mem_0_3_RW0_wdata = RW0_wdata[83:63];
  assign mem_0_3_RW0_en = RW0_en;
  assign mem_0_3_RW0_wmode = RW0_wmode;
  assign mem_0_3_RW0_wmask = RW0_wmask[3];
endmodule

module rockettile_icache_data_arrays_0_ext(
  input  [8:0]   RW0_addr,
  input          RW0_clk,
  input  [127:0] RW0_wdata,
  output [127:0] RW0_rdata,
  input          RW0_en,
  input          RW0_wmode,
  input  [3:0]   RW0_wmask
);
  wire [8:0] mem_0_0_RW0_addr;
  wire  mem_0_0_RW0_clk;
  wire [31:0] mem_0_0_RW0_wdata;
  wire [31:0] mem_0_0_RW0_rdata;
  wire  mem_0_0_RW0_en;
  wire  mem_0_0_RW0_wmode;
  wire  mem_0_0_RW0_wmask;
  wire [8:0] mem_0_1_RW0_addr;
  wire  mem_0_1_RW0_clk;
  wire [31:0] mem_0_1_RW0_wdata;
  wire [31:0] mem_0_1_RW0_rdata;
  wire  mem_0_1_RW0_en;
  wire  mem_0_1_RW0_wmode;
  wire  mem_0_1_RW0_wmask;
  wire [8:0] mem_0_2_RW0_addr;
  wire  mem_0_2_RW0_clk;
  wire [31:0] mem_0_2_RW0_wdata;
  wire [31:0] mem_0_2_RW0_rdata;
  wire  mem_0_2_RW0_en;
  wire  mem_0_2_RW0_wmode;
  wire  mem_0_2_RW0_wmask;
  wire [8:0] mem_0_3_RW0_addr;
  wire  mem_0_3_RW0_clk;
  wire [31:0] mem_0_3_RW0_wdata;
  wire [31:0] mem_0_3_RW0_rdata;
  wire  mem_0_3_RW0_en;
  wire  mem_0_3_RW0_wmode;
  wire  mem_0_3_RW0_wmask;
  wire [31:0] RW0_rdata_0_0 = mem_0_0_RW0_rdata;
  wire [31:0] RW0_rdata_0_1 = mem_0_1_RW0_rdata;
  wire [31:0] RW0_rdata_0_2 = mem_0_2_RW0_rdata;
  wire [31:0] RW0_rdata_0_3 = mem_0_3_RW0_rdata;
  wire [95:0] _GEN_1 = {RW0_rdata_0_2,RW0_rdata_0_1,RW0_rdata_0_0};
  split_rockettile_icache_data_arrays_0_ext mem_0_0 (
    .RW0_addr(mem_0_0_RW0_addr),
    .RW0_clk(mem_0_0_RW0_clk),
    .RW0_wdata(mem_0_0_RW0_wdata),
    .RW0_rdata(mem_0_0_RW0_rdata),
    .RW0_en(mem_0_0_RW0_en),
    .RW0_wmode(mem_0_0_RW0_wmode),
    .RW0_wmask(mem_0_0_RW0_wmask)
  );
  split_rockettile_icache_data_arrays_0_ext mem_0_1 (
    .RW0_addr(mem_0_1_RW0_addr),
    .RW0_clk(mem_0_1_RW0_clk),
    .RW0_wdata(mem_0_1_RW0_wdata),
    .RW0_rdata(mem_0_1_RW0_rdata),
    .RW0_en(mem_0_1_RW0_en),
    .RW0_wmode(mem_0_1_RW0_wmode),
    .RW0_wmask(mem_0_1_RW0_wmask)
  );
  split_rockettile_icache_data_arrays_0_ext mem_0_2 (
    .RW0_addr(mem_0_2_RW0_addr),
    .RW0_clk(mem_0_2_RW0_clk),
    .RW0_wdata(mem_0_2_RW0_wdata),
    .RW0_rdata(mem_0_2_RW0_rdata),
    .RW0_en(mem_0_2_RW0_en),
    .RW0_wmode(mem_0_2_RW0_wmode),
    .RW0_wmask(mem_0_2_RW0_wmask)
  );
  split_rockettile_icache_data_arrays_0_ext mem_0_3 (
    .RW0_addr(mem_0_3_RW0_addr),
    .RW0_clk(mem_0_3_RW0_clk),
    .RW0_wdata(mem_0_3_RW0_wdata),
    .RW0_rdata(mem_0_3_RW0_rdata),
    .RW0_en(mem_0_3_RW0_en),
    .RW0_wmode(mem_0_3_RW0_wmode),
    .RW0_wmask(mem_0_3_RW0_wmask)
  );
  assign RW0_rdata = {RW0_rdata_0_3,_GEN_1};
  assign mem_0_0_RW0_addr = RW0_addr;
  assign mem_0_0_RW0_clk = RW0_clk;
  assign mem_0_0_RW0_wdata = RW0_wdata[31:0];
  assign mem_0_0_RW0_en = RW0_en;
  assign mem_0_0_RW0_wmode = RW0_wmode;
  assign mem_0_0_RW0_wmask = RW0_wmask[0];
  assign mem_0_1_RW0_addr = RW0_addr;
  assign mem_0_1_RW0_clk = RW0_clk;
  assign mem_0_1_RW0_wdata = RW0_wdata[63:32];
  assign mem_0_1_RW0_en = RW0_en;
  assign mem_0_1_RW0_wmode = RW0_wmode;
  assign mem_0_1_RW0_wmask = RW0_wmask[1];
  assign mem_0_2_RW0_addr = RW0_addr;
  assign mem_0_2_RW0_clk = RW0_clk;
  assign mem_0_2_RW0_wdata = RW0_wdata[95:64];
  assign mem_0_2_RW0_en = RW0_en;
  assign mem_0_2_RW0_wmode = RW0_wmode;
  assign mem_0_2_RW0_wmask = RW0_wmask[2];
  assign mem_0_3_RW0_addr = RW0_addr;
  assign mem_0_3_RW0_clk = RW0_clk;
  assign mem_0_3_RW0_wdata = RW0_wdata[127:96];
  assign mem_0_3_RW0_en = RW0_en;
  assign mem_0_3_RW0_wmode = RW0_wmode;
  assign mem_0_3_RW0_wmask = RW0_wmask[3];
endmodule

module mem_ext(
  input  [14:0] RW0_addr,
  input         RW0_clk,
  input  [63:0] RW0_wdata,
  output [63:0] RW0_rdata,
  input         RW0_en,
  input         RW0_wmode,
  input  [7:0]  RW0_wmask
);
  wire [14:0] mem_0_0_RW0_addr;
  wire  mem_0_0_RW0_clk;
  wire [7:0] mem_0_0_RW0_wdata;
  wire [7:0] mem_0_0_RW0_rdata;
  wire  mem_0_0_RW0_en;
  wire  mem_0_0_RW0_wmode;
  wire  mem_0_0_RW0_wmask;
  wire [14:0] mem_0_1_RW0_addr;
  wire  mem_0_1_RW0_clk;
  wire [7:0] mem_0_1_RW0_wdata;
  wire [7:0] mem_0_1_RW0_rdata;
  wire  mem_0_1_RW0_en;
  wire  mem_0_1_RW0_wmode;
  wire  mem_0_1_RW0_wmask;
  wire [14:0] mem_0_2_RW0_addr;
  wire  mem_0_2_RW0_clk;
  wire [7:0] mem_0_2_RW0_wdata;
  wire [7:0] mem_0_2_RW0_rdata;
  wire  mem_0_2_RW0_en;
  wire  mem_0_2_RW0_wmode;
  wire  mem_0_2_RW0_wmask;
  wire [14:0] mem_0_3_RW0_addr;
  wire  mem_0_3_RW0_clk;
  wire [7:0] mem_0_3_RW0_wdata;
  wire [7:0] mem_0_3_RW0_rdata;
  wire  mem_0_3_RW0_en;
  wire  mem_0_3_RW0_wmode;
  wire  mem_0_3_RW0_wmask;
  wire [14:0] mem_0_4_RW0_addr;
  wire  mem_0_4_RW0_clk;
  wire [7:0] mem_0_4_RW0_wdata;
  wire [7:0] mem_0_4_RW0_rdata;
  wire  mem_0_4_RW0_en;
  wire  mem_0_4_RW0_wmode;
  wire  mem_0_4_RW0_wmask;
  wire [14:0] mem_0_5_RW0_addr;
  wire  mem_0_5_RW0_clk;
  wire [7:0] mem_0_5_RW0_wdata;
  wire [7:0] mem_0_5_RW0_rdata;
  wire  mem_0_5_RW0_en;
  wire  mem_0_5_RW0_wmode;
  wire  mem_0_5_RW0_wmask;
  wire [14:0] mem_0_6_RW0_addr;
  wire  mem_0_6_RW0_clk;
  wire [7:0] mem_0_6_RW0_wdata;
  wire [7:0] mem_0_6_RW0_rdata;
  wire  mem_0_6_RW0_en;
  wire  mem_0_6_RW0_wmode;
  wire  mem_0_6_RW0_wmask;
  wire [14:0] mem_0_7_RW0_addr;
  wire  mem_0_7_RW0_clk;
  wire [7:0] mem_0_7_RW0_wdata;
  wire [7:0] mem_0_7_RW0_rdata;
  wire  mem_0_7_RW0_en;
  wire  mem_0_7_RW0_wmode;
  wire  mem_0_7_RW0_wmask;
  wire [7:0] RW0_rdata_0_0 = mem_0_0_RW0_rdata;
  wire [7:0] RW0_rdata_0_1 = mem_0_1_RW0_rdata;
  wire [7:0] RW0_rdata_0_2 = mem_0_2_RW0_rdata;
  wire [7:0] RW0_rdata_0_3 = mem_0_3_RW0_rdata;
  wire [7:0] RW0_rdata_0_4 = mem_0_4_RW0_rdata;
  wire [7:0] RW0_rdata_0_5 = mem_0_5_RW0_rdata;
  wire [7:0] RW0_rdata_0_6 = mem_0_6_RW0_rdata;
  wire [7:0] RW0_rdata_0_7 = mem_0_7_RW0_rdata;
  wire [55:0] _GEN_5 = {RW0_rdata_0_6,RW0_rdata_0_5,RW0_rdata_0_4,RW0_rdata_0_3,RW0_rdata_0_2,RW0_rdata_0_1,
    RW0_rdata_0_0};
  split_mem_ext mem_0_0 (
    .RW0_addr(mem_0_0_RW0_addr),
    .RW0_clk(mem_0_0_RW0_clk),
    .RW0_wdata(mem_0_0_RW0_wdata),
    .RW0_rdata(mem_0_0_RW0_rdata),
    .RW0_en(mem_0_0_RW0_en),
    .RW0_wmode(mem_0_0_RW0_wmode),
    .RW0_wmask(mem_0_0_RW0_wmask)
  );
  split_mem_ext mem_0_1 (
    .RW0_addr(mem_0_1_RW0_addr),
    .RW0_clk(mem_0_1_RW0_clk),
    .RW0_wdata(mem_0_1_RW0_wdata),
    .RW0_rdata(mem_0_1_RW0_rdata),
    .RW0_en(mem_0_1_RW0_en),
    .RW0_wmode(mem_0_1_RW0_wmode),
    .RW0_wmask(mem_0_1_RW0_wmask)
  );
  split_mem_ext mem_0_2 (
    .RW0_addr(mem_0_2_RW0_addr),
    .RW0_clk(mem_0_2_RW0_clk),
    .RW0_wdata(mem_0_2_RW0_wdata),
    .RW0_rdata(mem_0_2_RW0_rdata),
    .RW0_en(mem_0_2_RW0_en),
    .RW0_wmode(mem_0_2_RW0_wmode),
    .RW0_wmask(mem_0_2_RW0_wmask)
  );
  split_mem_ext mem_0_3 (
    .RW0_addr(mem_0_3_RW0_addr),
    .RW0_clk(mem_0_3_RW0_clk),
    .RW0_wdata(mem_0_3_RW0_wdata),
    .RW0_rdata(mem_0_3_RW0_rdata),
    .RW0_en(mem_0_3_RW0_en),
    .RW0_wmode(mem_0_3_RW0_wmode),
    .RW0_wmask(mem_0_3_RW0_wmask)
  );
  split_mem_ext mem_0_4 (
    .RW0_addr(mem_0_4_RW0_addr),
    .RW0_clk(mem_0_4_RW0_clk),
    .RW0_wdata(mem_0_4_RW0_wdata),
    .RW0_rdata(mem_0_4_RW0_rdata),
    .RW0_en(mem_0_4_RW0_en),
    .RW0_wmode(mem_0_4_RW0_wmode),
    .RW0_wmask(mem_0_4_RW0_wmask)
  );
  split_mem_ext mem_0_5 (
    .RW0_addr(mem_0_5_RW0_addr),
    .RW0_clk(mem_0_5_RW0_clk),
    .RW0_wdata(mem_0_5_RW0_wdata),
    .RW0_rdata(mem_0_5_RW0_rdata),
    .RW0_en(mem_0_5_RW0_en),
    .RW0_wmode(mem_0_5_RW0_wmode),
    .RW0_wmask(mem_0_5_RW0_wmask)
  );
  split_mem_ext mem_0_6 (
    .RW0_addr(mem_0_6_RW0_addr),
    .RW0_clk(mem_0_6_RW0_clk),
    .RW0_wdata(mem_0_6_RW0_wdata),
    .RW0_rdata(mem_0_6_RW0_rdata),
    .RW0_en(mem_0_6_RW0_en),
    .RW0_wmode(mem_0_6_RW0_wmode),
    .RW0_wmask(mem_0_6_RW0_wmask)
  );
  split_mem_ext mem_0_7 (
    .RW0_addr(mem_0_7_RW0_addr),
    .RW0_clk(mem_0_7_RW0_clk),
    .RW0_wdata(mem_0_7_RW0_wdata),
    .RW0_rdata(mem_0_7_RW0_rdata),
    .RW0_en(mem_0_7_RW0_en),
    .RW0_wmode(mem_0_7_RW0_wmode),
    .RW0_wmask(mem_0_7_RW0_wmask)
  );
  assign RW0_rdata = {RW0_rdata_0_7,_GEN_5};
  assign mem_0_0_RW0_addr = RW0_addr;
  assign mem_0_0_RW0_clk = RW0_clk;
  assign mem_0_0_RW0_wdata = RW0_wdata[7:0];
  assign mem_0_0_RW0_en = RW0_en;
  assign mem_0_0_RW0_wmode = RW0_wmode;
  assign mem_0_0_RW0_wmask = RW0_wmask[0];
  assign mem_0_1_RW0_addr = RW0_addr;
  assign mem_0_1_RW0_clk = RW0_clk;
  assign mem_0_1_RW0_wdata = RW0_wdata[15:8];
  assign mem_0_1_RW0_en = RW0_en;
  assign mem_0_1_RW0_wmode = RW0_wmode;
  assign mem_0_1_RW0_wmask = RW0_wmask[1];
  assign mem_0_2_RW0_addr = RW0_addr;
  assign mem_0_2_RW0_clk = RW0_clk;
  assign mem_0_2_RW0_wdata = RW0_wdata[23:16];
  assign mem_0_2_RW0_en = RW0_en;
  assign mem_0_2_RW0_wmode = RW0_wmode;
  assign mem_0_2_RW0_wmask = RW0_wmask[2];
  assign mem_0_3_RW0_addr = RW0_addr;
  assign mem_0_3_RW0_clk = RW0_clk;
  assign mem_0_3_RW0_wdata = RW0_wdata[31:24];
  assign mem_0_3_RW0_en = RW0_en;
  assign mem_0_3_RW0_wmode = RW0_wmode;
  assign mem_0_3_RW0_wmask = RW0_wmask[3];
  assign mem_0_4_RW0_addr = RW0_addr;
  assign mem_0_4_RW0_clk = RW0_clk;
  assign mem_0_4_RW0_wdata = RW0_wdata[39:32];
  assign mem_0_4_RW0_en = RW0_en;
  assign mem_0_4_RW0_wmode = RW0_wmode;
  assign mem_0_4_RW0_wmask = RW0_wmask[4];
  assign mem_0_5_RW0_addr = RW0_addr;
  assign mem_0_5_RW0_clk = RW0_clk;
  assign mem_0_5_RW0_wdata = RW0_wdata[47:40];
  assign mem_0_5_RW0_en = RW0_en;
  assign mem_0_5_RW0_wmode = RW0_wmode;
  assign mem_0_5_RW0_wmask = RW0_wmask[5];
  assign mem_0_6_RW0_addr = RW0_addr;
  assign mem_0_6_RW0_clk = RW0_clk;
  assign mem_0_6_RW0_wdata = RW0_wdata[55:48];
  assign mem_0_6_RW0_en = RW0_en;
  assign mem_0_6_RW0_wmode = RW0_wmode;
  assign mem_0_6_RW0_wmask = RW0_wmask[6];
  assign mem_0_7_RW0_addr = RW0_addr;
  assign mem_0_7_RW0_clk = RW0_clk;
  assign mem_0_7_RW0_wdata = RW0_wdata[63:56];
  assign mem_0_7_RW0_en = RW0_en;
  assign mem_0_7_RW0_wmode = RW0_wmode;
  assign mem_0_7_RW0_wmask = RW0_wmask[7];
endmodule

module split_cc_dir_ext(
  input  [9:0]  RW0_addr,
  input         RW0_clk,
  input  [19:0] RW0_wdata,
  output [19:0] RW0_rdata,
  input         RW0_en,
  input         RW0_wmode,
  input         RW0_wmask
);
`ifdef RANDOMIZE_MEM_INIT
  reg [31:0] _RAND_0;
`endif // RANDOMIZE_MEM_INIT
`ifdef RANDOMIZE_REG_INIT
  reg [31:0] _RAND_1;
  reg [31:0] _RAND_2;
`endif // RANDOMIZE_REG_INIT
  reg [19:0] ram [0:1023];
  wire  ram_RW_0_r_en;
  wire [9:0] ram_RW_0_r_addr;
  wire [19:0] ram_RW_0_r_data;
  wire [19:0] ram_RW_0_w_data;
  wire [9:0] ram_RW_0_w_addr;
  wire  ram_RW_0_w_mask;
  wire  ram_RW_0_w_en;
  reg  ram_RW_0_r_en_pipe_0;
  reg [9:0] ram_RW_0_r_addr_pipe_0;
  assign ram_RW_0_r_en = ram_RW_0_r_en_pipe_0;
  assign ram_RW_0_r_addr = ram_RW_0_r_addr_pipe_0;
  assign ram_RW_0_r_data = ram[ram_RW_0_r_addr];
  assign ram_RW_0_w_data = RW0_wdata;
  assign ram_RW_0_w_addr = RW0_addr;
  assign ram_RW_0_w_mask = RW0_wmask;
  assign ram_RW_0_w_en = RW0_en & RW0_wmode;
  assign RW0_rdata = ram_RW_0_r_data;
  always @(posedge RW0_clk) begin
    if (ram_RW_0_w_en & ram_RW_0_w_mask) begin
      ram[ram_RW_0_w_addr] <= ram_RW_0_w_data;
    end
    ram_RW_0_r_en_pipe_0 <= RW0_en & ~RW0_wmode;
    if (RW0_en & ~RW0_wmode) begin
      ram_RW_0_r_addr_pipe_0 <= RW0_addr;
    end
  end
// Register and memory initialization
`ifdef RANDOMIZE_GARBAGE_ASSIGN
`define RANDOMIZE
`endif
`ifdef RANDOMIZE_INVALID_ASSIGN
`define RANDOMIZE
`endif
`ifdef RANDOMIZE_REG_INIT
`define RANDOMIZE
`endif
`ifdef RANDOMIZE_MEM_INIT
`define RANDOMIZE
`endif
`ifndef RANDOM
`define RANDOM $random
`endif
`ifdef RANDOMIZE_MEM_INIT
  integer initvar;
`endif
`ifndef SYNTHESIS
`ifdef FIRRTL_BEFORE_INITIAL
`FIRRTL_BEFORE_INITIAL
`endif
initial begin
  `ifdef RANDOMIZE
    `ifdef INIT_RANDOM
      `INIT_RANDOM
    `endif
    `ifndef VERILATOR
      `ifdef RANDOMIZE_DELAY
        #`RANDOMIZE_DELAY begin end
      `else
        #0.002 begin end
      `endif
    `endif
`ifdef RANDOMIZE_MEM_INIT
  _RAND_0 = {1{`RANDOM}};
  for (initvar = 0; initvar < 1024; initvar = initvar+1)
    ram[initvar] = _RAND_0[19:0];
`endif // RANDOMIZE_MEM_INIT
`ifdef RANDOMIZE_REG_INIT
  _RAND_1 = {1{`RANDOM}};
  ram_RW_0_r_en_pipe_0 = _RAND_1[0:0];
  _RAND_2 = {1{`RANDOM}};
  ram_RW_0_r_addr_pipe_0 = _RAND_2[9:0];
`endif // RANDOMIZE_REG_INIT
  `endif // RANDOMIZE
end // initial
`ifdef FIRRTL_AFTER_INITIAL
`FIRRTL_AFTER_INITIAL
`endif
`endif // SYNTHESIS
endmodule

module split_cc_banks_0_ext(
  input  [13:0] RW0_addr,
  input         RW0_clk,
  input  [63:0] RW0_wdata,
  output [63:0] RW0_rdata,
  input         RW0_en,
  input         RW0_wmode
);
`ifdef RANDOMIZE_MEM_INIT
  reg [63:0] _RAND_0;
`endif // RANDOMIZE_MEM_INIT
`ifdef RANDOMIZE_REG_INIT
  reg [31:0] _RAND_1;
  reg [31:0] _RAND_2;
`endif // RANDOMIZE_REG_INIT
  reg [63:0] ram [0:16383];
  wire  ram_RW_0_r_en;
  wire [13:0] ram_RW_0_r_addr;
  wire [63:0] ram_RW_0_r_data;
  wire [63:0] ram_RW_0_w_data;
  wire [13:0] ram_RW_0_w_addr;
  wire  ram_RW_0_w_mask;
  wire  ram_RW_0_w_en;
  reg  ram_RW_0_r_en_pipe_0;
  reg [13:0] ram_RW_0_r_addr_pipe_0;
  assign ram_RW_0_r_en = ram_RW_0_r_en_pipe_0;
  assign ram_RW_0_r_addr = ram_RW_0_r_addr_pipe_0;
  assign ram_RW_0_r_data = ram[ram_RW_0_r_addr];
  assign ram_RW_0_w_data = RW0_wdata;
  assign ram_RW_0_w_addr = RW0_addr;
  assign ram_RW_0_w_mask = 1'h1;
  assign ram_RW_0_w_en = RW0_en & RW0_wmode;
  assign RW0_rdata = ram_RW_0_r_data;
  always @(posedge RW0_clk) begin
    if (ram_RW_0_w_en & ram_RW_0_w_mask) begin
      ram[ram_RW_0_w_addr] <= ram_RW_0_w_data;
    end
    ram_RW_0_r_en_pipe_0 <= RW0_en & ~RW0_wmode;
    if (RW0_en & ~RW0_wmode) begin
      ram_RW_0_r_addr_pipe_0 <= RW0_addr;
    end
  end
// Register and memory initialization
`ifdef RANDOMIZE_GARBAGE_ASSIGN
`define RANDOMIZE
`endif
`ifdef RANDOMIZE_INVALID_ASSIGN
`define RANDOMIZE
`endif
`ifdef RANDOMIZE_REG_INIT
`define RANDOMIZE
`endif
`ifdef RANDOMIZE_MEM_INIT
`define RANDOMIZE
`endif
`ifndef RANDOM
`define RANDOM $random
`endif
`ifdef RANDOMIZE_MEM_INIT
  integer initvar;
`endif
`ifndef SYNTHESIS
`ifdef FIRRTL_BEFORE_INITIAL
`FIRRTL_BEFORE_INITIAL
`endif
initial begin
  `ifdef RANDOMIZE
    `ifdef INIT_RANDOM
      `INIT_RANDOM
    `endif
    `ifndef VERILATOR
      `ifdef RANDOMIZE_DELAY
        #`RANDOMIZE_DELAY begin end
      `else
        #0.002 begin end
      `endif
    `endif
`ifdef RANDOMIZE_MEM_INIT
  _RAND_0 = {2{`RANDOM}};
  for (initvar = 0; initvar < 16384; initvar = initvar+1)
    ram[initvar] = _RAND_0[63:0];
`endif // RANDOMIZE_MEM_INIT
`ifdef RANDOMIZE_REG_INIT
  _RAND_1 = {1{`RANDOM}};
  ram_RW_0_r_en_pipe_0 = _RAND_1[0:0];
  _RAND_2 = {1{`RANDOM}};
  ram_RW_0_r_addr_pipe_0 = _RAND_2[13:0];
`endif // RANDOMIZE_REG_INIT
  `endif // RANDOMIZE
end // initial
`ifdef FIRRTL_AFTER_INITIAL
`FIRRTL_AFTER_INITIAL
`endif
`endif // SYNTHESIS
endmodule

module split_rockettile_dcache_data_arrays_0_ext(
  input  [8:0] RW0_addr,
  input        RW0_clk,
  input  [7:0] RW0_wdata,
  output [7:0] RW0_rdata,
  input        RW0_en,
  input        RW0_wmode,
  input        RW0_wmask
);
`ifdef RANDOMIZE_MEM_INIT
  reg [31:0] _RAND_0;
`endif // RANDOMIZE_MEM_INIT
`ifdef RANDOMIZE_REG_INIT
  reg [31:0] _RAND_1;
  reg [31:0] _RAND_2;
`endif // RANDOMIZE_REG_INIT
  reg [7:0] ram [0:511];
  wire  ram_RW_0_r_en;
  wire [8:0] ram_RW_0_r_addr;
  wire [7:0] ram_RW_0_r_data;
  wire [7:0] ram_RW_0_w_data;
  wire [8:0] ram_RW_0_w_addr;
  wire  ram_RW_0_w_mask;
  wire  ram_RW_0_w_en;
  reg  ram_RW_0_r_en_pipe_0;
  reg [8:0] ram_RW_0_r_addr_pipe_0;
  assign ram_RW_0_r_en = ram_RW_0_r_en_pipe_0;
  assign ram_RW_0_r_addr = ram_RW_0_r_addr_pipe_0;
  assign ram_RW_0_r_data = ram[ram_RW_0_r_addr];
  assign ram_RW_0_w_data = RW0_wdata;
  assign ram_RW_0_w_addr = RW0_addr;
  assign ram_RW_0_w_mask = RW0_wmask;
  assign ram_RW_0_w_en = RW0_en & RW0_wmode;
  assign RW0_rdata = ram_RW_0_r_data;
  always @(posedge RW0_clk) begin
    if (ram_RW_0_w_en & ram_RW_0_w_mask) begin
      ram[ram_RW_0_w_addr] <= ram_RW_0_w_data;
    end
    ram_RW_0_r_en_pipe_0 <= RW0_en & ~RW0_wmode;
    if (RW0_en & ~RW0_wmode) begin
      ram_RW_0_r_addr_pipe_0 <= RW0_addr;
    end
  end
// Register and memory initialization
`ifdef RANDOMIZE_GARBAGE_ASSIGN
`define RANDOMIZE
`endif
`ifdef RANDOMIZE_INVALID_ASSIGN
`define RANDOMIZE
`endif
`ifdef RANDOMIZE_REG_INIT
`define RANDOMIZE
`endif
`ifdef RANDOMIZE_MEM_INIT
`define RANDOMIZE
`endif
`ifndef RANDOM
`define RANDOM $random
`endif
`ifdef RANDOMIZE_MEM_INIT
  integer initvar;
`endif
`ifndef SYNTHESIS
`ifdef FIRRTL_BEFORE_INITIAL
`FIRRTL_BEFORE_INITIAL
`endif
initial begin
  `ifdef RANDOMIZE
    `ifdef INIT_RANDOM
      `INIT_RANDOM
    `endif
    `ifndef VERILATOR
      `ifdef RANDOMIZE_DELAY
        #`RANDOMIZE_DELAY begin end
      `else
        #0.002 begin end
      `endif
    `endif
`ifdef RANDOMIZE_MEM_INIT
  _RAND_0 = {1{`RANDOM}};
  for (initvar = 0; initvar < 512; initvar = initvar+1)
    ram[initvar] = _RAND_0[7:0];
`endif // RANDOMIZE_MEM_INIT
`ifdef RANDOMIZE_REG_INIT
  _RAND_1 = {1{`RANDOM}};
  ram_RW_0_r_en_pipe_0 = _RAND_1[0:0];
  _RAND_2 = {1{`RANDOM}};
  ram_RW_0_r_addr_pipe_0 = _RAND_2[8:0];
`endif // RANDOMIZE_REG_INIT
  `endif // RANDOMIZE
end // initial
`ifdef FIRRTL_AFTER_INITIAL
`FIRRTL_AFTER_INITIAL
`endif
`endif // SYNTHESIS
endmodule

module split_rockettile_dcache_tag_array_ext(
  input  [5:0]  RW0_addr,
  input         RW0_clk,
  input  [21:0] RW0_wdata,
  output [21:0] RW0_rdata,
  input         RW0_en,
  input         RW0_wmode,
  input         RW0_wmask
);
`ifdef RANDOMIZE_MEM_INIT
  reg [31:0] _RAND_0;
`endif // RANDOMIZE_MEM_INIT
`ifdef RANDOMIZE_REG_INIT
  reg [31:0] _RAND_1;
  reg [31:0] _RAND_2;
`endif // RANDOMIZE_REG_INIT
  reg [21:0] ram [0:63];
  wire  ram_RW_0_r_en;
  wire [5:0] ram_RW_0_r_addr;
  wire [21:0] ram_RW_0_r_data;
  wire [21:0] ram_RW_0_w_data;
  wire [5:0] ram_RW_0_w_addr;
  wire  ram_RW_0_w_mask;
  wire  ram_RW_0_w_en;
  reg  ram_RW_0_r_en_pipe_0;
  reg [5:0] ram_RW_0_r_addr_pipe_0;
  assign ram_RW_0_r_en = ram_RW_0_r_en_pipe_0;
  assign ram_RW_0_r_addr = ram_RW_0_r_addr_pipe_0;
  assign ram_RW_0_r_data = ram[ram_RW_0_r_addr];
  assign ram_RW_0_w_data = RW0_wdata;
  assign ram_RW_0_w_addr = RW0_addr;
  assign ram_RW_0_w_mask = RW0_wmask;
  assign ram_RW_0_w_en = RW0_en & RW0_wmode;
  assign RW0_rdata = ram_RW_0_r_data;
  always @(posedge RW0_clk) begin
    if (ram_RW_0_w_en & ram_RW_0_w_mask) begin
      ram[ram_RW_0_w_addr] <= ram_RW_0_w_data;
    end
    ram_RW_0_r_en_pipe_0 <= RW0_en & ~RW0_wmode;
    if (RW0_en & ~RW0_wmode) begin
      ram_RW_0_r_addr_pipe_0 <= RW0_addr;
    end
  end
// Register and memory initialization
`ifdef RANDOMIZE_GARBAGE_ASSIGN
`define RANDOMIZE
`endif
`ifdef RANDOMIZE_INVALID_ASSIGN
`define RANDOMIZE
`endif
`ifdef RANDOMIZE_REG_INIT
`define RANDOMIZE
`endif
`ifdef RANDOMIZE_MEM_INIT
`define RANDOMIZE
`endif
`ifndef RANDOM
`define RANDOM $random
`endif
`ifdef RANDOMIZE_MEM_INIT
  integer initvar;
`endif
`ifndef SYNTHESIS
`ifdef FIRRTL_BEFORE_INITIAL
`FIRRTL_BEFORE_INITIAL
`endif
initial begin
  `ifdef RANDOMIZE
    `ifdef INIT_RANDOM
      `INIT_RANDOM
    `endif
    `ifndef VERILATOR
      `ifdef RANDOMIZE_DELAY
        #`RANDOMIZE_DELAY begin end
      `else
        #0.002 begin end
      `endif
    `endif
`ifdef RANDOMIZE_MEM_INIT
  _RAND_0 = {1{`RANDOM}};
  for (initvar = 0; initvar < 64; initvar = initvar+1)
    ram[initvar] = _RAND_0[21:0];
`endif // RANDOMIZE_MEM_INIT
`ifdef RANDOMIZE_REG_INIT
  _RAND_1 = {1{`RANDOM}};
  ram_RW_0_r_en_pipe_0 = _RAND_1[0:0];
  _RAND_2 = {1{`RANDOM}};
  ram_RW_0_r_addr_pipe_0 = _RAND_2[5:0];
`endif // RANDOMIZE_REG_INIT
  `endif // RANDOMIZE
end // initial
`ifdef FIRRTL_AFTER_INITIAL
`FIRRTL_AFTER_INITIAL
`endif
`endif // SYNTHESIS
endmodule

module split_rockettile_icache_tag_array_ext(
  input  [5:0]  RW0_addr,
  input         RW0_clk,
  input  [20:0] RW0_wdata,
  output [20:0] RW0_rdata,
  input         RW0_en,
  input         RW0_wmode,
  input         RW0_wmask
);
`ifdef RANDOMIZE_MEM_INIT
  reg [31:0] _RAND_0;
`endif // RANDOMIZE_MEM_INIT
`ifdef RANDOMIZE_REG_INIT
  reg [31:0] _RAND_1;
  reg [31:0] _RAND_2;
`endif // RANDOMIZE_REG_INIT
  reg [20:0] ram [0:63];
  wire  ram_RW_0_r_en;
  wire [5:0] ram_RW_0_r_addr;
  wire [20:0] ram_RW_0_r_data;
  wire [20:0] ram_RW_0_w_data;
  wire [5:0] ram_RW_0_w_addr;
  wire  ram_RW_0_w_mask;
  wire  ram_RW_0_w_en;
  reg  ram_RW_0_r_en_pipe_0;
  reg [5:0] ram_RW_0_r_addr_pipe_0;
  assign ram_RW_0_r_en = ram_RW_0_r_en_pipe_0;
  assign ram_RW_0_r_addr = ram_RW_0_r_addr_pipe_0;
  assign ram_RW_0_r_data = ram[ram_RW_0_r_addr];
  assign ram_RW_0_w_data = RW0_wdata;
  assign ram_RW_0_w_addr = RW0_addr;
  assign ram_RW_0_w_mask = RW0_wmask;
  assign ram_RW_0_w_en = RW0_en & RW0_wmode;
  assign RW0_rdata = ram_RW_0_r_data;
  always @(posedge RW0_clk) begin
    if (ram_RW_0_w_en & ram_RW_0_w_mask) begin
      ram[ram_RW_0_w_addr] <= ram_RW_0_w_data;
    end
    ram_RW_0_r_en_pipe_0 <= RW0_en & ~RW0_wmode;
    if (RW0_en & ~RW0_wmode) begin
      ram_RW_0_r_addr_pipe_0 <= RW0_addr;
    end
  end
// Register and memory initialization
`ifdef RANDOMIZE_GARBAGE_ASSIGN
`define RANDOMIZE
`endif
`ifdef RANDOMIZE_INVALID_ASSIGN
`define RANDOMIZE
`endif
`ifdef RANDOMIZE_REG_INIT
`define RANDOMIZE
`endif
`ifdef RANDOMIZE_MEM_INIT
`define RANDOMIZE
`endif
`ifndef RANDOM
`define RANDOM $random
`endif
`ifdef RANDOMIZE_MEM_INIT
  integer initvar;
`endif
`ifndef SYNTHESIS
`ifdef FIRRTL_BEFORE_INITIAL
`FIRRTL_BEFORE_INITIAL
`endif
initial begin
  `ifdef RANDOMIZE
    `ifdef INIT_RANDOM
      `INIT_RANDOM
    `endif
    `ifndef VERILATOR
      `ifdef RANDOMIZE_DELAY
        #`RANDOMIZE_DELAY begin end
      `else
        #0.002 begin end
      `endif
    `endif
`ifdef RANDOMIZE_MEM_INIT
  _RAND_0 = {1{`RANDOM}};
  for (initvar = 0; initvar < 64; initvar = initvar+1)
    ram[initvar] = _RAND_0[20:0];
`endif // RANDOMIZE_MEM_INIT
`ifdef RANDOMIZE_REG_INIT
  _RAND_1 = {1{`RANDOM}};
  ram_RW_0_r_en_pipe_0 = _RAND_1[0:0];
  _RAND_2 = {1{`RANDOM}};
  ram_RW_0_r_addr_pipe_0 = _RAND_2[5:0];
`endif // RANDOMIZE_REG_INIT
  `endif // RANDOMIZE
end // initial
`ifdef FIRRTL_AFTER_INITIAL
`FIRRTL_AFTER_INITIAL
`endif
`endif // SYNTHESIS
endmodule

module split_rockettile_icache_data_arrays_0_ext(
  input  [8:0]  RW0_addr,
  input         RW0_clk,
  input  [31:0] RW0_wdata,
  output [31:0] RW0_rdata,
  input         RW0_en,
  input         RW0_wmode,
  input         RW0_wmask
);
`ifdef RANDOMIZE_MEM_INIT
  reg [31:0] _RAND_0;
`endif // RANDOMIZE_MEM_INIT
`ifdef RANDOMIZE_REG_INIT
  reg [31:0] _RAND_1;
  reg [31:0] _RAND_2;
`endif // RANDOMIZE_REG_INIT
  reg [31:0] ram [0:511];
  wire  ram_RW_0_r_en;
  wire [8:0] ram_RW_0_r_addr;
  wire [31:0] ram_RW_0_r_data;
  wire [31:0] ram_RW_0_w_data;
  wire [8:0] ram_RW_0_w_addr;
  wire  ram_RW_0_w_mask;
  wire  ram_RW_0_w_en;
  reg  ram_RW_0_r_en_pipe_0;
  reg [8:0] ram_RW_0_r_addr_pipe_0;
  assign ram_RW_0_r_en = ram_RW_0_r_en_pipe_0;
  assign ram_RW_0_r_addr = ram_RW_0_r_addr_pipe_0;
  assign ram_RW_0_r_data = ram[ram_RW_0_r_addr];
  assign ram_RW_0_w_data = RW0_wdata;
  assign ram_RW_0_w_addr = RW0_addr;
  assign ram_RW_0_w_mask = RW0_wmask;
  assign ram_RW_0_w_en = RW0_en & RW0_wmode;
  assign RW0_rdata = ram_RW_0_r_data;
  always @(posedge RW0_clk) begin
    if (ram_RW_0_w_en & ram_RW_0_w_mask) begin
      ram[ram_RW_0_w_addr] <= ram_RW_0_w_data;
    end
    ram_RW_0_r_en_pipe_0 <= RW0_en & ~RW0_wmode;
    if (RW0_en & ~RW0_wmode) begin
      ram_RW_0_r_addr_pipe_0 <= RW0_addr;
    end
  end
// Register and memory initialization
`ifdef RANDOMIZE_GARBAGE_ASSIGN
`define RANDOMIZE
`endif
`ifdef RANDOMIZE_INVALID_ASSIGN
`define RANDOMIZE
`endif
`ifdef RANDOMIZE_REG_INIT
`define RANDOMIZE
`endif
`ifdef RANDOMIZE_MEM_INIT
`define RANDOMIZE
`endif
`ifndef RANDOM
`define RANDOM $random
`endif
`ifdef RANDOMIZE_MEM_INIT
  integer initvar;
`endif
`ifndef SYNTHESIS
`ifdef FIRRTL_BEFORE_INITIAL
`FIRRTL_BEFORE_INITIAL
`endif
initial begin
  `ifdef RANDOMIZE
    `ifdef INIT_RANDOM
      `INIT_RANDOM
    `endif
    `ifndef VERILATOR
      `ifdef RANDOMIZE_DELAY
        #`RANDOMIZE_DELAY begin end
      `else
        #0.002 begin end
      `endif
    `endif
`ifdef RANDOMIZE_MEM_INIT
  _RAND_0 = {1{`RANDOM}};
  for (initvar = 0; initvar < 512; initvar = initvar+1)
    ram[initvar] = _RAND_0[31:0];
`endif // RANDOMIZE_MEM_INIT
`ifdef RANDOMIZE_REG_INIT
  _RAND_1 = {1{`RANDOM}};
  ram_RW_0_r_en_pipe_0 = _RAND_1[0:0];
  _RAND_2 = {1{`RANDOM}};
  ram_RW_0_r_addr_pipe_0 = _RAND_2[8:0];
`endif // RANDOMIZE_REG_INIT
  `endif // RANDOMIZE
end // initial
`ifdef FIRRTL_AFTER_INITIAL
`FIRRTL_AFTER_INITIAL
`endif
`endif // SYNTHESIS
endmodule

module split_mem_ext(
  input  [14:0] RW0_addr,
  input         RW0_clk,
  input  [7:0]  RW0_wdata,
  output [7:0]  RW0_rdata,
  input         RW0_en,
  input         RW0_wmode,
  input         RW0_wmask
);
`ifdef RANDOMIZE_MEM_INIT
  reg [31:0] _RAND_0;
`endif // RANDOMIZE_MEM_INIT
`ifdef RANDOMIZE_REG_INIT
  reg [31:0] _RAND_1;
  reg [31:0] _RAND_2;
`endif // RANDOMIZE_REG_INIT
  reg [7:0] ram [0:32767];
  wire  ram_RW_0_r_en;
  wire [14:0] ram_RW_0_r_addr;
  wire [7:0] ram_RW_0_r_data;
  wire [7:0] ram_RW_0_w_data;
  wire [14:0] ram_RW_0_w_addr;
  wire  ram_RW_0_w_mask;
  wire  ram_RW_0_w_en;
  reg  ram_RW_0_r_en_pipe_0;
  reg [14:0] ram_RW_0_r_addr_pipe_0;
  assign ram_RW_0_r_en = ram_RW_0_r_en_pipe_0;
  assign ram_RW_0_r_addr = ram_RW_0_r_addr_pipe_0;
  assign ram_RW_0_r_data = ram[ram_RW_0_r_addr];
  assign ram_RW_0_w_data = RW0_wdata;
  assign ram_RW_0_w_addr = RW0_addr;
  assign ram_RW_0_w_mask = RW0_wmask;
  assign ram_RW_0_w_en = RW0_en & RW0_wmode;
  assign RW0_rdata = ram_RW_0_r_data;
  always @(posedge RW0_clk) begin
    if (ram_RW_0_w_en & ram_RW_0_w_mask) begin
      ram[ram_RW_0_w_addr] <= ram_RW_0_w_data;
    end
    ram_RW_0_r_en_pipe_0 <= RW0_en & ~RW0_wmode;
    if (RW0_en & ~RW0_wmode) begin
      ram_RW_0_r_addr_pipe_0 <= RW0_addr;
    end
  end
// Register and memory initialization
`ifdef RANDOMIZE_GARBAGE_ASSIGN
`define RANDOMIZE
`endif
`ifdef RANDOMIZE_INVALID_ASSIGN
`define RANDOMIZE
`endif
`ifdef RANDOMIZE_REG_INIT
`define RANDOMIZE
`endif
`ifdef RANDOMIZE_MEM_INIT
`define RANDOMIZE
`endif
`ifndef RANDOM
`define RANDOM $random
`endif
`ifdef RANDOMIZE_MEM_INIT
  integer initvar;
`endif
`ifndef SYNTHESIS
`ifdef FIRRTL_BEFORE_INITIAL
`FIRRTL_BEFORE_INITIAL
`endif
initial begin
  `ifdef RANDOMIZE
    `ifdef INIT_RANDOM
      `INIT_RANDOM
    `endif
    `ifndef VERILATOR
      `ifdef RANDOMIZE_DELAY
        #`RANDOMIZE_DELAY begin end
      `else
        #0.002 begin end
      `endif
    `endif
`ifdef RANDOMIZE_MEM_INIT
  _RAND_0 = {1{`RANDOM}};
  for (initvar = 0; initvar < 32768; initvar = initvar+1)
    ram[initvar] = _RAND_0[7:0];
`endif // RANDOMIZE_MEM_INIT
`ifdef RANDOMIZE_REG_INIT
  _RAND_1 = {1{`RANDOM}};
  ram_RW_0_r_en_pipe_0 = _RAND_1[0:0];
  _RAND_2 = {1{`RANDOM}};
  ram_RW_0_r_addr_pipe_0 = _RAND_2[14:0];
`endif // RANDOMIZE_REG_INIT
  `endif // RANDOMIZE
end // initial
`ifdef FIRRTL_AFTER_INITIAL
`FIRRTL_AFTER_INITIAL
`endif
`endif // SYNTHESIS
endmodule
