houdonghui1/Trust_Shield/Third_rot_sw/privacy_CA/serial_capture_ak_ek.py

#!/usr/bin/env python3
import serial
import serial.tools.list_ports
import subprocess
import time
import re
import sys
import json
import hashlib

SERIAL_PORT = "/dev/ttyACM1"
BAUDRATE = 115200
TIMEOUT = 60
PARITY = serial.PARITY_NONE
STOPBITS = serial.STOPBITS_ONE
BYTESIZE = serial.EIGHTBITS

# Constants
AK_VALID_LEN = 49 * 2
EK_MAX_HEX_LEN = 8192 * 2
MLDSA87_PK_VALID_LEN = (2592*2)
BLS_PUBLIC_KEY_HEX_LEN = 48 * 2
BLS_POP_HEX_LEN = 96 * 2
BLS_REGISTRATION_PREFIX = "BLS_REGISTRATION:"

CAPTURED_EK = False
CAPTURED_AK = False
CAPTURED_MLDSA_PK = False
CAPTURED_BLS_REGISTRATION = False
ek_cert_hex = ""
ak_pub_128hex = ""
mldsa_pk_hex = ""
bls_registration = None
start_time = time.time()

HEX_PATTERN = re.compile(r'^[0-9a-fA-F]+$')
EK_HEADER_PATTERN = re.compile(
    r"EK\s+Certificate\s+DER\s*,?\s*length\s*=\s*0x([0-9a-fA-F]+)",
    re.IGNORECASE,
)

def extract_hex_payload(line):
    payload = re.sub(r'^\[[^\]]*\]\s*', '', line.strip())
    payload = re.sub(r'^[A-Z]\d+\s+[^\]]+\]\s*', '', payload)
    payload = re.sub(r'\s+', '', payload)
    return payload if HEX_PATTERN.fullmatch(payload or '') else ''

def collect_hex_payload(ser, expected_len, name):
    chunks = []
    collected = 0
    deadline = time.time() + TIMEOUT
    while collected < expected_len:
        if time.time() >= deadline:
            error(f"Timeout collecting {name}: expected {expected_len}, got {collected}")
        line = ser.readline().decode('utf-8', errors='ignore').strip()
        if not line:
            continue
        payload = extract_hex_payload(line)
        if not payload:
            continue
        remaining = expected_len - collected
        if len(payload) > remaining:
            error(
                f"Invalid {name} line: remaining {remaining} hex characters, "
                f"received {len(payload)}"
            )
        chunks.append(payload)
        collected += len(payload)
    value = ''.join(chunks)
    validate_hex(value, name, expected_len)
    return value

def info(msg):
    print(f"[INFO] {msg}")
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
