houdonghui1/Trust_Shield/(commit log)

2026-05-26 添加README
2026-05-27 添加项目研究背景
2026-05-28 建立仓库结构，添加一级可信根
    [Caliptra_TestPlan.xlsx, ECC_in_infact_coverage_strategy.csv, ECC_out_infact_coverage_strategy.csv, HMAC_in_infact_coverage_strategy.csv, HMAC_out_infact_coverage_strategy.csv, SHA512_in_infact_coverage_strategy.csv, SHA512_out_infact_coverage_strategy.csv, advtim_reglist.xls]
2026-05-28 添加二级可信根设计报告
2026-05-28 增加三级、系统、IP等空文件夹
2026-06-01 添加三级设计报告
2026-06-01 添加系统连接关系图
2026-06-02 添加二、三级可信根硬件代码
    [Caliptra_TestPlan.xlsx, ECC_in_infact_coverage_strategy.csv, ECC_out_infact_coverage_strategy.csv, HMAC_in_infact_coverage_strategy.csv, HMAC_out_infact_coverage_strategy.csv, SHA512_in_infact_coverage_strategy.csv, SHA512_out_infact_coverage_strategy.csv, caliptra-verilator-rst.cfg]
2026-06-02 添加视频说明、SAM3X、知识IP
2026-06-02 删除软著证书
2026-06-04 添加一级可信根(RISC_V)源码
    [ECC_in_infact_coverage_strategy.csv, ECC_out_infact_coverage_strategy.csv, HMAC_in_infact_coverage_strategy.csv, HMAC_out_infact_coverage_strategy.csv, SHA512_in_infact_coverage_strategy.csv, SHA512_out_infact_coverage_strategy.csv, caliptra-verilator-rst.cfg, caliptra-verilator.cfg]
2026-06-08 添加了pin to pin连接关系表
2026-06-09 添加三级可信根opentitan环境
    [alert_handler_cover_reg_top.cfg, analog_sigs.csv, aon_timer_rst.csv, ast_clkmgr.csv, ast_entropy_src_cfg.csv, ast_flash.csv, ast_infra.csv, ast_mem_cfg.csv]
2026-06-09 添加opentitan文件夹描述，开发流程总结。
2026-06-09 添加系统实物图
2026-06-16 添加二级、三级可信根软件和代码说明文档
2026-06-24 编写了系统设计报告
2026-07-08 修改系统启动时序图，添加集群适配参考文档
2026-07-22 软件代码初版冻结，增加多级可信根的安全启动，证书链证书逐级下发、验证逻辑，远程证明校验增加校验证书链的逻辑。
    [advtim_reglist.xls, bastim_reglist.xls, bastim_testcase.xls, eth_des_reglist.xls, eth_mac_testcase.xls, eth_reglist.xls, eth_sma_testcase.xls, gpio_af.xls]
2026-08-12 更新了启动逻辑文档
2026-08-18 更正了几个系统设计报告中的参数，增加系统动画演示
2026-08-19 修改了动画演示
2026-08-20 修改了系统信任链逻辑
2026-08-20 修改了系统时序图
2026-08-25 增加了系统测试文档
2026-08-26 增加冷热迁移文档
2026-08-26 修改文档结构
2026-09-02 修正测试文档中的数据
2026-09-16 更新system、冷热迁移文档
2026-09-16 调整图片
2026-09-16 更新三级可信根、可信第三方、验证方代码，增加 BLS 聚合签名逻辑
2026-09-16 更新一、二、三级可信根软件代码，增加集群 BLS 聚合签名逻辑及测试代码
2026-09-16 更新各级可信根固件
2026-09-17 增加了软件设计报告、更新系统测试报告
2026-09-22 修改了文档
